Sh080205/AirGuard/firmware/README.md

# firmware — คน B

ESP-IDF **v5.5.x** · target `esp32s3` · ESP32-S3-DevKitC-1 (N16R8)

> 📖 GPIO ทุกตัวอยู่ใน [`../CLAUDE.md`](../CLAUDE.md) §4 — **ห้ามเดา ห้ามลอกจากตัวอย่างในเน็ต**

---

## ลำดับงาน — ทำตามลำดับ อย่าข้าม

| # | งาน | ต้องมีบอร์ดไหม |
|---|---|---|
| 1 | โครง ESP-IDF project + CI ที่ build ผ่าน | ❌ |
| 2 | `components/pms7003/` — parser frame 32 ไบต์ | ❌ |
| 3 | `test_host/` — unit test ของ parser ด้วย frame ปลอม | ❌ |
| 4 | `main/` — FSM + FreeRTOS tasks | ❌ |
| 5 | ไดรเวอร์ I²C + SPI + เขียน CSV | ❌ *(mock ได้)* |
| 6 | ลงบอร์ดจริง ไล่บั๊กร่วมกับคน A | ✅ |

> 🔑 **ข้อ 1–5 ทำได้หมดโดยไม่ต้องมีบอร์ด** — อย่ารอของ

---

## 🔑 กฎออกแบบข้อ 2 ที่สำคัญที่สุด

**แยกส่วน parse ออกจากส่วน UART**

```c
// ✅ ทดสอบได้โดยไม่ต้องมีบอร์ด
esp_err_t pms7003_parse(const uint8_t *buf, size_t len,
                        pms7003_data_t *out, size_t *consumed);

// ส่วนที่คุยกับฮาร์ดแวร์ แยกไฟล์ต่างหาก
esp_err_t pms7003_init(void);
esp_err_t pms7003_read(pms7003_data_t *out, TickType_t timeout);
```

`consumed` บอกจำนวนไบต์ที่ทิ้งได้ โดยเก็บเฟรมที่ยังไม่ครบไว้เรียกครั้งถัดไป
ดูสัญญา API ใน `components/pms7003/include/pms7003.h` และคำสั่ง gcc
สำหรับทดสอบบน PC ใน [`test_host/README.md`](test_host/README.md)

ถ้าเขียนรวมกัน จะทดสอบไม่ได้จนกว่าบอร์ดจะมา — **เสียเวลาไป 3 สัปดาห์ฟรีๆ**

### เคสที่ unit test ต้องครอบคลุม

- frame ถูกต้อง → ค่าออกมาตรง
- checksum ผิด → ต้องคืน error **ไม่ใช่คืนค่าขยะ**
- frame ขาดกลางคัน
- มีขยะนำหน้าก่อน header `0x42 0x4D`
- frame ติดกันสองอันในบัฟเฟอร์เดียว

---

## โครงสร้าง

> 📖 **คำอธิบายเต็ม** (task · ลำดับบูต · queue/mailbox · หนึ่งรอบของ sampler · เส้นทาง CO · ML บนบอร์ด) อยู่ใน [`../docs/11-CODE-MAP.md`](../docs/11-CODE-MAP.md)
> ตรงกับ `main` @ `7e926b4` · ไฟล์ที่ติด **[fw67]** มีเฉพาะใน branch `fw/fw67-integrate` (ยังไม่ merge)

```
firmware/
├── CMakeLists.txt
├── sdkconfig.defaults          ← Flash 16MB · PSRAM Octal
├── partitions.csv              ← factory 4 MB (FW-5a)
├── main/                       task ของโปรเจกต์ + การเดินสาย
│   ├── main.c                  ลำดับบูต: CO ก่อน → NVS → Wi-Fi/SNTP → console → storage → sampler
│   ├── board_pins.h            เลข GPIO ทุกขา (ตรงกับ CLAUDE.md §4)
│   ├── task_config.h           priority / core / stack พร้อมเหตุผล
│   ├── tasks_sampler.c/.h      prio 10 core 1 · รอบ 1 Hz อ่าน PMS7003/AHT21/ENS160 + ค่า CO → แถว CSV · สถานะ MARK
│   ├── tasks_storage.c/.h      prio 3 · เขียน SD + พิมพ์ AGCSV/AGEV ออก serial (งานช้า แยกจาก sampler ด้วย queue)
│   ├── tasks_io.c/.h           prio 5 · ปุ่ม (ISR → queue → debounce) · LED/buzzer (เจ้าของ GPIO ขาออกแต่ผู้เดียว)
│   ├── tasks_co.c/.h           prio 11 core 1 · ZE07-CO UART2 · เส้นทาง CO แยกจาก ML
│   ├── time_sync.c/.h          Wi-Fi STA + SNTP · TZ +07:00
│   ├── console.c/.h            คำสั่ง settime
│   ├── secrets.h.example       ชื่อ/รหัส Wi-Fi → ก๊อปเป็น secrets.h (ไม่ขึ้น git)
│   ├── ml_mailbox.c/.h         [fw67] ผล Mahalanobis: sampler → io
│   └── io_compose.h            [fw67] รวม output ของ CO + FSM (CO ชนะเสมอ)
├── components/                 ส่วน *_parse.c เป็น pure C → host test ได้
│   ├── pms7003/                parse เฟรม 32 ไบต์ + UART1
│   ├── aht21/                  parse + CRC8 + I²C 0x38
│   ├── ens160/                 parse status/validity + I²C 0x53 + MISR
│   ├── ze07/                   ze07_parse · co_safety (เกณฑ์ ppm) · co_alert (ไฟ/เสียง CO)
│   ├── storage/                csv_row.c — รูปแบบแถวตามสัญญา CLAUDE.md §7
│   ├── logutil/                settime parser · ปัดวินาที · ความสดของเฟรม · สถิติ jitter
│   ├── mahal/                  [fw67] Mahalanobis D² + model/ag_mahal_pm_th.h (สร้างจาก ml.baseline ห้ามแก้มือ)
│   └── fsm/                    [fw67] NORMAL / WATCH / ALARM / SYS FAULT
├── test_host/                  unit test ด้วย gcc บน PC — run_tests.ps1
└── tools/                      serial_logger.py · heater_compare.py · ze07_sim.py (+ test_*.py)
```

> แผนเดิมตอนเริ่มโปรเจกต์ (`fsm.c` · `tasks_sensor.c` · `tasks_logic.c` · `model/*.tflite` · `ze07co/` · `test/` Unity) **ไม่ได้ใช้** — โมเดลบนบอร์ดเป็น header ของ Mahalanobis ไม่ใช่ `.tflite`

---

## 🔴 กฎเขียนโค้ด

**เช็ค `esp_err_t` ทุกจุด** — โค้ดที่ไม่เช็ค return คือโค้ดผิด

**ใน ISR** ห้าม `printf`/`ESP_LOG` · ห้าม delay · ห้าม malloc · ห้าม float
ISR ต้องสั้น ส่งงานต่อให้ task ผ่าน queue · พิจารณา `IRAM_ATTR`

**ตัวแปรที่ ISR กับ task ใช้ร่วมกัน** `volatile` อย่างเดียวไม่พอ
ต้องใช้ critical section / atomic / queue **และคอมเมนต์ว่าทำไมเลือกอันนั้น**

**ปุ่มต้องเปิด internal pull-up** ไม่มี pull-up ภายนอกบนบอร์ด — ดู CLAUDE.md §4

**stack size ห้ามตั้งมั่ว** คำนวณคร่าวๆ แล้ววัดด้วย `uxTaskGetStackHighWaterMark()`

---

## 🔴 เส้นทาง CO ต้องแยกจาก ML (FW-5b)

> **อุปกรณ์นี้เป็นเครื่องเฝ้าระวังสภาพแวดล้อมเพื่อการวิจัย ไม่ใช่เครื่องมือแพทย์
> และไม่ใช่เครื่องเตือนภัยคาร์บอนมอนอกไซด์
> ห้ามใช้แทน CO alarm ที่ได้มาตรฐาน UL 2034 หรือ EN 50291**
> (CLAUDE.md §8 · Winsen ZE07-CO manual V1.7 p.6 Caution 6: ห้ามใช้ในระบบที่เกี่ยวกับความปลอดภัยของมนุษย์)

เส้นทาง CO **บันทึกและติดตามระดับ CO เพื่อการวิจัย** ด้วยเกณฑ์ ppm ตายตัว ไม่ผ่านโมเดล
ไม่รอ persistence และไม่ใช้เวลาจริง/SD/Wi-Fi/โมเดล — ทำงานได้แม้ส่วนเหล่านั้นพัง (CLAUDE.md §2)

- **ZE07-CO:** UART2 **RX อย่างเดียว** (GPIO5 · 9600 8N1 · โหมด initiative upload ที่เป็นค่าเริ่มต้น ·
  manual V1.7 p.4) · ไม่ตั้ง TX และไม่แตะ GPIO6 เพราะขา RXD ของโมดูลรับ 0–3.0 V →
  **ไม่ต่อสาย J2.4** (เจ้าของตัดสิน 18 ต.ค.) · GPIO5 เปิด **internal pull-down** ให้ขานิ่งที่ LOW
  ตอนถอดโมดูล (เจ้าของตัดสิน 21 ต.ค. · pull-up 3.3 V จะดันขา TXD 3.0 V ของโมดูล) · parser `components/ze07/ze07_parse.c`
- **task `co`** (`main/tasks_co.c` · prio 11 สูงสุดในของเรา · core 1) อ่าน UART → parse →
  ตัดสินด้วย `components/ze07/co_safety.c` → ส่ง snapshot `co_status_t` ผ่าน mailbox
  (queue ยาว 1 · `xQueueOverwrite`/`xQueuePeek`)
- **ผู้อ่าน:** io task แสดงผลด้วย `co_alert.c` (ทับ MODE/ACK/สถานะ logger) · sampler ใส่ `co_ppm`
  (ค่าที่อายุ ≤ 2.5 s · ว่างช่วงอุ่นเครื่องและ FAULT) · FW-6 อ่านกล่องเดียวกันได้ภายหลัง
- **เกณฑ์ (เจ้าของอนุมัติ 18 ต.ค. · WHO จาก `docs/03` §2):** ค่าทันที ≥ 90 ppm หรือค่าเฉลี่ย 1 ชม. ≥ 30 ppm
  → ALARM ทันที · ค่าเฉลี่ย 8 ชม. ≥ 9 ppm → ธงใน log เท่านั้น · ออกจาก ALARM เมื่อทุกเงื่อนไขต่ำกว่าเกณฑ์ −10 %
  ต่อเนื่อง 60 s (นโยบายเฟิร์มแวร์) · ค่าเทียบกับ "ค่าที่เซนเซอร์รายงาน" ซึ่งไม่ได้สอบเทียบ
- **แสดงผล:** ALARM = LED_R 5 Hz + buzzer · FAULT (ไม่มีเฟรมดี > 6 s · UART2 พัง · snapshot ค้าง > 6 s)
  = LED_R กะพริบคู่ทุก 2 s + เสียงสั้นทุก 60 s · **ALARM ทับ FAULT** · ACK = ปิดเสียง ALARM 5 นาที
  (ไม่ล้าง ALARM) / ปิดเสียง FAULT จนกว่าจะหาย · อุ่นเครื่อง 5 นาทีหลังบูต (manual p.6 Caution 5)
- **log:** `co: frame: FF 04 03 ...` 5 เฟรมแรก (ยืนยันรูปแบบกับโมดูลจริง) · `CO ALARM` / `CO FAULT`
  ทุกครั้งที่เปลี่ยน · `io: CO ALARM shown N us after its frame` (latency) · สรุปทุก 60 s +
  stack HWM · GPIO7 = ขาดีบัก latency
- **ไม่มี ZE07 ต่ออยู่:** เครื่องจะ FAULT (ตั้งใจ) · ถ้าต้องการปิดเส้นทาง CO ทั้งหมด ใช้โฟลเดอร์ build แยก
  `idf.py -B build/co_off -DZE07_ENABLE=0 build` (สั่งใน `build/` ปกติ CMake จะหยุดให้ แบบเดียวกับ `ENS160_ENABLE`)
- **ห้ามทดสอบด้วยการสร้าง CO จริง** (`docs/03` §4) · ตรรกะทดสอบด้วยลำดับค่าจำลองใน
  `test_host/test_co_safety.c` · บนบอร์ดใช้ `tools/ze07_sim.py` ส่งเฟรมจำลองจาก USB-UART **3.3 V**
  เข้า TP8 (ถอด J2 ออกก่อน · ปิดไฟก่อนต่อสาย) เช่น
  `python tools\ze07_sim.py --port COM9 --script "0:20,95:20,80:70,off:10"` ·
  ทดสอบ: `python -m unittest discover -s tools -p "test_*.py"`

---

## LED แยกสถานะด้วยจังหวะ ไม่ใช่สี

LED1 ที่ประกอบมาเป็นเขียวอมเหลือง สีใกล้ LED2 เกินไป

```
NORMAL  →  ติดค้าง
WATCH   →  กะพริบ 1 ครั้ง/วินาที
ALARM   →  กะพริบ 5 ครั้ง/วินาที + buzzer
```

---

## FW-4 logger — ก่อน build ครั้งแรก

1. **Wi-Fi (hotspot มือถือ)**: `copy main\secrets.h.example main\secrets.h` แล้วแก้ SSID/รหัส
   — `secrets.h` ถูก ignore (`secrets.*`) **ห้าม commit** · ไม่มีไฟล์นี้ก็ build ได้
   แต่ไม่มี Wi-Fi/SNTP ต้องตั้งเวลาเอง (log ตอน build: `main/secrets.h not found`)
2. **ลบ `firmware/sdkconfig` เดิม** (ถ้ามี) เพื่อให้ `CONFIG_FATFS_LFN_HEAP` และ partition
   table จาก `sdkconfig.defaults` มีผล — ไม่ลบ build จะหยุดที่ CMake (partition) หรือ
   `#error` ใน `tasks_storage.c` (LFN) · ดูหัวข้อ "partition table" ด้านล่าง
3. ไม่มีเวลาจริง = ไม่เขียน CSV · ตั้งเวลาเองผ่านพอร์ต `UART` ของ DevKit:
   `settime 2026-10-06T09:00:00+07:00` (Enter)

LED เขียวระหว่าง NORMAL: ติดค้าง = กำลังบันทึก · กะพริบสั้น 1 ครั้ง/2 วิ = รอเวลา ·
ดับสั้น 1 ครั้ง/2 วิ = กำลังบันทึกเหตุการณ์ (`marked`) — เหตุผลใน `main/tasks_io.h`
ลำดับ priority / stack / ขนาด queue / N ของ fsync อยู่ที่ `main/task_config.h`,
`main/tasks_storage.h`, `main/tasks_storage.c`

## บันทึก CSV ผ่านสาย USB ลงคอม (serial CSV mirror · เพิ่ม 14 ต.ค.)

เพิ่มเพราะช่องการ์ด microSD ใช้ไม่ได้ (`docs/bringup/2026-10-14.md` P5) — ใช้แทนหรือใช้คู่กับ SD ก็ได้

- storage task พิมพ์**ทุกแถวที่ออกจากคิว**เป็น `AGCSV,<แถว CSV>` และทุกเหตุการณ์ MARK เป็น `AGEV,<แถว EV>`
  รูปแบบแถวมาจาก `csv_format_row` ตัวเดียวกับที่เขียนลง SD ⇒ ตรงสัญญา CLAUDE.md §7 ทุกตัวอักษร
- **ไม่เคย mount SD ตั้งแต่บูต** → ดึงแถวออกจากคิวไปพิมพ์ทันที (คอมได้ข้อมูลช้ากว่าเวลาจริงไม่เกิน ~0.5 s)
- **เคย mount แล้วการ์ดหลุด** → คิวยังเป็นบัฟเฟอร์ให้ SD ตาม FW-4 §7 · ดึงไปพิมพ์เฉพาะตอนคิวเกือบเต็ม (≥ 60/64)
  ⇒ sampler ไม่ต้องทิ้งแถว · แถวที่ไปทาง serial อย่างเดียวนับใน `serial only`
- พิมพ์ใน storage task (งานช้า) ไม่ใช่ใน sampler — ถ้า console ค้าง คิวรับไว้ ไม่กระทบคาบ 1 Hz
- log ทุก 60 s: `60s: serial mirror rows=… (serial only …) AGML=… errors=… | print avg/max us`
- ปิดได้ด้วย `-DSTORAGE_SERIAL_MIRROR=0` (หรือแก้ define ใน `main/tasks_storage.c`)
- **FW-7:** ถัดจาก `AGCSV,` ทุกบรรทัดมี `AGML,<timestamp_iso>,<d2>,<status>,<streak>` (คะแนน Mahalanobis
  ของแถวเดียวกัน · `d2` ทศนิยม 4 ตำแหน่ง ว่างเมื่อ missing/model_fault · status = `missing` `below`
  `above` `persistent` `model_fault`) — **ไม่ใช่ส่วนของสัญญา CSV §7** · `serial_logger.py` ไม่เขียนลง CSV
  เก็บไว้ใน `serial_*.log` เท่านั้น (และพิมพ์ขึ้นจอถ้าไม่ใส่ `--quiet`) · ปิดเฉพาะบรรทัดนี้ด้วย `#define STORAGE_SERIAL_ML 0` ใน `main/tasks_storage.c`
  · sampler log สรุปทุก 60 s เป็นบรรทัด `ml on model=… | since boot cycles … | last 60s D2 max … compute avg/max us`
  · ตอนบูตมีบรรทัด `mahal self-test PASS/FAIL` (golden vectors ของ header บน ESP32-S3)

**ฝั่งคอม** — ปิด `idf.py monitor` ก่อน (COM ใช้ได้ทีละโปรแกรม) แล้วรันจากหน้าต่าง ESP-IDF CMD:

```bat
cd /d <repo>\firmware
python tools\serial_logger.py --port COM7
```

- เขียน `data/raw/usb/AG_YYYYMMDD_HHMMSS_usb.csv` (header ตาม §7 · ไฟล์ใหม่ทุกวัน) ·
  `EV_…_usb.csv` · `serial_….log` (ทุกบรรทัดดิบ ไว้ไล่ปัญหา)
- ตรวจทุกแถว (10 คอลัมน์ · `+07:00` · label · ชนิดตัวเลข) แถวเสียไม่เขียน · นับ duplicate/gap แจ้งทุก 60 s
- เปิดพอร์ตโดยไม่แตะ DTR/RTS (ไม่ทำให้บอร์ดรีเซ็ต) · บอร์ดรีเซ็ต/สายหลุด → ต่อใหม่เอง
- 🔴 **อย่าใช้ไฟล์ `_usb` คู่กับ AG_*.csv จาก SD ช่วงเวลาเดียวกัน** — `ml.load.load_raw` จะ error เพราะ timestamp ซ้ำ
- ทดสอบ: `python -m unittest discover -s tools -p "test_*.py"`

## ENS160 → `tvoc_ppb` / `eco2_ppm` (FW-5a)

แหล่งตัวเลขทุกตัว: ScioSense ENS160 Datasheet **Version 1.3** (SC-001224-DS-9, 2023-03-29) ·
อ้างหัวข้อไว้ในคอมเมนต์ `components/ens160/include/ens160_parse.h`

- `components/ens160/ens160_parse.c` pure C (host test `test_ens160_parse.c`) ·
  `ens160.c` คุย I²C · อ่านใน **sampler** เอง (burst 6 ไบต์ + MISR ทุกรอบ, เขียน T/RH ชดเชยทุก 2 s
  ไม่มีการรอ) — เวลาจริงต่อรอบอยู่ใน log `ens160 i2c per cycle`
- เปิดใช้: อ่าน PART_ID (0x0160) → OPMODE IDLE → STANDARD (อ่านกลับยืนยัน) · ล้มเหลว → ลองใหม่ทุก 10 s
- STATAS = 0 แต่ OPMODE ยังเป็น 0x02 (P7: เพิ่งเข้าโหมด) → รอ · ติดกันครบ 60 รอบ (≈ 60 s ·
  นโยบายเฟิร์มแวร์ ไม่ใช่ค่าจาก datasheet · บนบอร์ด STATAS ขึ้นใน 1–2 s) → restart · log `wait_cap=`
- คอลัมน์ว่างเมื่อ: warm-up (≤ 3 นาทีหลังจ่ายไฟหรือหลัง restart — DS §10.2 "after idle periods or
  power-off") · **initial start-up (ชั่วโมงแรกของอายุเซนเซอร์;
  ถ้าดับไฟก่อนครบ 24 ชม. ต่อเนื่องจะกลับมาเป็นชั่วโมงแรกใหม่ — DS §10.1, เชิงอรรถ 24)** · invalid ·
  STATER · ค่านอกช่วง (TVOC 0–65000 ppb, eCO2 400–65000 ppm) · ค่าที่เห็น NEWDAT ล่าสุดเก่ากว่า 2.5 s ·
  ENS160 ไม่ตอบ (แถวยังเขียนต่อ PM/T/RH ไม่หาย)
- log ทุก 60 s: `rows VOC new/reused/empty` · จำนวนครั้งแต่ละสถานะ · `newdat gap` (คาบข้อมูลจริง —
  datasheet ไม่ระบุ) · `comp writes` · `sensor uses T=… RH=…` (ค่าที่ ENS160 ใช้ชดเชยจริง) ·
  `sampler work per cycle` · และบรรทัด `ENS160 status warm-up -> normal at uptime … s` ทุกครั้งที่สถานะเปลี่ยน
- **ปิด ENS160 (ทดสอบผลฮีตเตอร์):** ใช้โฟลเดอร์ build แยกเท่านั้น →
  `idf.py -B build/heater_off -DENS160_ENABLE=0 build` แล้ว `idf.py -B build/heater_off -p COM7 flash`
  → เซนเซอร์อยู่ DEEP SLEEP คอลัมน์ว่าง · ถ้าสั่ง `-DENS160_ENABLE=0` ใน `build/` ปกติ CMake จะหยุดให้
  ⇒ `idf.py build` / `flash` ธรรมดาได้ build แบบเปิด ENS160 เสมอ (กันเก็บข้อมูลเทรนด้วย build ปิดโดยไม่รู้ตัว)
  · กลับมาใช้ build ปกติ: `idf.py -p COM7 flash` (ไม่ต้องใส่ `-D`)
- เทียบ `temp_c/humidity_pct` ช่วงปิด/เปิด ENS160: `python tools\heater_compare.py --help`
  (OFF/ON/OFF + เทอร์โมมิเตอร์อ้างอิงถ้ามี · ทดสอบ: `python -m unittest discover -s tools -p "test_*.py"`)
- `-DENS160_MISR_CHECK=0` ใช้เฉพาะถ้าบอร์ดแสดง `misr=` เท่ากับจำนวนครั้งที่อ่านทุกครั้ง
  (แปลว่าอัลกอริทึม MISR ที่ตีความจาก datasheet ผิด ไม่ใช่บัสเสีย) — ต้องใส่ผ่าน
  `target_compile_definitions` ของ component ens160 (ยังไม่ได้ต่อสายผ่าน CMake)

## partition table (FW-5a · `partitions.csv`)

ค่าเริ่มต้นของ ESP-IDF (`partitions_singleapp.csv`) ให้ factory app แค่ **1 MB** ·
build 14 ต.ค. ใช้ไป 0xe3990 B เหลือ ~11% → ใส่ FW-5/FW-6/FW-7 + โมเดลไม่พอ จึงทำตารางเอง

| Name | Type | SubType | Offset | Size | หมายเหตุ |
|---|---|---|---|---|---|
| `nvs` | data | nvs | 0x9000 | 24 KB | offset/ขนาดเท่าเดิม ⇒ ข้อมูล NVS (Wi-Fi) บนบอร์ดอยู่ที่เดิม |
| `phy_init` | data | phy | 0xf000 | 4 KB | เท่าเดิม (`CONFIG_ESP_PHY_INIT_DATA_IN_PARTITION` ปิดอยู่ จึงยังไม่ถูกใช้) |
| `factory` | app | factory | 0x10000 | **4 MB** | offset ของ app ต้องลงตัว 64 KB (0x10000) · เท่าเดิม |
| *(ว่าง)* | | | 0x410000 | ~11.9 MB | ยังไม่จอง |

**ทำไม 4 MB**
- ตอนนี้ (มี Wi-Fi) 0xe39b0 B = 932,272 B ≈ 0.89 MiB → 4 MB คือ ~4.5 เท่า เหลือ ~3.1 MB
- ส่วนที่จะเพิ่ม: ไดรเวอร์ ENS160/ZE07-CO + เส้นทาง CO (FW-5) · FSM (FW-6) · Mahalanobis
  (FW-7 — เมทริกซ์เล็ก) · esp-tflite-micro + โมเดล int8 ที่ฝังเป็น `const` ใน flash
  ขนาดของ tflite-micro ขึ้นกับจำนวน op ที่ลงทะเบียนใน resolver — **ทั้งหมดเป็นค่าคาดหมาย
  ต้องยืนยันด้วยการวัด** (ดูบรรทัด `binary size … free` ทุกครั้งที่ build)
- ถ้าส่วนที่เพิ่มรวมกันใช้ถึง 1–2 MB ก็ยังเหลือที่ · ถ้าเกินจริง ESP-IDF หยุด build เอง
  (`check_sizes.py`) ไม่มีทางได้ image ที่ใหญ่เกิน partition
- ไม่ขยายเต็ม 16 MB เพราะไม่มีประโยชน์ (`idf.py flash` เขียนเท่าขนาด binary ไม่ใช่ขนาด
  partition) และเว้นที่ว่างไว้เผื่อ data partition ภายหลัง โดยไม่ต้องย้าย nvs/factory
- ไม่มี OTA — อัปเดตผ่านสาย USB เท่านั้น

**🔴 sdkconfig เดิมไม่รับค่าใหม่** — `sdkconfig.defaults` ใช้ตอนสร้าง `sdkconfig` ใหม่เท่านั้น
ถ้ามี `firmware/sdkconfig` จากก่อน FW-5a ค่า `CONFIG_PARTITION_TABLE_SINGLE_APP=y` จะยังอยู่
และ `main/CMakeLists.txt` จะหยุดตอน configure ด้วยข้อความ
`sdkconfig does not use firmware/partitions.csv` — แก้โดย:

```bat
cd /d <repo>\firmware
del sdkconfig
idf.py build
```

(ไม่ต้อง `idf.py set-target` ซ้ำ ถ้า `sdkconfig.defaults` มี `CONFIG_IDF_TARGET="esp32s3"` อยู่แล้ว)

**🔴 เปลี่ยน partition แล้วต้อง flash เต็มหนึ่งครั้ง** — `idf.py -p <PORT> flash`
(เขียน bootloader + partition table + app) **ห้ามใช้ `app-flash`** เพราะจะเขียนแค่ app
แล้วบอร์ดยังใช้ตารางเดิมที่ factory 1 MB → พอ app เกิน 1 MB จะบูตไม่ขึ้น ·
ไม่ต้อง `erase-flash` เพราะ nvs อยู่ที่เดิม

## บิลด์

```bash
idf.py set-target esp32s3
idf.py menuconfig      # ครั้งแรก: Flash 16MB · PSRAM Octal 8MB
idf.py build
idf.py -p <PORT> flash monitor
```

> ⚠️ ตั้ง flash/PSRAM ผิด = บูตไม่ขึ้น หรือใช้ PSRAM ไม่ได้ แล้วโมเดลจะโหลดไม่ลง
