Sh080205/AirGuard/hardware/enclosure_v2/README.md

# กล่อง AirGuard-S3 รุ่น 2 (`hardware/enclosure_v2/`)

> ออกแบบใหม่ 17 ต.ค. 2569 · OpenSCAD 2021.01 · แทน `hardware/frame/airguard_enclosure.scad` (รุ่นเดิมยังอยู่ ไม่ได้ลบ)
> มิติอุปกรณ์ทั้งหมดมาจาก `docs/bringup/2026-10-11.md` (วัดเวอร์เนียร์ 11 ต.ค.) และ DXF ของ carrier
> ค่าที่ติดป้าย `[ออกแบบ]` ในไฟล์ SCAD เป็นค่าที่เลือกเอง ไม่ใช่ค่าวัด

## ทำไมต้องออกแบบใหม่

แบบเดิมพึ่งของที่ยังไม่มีหรือยังไม่ได้ทดสอบหลายอย่าง: เคเบิลไทร์ (I1/I2 ยังไม่ได้วัด และกว้างกว่าช่องข้างกระบอก ZE07), คานกดปุ่มบนฝา (ต้องจูนความแข็ง), ท่อแสง LED (ยังไม่ได้ทดสอบ), ฟองน้ำกั้นช่อง PMS และช่องลมแนวนอนยาวที่ต้องพิมพ์ข้ามช่องว่างยาว รุ่นนี้ตัดทั้งหมดออก

## ยืมรูปแบบมาจาก

| แบบอ้างอิง | สิ่งที่ยืมมา |
|---|---|
| [Printables 52282 — Indoor air quality monitor (snap-fit)](https://www.printables.com/model/52282-indoor-air-quality-monitor-snap-fit) | ห้องเซนเซอร์ T/RH แยกที่มุม มีช่องลมออกนอกกล่อง · ไม่ใช้ support |
| [Printables 1079858 — Sensorbox v2](https://www.printables.com/model/1079858-3d-printer-emission-sensor-array-sensorbox-v2) | กั้นความร้อนรอบเซนเซอร์อุณหภูมิ · ไม่ใช้ support |
| [Adafruit — Air Quality Sensor Silo House](https://learn.adafruit.com/air-quality-sensor-silo-house) | PMS5003 กดลงหลุมพอดีตัว · ชิ้นย่อยเปลี่ยนตามโมดูล → แนวคิดถาด SD |
| [AirGradient ONE (รีวิว CNX)](https://www.cnx-software.com/2023/11/29/airgradient-one-kit-review-an-open-source-indoor-air-quality-monitor/) | ฝาบน-ล่างยึดสกรู 4 ตัว |
| [Hubs — CAD modeling for enclosures](https://www.hubs.com/blog/cad-modeling-1-enclosures) | ผนัง 2.4 = 6 เท่าของหัว 0.4 · ขอบฝาเว้นช่อง · ปุ่มเป็นชิ้นแยกเล็กกว่ารู |

## สิ่งที่เปลี่ยน

| เรื่อง | แบบเดิม | รุ่น 2 |
|---|---|---|
| ยึดโมดูล | เคเบิลไทร์ | หลุม/เสามุม + ซี่กดห้อยจากฝา · ZE07 มีปากล็อก 0.4 · ENS ใช้ร่องนำ |
| ENS160+AHT21 | เสาตั้ง ช่องให้แถวพินลอด | **ห้องแยกที่มุมซ้ายหลัง** หน้าชิปหันผนังที่มีช่องลม ขาพินลอดใต้แผ่นที่ห้อยจากฝา · กั้นจาก PMS ด้วยผนังสองชั้น |
| ช่องลม PMS | ช่องบนผนัง + ฟองน้ำ | หน้าช่องลมแนบผนัง 0.3 mm ตาม manual ผนังระหว่างสองช่อง = แผ่นกั้น (ฟองน้ำเป็นตัวเลือก) |
| ปุ่ม | คานรูปตัว U บนฝา | แท่งกดแยกชิ้น 3 ชิ้นในปลอก |
| LED | รู Ø3 + ท่อแสง (ยังไม่ทดสอบ) | บล็อกบังแสง แต่ละดวงมีรูนำแสงของตัวเอง · หน้าฝาเป็นรูผาย (`led_window="hole"`) หรือผิวบาง 0.6 (`"skin"`) |
| ผนังกั้น | ช่องร้อยสายต้องร้อย | ช่องเปิดจากด้านบน วางสายลงได้ ฝามีแผ่นห้อยปิดครึ่งบน |
| เสาสกรูฝา | มุมกล่อง (มุมขวาทับบอร์ด) | มุมขวาอยู่นอกขอบบอร์ด → ไขควงเข้าถึงสกรูบอร์ด · หน้าซ้ายอยู่ระหว่าง PMS กับคอลัมน์ SD (ไม่ค้ำเหนือ PMS) |
| ช่องลมผนัง | แนวนอน (bridge ยาว) | แนวตั้ง กว้าง 2 mm (bridge 2 mm) |
| microSD | หลุมในกล่อง | เลือกได้: `sd_mode="sled"` ถาดแยก หรือ `"integrated"` หลุมในกล่อง |
| PMS ↔ ห้อง T/RH | ไม่มีการกั้นความร้อน | **ผนังสองชั้น + ช่องอากาศ 3 mm** (PMS7003 manual V2.5: Active Current ≤ 100 mA ที่ 5 V → สูงสุด 0.5 W) |
| ช่องเสียบสาย | รอวัดหัวปลั๊ก (A8 · A10b) | **เจาะเผื่อกว้าง** (18 ต.ค.): USB 32 × 13 ช่องเดียว · J8 Ø10 · ช่องการ์ด SD ยังแคบในแนวตั้งแต่มีปากกรวยช่วยเล็ง |
| ขนาดนอก | 174.2 × 107.1 × 43.4 | **169.4 × 84.9 × 36.8 mm** |

## ไฟล์

| ไฟล์ | คืออะไร |
|---|---|
| `airguard_box.scad` | แบบ parametric ทั้งหมด |
| `fit_coupon.stl` | รูสกรู M3 7 ขนาด · รูทะลุ 5 ขนาด · ปลอกแท่งกด 3 ขนาด (+0.15/+0.25/+0.35) + แท่ง Ø6 ทดลอง |
| `fit_lid.stl` | มุมกล่อง + มุมฝาจริง → ทดสอบ `lid_clear` และสกรูฝา |
| `fit_pms.stl` | ผนังซ้ายช่วงช่องลม + เสามุม → วาง PMS จริงแล้วส่องว่าปากช่อง IN/OUT ตรงรู |
| `enclosure_v2_viewer.html` | ดูแบบ 3 มิติ (หมุน/ยกฝา/สลับแบบ SD) + ตารางสั่งพิมพ์ + ฟอร์มค่าที่ยังขาด |
| `preview_open.png` · `preview_exploded.png` | ภาพจาก OpenSCAD |

ชิ้นจริง (`body` `lid` `pegs` `sled`) ยังไม่ export เพราะ assert ล็อกจนกว่าธงครบ — ถูกต้องตามเจตนา

## สั่ง export

```bash
openscad -D 'part="fit_coupon"' -o fit_coupon.stl airguard_box.scad   # พิมพ์ได้เลย
openscad -D 'part="fit_lid"'    -o fit_lid.stl    airguard_box.scad   # พิมพ์ได้เลย
openscad -D 'part="fit_pms"'    -o fit_pms.stl    airguard_box.scad   # พิมพ์ได้เลย
openscad -D 'part="body"' -o body.stl airguard_box.scad               # หลังธงครบ
openscad -D 'part="lid"'  -o lid.stl  airguard_box.scad               # (คว่ำไว้แล้ว)
openscad -D 'part="pegs"' -o pegs.stl airguard_box.scad
openscad -D 'part="sled"' -o sled.stl airguard_box.scad               # sd_mode="sled" เท่านั้น
# แบบหลุม SD ในกล่อง: เติม -D 'sd_mode="integrated"'
```

## ธงที่ยังเป็น false และสิ่งที่ปลดล็อก

| ธง | ต้องมีอะไร |
|---|---|
| `ok_print_fit` | พิมพ์ `fit_coupon` + `fit_lid` → เลือก `m3_tap_d` `peg_clear` `lid_clear` |
| `ok_printer` | H1 รุ่นเครื่อง · H5 พื้นที่พิมพ์ ≥ 170 × 85 × 35 |
| `ok_service` | H2 หัว/ชั้น · H3 วัสดุ (ห้ามเส้นผสมโลหะ/คาร์บอน) · H4 ค่าเผื่อ |
| `ok_pms_ports` | ผู้ใช้แจ้ง 17 ต.ค. inlet = ช่องกว้าง → ยืนยันกับรูปใน PMS7003 manual V2.5 |
| `ok_pms_conn` | หัวสาย PMS อยู่หน้าไหน (แบบสมมติว่าอยู่หน้าตรงข้ามช่องลมหรือด้านบน) |
| `ok_sd_dims` | โมดูล microSD ตัวใหม่ (มา ~20 ต.ค.) E1a–E2c + ทิศขา header |
| `ok_ze07_mount` | ความสูงตอขา/รอยบัดกรีใต้ PCB ZE07 (แท่นรองตอนนี้ 3.0) |
| `ok_bme_pins` | ความสูงแถวพินเหนือขอบล่าง PCB (สมมติ 1.5) · ตำแหน่งชิป |
| `ok_cable_h` | A12 วัดซ้ำเมื่อเสียบสายครบ (ต้องต่ำกว่าผิวบน carrier +24.2) |
| `ok_ant_keepout` | K6 จาก ESP32-S3-WROOM-1 datasheet (สกรูฝาใกล้สุด 40.5 mm) |
| `ok_bme_sep` | K7 ยังไม่มีแหล่งอ้างอิง |

## ตรวจแล้ว (17 ต.ค. ในคอนเทนเนอร์ OpenSCAD 2021.01)

- ทุกชิ้น render ได้และเป็นเมช**ปิดสนิท** (watertight) — body/lid/sled เป็นชิ้นเดียว · pegs 3 ชิ้น · fit_lid 2 ชิ้น (มุมกล่อง + มุมฝา)
- **ไม่ชนกัน** ทดสอบด้วย `intersection()` 3 มิติ: กล่อง↔ฝา · กล่อง↔โมดูลทุกตัว · ฝา↔โมดูล · ถาด↔กล่อง/ฝา · แท่งกด↔กล่อง/ฝา ทั้งสองแบบ SD — เหลือแค่ผิวสัมผัส (ปริมาตร 0)
- **ไม่ต้องใช้ support**: ผิวที่หันลงเหนือฐานพิมพ์มีแค่สะพานข้ามช่อง (ช่อง USB ~29 mm · ช่องถาด SD 19 mm · ช่องลม PMS ~12 mm · ช่องลม 2 mm) และเพดานตัวอักษรแกะ
- ใต้ฝาเหลือที่: เหนือ DevKit 8.7 · เหนือ JST (ยังไม่เสียบสาย) 14.6 · เหนือ ENS 9.6 · เหนือ ZE07 10.6 mm
- บล็อกบังแสง LED และปลอกแท่งกด: เช็คกับ DXF แล้วไม่มีชิ้นสูงในกรอบ

## ยังไม่ได้ทดสอบ (ต้องพิมพ์จริง)

- ความแน่นของปากล็อก ZE07 และร่องนำ ENS · การไหลของลมจริงในห้อง T/RH
- ผลของห้อง T/RH ต่อ `temp_c`/`humidity_pct` — `[ต้องวัดจริง]` เทียบกับเทอร์โมมิเตอร์อ้างอิง ก่อนเริ่มเก็บข้อมูลเทรน
- ปริมาณเส้น/เวลาพิมพ์: ปริมาตรเนื้อ body ~79 cm³ + lid ~40 cm³ (ถ้าพิมพ์ทึบ 100%) — **ค่าคาดหมาย** เวลาจริงขึ้นกับ slicer ของคนพิมพ์
