Sh080205/AirGuard/docs/02-HARDWARE_REFERENCE.md

# AirGuard-S3 — ตารางอ้างอิง

> **ไฟล์นี้ไม่ต้องอ่านจากต้นจนจบ** เปิดหาเฉพาะตอนต้องใช้
> ยืนยันกับ netlist 1 ก.ย. 2569 · 37 เน็ต · 55 ชิ้นส่วน
> **✅ ตรวจกับ datasheet ทางการแล้ว 1 ก.ย. 2569** — ดูหัวข้อ 8

### ✅ สิ่งที่ยืนยันแล้วว่าถูก

| | |
|---|---|
| **ตารางขา 1–44** | ตรงกับ Header Block ของ Espressif **ทุกบรรทัด** |
| **GPIO35/36/37 ห้ามใช้** | ✅ N16R8 มี Octal PSRAM — Espressif ระบุเองว่า "not available for external use" |
| **หลบ GPIO38 และ GPIO48 ทั้งคู่** | ✅ **ตัดสินใจถูกมาก** — RGB LED อยู่ GPIO48 ในบอร์ด v1.0 แต่ย้ายไป GPIO38 ใน v1.1<br>เราหลบทั้งสอง → **ใช้ได้กับบอร์ดทั้งสองรุ่นโดยไม่ต้องรู้ว่าได้รุ่นไหนมา** |
| **pull-up ภายใน 45 kΩ** | ✅ ตรงกับ ESP32-S3 datasheet |
| **ZE07-CO ใช้ 5 V** | ✅ Winsen ระบุ Vin = 5–12 V |

### 🔴 3 จุดที่ตรวจแล้วพบว่าผิด

**1. C13 470 µF เกินพิกัดของ LDO บน DevKit → ห้ามใส่**

LDO บน DevKitC-1 คือ **SGM2212-3.3XKC3G** (SOT-223)
datasheet หัวข้อ Recommended Operating Conditions ระบุ:

```
Output Effective Capacitance, COUT ......... 1 µF to 10 µF
```

**470 µF = 47 เท่าของค่าสูงสุดที่ผู้ผลิตรับรอง**
และ datasheet เขียนกำกับไว้ว่า *"Functional operation of the device at any conditions
beyond those indicated in the Recommended Operating Conditions section is not implied."*

➡️ **C13 เป็น THT บัดกรีเอง → แค่ไม่ใส่ ก็จบ** ดูเหตุผลใน `CLAUDE.md` §5

**2. กระแสสูงสุดต่อขา GPIO คือ ~20 mA ไม่ใช่ 40 mA**

ESP32-S3 ตั้ง drive strength ได้ · **ค่าเริ่มต้นคือ `2'd2` ≈ 20 mA** · 40 mA ได้เฉพาะตอนตั้ง `2'd3`
✅ LED เราใช้ 5.9 mA และปุ่มกรณีแย่สุด 15 mA — **ยังผ่านทั้งคู่** แต่ตัวเลขอ้างอิงเดิมผิด

**3. ZE07-CO ไม่ใช่คอนเนคเตอร์ 5 ขาเรียงกัน**

ขาบนตัวโมดูลนับตามคู่มือ Winsen เป็น pin 1–15 → **ต้องแมปเองตอนทำสาย** ดูหัวข้อ 3

| หา | ไปที่ |
|---|---|
| GPIO ไหนทำอะไร *(เขียนเฟิร์มแวร์)* | [1](#1-ตารางขา-u1) |
| ขาไหนห้ามใช้ | [2](#2--ขาที่ห้ามใช้) |
| คอนเนคเตอร์ตัวไหนเรียงขายังไง | [3](#3-pinout-คอนเนคเตอร์) |
| อุปกรณ์ตัวไหนค่าเท่าไร ทำอะไร | [4](#4-อุปกรณ์) |
| ตัวเลขที่คำนวณไว้ *(ใส่ lab report)* | [5](#5-ตัวเลขสำหรับ-lab-report) |
| ชื่อเน็ตทั้งหมด | [6](#6-รายชื่อเน็ต-37-เน็ต) |

---

## 1. ตารางขา U1

**ESP32-S3-DevKitC-1 · ซ็อกเก็ต 2×22 · ต่อจริง 28 จุด**

| ขา | GPIO | เน็ต | ใช้ทำอะไร |
|---|---|---|---|
| 1, 2 | 3V3 | `+3V3` | ไฟเลี้ยงออก |
| 5 | **GPIO5** | `CO_TX` | UART2 RX ← ZE07 ส่งมา |
| 6 | **GPIO6** | `CO_RX` | UART2 TX → ZE07 *(ผ่าน R4)* |
| 9 | **GPIO16** | `PMS_RST` | รีเซ็ต PMS7003 |
| 10 | **GPIO17** | `PMS_RX` | UART1 TX → PMS *(ผ่าน R3)* |
| 11 | **GPIO18** | `PMS_TX` | UART1 RX ← PMS ส่งมา |
| 12 | **GPIO8** | `SDA` | I²C data |
| 15 | **GPIO9** | `SCL` | I²C clock |
| 16 | **GPIO10** | `SD_CS` | SPI chip select |
| 17 | **GPIO11** | `SD_MOSI` | SPI |
| 18 | **GPIO12** | `SD_CLK` | SPI |
| 19 | **GPIO13** | `SD_MISO` | SPI |
| 21 | 5V | `+5V` | ไฟเข้า |
| 22, 23, 24, 44 | GND | `GND` | |
| 27 | **GPIO21** | `PMS_SET` | สั่ง PMS หลับ/ตื่น |
| 28 | **GPIO47** | `BTN_MODE` | 🔴 ต้องเปิด pull-up ภายใน |
| 36 | **GPIO39** | `LED_Y` | ไฟเหลือง WATCH |
| 37 | **GPIO40** | `LED_R` | ไฟแดง ALARM |
| 38 | **GPIO41** | `BUZZ` | ขับ buzzer ผ่าน Q1 |
| 39 | **GPIO42** | `BTN_MARK` | 🔴 ต้องเปิด pull-up ภายใน |
| 40 | **GPIO2** | `LED_G` | ไฟเขียว NORMAL |
| 41 | **GPIO1** | `BTN_ACK` | 🔴 ต้องเปิด pull-up ภายใน |
| 42 | **GPIO44** | `U0RXD` | console *(ผ่าน R15)* |
| 43 | **GPIO43** | `U0TXD` | console *(ผ่าน R14)* |

**ขาว่าง ใช้ต่อยอดได้:** ขา 4 (GPIO4) · 7 (GPIO7) · 8 (GPIO15) · 20 (GPIO14)

### 🔴 ปุ่มไม่มี pull-up ภายนอกบนบอร์ด

```c
gpio_config_t btn = {
    .pin_bit_mask = (1ULL<<42) | (1ULL<<47) | (1ULL<<1),
    .mode         = GPIO_MODE_INPUT,
    .pull_up_en   = GPIO_PULLUP_ENABLE,     // 🔴 ขาดไม่ได้
    .pull_down_en = GPIO_PULLDOWN_DISABLE,
    .intr_type    = GPIO_INTR_NEGEDGE,
};
ESP_ERROR_CHECK(gpio_config(&btn));
```

**ถ้าลืม:** ปุ่มอ่านได้บ้างไม่ได้บ้าง เปลี่ยนตามการเอามือเข้าใกล้บอร์ด — ขาลอยรับสัญญาณรบกวนจากอากาศ

---

## 2. 🔴 ขาที่ห้ามใช้

| ขา U1 | GPIO | เหตุผล | อาการถ้าเผลอใช้ |
|---|---|---|---|
| **32, 33, 34** | 35, 36, 37 | **Octal PSRAM** *(N16R8 มี PSRAM)* | บอร์ดค้าง / PSRAM พัง |
| **13, 14, 30, 31** | 3, 46, 45, 0 | **Strapping pin** | บูตไม่ขึ้น หรือเข้าโหมดแฟลชเอง |
| **29, 35** | 48, 38 | **RGB LED บน DevKit** | ชนกัน ไฟกะพริบเอง |
| 25, 26 | 19, 20 | USB D− / D+ | USB ใช้ไม่ได้ |
| 3 | RST | DevKit มีปุ่มแล้ว | รีเซ็ตเอง |

---

## 3. Pinout คอนเนคเตอร์

| | ขา 1 | 2 | 3 | 4 | 5 | 6 | 7 | 8 |
|---|---|---|---|---|---|---|---|---|
| **J1** PMS7003 *(XH-8P)* | +5V | +5V | GND | GND | RST | RXD | TXD | SET |
| **J2** ZE07-CO *(XH-5P)* | 🔴 **+5V** | GND | TXD | RXD | DAC *(ไม่ต่อ)* | | | |
| **J3 J4 J5** I²C *(XH-4P)* | +3V3 | GND | SDA | SCL | | | | |
| **J6** microSD *(header 6P)* | +3V3 | GND | CS | MOSI | CLK | MISO | | |
| **J7** console *(header 3P)* | TXD | RXD | GND | | | | | |
| **J8** ไฟเข้า *(KF128 2P)* | +5V | GND | | | | | | |

> 🔴 **J2 ใช้ 5 V ไม่ใช่ 3.3 V** — ZE07-CO ไม่มีวงจรกันต่อขั้วกลับ ต่อผิดพังทันที
> ✅ ตอนนี้เป็น JST-XH แล้ว **เสียบกลับด้านไม่ได้เชิงกายภาพ**

### 🔴 การทำสาย ZE07-CO — ขาบนโมดูลไม่ได้เรียง 1-2-3-4-5

คู่มือ Winsen นับขาโมดูลเป็น **pin 1–15** ไม่ใช่แถว 5 ขาติดกัน → **ต้องแมปเอง**

| ขาบน ZE07-CO *(ตามคู่มือ)* | สัญญาณ | ต่อเข้าขา J2 ของเรา |
|---|---|---|
| **pin 15** | Vin 5–12 V | **J2.1** |
| **pin 5** *(หรือ 14)* | GND | **J2.2** |
| **pin 8** | TXD *(0–3.0 V ออก)* | **J2.3** |
| **pin 7** | RXD *(0–3.0 V เข้า)* | **J2.4** |
| pin 10 | DAC 0.4–2 V | J2.5 *(ไม่ต่อก็ได้)* |

> 🔴 **แมปผิด = ต่อ 5 V เข้าขา TXD = โมดูลพังทันที และไม่มีวงจรกันไว้**
> `[ต้องไปเช็คเอง]` เปิด **ZE07-CO User's Manual** หน้า Pin Description
> **ดูรูปประกอบว่าขาที่ 1 อยู่ด้านไหนของโมดูลจริง** ก่อนบัดกรีสาย
>
> ✅ TXD ออกมา 3.0 V → ESP32-S3 อ่านเป็นลอจิกสูงได้สบาย *(เกณฑ์ ≈ 0.75 × 3.3 = 2.48 V)*
> ⚠️ RXD รับ 0–3.0 V แต่ ESP32 ขับออก 3.3 V → เกินอยู่ 0.3 V
> **R4 (100 Ω) จำกัดกระแสผ่านไดโอดป้องกันในตัวโมดูลเหลือ ~3 mA** ✅ ปลอดภัย
> 📌 ชื่อขา J7 มองจากฝั่ง ESP32 → ต่อ USB-serial ต้องไขว้สาย
> 📌 J3 J4 J5 เรียงขาเหมือนกันเป๊ะ **เสียบสลับกันได้โดยไม่พัง**

**Test point**

| TP | เน็ต | | TP | เน็ต |
|---|---|---|---|---|
| TP1, TP4 | `GND` | | TP5 | `+3V3` |
| TP2 | `SDA` | | TP6 | `+5V` |
| TP3 | `SCL` | | TP7 | `PMS_TX` |
| | | | TP8 | `CO_TX` |

---

## 4. อุปกรณ์

### ✅ SMD — โรงงานประกอบมาแล้ว

| Des | ค่า | หน้าที่ | ถ้าไม่มี |
|---|---|---|---|
| R1, R2 | 4.7 kΩ | pull-up I²C | บัส I²C ไม่ทำงานเลย |
| R3 | 470 Ω | อนุกรม ESP TX → PMS | — |
| R4 | 100 Ω | อนุกรม ESP TX → ZE07 | จำกัดกระแสไดโอดป้องกันใน ZE07 |
| R5, R6, R7 | 220 Ω | จำกัดกระแส LED1–3 | LED ไหม้ |
| R8 | 470 Ω | จำกัดกระแส LED4 *(ราง **5 V**)* | LED ไหม้ |
| R9 | 1 kΩ | อนุกรม gate Q1 | — |
| R10 | 100 kΩ | **pull-down gate Q1** | 🔴 **buzzer ดังเองตอนบูต** |
| R11–R13 | 220 Ω | ป้องกัน GPIO ปุ่ม | GPIO พังถ้า fw ตั้งเป็น output |
| R14, R15 | 1 kΩ | ป้องกัน console UART | ขาพังถ้าเสียบ adapter 5 V |
| C2, C4 | 10 µF | decoupling ราง 5V / 3.3V | แรงดันตกตอนโหลดกระชาก |
| C3, C5 | 100 nF | decoupling ความถี่สูง | สัญญาณรบกวน |
| C6–C9 | 100 nF | decoupling J3 J4 J5 J6 | เซนเซอร์อ่านเพี้ยน |
| C10–C12 | 100 nF | debounce ปุ่ม | ปุ่มเด้ง กดครั้งเดียวนับหลายครั้ง |
| Q1 | 2N7002 | ขับ buzzer | GPIO ขับ buzzer ตรงๆ ไม่ไหว |
| D1 | 1N4148W | 🔴 **flyback** | **Q1 พังในไม่กี่รอบ** |
| LED1 | 🟠 KT-0805**YG** | NORMAL *(สีใกล้ LED2 เกินไป)* | → แก้ด้วยจังหวะกะพริบ |
| LED2 | KT-0805Y | WATCH | |
| LED3 | KT-0805R | ALARM | |
| LED4 | KT-0805B | ไฟเข้า | |
| SW1–SW3 | TS-1187A | MARK / MODE / ACK | |

### ⬜ THT — บัดกรีเอง

| Des | ของ | ⚠️ |
|---|---|---|
| U1 | female header 1×22 × 2 | ระยะสองแถว 22.86 mm ✅ ดู `CLAUDE.md` §6 |
| C1 | BOM 470 µF/16 V · **ใส่จริง 220 µF/16 V** — ปัญหาค้าง P1 | 🔴 **มีขั้ว** ขา + ไป `+5V` |
| C13 | 470 µF/16 V | 🔴 มีขั้ว · **ยังไม่ต้องใส่** |
| BZ1 | buzzer active 3.3 V | 🔴 **มีขั้ว** ขา 2 = บวก |
| J1–J8 | คอนเนคเตอร์ | |

### 🔴 ทิศทาง D1 — ผิดไม่ได้

```
        +3V3
         │
    ┌────┴────┐
  BZ1.2    D1.1 = แคโทด (ด้านมีแถบคาด)   ← แถบต้องอยู่ด้านนี้
    │         │
  BZ1.1 ─────┴──── D1.2 = แอโนด          ← BUZZ_DRV
    │
  Q1.3 drain
    │
  Q1.2 source ── GND
```

**ถ้ากลับด้าน:** ตอนสั่ง buzzer ดัง → 3.3 V ลัดผ่าน D1 ลง drain → **Q1 กับ D1 ไหม้**

---

## 5. ตัวเลขสำหรับ lab report

**กระแส LED** — `I = (V − V_f) / R`

| LED | V | V_f | R | I |
|---|---|---|---|---|
| LED1–3 | 3.3 V | ≈ 2.0 V | 220 Ω | **5.9 mA** |
| LED4 | 5.0 V | ≈ 3.0 V | 470 Ω | **4.3 mA** |

✅ ต่ำกว่าพิกัดขา ESP32-S3 มาก — **ค่าเริ่มต้น ≈ 20 mA** *(drive strength `2'd2`)* · สูงสุด ≈ 40 mA *(`2'd3`)*
📌 LED4 ไม่กิน GPIO เลย ต่อจากราง 5 V ตรงๆ

**ดีบาวซ์ปุ่ม** — pull-up ภายใน ~45 kΩ + R11 220 Ω ชาร์จ C10 100 nF

```
τ = (45 000 + 220) × 100 nF = 4.52 ms      เวลาถึงลอจิกสูง ≈ 2τ ≈ 9 ms
การเด้งของปุ่ม tact ทั่วไป = 1–5 ms         ✅ กรองได้ ไม่ช้าจนคนรู้สึก
```

**Vgs ของ Q1** — ตัวแบ่งแรงดัน R9/R10

```
Vgs(on) = 3.3 × 100k / (100k + 1k) = 3.27 V
gate ลอย: 100 nA × 100 kΩ = 10 mV  →  ต่ำกว่า Vgs(th) มาก ปิดสนิท ✅
```

**LDO บน DevKit** — SGM2212-3.3XKC3G (SOT-223)

| | ค่า |
|---|---|
| กระแสจ่ายได้ | 800 mA |
| จำกัดกระแสตอนโอเวอร์โหลด | 810–1100 mA |
| แรงดันตกคร่อมที่ 500 mA | 240 mV *(typ)* |
| **COUT ที่รับรอง** | 🔴 **1–10 µF เท่านั้น** |
| วงจรกันกระแสย้อน | ❌ **ไม่มีระบุใน datasheet** |

✅ ESP32-S3 พีคตอน WiFi TX ~350 mA — **LDO 800 mA เหลือเฟือ**
✅ DevKit มี C 10 µF อยู่บนราง 3.3 V แล้ว = **อยู่ที่ขอบบนของช่วงที่รับรองพอดี**

> ⚠️ ทุกตัวเลขข้างบนเป็น **ค่าคาดหมาย ต้องยืนยันด้วยการวัด**
> V_f จริงอยู่ใน datasheet KENTO KT-0805 · pull-up ภายใน ESP32-S3 ผันตามอุณหภูมิ

---

## 8. บันทึกการตรวจกับ datasheet

**ตรวจเมื่อ 1 ก.ย. 2569 · เอกสารที่ใช้อ้างอิง**

| เอกสาร | ยืนยันอะไร |
|---|---|
| ESP32-S3-DevKitC-1 v1.1 User Guide *(Espressif)* | Header Block J1/J3 · GPIO38 vs GPIO48 · PSRAM · "three mutually exclusive ways to provide power" |
| SCH_ESP32-S3-DevKitC-1_V1.1 *(PDF)* | **LDO = SGM2212-3.3XKC3G** · D1/D7 = 1N5819HW บน USB VBUS |
| SGM2212 datasheet Rev A.2 *(SG Micro)* | 🔴 **COUT 1–10 µF** · 800 mA · ไม่มีวงจรกันย้อน |
| ESP32-S3 Series Datasheet | pull-up 45 kΩ · drive strength 20/40 mA |
| ZE07-CO User's Manual *(Winsen)* | Vin 5–12 V · RXD/TXD 0–3.0 V · **pin 1–15 ไม่ใช่แถว 5 ขา** |

### ✅ ระยะสองแถวขาของ DevKitC-1 — ดู `CLAUDE.md` §6

ระยะสองแถวขาทางการ = **22.86 mm** *(บอร์ดกว้าง 25.40 · ขอบถึงกึ่งกลางรู 1.27 ทั้งสองข้าง · ยาว 62.74)*
footprint บน PCB ของเรา = **22.860 mm** ✅

> ⚠️ มีบอร์ดที่ขายชื่อเดียวกันแต่ระยะ 25.40 mm *(กว้าง 28.05)* — ก่อนสั่งถามคนขายว่า "ความกว้างบอร์ดกี่ mm" → **25.4 = ใช่ · 28 = ไม่ใช่**

## 6. รายชื่อเน็ต (37 เน็ต)

| กลุ่ม | เน็ต |
|---|---|
| ไฟเลี้ยง | `+5V` `+3V3` `GND` |
| I²C | `SDA` `SCL` |
| UART1 | `PMS_TX` `PMS_RX` `PMS_RX_S` `PMS_RST` `PMS_SET` |
| UART2 | `CO_TX` `CO_RX` `CO_RX_S` |
| SPI | `SD_CS` `SD_MOSI` `SD_CLK` `SD_MISO` |
| LED | `LED_G` `LED_G_A` `LED_Y` `LED_Y_A` `LED_R` `LED_R_A` `PWR_LED_A` |
| เสียง | `BUZZ` `BUZZ_DRV` `BUZZ_G` |
| ปุ่ม | `BTN_MARK` `BTN_MARK_S` `BTN_MODE` `BTN_MODE_S` `BTN_ACK` `BTN_ACK_S` |
| console | `U0TXD` `U0TXD_S` `U0RXD` `U0RXD_S` |

**กฎการตั้งชื่อ**

```
U1.39 ── R11 ── SW1
  └BTN_MARK┘ └BTN_MARK_S┘

ไม่ต่อท้าย = ด้านที่ต่อขา ESP32       _S = ด้านนอกตัวต้านทาน (Sensor/Switch)
_A = แอโนดของ LED
```

📌 **ประโยชน์ตอนไล่บั๊ก:** วัด `BTN_MARK` ได้ 3.3 V แต่ `BTN_MARK_S` ได้ 0 V → R11 ขาด

---

## 7. เอกสารอ้างอิง

| เอกสาร | เปิดดูอะไร |
|---|---|
| ESP32-S3-DevKitC-1 User Guide | pinout · **ขนาดบอร์ด** · RGB LED อยู่ขาไหน · เบอร์ LDO |
| ESP32-S3 Series Datasheet | strapping pin · boot configuration |
| PMS7003 Data Manual | pinout · ระดับลอจิก · เวลา warm-up |
| ZE07-CO User's Manual | pinout · **RXD รับ 3.3 V ได้ไหม** · cross-sensitivity |
| ENS160 / AHT21 / SCD40 / SSD1306 | ที่อยู่ I²C · AHT21: รอบวัด > 1 s (§4.4) · ลำดับคำสั่ง (§7.4) |

**ที่อยู่ I²C ไม่ชนกัน:** ENS160 `0x52/0x53` · AHT21 `0x38` *(datasheet V1.0 §7.3)* · SCD40 `0x62` · SSD1306 `0x3C`
