Sh080205/AirGuard/docs/01-HARDWARE_ACTION.md

# AirGuard-S3 — ทำอะไรต่อ

**อัปเดต:** 1 ก.ย. 2569 · **สถานะ:** schematic เสร็จ · สั่ง PCBA แล้ว (SMD ประกอบมา, THT บัดกรีเอง)

> ### 🎯 ทำไปทำไม — อ่านซ้ำเวลาหลงทาง
>
> **เครื่องเฝ้าระวังอากาศในห้องสำหรับผู้ป่วยภูมิแพ้และโรคทางเดินหายใจ
> ที่จับ "รูปแบบผิดปกติ" ไม่ใช่แค่ "ค่าเกินเกณฑ์"**
>
> เครื่องวัดที่มีขายเตือนเมื่อ PM2.5 เกินตัวเลข แต่สิ่งที่กระตุ้นอาการหลายครั้ง
> ไม่ได้ทำให้ค่าไหนเกินเกณฑ์เลย — **สิ่งที่เปลี่ยนคือความสัมพันธ์ระหว่างตัวแปร**
>
> ```
> ทำอาหาร   PM2.5↑ + อุณหภูมิ↑ + ความชื้น↑   → ขึ้นด้วยกัน = ปกติ
> ปัดฝุ่น/รา  PM2.5↑ แต่อุณหภูมิกับความชื้นนิ่ง → ความสัมพันธ์ขาด = ผิดปกติ
> ```
>
> ทั้งสองกรณี PM2.5 อาจเท่ากันเป๊ะ — **เกณฑ์ตัวเลขแยกไม่ออก แต่ multivariate แยกออก**
> นี่คือเหตุผลทั้งหมดที่ต้องมี autoencoder ไม่ใช่แค่ `if (pm25 > 50)`
>
> ดูเป้าหมายฉบับเต็มใน [`00-start-here/AirGuard-S3_TEAM_PLAN.md`](00-TEAM_PLAN.md)

> 📄 หาตารางขา / ค่าอุปกรณ์ / pinout → เปิด `02-HARDWARE_REFERENCE.md`
> 📄 หาที่มาของสูตรและการคำนวณ *(สำหรับ lab report)* → `archive/BUILD_SPEC.md`

---

## 🔴 ทำวันนี้ — 5 นาที

**วัดว่า footprint ของ U1 ตรงกับ DevKit จริงไหม**

นี่คือสิ่งเดียวที่ผิดแล้วบอร์ดใช้ไม่ได้ทั้งแผ่น และเราไม่เคยยืนยันเลย

```
1. เปิดไฟล์ PCB ใน EasyEDA → เครื่องมือ Measure
   วัดกึ่งกลางแพดแถวซ้าย → กึ่งกลางแพดแถวขวาที่อยู่ตรงข้าม     = _____ mm

2. หาค่าทางการมาเทียบ — เลือกทางใดทางหนึ่ง
   ก. เอาเวอร์เนียวัด DevKit ตัวจริง                            = _____ mm
   ข. เปิด DXF ทางการใน Autodesk Viewer แล้ววัดในนั้น           = _____ mm

3. ต่างกัน < 0.3 mm  →  ✅ ผ่าน
   ต่างกัน ≥ 0.5 mm  →  🔴 แก้ footprint แล้วสั่งใหม่
```

> 🔑 **ยังไม่มีบอร์ดในมือก็ทำข้อ 2ข ได้เลยวันนี้**
> เอกสารทางการของ Espressif **ไม่ได้เขียนระยะนี้เป็นตัวเลขในหน้าเว็บ** มีแต่ในไฟล์ DXF
> ไฟล์ชื่อ `DXF_ESP32-S3-DevKitC-1_V1.1_20220429.dxf` ลิงก์อยู่ท้ายหน้า User Guide
> เปิดใน [Autodesk Viewer](https://viewer.autodesk.com/) ออนไลน์ ใช้เครื่องมือวัดในนั้นได้เลย
>
> ⚠️ **แต่ยังต้องวัดของจริงอยู่ดี** บอร์ดที่ขายในไทยบางล็อตเป็นของก๊อปที่ไม่ตรงแบบทางการ

> 🔑 **ทำก่อนของมาถึง** ถ้าผิดจะได้สั่งรอบสองทัน — รอจนของมาถึงแล้วค่อยรู้จะไม่เหลือเวลา

---

## 🛒 สั่งของ

**บนบอร์ด**

| ของ | จำนวน | หมายเหตุ |
|---|---|---|
| Female header 1×40 2.54 mm | **4–5 เส้น** | 🔑 ตัดเป็น 1×22 เสียช่องที่ตัด → 1 เส้นได้ 1 อัน |
| Buzzer active 3.3 V ⌀12 mm **ระยะขา 6.0 mm** | 1 | ⚠️ ระยะขาต้องตรงเป๊ะ |
| Electrolytic 470 µF/16 V ⌀5.5 **ระยะขา 2.5 mm** | **1** | C1 เท่านั้น — 🔴 **C13 ไม่ต้องซื้อ** ดูเหตุผลด้านล่าง |
| JST **B8B-XH-A** 8P | 1 | J1 |
| JST **B5B-XH-A** 5P | 1 | J2 |
| JST **B4B-XH-A** 4P | 3 | J3 J4 J5 |
| Pin header ตัวผู้ 1×40 2.54 mm | 1 | ตัดใช้กับ J6 (6P) + J7 (3P) |
| Terminal block KF128 5.08 mm 2P | 1 | J8 |

**สาย + โมดูล**

| ของ | จำนวน | ⚠️ |
|---|---|---|
| สาย JST-XH 8P / 5P / 4P | 1 / 1 / 3 | 🔑 **ซื้อแบบสำเร็จพร้อมหัว** อย่าคริมป์เอง |
| ESP32-S3-DevKitC-1 | 1 | เช็คว่ามีขาตัวผู้บัดกรีมาไหม |
| PMS7003 + adapter | 1 | |
| ZE07-CO | 1 | 🔴 ขาโมดูลนับเป็น pin 1–15 **ไม่ใช่แถว 5 ขา** → ดูตารางแมปใน REFERENCE §3 |
| ENS160+AHT21 (คอมโบ) · SSD1306 · SCD40 | อย่างละ 1 | ⚠️ เช็คลำดับขา ↓ |
| microSD module 3.3 V | 1 | |

> ⚠️ **เช็คลำดับขาเซนเซอร์ I²C ก่อนเสียบ**
> บอร์ดเราเรียง `VCC-GND-SDA-SCL` · โมดูลในตลาดหลายรุ่นเรียง `VCC-GND-SCL-SDA`
> ไม่ตรง → ต้องทำสายไขว้ **สลับไม่พังแต่จะไม่เจออุปกรณ์**

---

## 📦 พอบอร์ดมาถึง

### ขั้น 0 — ตรวจก่อนแตะหัวแร้ง (มัลติมิเตอร์อย่างเดียว)

| วัดระหว่าง | ควรได้ | ถ้าไม่ตรง |
|---|---|---|
| TP6 (+5V) ↔ TP1 (GND) | ≫ 1 kΩ | 🔴 ช็อต — เคลมโรงงาน |
| TP5 (+3V3) ↔ TP1 (GND) | ≫ 1 kΩ | 🔴 ช็อต — เคลมโรงงาน |
| TP2 (SDA) ↔ TP5 | ≈ 4.7 kΩ | R1 ไม่ติด |
| TP3 (SCL) ↔ TP5 | ≈ 4.7 kΩ | R2 ไม่ติด |
| gate ของ Q1 ↔ TP1 | ≈ 100 kΩ | R10 ไม่ติด → **buzzer ดังเองตอนบูต** |

**ส่องแว่นขยาย:** แถบคาดของ D1 ต้องอยู่ด้าน `+3V3` *(ถ้ากลับด้าน Q1 จะไหม้ตอนสั่ง buzzer)*

### ขั้น 1–6 — บัดกรี

```
1. U1 socket    🔑 เสียบ DevKit ทับก่อน ค่อยบัดกรีจากด้านล่าง — กันเอียง
2. J1–J8        ใช้เทปกาวยึดก่อนลงขาแรก
3. C1           ⚠️ ตรวจขั้ว +      · ยังไม่ต้องใส่ C13
4. BZ1          ⚠️ ตรวจขั้วก่อน ↓
5. จ่ายไฟโดยยังไม่เสียบ DevKit → จับดูว่ามีอะไรร้อนไหม
6. เสียบ DevKit → เสียบเซนเซอร์ทีละตัว ไม่ใช่ทีเดียวหมด
```

> 🔴 **หาขั้ว buzzer ก่อนบัดกรี** — ต่อกับถ่าน 3 V ลองทั้งสองทาง จำว่าทางไหนดัง
> บอร์ดเราต่อ **ขา 2 ไปไฟบวก** ถ้าของจริงขา 1 เป็นบวกต้องสลับ
> อาการถ้าผิด = ไม่ดังหรือดังเบามาก ไม่พังแต่หาสาเหตุนาน

---

## 🤔 2 เรื่องที่รอผลวัด ไม่ต้องตัดสินตอนนี้

### 🔴 C13 — **อย่าใส่** *(ตรวจ datasheet แล้ว 1 ก.ย. — กลับคำแนะนำเดิม)*

**ผมเคยแนะนำให้ใส่ C13 แล้วเพิ่มไดโอด Schottky — คำแนะนำนั้นผิด**
พอเปิด schematic ของ DevKit หาเบอร์ LDO จริงแล้ว ตัวเลขไม่ผ่าน

```
LDO บน DevKitC-1 = SGM2212-3.3XKC3G

datasheet · Recommended Operating Conditions:
    Output Effective Capacitance, COUT ......... 1 µF ถึง 10 µF

C13 ของเรา = 470 µF  →  เกินเพดาน 47 เท่า
```

และ datasheet เขียนกำกับไว้ตรงๆ ว่า
*"Functional operation of the device at any conditions beyond those indicated in the
Recommended Operating Conditions section is not implied."*
= ผู้ผลิต**ไม่รับรองว่าจะทำงานได้** ไม่ใช่แค่ "ไม่แนะนำ"

**ซ้ำร้าย DevKit มี C 10 µF บนราง 3.3 V อยู่แล้ว** → ตอนนี้อยู่ที่ขอบบนของช่วงพอดี ไม่มีที่ว่างให้เติม

#### แล้วปัญหาแรงดันตกตอน SD card เขียนล่ะ

ไม่มีจริงตั้งแต่แรก — **LDO ตัวนี้จ่ายได้ 800 mA** ส่วน ESP32-S3 พีคตอน WiFi TX ~350 mA
และ microSD ~100 mA · datasheet โฆษณาว่า *"fast transient response"* โดยเฉพาะ

| ทำ | ผล |
|---|---|
| **ไม่ใส่ C13** ⭐ | ✅ อยู่ในสเปกผู้ผลิต · ประหยัด 1 ชิ้น · ไม่ต้องทำอะไรเลย |
| ใส่ 470 µF | 🔴 นอกสเปก 47 เท่า · เสี่ยงแกว่ง + กระแสย้อนตอนปิดเครื่อง |
| ใส่ 4.7–10 µF แทน | 🟡 อยู่ในสเปก แต่ **ได้ประโยชน์น้อยมาก** เพราะ DevKit มีให้แล้ว |

> 🔑 **ยังวัดเก็บเป็น lab report ได้** — เอาสโคปจับ TP5 ตอนสั่งเขียน microSD ต่อเนื่อง
> วัด ΔV ที่เกิดจริง แล้วเทียบกับ 800 mA ที่ LDO จ่ายได้
> **"เราคิดว่าต้องใส่ bulk cap แต่พอเปิด datasheet แล้วพบว่าไม่ต้อง และวัดยืนยันแล้ว"**
> เป็นเนื้อหารายงานที่ดีกว่าการใส่ตัวเก็บประจุไปเฉยๆ มาก

### LED1 เขียวอมเหลือง — แก้ด้วยเฟิร์มแวร์ ฟรี

LED1 ถูกประกอบเป็น `KT-0805YG` แล้ว สีใกล้ LED2 (เหลือง) เกินไป
ถอดเปลี่ยนเสี่ยงทำแพดหลุด → **แยกด้วยจังหวะกะพริบแทนสี**

```
NORMAL  →  ติดค้าง
WATCH   →  กะพริบ 1 ครั้ง/วินาที
ALARM   →  กะพริบ 5 ครั้ง/วินาที + buzzer
```

> 🔑 จังหวะแยกออกจากกันชัดกว่าสีเสมอ โดยเฉพาะกับ**คนตาบอดสี** ซึ่งควรคิดอยู่แล้ว
> ในอุปกรณ์ที่ทำเพื่อผู้ป่วย → **เขียนในรายงานว่าเป็นการออกแบบเพื่อการเข้าถึง**

---

## ⬜ งานที่เริ่มได้เลย ไม่ต้องรอฮาร์ดแวร์

| งาน | ใคร |
|---|---|
| repo skeleton + README + CI | คน B |
| `ml/metrics.py` — PR-AUC, MTTD, false alarm/day *(ห้ามใช้ accuracy)* | คน C |
| `ml/train_ae.py` — autoencoder + threshold | คน C |
| firmware skeleton — FSM + FreeRTOS tasks + driver PMS7003 | คน B |
| ลงทะเบียน DustBoy API *(รออนุมัติ ควรทำวันนี้)* | คน C |

---

## ⚠️ ข้อความบังคับในรายงานและบนตัวเครื่อง

> **อุปกรณ์นี้เป็นเครื่องเฝ้าระวังสภาพแวดล้อมเพื่อการวิจัย ไม่ใช่เครื่องมือแพทย์
> และไม่ใช่เครื่องเตือนภัยคาร์บอนมอนอกไซด์
> ห้ามใช้แทน CO alarm ที่ได้มาตรฐาน UL 2034 หรือ EN 50291**

ผู้ผลิต ZE07-CO ระบุใน datasheet เองว่า
*"Please do not use the modules in systems which related to human being's safety."*
