Sh080205/AirGuard/docs/slides/AirGuard-S3-script.md

# AirGuard-S3 · บทพูดนำเสนอ 5 พ.ย. 2569

พูด 10:10 นาที + demo สด 10:00 นาที รวม 20:10 นาที · สามคน: A = ฮาร์ดแวร์ · B = เฟิร์มแวร์ · C = ข้อมูลและโมเดล · ข้อความใน [ ] คือคำแนะนำ ไม่ต้องอ่านออกเสียง · หน้ารายละเอียดอยู่ในภาคผนวกท้ายสไลด์ ใช้ตอบคำถาม

สร้างจาก `docs/slides/src/script.py` ด้วย `python docs/slides/build.py` (บทเดียวกับโน้ตในสไลด์ กด N) — แก้ที่ script.py แล้ว build ใหม่

## ตารางเวลา

| หน้า | หัวข้อ | เริ่ม | ยาว | ผู้พูด |
| --- | --- | --- | --- | --- |
| 1 | AirGuard-S3 | 0:00 | 0:20 | A · ฮาร์ดแวร์ |
| 2 | ปัญหา: เกณฑ์ตัวเลขแยกเหตุการณ์ไม่ออก | 0:20 | 0:35 | A · ฮาร์ดแวร์ |
| 3 | เป้าหมาย ขอบเขต และสิ่งที่ไม่ใช่ | 0:55 | 0:25 | A · ฮาร์ดแวร์ |
| 4 | ภาพรวมระบบ | 1:20 | 0:30 | A · ฮาร์ดแวร์ |
| 5 | Schematic: ไฟเลี้ยงและการตัดสินใจ | 1:50 | 0:35 | A · ฮาร์ดแวร์ |
| 6 | Pull-up · pull-down · การปรับสัญญาณ | 2:25 | 0:35 | A · ฮาร์ดแวร์ |
| 7 | PCBA ประกอบ ขึ้นบอร์ด และปัญหาที่เจอ | 3:00 | 0:40 | A · ฮาร์ดแวร์ |
| 8 | สถาปัตยกรรม task (ESP-IDF + FreeRTOS) | 3:40 | 0:35 | B · เฟิร์มแวร์ |
| 9 | Interrupt และการส่งข้อมูลระหว่าง task | 4:15 | 0:35 | B · เฟิร์มแวร์ |
| 10 | 1 วินาทีของ sampler และผลวัดเวลา | 4:50 | 0:30 | B · เฟิร์มแวร์ |
| 11 | เซนเซอร์และ actuator ตาม datasheet | 5:20 | 0:40 | B · เฟิร์มแวร์ |
| 12 | SPI microSD และหน่วยความจำ | 6:00 | 0:25 | B · เฟิร์มแวร์ |
| 13 | เส้นทางความปลอดภัย CO | 6:25 | 0:30 | B · เฟิร์มแวร์ |
| 14 | เว็บบนชิป จอ และสายข้อมูลไป PC | 6:55 | 0:40 | C · ข้อมูลและโมเดล |
| 15 | Integration: ทุกส่วนในกล่องเดียว | 7:35 | 0:25 | C · ข้อมูลและโมเดล |
| 16 | Creative 1: ตรวจรูปแบบผิดปกติด้วย Mahalanobis บนชิป | 8:00 | 0:40 | C · ข้อมูลและโมเดล |
| 17 | ผลของโมเดล | 8:40 | 0:40 | C · ข้อมูลและโมเดล |
| 18 | ข้อจำกัด | 9:20 | 0:35 | C · ข้อมูลและโมเดล |
| 19 | Demo สด · 10 นาที | 9:55 | 10:00 | B · เฟิร์มแวร์ |
| 20 | งานต่อและสรุป | 19:55 | 0:15 | C · ข้อมูลและโมเดล |

## ต้องพูดอะไรในแต่ละหน้า

### 1 · AirGuard-S3 · 0:20 · A · ฮาร์ดแวร์

**ต้องพูดถึง:** ชื่อโครงงาน · กลุ่มผู้ใช้ · ทีม 3 คนและบทบาท · พูด 10 นาที + demo 10 นาที

**บทพูด:** สวัสดีครับ/ค่ะ เราคือทีม [ชื่อทีม] ขอนำเสนอ AirGuard-S3 เครื่องเฝ้าระวังคุณภาพอากาศในห้อง ที่ตรวจรูปแบบผิดปกติบนชิปเอง สำหรับผู้ป่วยภูมิแพ้ ทีมมีสามคน [แนะนำชื่อและบทบาท] เราจะพูดสิบนาที แล้วสาธิตเครื่องจริงอีกสิบนาที

### 2 · ปัญหา: เกณฑ์ตัวเลขแยกเหตุการณ์ไม่ออก · 0:35 · A · ฮาร์ดแวร์

**ต้องพูดถึง:** เกณฑ์ตัวเดียวแยกไม่ออก · ทำอาหาร vs ปัดฝุ่น · บอกว่าเป็นสมมติฐานที่ทดสอบ

**บทพูด:** เครื่องวัดฝุ่นทั่วไปเตือนเมื่อค่าเกินเกณฑ์ แต่สิ่งที่กระตุ้นอาการหลายครั้งไม่ได้ทำให้ค่าไหนเกินเกณฑ์ ตอนทำอาหาร ฝุ่น อุณหภูมิ และความชื้นขึ้นพร้อมกัน ส่วนตอนปัดฝุ่น ฝุ่นขึ้นอย่างเดียว ค่า PM2.5 อาจเท่ากัน เกณฑ์ตัวเดียวจึงแยกไม่ออก ถ้าดูหลายค่าพร้อมกันจะเห็นว่าความสัมพันธ์ขาดไป นี่คือสมมติฐานที่งานนี้ทดสอบ

### 3 · เป้าหมาย ขอบเขต และสิ่งที่ไม่ใช่ · 0:25 · A · ฮาร์ดแวร์

**ต้องพูดถึง:** เป้าหมาย 4 ข้อ · อ่านกรอบแดง §8 ให้ครบตามตัวอักษร

**บทพูด:** เป้าหมายมีสี่ข้อ วัดได้ทุกวินาทีอย่างเชื่อถือได้ คิดความผิดปกติบนชิปเอง แยกเส้นทาง CO ออกจาก ML และดูค่าได้ทันที และขอย้ำข้อความในกรอบแดง [อ่านกรอบแดงให้ครบ]

### 4 · ภาพรวมระบบ · 0:30 · A · ฮาร์ดแวร์

**ต้องพูดถึง:** เซนเซอร์ → sampler → บันทึก/เว็บ/จอ/ไฟ · CO แยกจาก ML · เทรนบน PC แล้วกลับเข้าชิป

**บทพูด:** ภาพรวม เซนเซอร์สี่ตัวส่งค่าเข้า task sampler ทุกวินาที sampler ประกอบแถวข้อมูล คิดคะแนนความผิดปกติ แล้วส่งต่อไปบันทึก หน้าเว็บ จอ และไฟ กล่องแดงคือเส้นทาง CO ที่ไม่ผ่าน ML ส่วนกรอบม่วงคือฝั่ง PC ที่เอาข้อมูลไปเทรน แล้วส่งโมเดลกลับเข้าเฟิร์มแวร์

### 5 · Schematic: ไฟเลี้ยงและการตัดสินใจ · 0:35 · A · ฮาร์ดแวร์

**ต้องพูดถึง:** carrier + netlist 37 เน็ต · ราง 5 V / 3.3 V พอกับพีค Wi-Fi · ไม่ใส่ C13 (เกิน 47 เท่า)

**บทพูด:** บอร์ดของเราเป็น carrier ให้ DevKit เสียบ ผังนี้วาดจาก netlist ที่ตรวจครบ 37 เน็ต ราง 5 โวลต์เลี้ยง PMS กับ ZE07 ราง 3.3 โวลต์มาจาก LDO 800 mA บน DevKit ซึ่งพอกับพีคตอนส่ง Wi-Fi ราว 350 mA และเราไม่ใส่ C13 470 ไมโครฟารัด เพราะ LDO รับรองตัวเก็บประจุขาออกแค่ 1 ถึง 10 ไมโครฟารัด

### 6 · Pull-up · pull-down · การปรับสัญญาณ · 0:35 · A · ฮาร์ดแวร์

**ต้องพูดถึง:** ปุ่ม pull-up ภายใน + RC 4.52 ms + debounce 50 ms · I²C 4.7 kΩ · pull-down 100 kΩ ที่ gate · R4 100 Ω

**บทพูด:** บนบอร์ดไม่มี pull-up ของปุ่ม จึงเปิด pull-up ภายใน พร้อม RC กรองเด้ง 4.52 มิลลิวินาที และ debounce ในซอฟต์แวร์ 50 มิลลิวินาที I²C ใช้ pull-up ภายนอก 4.7 กิโลโอห์มไป 3.3 โวลต์ gate ของ MOSFET ที่ขับ buzzer มี pull-down 100 กิโลโอห์ม กันเสียงดังเองตอนบูต และขา TX ไป ZE07 มีตัวต้านทาน 100 โอห์ม เพราะ ZE07 รับลอจิกได้แค่ 3.0 โวลต์

### 7 · PCBA ประกอบ ขึ้นบอร์ด และปัญหาที่เจอ · 0:40 · A · ฮาร์ดแวร์

**ต้องพูดถึง:** PCB 2 ชั้น · ซ็อกเก็ต 22.86 mm · test point 8 จุด · ยก PCB จริง · 5 V = 4.59 V · ปัญหาและวิธีแก้

**บทพูด:** PCB สองชั้น ซ็อกเก็ตระยะ 22.86 มิลลิเมตรตรงกับ DevKit จริง มี test point แปดจุด [ยก PCB จริงให้ดู] เราขึ้นบอร์ดเป็นขั้น วัดราง 5 โวลต์ได้ 4.59 ตอน PMS ทำงาน ปัญหาที่เจอ เช่น LED ดวงแรกสีเพี้ยน เราแยกสถานะด้วยจังหวะกะพริบแทน จอเรียงขาต่างจึงทำสายไขว้ และช่อง SD ใช้ไม่ได้จึงบันทึกผ่าน USB [ส่งต่อ] ต่อไป [ชื่อ B] จะเล่าว่าเฟิร์มแวร์ใช้บอร์ดนี้อย่างไร

### 8 · สถาปัตยกรรม task (ESP-IDF + FreeRTOS) · 0:35 · B · เฟิร์มแวร์

**ต้องพูดถึง:** priority และเหตุผล · co/sampler อยู่คอร์ 1 แยกจาก Wi-Fi · CO เริ่มก่อนตอนบูต · ไม่ abort · stack วัด HWM

**บทพูด:** เฟิร์มแวร์ใช้ ESP-IDF กับ FreeRTOS แบ่งงานเป็น task ตามความเร่งด่วน task co สำคัญสุด priority 11 sampler รองลงมา ทั้งคู่อยู่คอร์ 1 แยกจาก Wi-Fi ส่วนงานช้าอย่างบันทึก เว็บ และจอ อยู่ priority ต่ำ ตอนบูต CO เริ่มก่อนทุกอย่าง ส่วนไหน init ไม่ผ่านแค่บันทึก log ไม่ reboot และ stack ทุก task วัด high-water mark จริงบนบอร์ด

### 9 · Interrupt และการส่งข้อมูลระหว่าง task · 0:35 · B · เฟิร์มแวร์

**ต้องพูดถึง:** ISR ส่งเข้า queue อย่างเดียว · debounce 50 ms · queue vs mailbox · volatile ไม่พอ

**บทพูด:** ปุ่มใช้ interrupt ขอบลง ใน ISR เราส่งหมายเลขขาเข้า queue อย่างเดียว ไม่ print ไม่ delay task io รอ 50 มิลลิวินาทีเพื่อยืนยัน แล้วส่ง MARK ให้ sampler ใช้ในรอบถัดไป ข้อมูลที่ห้ามหายใช้ queue ส่วนสถานะอย่าง CO และ ML ใช้ mailbox ที่อ่านได้ทั้งก้อน เพราะ volatile อย่างเดียวกันการอ่านครึ่งเก่าครึ่งใหม่ข้ามสองคอร์ไม่ได้

### 10 · 1 วินาทีของ sampler และผลวัดเวลา · 0:30 · B · เฟิร์มแวร์

**ต้องพูดถึง:** timer: xTaskDelayUntil ไม่สะสม drift · 608 แถว/610 s · overrun 0 · jitter ≤ 107 µs · งานต่อรอบ < 150 ms

**บทพูด:** คาบหนึ่งวินาทีใช้ timer ของ FreeRTOS ผ่าน xTaskDelayUntil ซึ่งอ้างเวลาตื่นครั้งก่อน จึงไม่สะสมความคลาดเคลื่อน วัดบนบอร์ดสิบนาที ได้ 608 แถวใน 610 วินาที ไม่มีรอบที่ช้า jitter ไม่เกิน 107 ไมโครวินาที และงานต่อรอบไม่ถึง 150 มิลลิวินาที

### 11 · เซนเซอร์และ actuator ตาม datasheet · 0:40 · B · เฟิร์มแวร์

**ต้องพูดถึง:** เฟรม UART + checksum · I²C CRC/MISR · อ่านตาม datasheet · ค่าไม่พร้อมเว้นว่าง · ไฟแยกด้วยจังหวะ

**บทพูด:** เซนเซอร์ UART สองตัวตรวจ checksum ทุกเฟรม เฟรมเสียศูนย์จากราว 650 เฟรม บน I²C สามอุปกรณ์ตรวจ CRC และ checksum error เป็นศูนย์ เราอ่านตาม datasheet เช่น AHT21 วัดทุกสองวินาที และค่าที่ไม่พร้อมจะเว้นว่าง ไฟสามดวงขับด้วยเครื่องจักรสถานะ เขียวปกติ เหลืองเมื่อ D² เกินเกณฑ์ แดงพร้อมเสียงเมื่อเกินติดกัน 30 แถว แยกกันด้วยจังหวะ

### 12 · SPI microSD และหน่วยความจำ · 0:25 · B · เฟิร์มแวร์

**ต้องพูดถึง:** SPI microSD (ช่องการ์ดเสีย → USB) · flash/partition/PSRAM · สรุปหัวข้อวิชาที่ใช้ครบ · ไม่ใช้ ADC/DAC/PWM

**บทพูด:** microSD ต่อผ่าน SPI เขียนโค้ดแล้ว แต่ช่องการ์ดเสียทางกลไก จึงบันทึกผ่าน USB แทน เฟิร์มแวร์ใช้ราว 23 เปอร์เซ็นต์ของ partition 4 MB สรุปฝั่งเฟิร์มแวร์ใช้ครบ I/O, interrupt, timer, UART, SPI, I²C, memory, Wi-Fi, watchdog และ FSM

### 13 · เส้นทางความปลอดภัย CO · 0:30 · B · เฟิร์มแวร์

**ต้องพูดถึง:** เกณฑ์ 90 / 30 ppm (WHO) · FAULT เมื่อเงียบ 6 s · watchdog · ไม่พึ่ง ML/SD/Wi-Fi · ทดสอบด้วย host test เท่านั้น

**บทพูด:** เส้นทาง CO แยกจากทุกอย่าง เกณฑ์ WHO ค่าทันที 90 ppm หรือเฉลี่ยชั่วโมง 30 ppm เงียบเกินหกวินาทีขึ้น FAULT task นี้ลงทะเบียน watchdog และไม่พึ่ง ML, SD หรือ Wi-Fi ข้อจำกัดคือ ALARM ทดสอบด้วย host test เท่านั้น [ส่งต่อ] ต่อไป [ชื่อ C] จะเล่าว่าข้อมูลออกไปถึงผู้ใช้และโมเดลอย่างไร

### 14 · เว็บบนชิป จอ และสายข้อมูลไป PC · 0:40 · C · ข้อมูลและโมเดล

**ต้องพูดถึง:** SNTP · WebSocket + ประวัติ 10 นาที · อ่านอย่างเดียว · ไม่ต้องใช้เน็ต · บอกว่าภาพเป็นภาพจำลอง · สายข้อมูลฝั่ง PC

**บทพูด:** เครื่องเอาเวลาจริงจาก SNTP ส่งค่าให้เบราว์เซอร์ทุกวินาทีผ่าน WebSocket พร้อมประวัติสิบนาที ทุก endpoint อ่านอย่างเดียว และเว็บช้าก็ไม่ลากการวัด dashboard ฝังในเฟิร์มแวร์ ใช้ได้โดยไม่มีอินเทอร์เน็ต ภาพนี้เป็นภาพจำลอง ฝั่ง PC ข้อมูลออก USB เป็น CSV ผ่านสคริปต์ตรวจคุณภาพ ตรวจเหตุการณ์ และเทรน แล้ว export โมเดลกลับเข้าเฟิร์มแวร์

### 15 · Integration: ทุกส่วนในกล่องเดียว · 0:25 · C · ข้อมูลและโมเดล

**ต้องพูดถึง:** กล่องจากค่าวัด 50 ค่า · ห้อง T/RH แยกเพราะฮีตเตอร์ (+3.2 °C) · ผลในกล่อง แถวครบ error 0 ไม่มี CO FAULT

**บทพูด:** ทั้งหมดรวมอยู่ในกล่องที่ออกแบบจากการวัดชิ้นงานจริง 50 ค่า ห้องอุณหภูมิและความชื้นแยกด้วยผนังสองชั้น เพราะฮีตเตอร์ของ ENS160 ทำให้อุณหภูมิสูงขึ้น 3.2 องศา ทดสอบในกล่องจริงสองรอบ รอบละสิบนาที แถวครบ error เป็นศูนย์ และไม่มี CO FAULT

### 16 · Creative 1: ตรวจรูปแบบผิดปกติด้วย Mahalanobis บนชิป · 0:40 · C · ข้อมูลและโมเดล

**ต้องพูดถึง:** อธิบาย D² ด้วยภาพวงรี · normalize ด้วยค่าจาก train · เกณฑ์ 17.92 · แบ่งตามเวลา · 18 พารามิเตอร์

**บทพูด:** หัวใจคือคะแนน Mahalanobis D² ที่คำนวณบนชิป จาก PM2.5 อุณหภูมิ และความชื้น ปรับสเกลด้วยค่าจากช่วงเทรนเท่านั้น ดูภาพนี้ จุดแดงอยู่ในช่วงปกติของทุกแกน ถ้าดูทีละค่าจะบอกว่าปกติ แต่มันหลุดจากวงรีของข้อมูลปกติ D² จึงสูง เกณฑ์ 17.92 เลือกบนช่วง validation แบ่งข้อมูลตามเวลา ไม่สุ่ม และโมเดลมีพารามิเตอร์แค่ 18 ตัว รันบน MCU ได้สบาย

### 17 · ผลของโมเดล · 0:40 · C · ข้อมูลและโมเดล

**ต้องพูดถึง:** แยกข้อมูลสังเคราะห์กับจริง · ธูปจับได้ ปัดฝุ่นไม่ได้ · เตือนผิด 0 / 2 / 12 ใน 6.7 ชม. · ไม่แปลงเป็นต่อวัน

**บทพูด:** บนข้อมูลสังเคราะห์ เหตุการณ์แบบความสัมพันธ์ขาด Mahalanobis จับได้ 15 จาก 15 ส่วน 3σ จับไม่ได้เลย บนข้อมูลจริง ธูปจับได้ แต่ปัดฝุ่นจับไม่ได้ ช่วง test ไม่มีเหตุการณ์ จึงวัดได้แค่การเตือนผิด Mahalanobis เตือนผิดศูนย์ครั้งใน 6.7 ชั่วโมง ขณะที่ 3σ สองครั้ง และเกณฑ์ตายตัวสิบสองครั้ง ข้อดีที่เห็นคือเตือนผิดน้อยกว่า ส่วนการจับเหตุการณ์ยังต้องเก็บข้อมูลเพิ่ม

### 18 · ข้อจำกัด · 0:35 · C · ข้อมูลและโมเดล

**ต้องพูดถึง:** ข้อจำกัดหลักครบ · ไม่ใช่เครื่องเตือน CO · ส่งต่อให้คนทำ demo

**บทพูด:** ข้อจำกัดที่ต้องบอก ช่วง test สั้นและไม่มีเหตุการณ์จริง ปัดฝุ่นจับไม่ได้ เรื่องทำอาหารยังไม่ได้ทดสอบ โมเดลเทรนนอกกล่องที่ความชื้นราว 57 เปอร์เซ็นต์ ในห้องแห้ง ML ALARM จึงค้าง ข้อมูลมีแค่ห้าวัน CO ALARM ทดสอบด้วย host test และเครื่องนี้ไม่ใช่เครื่องเตือน CO [ส่งต่อ] ต่อไปขอให้ [ชื่อ B] สาธิตเครื่องจริง

### 19 · Demo สด · 10 นาที · 10:00 · B · เฟิร์มแวร์

**ต้องพูดถึง:** ทำตาม run sheet · ห้ามแก้หรือ flash หน้างาน

**บทพูด:** ต่อไปเป็นการสาธิตเครื่องจริงในกล่อง สิบนาที [ทำตาม run sheet ด้านล่าง · แต่ละช่วงมีชื่อคนพูดกำกับ]

**ก่อนเริ่ม:**

- [ ] เครื่องในกล่องเปิดมาแล้วเกิน 5 นาที (ZE07 ผ่านช่วงอุ่นเครื่อง)
- [ ] มือถือเปิด hotspot ตัวที่ฝังใน secrets.h · เช็ค IP ของ dashboard (บันทึก 3 พ.ย. คือ 172.20.10.3)
- [ ] เปิด dashboard ค้างไว้ 1 เครื่อง
- [ ] โน้ตบุ๊กรัน serial_logger.py ให้เห็นบรรทัด AGCSV
- [ ] ห้ามแก้หรือ flash หน้างาน

| เวลา | ใคร | ทำอะไร · พูดอะไร |
| --- | --- | --- |
| 0:00 | A | ตัวเครื่อง: ชี้ PMS7003, ZE07-CO และห้อง T/RH ที่แยกด้วยผนังสองชั้น · ยก PCB ที่ออกแบบให้ดู · ชี้ LED 3 ดวง ปุ่ม MARK/MODE/ACK และจอ OLED |
| 1:30 | B | ข้อมูลสด: ชี้บรรทัด AGCSV บนโน้ตบุ๊กที่ขึ้นทุกวินาที อ่านคอลัมน์ทีละตัว (เวลา +07:00 · PM · T · RH · TVOC · eCO2 · CO · label) · ชี้ว่าจอ OLED แสดงค่าเดียวกัน |
| 3:00 | C | dashboard: ค่าบนมือถือเปลี่ยนทุกวินาที ตรงกับบรรทัดบนโน้ตบุ๊ก · ชี้กราฟ 10 นาที · ชี้ D² เทียบเกณฑ์ 17.92 · ชี้ข้อความ §8 ท้ายหน้า |
| 4:30 | B | เซนเซอร์ตอบสนอง: หายใจใกล้ช่องลมของ ENS160 ให้ TVOC/eCO2 ขึ้น · เอามือใกล้ช่องห้อง T/RH ให้ T/RH เปลี่ยน · ให้ดูกราฟและ D² ขยับ [ซ้อมก่อนว่าเห็นผลจริง ถ้าไม่เห็นให้ข้ามและเล่าแทน] |
| 6:00 | C | ปุ่ม MARK: กดเริ่ม → label เป็น marked และไฟเขียวเปลี่ยนจังหวะ · กดจบ → บรรทัด AGEV ขึ้นบนโน้ตบุ๊ก · อธิบายว่านี่คือวิธีสร้าง ground truth ตอนเก็บข้อมูล |
| 7:00 | B | ไฟและปุ่ม: กด MODE ค้าง 3 s → เครื่องสาธิตรูปแบบไฟ 60 s (ปกติ · WATCH · ALARM · FAULT) · ชี้ว่าแยกด้วยจังหวะไม่ใช่สี · ถ้ามีเสียง ALARM กด ACK ปิดเสียง |
| 8:00 | B | ความทนทาน: ปิด hotspot → dashboard ขึ้น "ขาดการเชื่อมต่อ" ภายใน 3 s แต่จอ OLED และบรรทัด AGCSV ยังเดินต่อ เส้นทาง CO ไม่สะดุด → เปิด hotspot คืน เครื่องต่อใหม่เอง (ลองทุก 10 s) [ซ้อมก่อน] |
| 9:15 | C | ML และ CO: ถ้าไฟ ML ขึ้น WATCH/ALARM ค้าง อธิบายว่าโมเดลเทรนที่ RH ราว 57 % ห้องนี้แห้งกว่า D² จึงสูง เป็นข้อจำกัดที่บอกไว้แล้ว · ชี้ค่า CO ที่ทำงานแยกจาก ML · ส่งต่อถาม-ตอบ |

**แผนสำรอง:** Wi-Fi ไม่ขึ้น → เปิดวิดีโอซ้อม แล้วโชว์ OLED กับ serial แทน · ขึ้น CO FAULT → บอกตรงๆ ว่า ZE07 เงียบเกิน 6 s เครื่องแสดง FAULT ตามที่ออกแบบ · เวลาเหลือน้อย → ตัดช่วง 4:30 ก่อน แล้วช่วง 8:00

### 20 · งานต่อและสรุป · 0:15 · C · ข้อมูลและโมเดล

**ต้องพูดถึง:** สรุป 4 ประโยค · เปิดถาม-ตอบ

**บทพูด:** สรุป บอร์ดที่ออกแบบเองทำงานได้ เฟิร์มแวร์วัดได้จริงทุกวินาที dashboard ใช้งานได้ และเรารู้ชัดว่าต้องเพิ่มข้อมูลตรงไหน ขอบคุณครับ/ค่ะ ยินดีตอบคำถาม

## คำถามที่น่าจะโดน

| คำถาม | ตอบสั้นๆ | หน้า |
| --- | --- | --- |
| ทำไมไม่ใส่ C13 | COUT ของ LDO รับรอง 1–10 µF · 470 µF เกิน 47 เท่า · DevKit มี 10 µF แล้ว | 5 |
| ทำไมปุ่มต้องเปิด pull-up ภายใน | บอร์ดไม่มี pull-up ภายนอก ขาจะลอย · ปุ่มต่อลงกราวด์ กดแล้วเป็น 0 | 6 |
| R10 100 kΩ มีไว้ทำอะไร | pull-down ที่ gate ของ Q1 กัน buzzer ดังเองตอนบูต | 6 |
| ทำไม I²C ไม่ใช้ pull-up ภายใน | 45 kΩ อ่อนเกินสำหรับ rise time · มี 4.7 kΩ ภายนอกแล้ว | 6 |
| D1 มีไว้ทำอะไร กลับด้านได้ไหม | flyback ของ buzzer · กลับด้านแล้ว 3.3 V ลัดลง drain Q1 ไดโอดไหม้ | 7 |
| ทำไม BOM เขียน N8R8 และ C1 470 µF | footprint ซ็อกเก็ตเดียวกัน ใช้ N16R8 จริง · C1 ใส่จริง 220 µF | 7 |
| 4.59 V พอสำหรับ PMS7003 ไหม | ใกล้ค่าต่ำสุด ต้องเปิด manual หัวข้อ Technical Index ยืนยัน | 7 |
| ทำไมต้องมี test point | วัดรางไฟและสายสัญญาณตอนขึ้นบอร์ดโดยไม่ต้องจิ้มขาชิป | 7 |
| volatile พอไหม | ไม่พอ ใช้ queue ซึ่งคัดลอกทั้งก้อนใน critical section | 9 |
| หน้าเว็บช้าจะลากการอ่านเซนเซอร์ไหม | ไม่ web task prio 2 รับค่าจาก mailbox ที่ไม่บล็อก | 8 · 14 |
| ถ้า Wi-Fi พัง CO ยังเตือนไหม | ยังเตือน เส้นทาง CO ไม่พึ่ง Wi-Fi/SD/ML และเริ่มก่อนทุกอย่าง (โชว์ได้ใน demo ช่วง 8:00) | 13 |
| ทำไมในห้องนี้ไฟแดงค้าง | RH ห้องต่ำกว่าตอนเทรน ~6–7 SD · ห้าม normalize ใหม่บนบอร์ด เพราะจะกลบความผิดปกติที่ค่อยๆ ไต่ | 18 · demo |
| บนบอร์ดได้ผลเหมือนตอนเทรนไหม | test 42,103 แถว ตัดสินต่างกัน 0 แถว (ยืนยันกับรายงาน P3 ก่อนตอบ) | ภาคผนวก Creative 2 |
| ใช้ ADC / PWM ไหม | ไม่ได้ใช้ เซนเซอร์ส่งค่าดิจิทัล · LED/buzzer แค่เปิดปิด | 12 |
| ทำไม SD ใช้ไม่ได้ | ปัญหากลไก การ์ดเสียบได้ครึ่งใบในทุกโมดูล → บันทึกผ่าน USB | 7 · 12 |
