Sh080205/AirGuard/hardware/frame/enclosure_viewer.html

# AirGuard-S3 Enclosure

แบบอ้างอิงก่อนวัดจริง · จาก airguard_enclosure.scad กล่องนอก 174 × 107 × 43 mm (ค่าร่าง)

มุมเฉียง หน้า ซ้าย หลัง บน

ปิดฝา ยกฝา ซ่อนฝา

มองทะลุ ชิ้นภายใน ชื่อ

สี งาช้าง เทาอุ่น เสจ งาช้าง + ฝาไม้

แบบอ้างอิง ค่าที่ต้องวัด
