Sh080205/AirGuard/hardware/frame/frame_viewer.html

# AirGuard-S3 · Open frame

ร่างจาก airguard_frame.scad · บอร์ดจาก DXF 3 ต.ค. 2569

ชิ้นพิมพ์ (พิมพ์รวมเป็นชิ้นเดียว) ชิ้นจริงที่นำมาวาง เขตห้ามโลหะรอบเสาอากาศ ลมเข้า ลมออก

มุมเฉียง บน หน้า ซ้าย (ช่องลม)

ชิ้นจริง ชื่อ ทางลม เสาอากาศ

ยกชิ้นจริงขึ้น

ลาก = หมุน · ขวา/สองนิ้ว = เลื่อน · ล้อ = ซูม · คลิกป้าย = ดูรายละเอียด

อะไรอยู่ตรงไหน ประกอบทีละขั้น
