Sh080205/AirGuard/data/README.md

# data

> 🔴 รูปแบบไฟล์เป็น **สัญญาระหว่างคน B กับคน C** — นิยามเต็มอยู่ใน [`../CLAUDE.md`](../CLAUDE.md) §7
> เปลี่ยนโดยไม่ตกลงกันทั้งสองฝั่ง = ข้อมูลเก่าใช้ไม่ได้ ต้องเก็บใหม่หมด

## 🔴 อ่านก่อนใช้ชุดข้อมูล `raw/usb_train/` (ต.ค. 2569)

ชุดนี้ขึ้น git เมื่อ 1 พ.ย. 2569 เพื่อให้คน C เทรนโมเดล
🔴 **คอลัมน์ `label` ใน CSV ใช้ตัดสินเหตุการณ์ไม่ได้** — มีแค่ `normal` / `marked` ตามสัญญา §7
ground truth จริงอยู่ใน [`PROTOCOL-TRAIN-2026-10.md`](PROTOCOL-TRAIN-2026-10.md) §6 **ต้องอ่านก่อน fit**

ขอบเขตตาม §4: t1 = `2026-10-29T12:00:00+07:00` · t2 = `2026-10-30T06:00:00+07:00`

| ช่วง | แถว | ชั่วโมง | แถว `marked` |
|---|---|---|---|
| train | 315,313 | 87.60 | 3,073 (P1 นำร่อง) |
| val | 64,793 | 18.00 | 5,965 (val #1 + val #2) |
| test | 42,163 | **11.71** | **0** |

*นับจากไฟล์จริง 1 พ.ย. 2569 ไม่ใช่ค่าคาดหมาย · แถวแรก `2026-10-25T20:24:17+07:00` แถวสุดท้าย `2026-10-30T17:42:48+07:00`*

### ⚠️ 1 — กด MARK แค่ 3 เหตุการณ์ · ช่วง test ไม่มีเลย

| # | ชุด | ชนิด | เริ่ม (เวลาบอร์ด) | pm2_5 ฐาน → สูงสุด |
|---|---|---|---|---|
| P1 | train | incense | 2026-10-28 12:25:28 | 24 → 354 µg/m³ |
| 2 | val | dusting | 2026-10-29 12:27:48 | 9 → 23 µg/m³ |
| 1 | val | incense | 2026-10-29 15:07:28 | 16 → **569** µg/m³ |

🔴 **ช่วง test ไม่มีแถว `marked` แม้แถวเดียว** ⇒ วัด detection rate บน test **ไม่ได้**
วัดได้แค่ false alarm — ต้องเขียนเป็นข้อจำกัดในรายงาน

### ⚠️ 2 — U1–U5 ไม่ได้กด MARK แต่ยังเป็น `label = normal`

`ml/split.py::normal_only()` ดูแค่ label ใน CSV ⇒ แถวพวกนี้**เข้า fit** แม้ใส่ใน `events/` เป็น `other` แล้ว

| | ชุด | ช่วง | น่าจะเป็น | แถว |
|---|---|---|---|---|
| U1 | train | 26 ต.ค. ≈ 07:00–08:38 | ดูดฝุ่นทำความสะอาดบ้าน | 5,881 |
| U2 | train | 26 ต.ค. ≈ 11:07–14:10 | กวาดบ้าน | 10,980 |
| U3 | train | 26 ต.ค. ≈ 13:08–15:00 | ถูพื้น (ซ้อน U2 ถึง 14:10) | 6,721 |
| U4 | train | 27 ต.ค. ≈ 16:00–18:20 | ไม่ทราบ · คล้ายควัน pm2_5 → 206 | 8,399 |
| **U5** | **test** | **30 ต.ค. ≈ 08:38–13:38** | **น่าจะจุดธูป · pm2_5 → 456** | **17,998** |

- train: U1–U4 รวมแบบไม่นับซ้ำ = **28,260 แถว = 9.0 %** ของ train
- test: U5 = **17,998 แถว = 42.7 % ของ test** 🔴 เกือบครึ่งของช่วงวัดผล
  ⇒ ถ้าไม่จัดการ โมเดลเตือนตรงนี้จะถูกนับเป็น false alarm ทั้งที่น่าจะเป็นธูปจริง

**ต้องตัดสินใน R3** ว่าจะยอมรับเป็นข้อจำกัด หรือตัดช่วงเหล่านี้ออกจาก fit/การประเมิน (ต้องแก้โค้ด ML)
🔴 **ห้ามแก้ไฟล์ raw**

### ⚠️ 3 — val #1 ทำผิดวิธี §5

ธูปอยู่ในถ้วย วาง**ต่ำกว่าเครื่องเกือบติดบอร์ด** ไม่ใช่ห่าง 1 m ระดับเดียวกันตาม §5
→ pm2_5 พุ่งถึง 569 µg/m³ สูงสุดในสามรอบ ทั้งที่เป็นธูป 1 ดอกเหมือน P1 (354 µg/m³)
ลำดับยังสลับกับตาราง (ทำหลัง val #2) — **ตัดสินใน R3 ว่าจะใช้วัดผลหรือไม่**

### ⚠️ 4 — ช่วง test สั้นกว่าแผน 4 ชม. 17 นาที

§4 กำหนดจบ `2026-10-30T22:00:00+07:00` แต่แถวสุดท้ายคือ `2026-10-30T17:42:48+07:00`
⇒ test ได้ **11.71 ชม. ไม่ใช่ 16 ชม.** *(สาเหตุที่ logger หยุดก่อนเวลา `[ต้องถามคนเก็บข้อมูล]`)*
หัก U5 ออกแล้วเหลือช่วงที่ใช้วัดได้จริง **≈ 6.7 ชม.** — รวมกับ ⚠️ 1 แปลว่า
**ช่วง test ประเมินได้แค่ false alarm บน 6.7 ชม. ที่ไม่มีเหตุการณ์ยืนยัน**

---

## โฟลเดอร์

| | เนื้อหา | ขึ้น git ไหม |
|---|---|---|
| `raw/` | CSV ดิบจาก microSD 1 แถว/วินาที | ⚠️ เฉพาะ `raw/usb_train/` (ชุดเทรน ต.ค. 2026 · รวม serial log) · ชุดอื่น ❌ ใหญ่เกิน |
| `processed/` | ข้อมูลที่ทำความสะอาด + ทำ feature แล้ว | ⚠️ เฉพาะ `processed/qa/` (รายงาน QA ชุดเทรน ต.ค. 2026) · ที่เหลือ ❌ สร้างใหม่ได้ |
| `events/` | บันทึกเหตุการณ์ที่กดปุ่ม MARK | ✅ **เล็กและสำคัญที่สุด** |

## ทำไม `events/` ต้องขึ้น git

มันคือ **ground truth** — ไฟล์เดียวที่สร้างใหม่ไม่ได้ถ้าหาย
ข้อมูลดิบเก็บใหม่ได้ แต่ "ตอน 14:32 มีคนจุดธูป" ย้อนกลับไปบันทึกไม่ได้

## รูปแบบไฟล์ raw

ชื่อไฟล์ `AG_YYYYMMDD_HHMMSS.csv` — ขึ้นไฟล์ใหม่ทุกวันหรือทุกครั้งที่บูต

```csv
timestamp_iso,pm1_0,pm2_5,pm10,temp_c,humidity_pct,tvoc_ppb,eco2_ppm,co_ppm,label
2026-09-23T14:30:00+07:00,8,12,15,28.4,62.1,145,520,0.4,normal
2026-09-23T14:30:01+07:00,9,13,16,28.4,62.0,148,524,0.4,normal
2026-09-23T14:32:10+07:00,45,118,142,28.9,61.2,890,1240,0.6,marked
```

**ค่าที่หายไป → เว้นว่าง** ไม่ใช่ `0` หรือ `-1`
เพราะ `0` เป็นค่าที่เป็นไปได้จริง แยกไม่ออกจาก "อ่านไม่ได้"

## รูปแบบไฟล์ events

```csv
start_iso,end_iso,label,note
2026-09-23T14:32:05+07:00,2026-09-23T14:41:00+07:00,incense,จุดธูป 1 ดอก ห่าง 2 m ปิดหน้าต่าง
```

🔑 **จดบริบทใน `note` ให้ละเอียด** — ระยะห่าง หน้าต่างเปิด/ปิด พัดลมทำงานไหม
ตอนวิเคราะห์ว่าทำไมบาง event จับไม่ได้ ข้อมูลตรงนี้คือคำตอบ

## โปรโตคอลเก็บข้อมูล

1. วางเครื่อง**ที่เดิมทุกครั้ง** สูงจากพื้น 1.0–1.5 m ห่างหน้าต่าง/ประตู/แอร์
2. เก็บช่วงปกติให้ได้**อย่างน้อย 3 วันต่อเนื่อง**ก่อนเริ่มสร้าง anomaly
   *(ต้องมีข้อมูลปกติเยอะพอให้โมเดลเรียนก่อน)*
3. สร้าง anomaly → **กดปุ่ม MARK ตอนเริ่ม** → ทำ → **กด MARK อีกครั้งตอนจบ**
   คอลัมน์ `label` ใน raw = `marked` ระหว่างสองครั้งนั้น · เฟิร์มแวร์เขียนเวลาเริ่ม/จบลง `EV_*.csv` บน SD ให้ (label = `marked`, note ว่าง)
4. จดลง `events/` ทันที อย่ารอ
