Sh080205/AirGuard/data/raw/usb_train/README.md

# ชุดข้อมูลเทรน ต.ค. 2569

เก็บ 2026-10-25 20:24:17 → 2026-10-30 17:42:48 (+07:00) · 1 แถว/วินาที · 422,269 แถว
เก็บ**นอกกล่อง** ENS160 เปิด · เฟิร์มแวร์ `cea807f` · ผ่าน serial mirror ไม่ใช่ SD

| ไฟล์ | คืออะไร |
|---|---|
| `AG_*.csv` | ข้อมูลเซนเซอร์ ตามสัญญา §7 ของ `CLAUDE.md` |
| `EV_*.csv` | เวลาเริ่ม/จบที่เฟิร์มแวร์เขียนตอนกด MARK |
| `serial_*.log` | USB capture ดิบที่ตัด `AG_*.csv` ออกมา · 422,269 บรรทัด `AGCSV,` ซ้ำกับ CSV ทั้งหมด + log ของ ESP-IDF อีก 287,404 บรรทัด (ส่วนใหญ่คือ SD mount ไม่ขึ้น) · **ไม่ต้องใช้ตอนเทรน** |

## 🔴 ก่อนเทรน อ่าน 4 ข้อนี้ก่อน

คำเตือนเต็มพร้อมตัวเลขอยู่ที่ [`../../README.md`](../../README.md) — สรุปสั้น:

1. **`label` ใช้ตัดสินเหตุการณ์ไม่ได้** มีแค่ `normal` / `marked` · ground truth อยู่ใน [`../../PROTOCOL-TRAIN-2026-10.md`](../../PROTOCOL-TRAIN-2026-10.md) §6
2. **U1–U5 ไม่ได้กด MARK แต่ยังเป็น `normal`** → กินอยู่ 9.0 % ของ train และ **42.7 % ของ test**
3. **val #1 ทำผิดวิธี §5** (วางธูปต่ำกว่าเครื่องเกือบติดบอร์ด)
4. **test สั้นกว่าแผน 4 ชม. 17 นาที และไม่มีแถว `marked` เลย**

🔴 **ห้ามแก้ไฟล์ในโฟลเดอร์นี้** — ถ้าต้องตัดช่วงไหนออก ให้ทำในโค้ด ML
🔴 **ห้ามใช้คู่กับ `AG_*.csv` จาก SD ของช่วงเวลาเดียวกัน** (`ml.load` error เพราะ timestamp ซ้ำ)
🔴 **โมเดลจากชุดนี้ห้ามใช้กับเครื่องตอนอยู่ในกล่องโดยไม่เทรนใหม่** (ข้อตัดสิน 23 ต.ค. · `CLAUDE.md` §10)
