Sh080205/AirGuard/data/PROTOCOL-TRAIN-2026-10.md

# โปรโตคอลเก็บข้อมูลเทรนและทำเหตุการณ์ — ต.ค. 2569

> **24 ต.ค. 2569 · เจ้าของโปรเจกต์อนุมัติ §2 §3 §4 §5 แล้ว · เหลือกรอกค่าสุดท้ายหลังรอบนำร่อง (§8 แถวสุดท้าย) ก่อนเหตุการณ์ val ครั้งแรก** (R1 ใน `docs/10-ML-REAL-DATA-PROMPTS.md`)
> **แก้ 25 ต.ค. 2569:** การเก็บที่เครื่องเจ้าของ (24 ต.ค.) ได้แค่ 42 นาทีและคนละสถานที่ → **เริ่มเก็บใหม่ที่เครื่องคนเก็บข้อมูล 25 ต.ค. 20:24:17** · ปฏิทิน §4/§5 เดิมคิดจาก "เริ่ม 24 ต.ค. 12:00" จึง**ยกเลิก** · **ล็อกปฏิทินใหม่ 25 ต.ค. (แบบ ข):** ช่วงปกติถึง **t1 = 29 ต.ค. 12:00** · val ถึง **t2 = 30 ต.ค. 06:00** · test **จบ 30 ต.ค. 22:00** — ความยาว val 18 / test 16 ชม. เท่าฉบับ 24 ต.ค. เลื่อนไป 2 วัน · §2 §3 และวิธีทำเหตุการณ์ใน §5 **ไม่เปลี่ยน**
> ตัวเลขทุกตัวในไฟล์นี้เป็น**ข้อเสนอ / ค่าคาดหมาย ต้องยืนยันด้วยการวัด** ไม่ใช่ค่าที่วัดแล้ว
> หลังอนุมัติแล้ว**ห้ามเปลี่ยนคำศัพท์และ mapping** จนจบ R4

---

## 1. สภาพที่ต้องคงไว้ตลอด (จาก CLAUDE.md §10 · 23 ต.ค.)

- เครื่อง**นอกกล่อง** · ENS160 เปิด · เฟิร์มแวร์ `cea807f` · **ห้าม flash จนจบการเก็บ**
- วางที่เดิม ทิศเดิม ตลอด train/val/test — ถ่ายรูปตำแหน่งไว้ และจดลงตารางข้างล่าง
- logger: `python tools\serial_logger.py --port <COM> --out ..\data\raw\usb_train` (ค่าเริ่มต้นของ logger คือ `data/raw/usb/` — **ต้องใส่ `--out`**)
- โน้ตบุ๊กห้ามพัก/รีสตาร์ท · ห้ามรัน `idf.py monitor` (logger ถือพอร์ตอยู่)
- ตรวจคุณภาพทุกเช้า: `python -m ml.qa --raw "data/raw/usb_train/AG_*_usb.csv" --out data/processed/qa/<วันที่>`

| รายการ | ค่าจริง (กรอก) |
|---|---|
| เวลาเริ่มเก็บ (แถวแรกใน `AG_*_usb.csv`) | **`2026-10-25T20:24:17+07:00`** · ไฟล์แรก `AG_20261025_202417_usb.csv` · logger เริ่ม 20:24:16 |
| เฟิร์มแวร์ที่ใช้เก็บ | build จาก `main` @ `01dbcd2` ซึ่ง `firmware/` **ตรงกับ `cea807f` ทุกไบต์** (`git diff cea807f 01dbcd2 -- firmware` ว่าง · ตรวจ 25 ต.ค.) · ESP-IDF v5.5.5 · มี `secrets.h` (Wi-Fi บ้านคนเก็บ · `AIRGUARD_HAVE_SECRETS=1`) · build 0 warning · `0xe6cd0` B · flash 25 ต.ค. ~19:52 |
| เครื่องที่รัน logger | โน้ตบุ๊กคนเก็บข้อมูล · เสียบปลั๊กตลอด · ไม่ขยับ · พอร์ต `COM4` (USB-Serial/JTAG `303A:1001`) · หน้าต่าง cmd "AirGuard logger - DO NOT CLOSE" · sleep ตอนเสียบปลั๊ก = Never · Windows Update หยุดถึง 31 ต.ค. |
| ตรวจนาทีแรก (25 ต.ค. 20:24–20:25) | 83 แถว ขาด 0 วินาที · ทุกคอลัมน์มีค่า · `pms frames=346 err=0` · `aht trig_err=0 read_err=0 crc_err=0` · `rows w/o T/RH=0` · ENS160 normal `i2c=0 misr=0` · ZE07 อุ่นเครื่องเสร็จ |
| เหตุก่อนเริ่ม (ไม่อยู่ในข้อมูลเทรน) | 25 ต.ค. ~20:00 สายข้อมูล PMS7003 หลุด (`pms frames=0 err=0` พัดลมยังหมุน) → **บัดกรีใหม่** แล้วได้ 57 เฟรม/นาที · ระหว่างหาสาเหตุมี I²C error 76 ครั้ง (ขยับสาย J3) และ CO FAULT 1 ครั้ง · ทั้งหมดเกิด**ก่อน**แถวแรกของชุดนี้ |
| ตำแหน่ง · ความสูงจากพื้น · ห่างหน้าต่าง/ประตู/แอร์ | |
| ห่างจากครัว (สำหรับเหตุการณ์ทำอาหาร) | |
| รูปตำแหน่ง (ชื่อไฟล์) | |

---

## 2. คำศัพท์เหตุการณ์และ mapping

| label | ความหมาย | ใช้วัดผลเป็น | แบบใน `ml/README.md` |
|---|---|---|---|
| `incense` | จุดธูป | **anomaly** | ก. พุ่งทีเดียว (PM↑ แต่ T/RH ไม่ขึ้นตาม) |
| `dusting` | ปัดฝุ่น / สะบัดผ้า | **anomaly** | ค. ความสัมพันธ์ขาด — **เหตุผลหลักของโปรเจกต์** |
| `cooking` | ทำอาหาร | **normal** | PM + T + RH ขึ้นด้วยกัน (§1 CLAUDE.md) |
| `other` | อะไรก็ได้ที่ไม่ได้วางแผน แต่อาจกระทบอากาศ (เปิดหน้าต่าง · พัดลม · สเปรย์ · คนกวาดบ้าน) | **unknown** (ไม่นับทั้งถูกและผิด) | — |

```
--mapping "incense=anomaly,dusting=anomaly,cooking=normal,other=unknown"
```

- **คำศัพท์ปิด 4 คำนี้เท่านั้น** (ตรงกับ `DEFAULT_ALLOWED` ใน `ml/events.py` → `ml.events check` ไม่ต้องใส่ `--allowed`) · เหตุการณ์นอกแผนทุกชนิดใช้ `other` แล้วเขียนรายละเอียดใน note · ห้ามเพิ่มชื่อใหม่หลังอนุมัติ
- ทำไม `other` = unknown ไม่ใช่ normal: ยังไม่รู้ว่าอากาศช่วงนั้นผิดปกติจริงหรือไม่ · unknown ถูกตัดออกจากตัวหารทุกตัว และ alarm ที่เริ่มในช่วงนี้ถูกเก็บแยกเป็น `unscored_alarm_episodes` (`ml/METRICS.md`) จึงไม่ทำให้ผลดีหรือแย่เกินจริง
- ทำไม `cooking` = normal: นี่คือข้ออ้างหลักของโปรเจกต์ (CLAUDE.md §1) · alarm ที่เริ่มระหว่างทำอาหารนับเป็น**เตือนผิด** — ถ้าโมเดลเตือนตอนทำอาหาร ผลต้องแย่ลง ไม่ใช่ถูกซ่อน

แบบ ข. (ค่อยๆ ไต่ เช่น CO₂ สะสมในห้องปิด) **ไม่ทดสอบบนข้อมูลจริงรอบนี้** — ชุด `pm_th` ไม่มีคอลัมน์ที่ตอบสนองต่อ CO₂ · หลักฐานแบบ ข. มีเฉพาะข้อมูลสังเคราะห์ใน ML-3 → เขียนเป็นข้อจำกัด

---

## 3. 🔴 ต้องตัดสินก่อนเริ่มเก็บ: กด MARK ตอนทำอาหารช่วง train ไหม

ข้อเท็จจริงในโค้ด: `ml/split.py::normal_only()` ใช้เฉพาะแถว `label == normal` ตอน fit → **แถว marked ไม่ถูกใช้ fit**

| ทาง | ทำอะไร | ข้อดี | ข้อเสีย |
|---|---|---|---|
| **ก. (เสนอ)** | ช่วง train **ไม่กด** MARK ตอนทำอาหาร · จดเวลาโดยประมาณลงใบจด แล้วใส่ใน events เป็น `cooking` (ไม่มี MARK คู่) · ช่วง val/test **กด** ตามปกติ | ไม่ต้องแก้โค้ด · โมเดลได้เห็นการทำอาหารตอน fit (ตรงกับข้ออ้างว่า "ทำอาหาร = ปกติ") | เวลาในช่วง train ไม่แม่น (ไม่กระทบผลเพราะ train ไม่ถูกวัดผล) |
| ข. | กด MARK ทุกครั้ง | ground truth แม่นทุกช่วง | การทำอาหารไม่อยู่ใน fit → อาจเตือนผิดตอนทำอาหารใน val/test มากขึ้น |
| ค. | กด MARK ทุกครั้ง + แก้ `normal_only()` ให้รวมช่วงที่ events map เป็น normal | แม่นและอยู่ใน fit | **เปลี่ยนพฤติกรรม ML-1** ที่มี test บังคับอยู่ · ต้องเขียน/รีวิวโค้ดเพิ่มในช่วงเวลาที่เหลือน้อย |

**ข้อตัดสิน:** ✅ **ก** — เจ้าของโปรเจกต์ 24 ต.ค. 2569 (ช่วง train ไม่กด MARK ตอนทำอาหาร · ช่วง val/test กด)

ไม่ว่าเลือกทางไหน: ช่วง train ถ้ามีเหตุการณ์อื่น (`other` / ใครจุดธูป / กวาดบ้าน) **ให้กด MARK** เพื่อไม่ให้แถวนั้นเข้า fit

---

## 4. ช่วง train / val / test

| | ช่วง | ค่า (ใส่ใน `--t1` / `--t2` รูปแบบ `2026-10-DDTHH:MM:SS+07:00`) |
|---|---|---|
| train | เริ่มเก็บ `2026-10-25T20:24:17+07:00` → t1 | **t1 = `2026-10-29T12:00:00+07:00`** · **87.6 ชม.** (3 วัน 15 ชม. 36 นาที · ก่อนตัดแถว marked ของรอบนำร่อง) · ช่วงปกติยาวต่อเนื่อง |
| val | t1 + gap → t2 | **t2 = `2026-10-30T06:00:00+07:00`** · **18 ชม.** มีกลางคืน 1 คืน |
| test | t2 + gap → จบการเก็บ | **จบ `2026-10-30T22:00:00+07:00`** · **16 ชม.** · หยุด logger (Ctrl+C) หลังเวลานี้ |
| gap | | **`--gap-s 60`** (ค่าเริ่มต้นของ `ml.baseline` และ `ml.events check`) |

> ~~ค่าเดิม 24 ต.ค.: t1 `2026-10-27T12:00:00+07:00` · t2 `2026-10-28T06:00:00+07:00` · จบ `2026-10-28T22:00:00+07:00`~~ — คิดจากเริ่มเก็บ 24 ต.ค. 12:00 ซึ่งไม่ได้เกิดขึ้น · ยกเลิก 25 ต.ค.

**กติกา**
- **ทำไมปฏิทินนี้ (แบบ ข · เลือก 25 ต.ค.):** ได้ช่วงปกติยาวที่สุด (≈ 3.6 วัน) และยังจบการเก็บ **30 ต.ค. 22:00** ซึ่งเหลือ 31 ต.ค.–1 พ.ย. สำหรับ R3–R5 · flash FW-6 + FW-7 + ทดสอบบนบอร์ด (B1–B10 ใน `FW-6.md` §12.8) · ประกอบกล่อง · สไลด์ ก่อนส่งงานประมาณ **2 พ.ย.** (`docs/tasks/HANDOFF.md`) · ความยาว val 18 / test 16 ชม. เท่าฉบับที่เจ้าของอนุมัติ 24 ต.ค. จึงรับข้อจำกัดเรื่อง FA/วัน (ข้างล่าง) แบบเดียวกัน
- ทางที่ไม่เลือก: **แบบ ก** (t1 28 ต.ค. 12:00 · val 30 ชม. · test 26 ชม. · จบ 30 ต.ค. 20:00) ประเมินละเอียดกว่าแต่ช่วงปกติสั้นกว่า 1 วัน · **ปกติ 5 วันแล้วค่อยทำเหตุการณ์** จบราว 1 พ.ย. ค่ำ ไม่เหลือเวลาก่อนส่ง
- **ห้ามเลื่อน t1/t2 หลังเหตุการณ์ val ครั้งแรก** · ถ้า train ที่ใช้ได้จริง (หลังตัดแถว marked และช่องว่าง ดูจาก `ml.qa`) **< 48 ชม.** ให้หยุดตัดสินใหม่ใน R3 (48 ชม. เป็นข้อเสนอ ไม่ใช่ค่าจากเอกสาร · ค่าคาดหมายตอนนี้ ≈ 84 ชม. หลังตัดรอบนำร่อง ต้องยืนยันด้วย `ml.qa`)
- **freeze t1 ใน R3 ก่อนเริ่มเหตุการณ์ val** (เลื่อนได้เฉพาะก่อนเหตุการณ์ val ครั้งแรก)
- **ทำไม gap 60 s พอ:** ฟีเจอร์ `pm_th` เป็นค่ารายแถว ไม่มีหน้าต่างเวลา · สิ่งเดียวที่ข้ามแถวคือ persistence (`rolling(k).min()` ใน `ml/baseline.py` · k สูงสุด 10 แถว ≈ 10 s) → 60 s ยาวกว่า 6 เท่า สถานะ alarm จากชุดหนึ่งจึงไหลข้ามขอบไปอีกชุดไม่ได้ · ยาวกว่านี้ก็แค่เสียแถวเปล่าๆ
- ทุกเหตุการณ์ต้อง**อยู่ห่างจาก t1/t2 อย่างน้อย 30 นาที** (กติกาของทีม ไม่ใช่ข้อจำกัดของโค้ด — เผื่อกรณี MARK ครั้งที่สองช้ากว่าแผน) · `baseline` error ถ้าเหตุการณ์คร่อมขอบหรือแตะ gap · ตรวจล่วงหน้าด้วย `ml.events check --t1 ... --t2 ...`
  - เหตุการณ์ val ต้องเริ่มหลัง **29 ต.ค. 12:30** และกดจบก่อน **30 ต.ค. 05:30**
  - เหตุการณ์ test ต้องเริ่มหลัง **30 ต.ค. 06:30** และกดจบก่อน **30 ต.ค. 21:30**

**งบเตือนผิดบน val/test — ผลของ val 18 ชม. (ข้อจำกัดที่รับไว้)**
ML-3 ไล่ threshold ลงจนกว่า false alarm episodes/วันบน val จะ **> 1** แล้วเก็บ threshold ต่ำสุดก่อนเกินงบ (`ml/BASELINE.md` §4) โดยใช้สูตร
`FA/วัน = จำนวน episode × 86400 / normal_observed_s` (`ml/METRICS.md`)
- เตือนผิด 1 episode บน val = `86400 / normal_val_s` ครั้ง/วัน → **≤ 1 ก็ต่อเมื่อ normal บน val ≥ 24 ชม.**
- normal บน val ≈ ความยาว val − เวลาเหตุการณ์ anomaly (4 ครั้ง × ≈ 1 ชม. · cooking นับเป็น normal · ค่าคาดหมาย ต้องยืนยันด้วยการวัด)
  - **ปฏิทินที่ล็อก: val 18 ชม.** → normal ≈ 14 ชม. → 1 episode ≈ 1.7/วัน **> 1** ⇒ threshold ที่ได้คือ threshold ต่ำสุดที่ **ไม่มีเตือนผิดเลยบน val** → สูงกว่ากรณี val ยาว · detection rate อาจต่ำลง → **เขียนเป็นข้อจำกัดในรายงาน**
  - (เทียบ: val 30 ชม. → normal ≈ 26 ชม. → 1 episode ≈ 0.92/วัน ≤ 1 ⇒ ยอมเตือนผิดได้ 1 episode — คือแบบ ก ที่ไม่ได้เลือก)
- test 16 ชม. → normal ≈ 12 ชม. → ความละเอียด FA/วัน ≈ 2 ครั้ง/วันต่อ 1 episode → ตัวเลข FA/วันหยาบมาก → **รายงานจำนวน episode ดิบคู่กับ FA/วันเสมอ**
- detection rate: anomaly 4 ครั้งต่อชุด → ค่าที่เป็นไปได้มีแค่ 0/25/50/75/100 % → ต้องรายงาน `detected/event_count` คู่กันเสมอ

---

## 5. เหตุการณ์ต่อชุด

| ชนิด | val | test | วิธีทำ (ให้ทำซ้ำได้) |
|---|---|---|---|
| `incense` | **2** | **2** | ธูป **1 ดอก จากห่อเดียวกันทุกครั้ง** · วางห่างเครื่อง **1.0 m** ระดับความสูงเดียวกับเครื่อง ไม่อยู่ในทางลมแอร์/พัดลม · จุดไว้ **5 นาที** แล้วดับ (จุ่มน้ำ) และนำออกนอกห้อง · จดเวลาดับใน note |
| `dusting` | **2** | **2** | **แหล่งฝุ่นเดิมทุกครั้ง** (เช่น ผ้าเช็ดเท้าผืนเดียวกัน ไม่ซักระหว่างทดลอง) · สะบัดห่างเครื่อง **50 cm** นาน **2 นาที** · ยืนหันข้าง ไม่หายใจใส่เครื่อง · **ห้ามมีแหล่งความร้อน/ไอน้ำ · ห้ามเปิดพัดลม** |
| `cooking` | **≥ 1 · กด MARK** | **≥ 1 · กด MARK** | มื้อจริงที่มีควัน/ไอน้ำ (ผัด · ทอด · ต้ม) · ครัวที่เดิม ประตูครัวเปิดเหมือนกันทุกครั้ง · จดเมนูและระยะครัว–เครื่องใน note |

**ทำไมตัวเลขนี้**
- **2 + 2 ต่อชุด:** เวลาที่มีในหนึ่งวัน (§4) ใส่ได้ประมาณ 5 ช่อง ช่องละ ≈ 2 ชม. (ข้างล่าง) · จำนวนต่อชุด**ตายตัว** ไม่เพิ่ม/ไม่ทำซ้ำใน test เพราะผลออกมาไม่สวย — เหตุการณ์ที่ PM2.5 ไม่ขึ้นชัดให้จด note แล้วเก็บไว้ตามเดิม (ไม่อย่างนั้นคือการเลือกข้อมูล test)
- **ธูป 1 m · 5 นาที / ฝุ่น 50 cm · 2 นาที:** ตั้งให้ PM2.5 ขึ้นชัดแต่ไม่ชนเพดานช่วงวัดของ PMS7003 `[ต้องเปิด PMS7003 manual หัวข้อ Technical Index]` · ฝุ่นต้องใกล้กว่าเพราะอนุภาคใหญ่ตกเร็ว · ทั้งหมดเป็น**ค่าคาดหมาย ต้องยืนยันด้วยรอบนำร่องข้างล่าง**
- **ห้ามคนอยู่ใกล้/หายใจใส่เครื่องตอนปัดฝุ่น:** ไอร้อนและความชื้นจากตัวคนทำให้ T/RH ขยับตาม PM → เหตุการณ์ "ความสัมพันธ์ขาด" จะดูเหมือนทำอาหาร และวัดสิ่งที่โปรเจกต์อ้างไม่ได้
- **cooking ต้องมีใน val/test และกด MARK:** ถ้าไม่มี จะวัดไม่ได้ว่าโมเดลเตือนผิดตอนทำอาหารหรือไม่ ซึ่งเป็นข้ออ้างหลัก · ถ้าดูจากรูป `ml.qa` แล้ว PM2.5 ไม่ขึ้นเลย ผล "ไม่เตือนตอนทำอาหาร" ของครั้งนั้นไม่มีความหมาย — ต้องเขียนไว้
- **ช่วง train (ทาง ก §3):** ทำอาหารตามปกติ**อย่างน้อยวันละ 1 มื้อที่ครัวเดิม** ไม่กด MARK · จดเวลาโดยประมาณ → โมเดลได้เห็นการทำอาหารตอน fit

**รอบนำร่องในช่วง train (วันไหนก็ได้ 26–28 ต.ค. · ต้องเสร็จก่อนเหตุการณ์ val ครั้งแรก 29 ต.ค. 13:00 · เดิม 25 ต.ค.)** — `incense` 1 ครั้ง + `dusting` 1 ครั้ง ด้วยวิธีในตาราง · **กด MARK** และใส่ชื่อใน events ตามปกติ (แถว marked ไม่ถูกใช้ fit · train ไม่ถูกวัดผล จึงไม่กระทบตัวเลข) ใช้ตอบ 3 ข้อ:
1. PM2.5 สูงสุดเท่าไร — ถ้าชนเพดานช่วงวัด ให้เพิ่มระยะ · ถ้าขึ้นน้อยกว่า ≈ 2 เท่าของค่าฐาน ให้ลดระยะ (เกณฑ์ 2 เท่าเป็นข้อเสนอ)
2. ใช้เวลากี่นาทีกว่าจะกลับฐาน → ตั้งเพดานความยาวเหตุการณ์และช่องเวลาจริง
3. ตอนปัดฝุ่น `temp_c`/`humidity_pct` นิ่งจริงไหม — ถ้าขยับ ต้องแก้วิธีทำก่อนเริ่ม val

ปรับระยะ/เวลาได้**เฉพาะก่อนเหตุการณ์ val ครั้งแรก** แล้วจดค่าสุดท้ายลง §8 · หลังจากนั้นห้ามเปลี่ยน

**จังหวะ (ค่าคาดหมาย ปรับได้หลังรอบนำร่อง):**
- ก่อนเริ่มแต่ละครั้ง จด **pm2_5 ฐาน** (ค่าจาก 3 แถวล่าสุด) ลงใบจด
- กด MARK ครั้งที่สองเมื่อ **pm2_5 ≤ ฐาน + 5 µg/m³ ติดกันราว 1 นาที** หรือครบ **90 นาทีหลังเริ่ม** (อันไหนถึงก่อน · ถ้าครบ 90 นาทีให้จดใน note)
- เริ่มเหตุการณ์ถัดไปได้เมื่อ **MARK ครั้งที่สองผ่านไปแล้ว ≥ 30 นาที** — ให้มีช่วงปกติคั่น alarm จะได้จบ episode ก่อนเหตุการณ์ใหม่
- สลับชนิด อย่าทำชนิดเดียวกันติดกัน · ลำดับใน val และ test เหมือนกัน

**ตารางเวลาที่เสนอ** (เลื่อนได้ตามตารางสอบ ตราบที่ยังอยู่ในกรอบ §4 และเว้นระยะตามข้างบน · ลำดับห้ามเปลี่ยน)

**ล็อก 25 ต.ค.** (เลื่อนเวลาในวันได้ตามสะดวก ตราบที่ยังอยู่ในกรอบ §4 และเว้นระยะตามข้างบน · **ลำดับห้ามเปลี่ยน** · ตารางรูปเดียวกับฉบับ 24 ต.ค. เลื่อนไป 2 วัน)

| ชุด | ~เวลาเริ่ม | ชนิด |
|---|---|---|
| train | **26–28 ต.ค.** ช่วงกลางวัน (วันใดวันหนึ่ง) | `incense` นำร่อง → ≥ 2 ชม. → `dusting` นำร่อง |
| val | **29 ต.ค. (พฤ.) 13:00 · 15:00** | `incense` · `dusting` |
| val | **29 ต.ค. ~18:00** (มื้อเย็น) | `cooking` |
| val | **29 ต.ค. 20:00 · 22:00** | `incense` · `dusting` (กดจบก่อน **30 ต.ค. 05:30**) |
| test | **30 ต.ค. (ศ.) 08:00 · 10:00** | `incense` · `dusting` |
| test | **30 ต.ค. ~12:00** (มื้อกลางวัน) | `cooking` |
| test | **30 ต.ค. 14:00 · 16:00** | `incense` · `dusting` (กดจบก่อน **30 ต.ค. 21:30**) |

> ~~ตารางเดิม 24 ต.ค.: นำร่อง 25 ต.ค. · val 27 ต.ค. 13:00–22:00 · test 28 ต.ค. 08:00–16:00~~

ต้องมีคนอยู่กดปุ่มทุกครั้ง · ไม่ทำเหตุการณ์ตอนนอน
- **ตอนนี้ถึง 29 ต.ค. 12:00 = ช่วง train** (ทาง ก §3): ทำอาหาร**ไม่กด** MARK แต่จดเวลาคร่าว ๆ · เหตุการณ์อื่นที่ไม่ได้วางแผน (คนกวาดบ้าน · เปิดหน้าต่าง · สเปรย์) **กด MARK**
- **มื้ออื่นที่ทำอาหารในช่วง val/test (นอกตาราง) ให้กด MARK ด้วย** แล้วใส่ใน events เป็น `cooking` · ต้องห่างเหตุการณ์อื่น ≥ 30 นาที — ไม่อย่างนั้นแถวทำอาหารจะเป็น `normal` ที่ไม่มีใครรู้ว่าทำอาหาร และวัดข้ออ้างหลักไม่ได้
- ดูค่าล่าสุดได้จาก PowerShell:
  ```powershell
  Get-ChildItem data\raw\usb_train\AG_*_usb.csv | Sort-Object LastWriteTime | Select-Object -Last 1 | Get-Content -Tail 3
  ```

**กด MARK เมื่อไร:**
- **ครั้งแรก:** ตอนเริ่มทำ (จุดธูป · เริ่มสะบัด · เริ่มผัด)
- **ครั้งที่สอง:** ตอน **PM2.5 กลับมาใกล้ค่าก่อนเหตุการณ์** — *ไม่ใช่*ตอนดับธูป · เหตุผล: อากาศยังผิดปกติจนฝุ่นหาย ถ้าปิดช่วงตอนดับธูป สัญญาณเตือนช่วงที่ฝุ่นยังค้างจะถูกนับเป็นเตือนผิด · จดเวลาดับธูป/หยุดสะบัดไว้ใน note
- เฟิร์มแวร์ไม่รับ MARK ถ้ายังไม่มีเวลาจริง · ตรวจว่ารับแล้วจากบรรทัด `MARK: event started` ใน `serial_*.log`
- ลืมกดครั้งที่สอง → จดเวลาจริงลงใบจดทันที แล้วกดเมื่อนึกได้ (แก้ end ใน events ภายหลังพร้อมเขียนเหตุผลใน note)

---

## 6. ใบจดเหตุการณ์ (กรอกระหว่างทำ)

| # | ชุด | ชนิด | เวลาเริ่ม (นาฬิกาโทรศัพท์) | เวลาดับ/หยุด | เวลากดจบ | กด MARK? | pm2_5 ฐาน → สูงสุด | บริบท: ระยะห่าง · ปริมาณ · หน้าต่าง/ประตู · พัดลม/แอร์ · คนในห้อง |
|---|---|---|---|---|---|---|---|---|
| P1 | train | incense (นำร่อง) | 2026-10-28 12:25:28 (เวลาบอร์ดจาก MARK #1 · ไม่ได้จดนาฬิกาโทรศัพท์) | ≈ 12:28 (ประมาณจาก pm2_5 ที่ลดฮวบ · คนเก็บข้อมูลจำเวลาไม่ได้ · จุดราว 3 นาที ไม่ถึง 5 นาทีตาม §5) | 13:16:42 (MARK #2 · 3,073 แถว marked) | ✅ ทั้งสองครั้ง | ≈ 24 → **354** µg/m³ (12:26:15) · ไม่ชนเพดานช่วงวัด | ธูป 1 ดอก ห่าง ≈ 1 m (ตามที่สั่ง · ยังไม่ได้ยืนยันกับคนเก็บข้อมูล) · pm2_5 ≤ 30 ครบ 1 นาทีตั้งแต่ 12:52 แต่กดจบ 13:16 · หน้าต่าง/พัดลม/แอร์ ยังไม่ได้จด |
| P2 | train | dusting (นำร่อง) | | | | | | |
| 1 | val | incense | 2026-10-29 15:07:28 (เวลาบอร์ด MARK #5) | ≈ 15:09:50 (คนเก็บข้อมูลดับเร็วเพราะธูปใกล้เครื่อง · ไหม้ ≈ 2.5 นาที ไม่ถึง 5 นาที) | 16:42:00 (MARK #6 · pm2_5 ≤ 21 ครบ 1 นาทีตั้งแต่ 15:49:04 แต่กดหลังครบ 90 นาที ≈ 4.5 นาที) | ✅ ทั้งสองครั้ง | ≈ 16 → **569** µg/m³ (15:08:02) · ค่าฐานก่อนคนเริ่มเตรียม (14:00–14:50) ≈ 8–9 | 🔴 **ผิดวิธี §5:** ธูปในถ้วย วาง**ต่ำกว่าเครื่อง เกือบติดบอร์ด** (ไม่ใช่ 1 m ระดับเดียวกัน) · temp_c 37.0–37.2 °C humidity_pct 51.7–52.5 % ไม่เปลี่ยน · PMS err=0 · ลำดับสลับกับตาราง (ทำหลัง #2) · ตัดสินใน R3 ว่าจะใช้วัดผลหรือไม่ |
| 2 | val | dusting | 2026-10-29 12:27:48 (เวลาบอร์ด MARK #3) | ≈ 12:30 (สะบัด 2 นาที · ประมาณจากเวลาที่สั่ง) | 12:32:39 (MARK #4 · pm2_5 ≤ 14 ครบ 1 นาที 12:32:20) | ✅ ทั้งสองครั้ง | ≈ 9 → ≈ 23 µg/m³ (pm10 ≈ 27) | สะบัดผ้าที่มีฝุ่น (ผืนนี้ต้องใช้ทุกรอบ ห้ามซัก) · ระยะยังไม่ได้ยืนยัน · humidity_pct 56.2 → 57.5 % temp_c 36.9 → 36.4 °C (คนยืนใกล้เครื่อง?) · ⚠️ ไม่ได้ทำ P2 นำร่อง — รอบนี้เริ่มหลัง t1 จึงอยู่ใน val · เริ่มก่อนกรอบ "หลัง 12:30" ของ §4 ≈ 2 นาที · ตัดสินใน R3 ว่านับเป็น val หรือนำร่อง |
| 3 | val | cooking | | | | | | |
| 4 | val | incense | | | | | | |
| 5 | val | dusting | | | | | | |
| 6 | test | incense | | | | | | |
| 7 | test | dusting | | | | | | |
| 8 | test | cooking | | | | | | |
| 9 | test | incense | | | | | | |
| 10 | test | dusting | | | | | | |

จดเหตุการณ์ที่ไม่ได้วางแผนด้วย (ทำอาหาร · เปิดหน้าต่าง · มีคนกวาดบ้าน)

**เหตุการณ์ที่ไม่ได้วางแผน (จดย้อนหลัง)**

| # | ชุด | เวลา (จากข้อมูล) | กด MARK? | ใส่ใน events เป็น | ที่มา / หลักฐาน |
|---|---|---|---|---|---|
| U1 | train | 2026-10-26 ≈ 07:00 → ≈ 08:38 (≈ 98 นาที) | ❌ ไม่ได้กด | `other` · note "ทำความสะอาดบ้าน · ดูดฝุ่น · ไม่ได้กด MARK" | คนเก็บข้อมูลแจ้ง 26 ต.ค. ว่าที่บ้านทำความสะอาด **ดูดฝุ่น** · ไม่ใช่ `dusting` เพราะไม่ได้ทำตามวิธีใน §5 (ระยะ · เวลา · คนอยู่ใกล้เครื่อง · เครื่องดูดฝุ่นมีลมร้อนจากมอเตอร์) · ข้อมูล: 07:00 TVOC 1,570 → 1,715 ppb และ RH เริ่มขึ้น · pm2_5 จาก ≈ 11 ขึ้นค้าง ≈ 17–18 µg/m³ · 08:35–08:38 pm2_5 กลับ ≈ 12 · temp_c ไต่ตามปกติของช่วงเช้า · เวลาเริ่ม/จบเป็นค่าประมาณจากข้อมูลรายนาที |
| U2 | train | 2026-10-26 ≈ 11:07 → ≈ 14:10 (≈ 183 นาที) | ❌ ไม่ได้กด | `other` · note "น่าจะกวาดบ้าน · ไม่ได้กด MARK" | คนเก็บข้อมูลแจ้ง 27 ต.ค. ว่า**น่าจะกวาดบ้าน** (จำไม่แน่) · ไม่ใช่ `dusting` ด้วยเหตุผลเดียวกับ U1 (ไม่ได้ทำตามวิธีใน §5) · ข้อมูล: 11:07–11:16 pm2_5 ≈ 23 → 44 · pm10 ≈ 24 → 53 µg/m³ ภายใน ≈ 10 นาที · temp_c คงที่ ≈ 34.8–34.9 °C · humidity_pct อยู่ในช่วง ≈ 57–60 % ตามปกติ · pm2_5 ค่อยๆ ลดลง กลับมา ≈ 23 ราว 14:10 · ช่วงนี้มี TVOC พุ่งราว 13:08 (≈ 1,100 → 2,300 ppb · pm2_5 ไม่เปลี่ยน) ซ้อนอยู่ด้วย · ดู U3 · เวลาเริ่ม/จบเป็นค่าประมาณจากข้อมูลรายนาที |
| U3 | train | 2026-10-26 ≈ 13:08 → ≈ 15:00 (≈ 112 นาที · ซ้อนกับ U2 ถึง ≈ 14:10) | ❌ ไม่ได้กด | `other` · note "น่าจะถูพื้น · ไม่ได้กด MARK" | คนเก็บข้อมูลแจ้ง 27 ต.ค. ว่า**น่าจะถูพื้น** (จำไม่แน่) · ข้อมูล: 13:08 tvoc_ppb ≈ 1,100 → สูงสุด ≈ 2,300 ราว 13:25 แล้วลดกลับ ≈ 1,090 ราว 15:00 · humidity_pct ≈ 60.2 → 61.4 % (13:08–13:20) · pm2_5 ไม่ขึ้น (ลดต่อตามหาง U2) · temp_c คงที่ ≈ 35.9 °C · tvoc_ppb ไม่อยู่ในชุดฟีเจอร์ pm_th ⇒ กระทบ fit น้อยกว่า U1–U2 · เวลาเริ่ม/จบเป็นค่าประมาณจากข้อมูลรายนาที |
| U4 | train | 2026-10-27 ≈ 16:00 → ≈ 18:20 (≈ 140 นาที) | ❌ ไม่ได้กด | `other` · note "ไม่ทราบสาเหตุ · ไม่ได้กด MARK" | คนเก็บข้อมูลแจ้ง 28 ต.ค. ว่า**จำไม่ได้** · ข้อมูล: 16:00–16:26 pm2_5 ≈ 29 → 206 µg/m³ (pm1_0 ≈ 21 → 124 · pm10 ≈ 30 → 224 ⇒ เป็นอนุภาคละเอียดเกือบทั้งหมด คล้ายควัน ไม่ใช่ฝุ่นหยาบ — เป็นข้อสังเกตจากข้อมูล ไม่ใช่ข้อยืนยัน) · temp_c คงที่ ≈ 37.3–37.4 °C · humidity_pct ≈ 54 % · tvoc_ppb ≈ 83 → 180 ppb · pm2_5 ลดเหลือ ≈ 50 ราว 18:20 · ⚠️ หลังจากนั้น pm2_5 ค้าง ≈ 41–45 ทั้งคืน แล้วค่อยๆ ลดจนกลับ ≈ 25 ราว 2026-10-28 10:40 — ไม่รวมใน U4 เพราะไม่รู้ว่าเป็นหางของเหตุการณ์หรืออากาศภายนอก · ตัดสินใน R3 · เวลาเริ่ม/จบเป็นค่าประมาณจากข้อมูลรายนาที |
| U5 | **test** | 2026-10-30 ≈ 08:38 → ≈ 13:38 (≈ 300 นาที) | ❌ ไม่ได้กด | `other` · note "น่าจะจุดธูป · ไม่ได้กด MARK" | คนเก็บข้อมูลแจ้ง 30 ต.ค. ว่า**น่าจะจุดธูป** (ไม่ได้ระบุจำนวนดอก ระยะ หรือตำแหน่ง) · ข้อมูล: pm2_5 ≈ 30 → 456 µg/m³ (สูงสุด 09:26:08) · pm1_0 สูงสุด 295 · pm10 สูงสุด 463 ⇒ อนุภาคละเอียดเกือบทั้งหมด คล้ายควัน · co_ppm ≈ 0.5 → 5.6 ppm · tvoc_ppb สูงสุด ≈ 1,260 ppb · humidity_pct ≈ 59.7 → 64.2 % · temp_c ≈ 32.1 → 33.5 °C (ขึ้นช้า ๆ ตามช่วงเวลาของวัน) · ⚠️ pm2_5 ไต่ขึ้นนาน ≈ 50 นาที (08:38 → 09:26) ต่างจาก P1 ที่ขึ้นถึงยอดภายใน ≈ 1 นาที ⇒ น่าจะมากกว่า 1 ดอก หรือจุดต่อเนื่อง (ข้อสังเกตจากข้อมูล ไม่ใช่ข้อยืนยัน) · จบ = เวลาที่ pm2_5 ≤ 33 ต่อเนื่อง ≥ 10 นาที · เวลาเริ่ม/จบเป็นค่าประมาณจากข้อมูล |

> ⚠️ **แถว U1–U4 ยังมี `label = normal` ใน CSV** เพราะไม่ได้กด MARK → `ml/split.py::normal_only()` ใช้แค่ label ใน CSV ⇒ **แถวช่วงนี้จะเข้า fit** แม้ใส่ใน events เป็น `other` แล้ว (U1 ≈ 5,900 + U2 ≈ 11,000 + U3 ส่วนที่ไม่ซ้อน U2 ≈ 3,000 + U4 ≈ 8,400 ≈ 28,300 แถว จาก train ≈ 315,000 แถว ≈ 9.0 % · ค่าคาดหมาย) · ต้องตัดสินใน R3 ว่าจะยอมรับ (เขียนเป็นข้อจำกัด) หรือตัดออกจาก fit (ต้องแก้โค้ด ML) — ห้ามแก้ไฟล์ raw

> ⚠️ **U5 อยู่ในช่วง test และมี `label = normal` ใน CSV** (≈ 18,000 แถว) ⇒ ถ้าไม่จัดการ ตอนประเมินผล การเตือนในช่วงนี้จะถูกนับเป็น "เตือนผิด" ทั้งที่น่าจะเป็นธูป · ต้องตัดสินใน R3 ว่าจะตัดช่วงนี้ออกจากการประเมิน หรือนับเป็น `incense` (วิธีไม่ตรง §5 · ไม่ได้กด MARK) — ห้ามแก้ไฟล์ raw

---

## 7. จากใบจดเป็นไฟล์ events

```powershell
# 1. ร่างจาก MARK (end + 1 s ให้อัตโนมัติ · label = TODO)
python -m ml.events draft --ev "data/raw/usb_train/EV_*_usb.csv" --out data/events/2026-10_train.csv
# 2. แก้ด้วยมือ: TODO → ชื่อจากตาราง §2 · เติม note จากใบจด · เพิ่มแถว cooking ที่จดด้วยมือ (ถ้าเลือกทาง ก)
# 3. ตรวจ
python -m ml.events check --events data/events/2026-10_train.csv `
  --raw "data/raw/usb_train/AG_*_usb.csv" --ev "data/raw/usb_train/EV_*_usb.csv" `
  --t1 2026-10-29T12:00:00+07:00 --t2 2026-10-30T06:00:00+07:00
```

`check` ต้องจบด้วย `OK` ก่อนเข้า R4 · ไฟล์ใน `data/events/` ขึ้น git ได้ (ground truth — commit ทันทีที่ตรวจผ่าน)

---

## 8. อนุมัติ

ค่าใน §2 §4 §5 ร่างโดย Claude Code 24 ต.ค. · เจ้าของโปรเจกต์อนุมัติตามที่เสนอ 24 ต.ค. · **หลังจากนี้ห้ามเปลี่ยนคำศัพท์และ mapping จนจบ R4**

| เรื่อง | ค่าที่อนุมัติ | ผู้อนุมัติ · วันที่ |
|---|---|---|
| คำศัพท์ + mapping (§2) | `incense=anomaly,dusting=anomaly,cooking=normal,other=unknown` · คำศัพท์ปิด 4 คำ | เจ้าของโปรเจกต์ · 24 ต.ค. 2569 |
| ทำอาหารช่วง train (§3) | ทาง ก | เจ้าของโปรเจกต์ · 24 ต.ค. 2569 |
| ~~t1 · t2 · gap (§4) — ฉบับ 24 ต.ค.~~ | ~~t1 `2026-10-27T12:00:00+07:00` · t2 `2026-10-28T06:00:00+07:00` · จบ `2026-10-28T22:00:00+07:00`~~ · ยกเลิก 25 ต.ค. เพราะการเก็บเริ่มใหม่ | เจ้าของโปรเจกต์ · 24 ต.ค. 2569 |
| **เริ่มเก็บใหม่ (§1)** | `2026-10-25T20:24:17+07:00` · เก็บช่วงปกติยาวต่อเนื่องก่อน แล้วค่อยเลือกวันทำเหตุการณ์ | คนเก็บข้อมูล (รับงานต่อ) · 25 ต.ค. 2569 |
| **t1 · t2 · วันจบ (§4) — ฉบับ 25 ต.ค. (แบบ ข)** · t1 freeze อีกครั้งใน R3 | **t1 `2026-10-29T12:00:00+07:00` · t2 `2026-10-30T06:00:00+07:00` · จบ `2026-10-30T22:00:00+07:00`** (train 87.6 · val 18 · test 16 ชม.) · gap 60 s · ห่างขอบ ≥ 30 นาที · ห้ามเลื่อนหลังเหตุการณ์ val ครั้งแรก · train < 48 ชม. → ตัดสินใหม่ · รับข้อจำกัด val 18 ชม. (เตือนผิดบน val ได้ 0 episode) แบบเดียวกับฉบับ 24 ต.ค. | คนเก็บข้อมูล (รับงานต่อ) · 25 ต.ค. 2569 · ⬜ **เจ้าของโปรเจกต์รับทราบ** (HANDOFF §0: วันทำเหตุการณ์เป็นของเจ้าของตัดสิน) |
| จำนวน/วิธี/จังหวะเหตุการณ์ (§5) | ต่อชุด: incense 2 · dusting 2 · cooking ≥ 1 (กด MARK) · ธูป 1 ดอก 1.0 m 5 นาที · ฝุ่น 50 cm 2 นาที · กดจบเมื่อ ≤ ฐาน + 5 µg/m³ หรือ 90 นาที · เว้น ≥ 30 นาทีหลังกดจบ · ~~นำร่อง 25 ต.ค.~~ → นำร่อง 26–28 ต.ค. | เจ้าของโปรเจกต์ · 24 ต.ค. 2569 |
| **ตารางเวลา §5 — ฉบับ 25 ต.ค.** | นำร่อง 26–28 ต.ค. · val 29 ต.ค. 13:00 / 15:00 / ~18:00 / 20:00 / 22:00 · test 30 ต.ค. 08:00 / 10:00 / ~12:00 / 14:00 / 16:00 · ลำดับเดิม (incense · dusting · cooking · incense · dusting) · วิธีทำไม่เปลี่ยน | คนเก็บข้อมูล (รับงานต่อ) · 25 ต.ค. 2569 · ⬜ เจ้าของโปรเจกต์รับทราบ |
| ค่าสุดท้ายหลังรอบนำร่อง (กรอกก่อนเหตุการณ์ val ครั้งแรก) | ระยะธูป ___ m · เวลาธูป ___ นาที · ระยะฝุ่น ___ cm · เวลาฝุ่น ___ นาที · เพดาน ___ นาที | |

อุปกรณ์นี้เป็นเครื่องเฝ้าระวังสภาพแวดล้อมเพื่อการวิจัย ไม่ใช่เครื่องมือแพทย์
และไม่ใช่เครื่องเตือนภัยคาร์บอนมอนอกไซด์ ห้ามใช้แทน CO alarm ที่ได้มาตรฐาน UL 2034 หรือ EN 50291
