Sh080205/AirGuard/docs/00-TEAM_PLAN.md

# AirGuard-S3 — แบ่งงาน 3 คน + prompt สำเร็จรูป

**อัปเดต:** 1 ก.ย. 2569 · เหลือ ~13 สัปดาห์ถึงส่งงาน

---

## 🎯 โปรเจกต์นี้ทำไปทำไม

> **เครื่องเฝ้าระวังคุณภาพอากาศในห้องสำหรับผู้ป่วยภูมิแพ้และโรคทางเดินหายใจ
> ที่ตรวจจับ "รูปแบบผิดปกติ" ไม่ใช่แค่ "ค่าเกินเกณฑ์"**

### ปัญหาที่แก้

เครื่องวัดอากาศที่มีขายทั่วไปทำงานแบบ `ถ้า PM2.5 > 50 ให้เตือน`
แต่สำหรับคนเป็นภูมิแพ้ **สิ่งที่กระตุ้นอาการหลายครั้งไม่ได้ทำให้ค่าไหนเกินเกณฑ์เลย**

```
┌──────────────────────────────────────────────────────────┐
│  ทำอาหาร                                                  │
│    PM2.5 ↑↑   อุณหภูมิ ↑   ความชื้น ↑                      │
│    → ขึ้นพร้อมกัน มีเหตุผล = สภาพปกติของห้องครัว            │
├──────────────────────────────────────────────────────────┤
│  ปัดฝุ่น / เชื้อราฟุ้ง / เปิดตู้ที่ไม่ได้เปิดนาน                  │
│    PM2.5 ↑↑   อุณหภูมิ →   ความชื้น →                      │
│    → ฝุ่นขึ้นลอยๆ ไม่มีอะไรมาด้วย = ผิดปกติ 🔴              │
└──────────────────────────────────────────────────────────┘
```

**ทั้งสองกรณี PM2.5 อาจอ่านได้เท่ากันเป๊ะ** — เกณฑ์ตัวเลขแยกไม่ออก
แต่ถ้าดู**ความสัมพันธ์ระหว่างตัวแปร** จะเห็นว่าอันหนึ่งปกติ อีกอันไม่ปกติ

> 🔑 **นี่คือเหตุผลทั้งหมดของโปรเจกต์** — เราเคยจำลองแล้วพบว่า
> **3σ แบบดูทีละตัวจับ anomaly ประเภทนี้ได้ 0% · Mahalanobis จับได้ 100%**
> ถ้าโปรเจกต์จบลงที่ `if (pm25 > 50)` แปลว่าทำผิดทาง

### เป้าหมาย 3 ชั้น

| ชั้น | เป้าหมาย | วัดผลยังไงว่าสำเร็จ |
|---|---|---|
| 🏥 **เพื่อผู้ใช้** | เตือนก่อนอาการกำเริบ ไม่ใช่หลังจากนั้น | MTTD ต่ำ · false alarm/วัน ต่ำพอที่คนจะไม่ปิดเครื่องทิ้ง |
| 🎓 **เพื่อเกรด** | บรรยาย: คำนวณ timing/ADC/baud ได้<br>แล็บ: **วัดได้จริงและอธิบายความคลาดเคลื่อนเป็น** | สองวิชาแยกเกรดกัน · ตัวเลขที่วัดเองคือส่วนที่ทำคะแนน |
| 💼 **เพื่อ portfolio** | ESP32-S3 + TinyML บนบอร์ดที่ออกแบบเอง | มีของโชว์ได้ · ต่อยอดกับงาน TCN/PM2.5 บน FPGA ได้ |

### เส้นที่ขีดไว้ชัด — ไม่ใช่อะไร

🔴 **ไม่ใช่เครื่องเตือนภัย CO** — CO ใส่มาเพื่อจับมลพิษที่อันตรายถึงชีวิต
แต่**ต้องแยก safety path ออกจาก ML path** และห้ามอ้างว่าใช้แทน
CO alarm มาตรฐาน UL 2034 / EN 50291 *(Winsen เองก็ห้ามในคู่มือ)*

🔴 **ไม่ใช่เครื่องมือแพทย์** — เป็นเครื่องเฝ้าระวังสภาพแวดล้อมเพื่อการวิจัย

### ทำไมต้อง "ในห้อง" ไม่ใช่ "นอกอาคาร"

เคยคิดจะวัดนอกอาคาร แต่**ทำแล้วพังทั้งวิธีการ** — เพราะจะเทรนและวัดผลได้
ต้องรู้ว่าช่วงไหนคือ anomaly จริง **ในห้องเราสร้าง anomaly ได้เอง**
(จุดธูป ทอดของ ปัดฝุ่น ปิดห้อง) แล้วกดปุ่ม MARK บันทึกเวลาไว้
→ ได้ ground truth · นอกอาคารทำแบบนี้ไม่ได้ ได้แต่เดา

> 📌 นี่คือเหตุผลที่บอร์ดมี **ปุ่ม MARK** — มันคือเครื่องมือสร้าง label ไม่ใช่ปุ่มประดับ

---

## 🎯 หลักการแบ่งงาน

> **แบ่งตาม "ใครถูกบล็อกด้วยอะไร" ไม่ใช่ตามความถนัด**

บอร์ดยังไม่มา = ใครก็ตามที่งานต้องรอบอร์ด จะว่างไป 2–3 สัปดาห์
เพราะงั้นต้องจัดให้ **ทั้งสามคนมีงานที่เริ่มได้วันนี้**

```
                    ┌─────────────────────────────────────┐
สัปดาห์ 1–3         │  ทั้ง 3 คนทำขนานกัน ไม่มีใครรอใคร     │
(บอร์ดยังไม่มา)      │  A: ฮาร์ดแวร์+จัดซื้อ                 │
                    │  B: firmware ที่ยังไม่ต้องมีบอร์ด      │
                    │  C: ข้อมูล+โมเดล (ไม่ต้องมีบอร์ดเลย)   │
                    └─────────────────────────────────────┘
                                    ↓
สัปดาห์ 4           🔗 จุดบรรจบที่ 1 — บอร์ดมา A บัดกรี B เอาโค้ดลง
                                    ↓
สัปดาห์ 5–9         A+B เก็บข้อมูลจริง  →  ส่งให้ C เทรน
                                    ↓
สัปดาห์ 10          🔗 จุดบรรจบที่ 2 — C ส่งโมเดลให้ B ยัดลงบอร์ด
                                    ↓
สัปดาห์ 11–13       ทั้ง 3 คน: ทดสอบ · วัดผล · เขียนรายงาน
```

---

## 👤 คน A — ฮาร์ดแวร์

**เป็นเจ้าของ:** บอร์ด · การบัดกรี · การวัดทางไฟฟ้า · lab report ของวิชา 03603324

| สัปดาห์ | ทำอะไร | บล็อกโดย |
|---|---|---|
| 1 | 🔴 **วัด footprint U1** · แก้ BOM (J2) · วาง No Connect Flag | — เริ่มได้เลย |
| 1 | สั่งของ THT + โมดูล + สาย JST | — |
| 2 | ทำสาย ZE07-CO *(แมป pin 15/5/8/7)* · ทดสอบขั้ว buzzer · เช็ค pinout เซนเซอร์ทุกตัว | รอของ |
| 3–4 | บัดกรี → วัดก่อนจ่ายไฟ → จ่ายไฟทีละขั้น | รอบอร์ด |
| 4 | 📋 **วัดค่าลง lab report:** ripple ราง 3.3 V · ΔV ตอน SD เขียน · τ ดีบาวซ์จริง · กระแสรวม | — |
| 5+ | ประกอบกล่อง · ติดตั้งจุดวัด · ซัพพอร์ต B ตอนเจอบั๊กฮาร์ดแวร์ | — |

> 🔑 **A คือคนเดียวที่จับ "ของจริง"** → ทุกตัวเลขที่วัดได้ต้องส่งเข้ากลุ่มทันที
> เพราะ B ต้องใช้ตั้ง timeout และ C ต้องใช้รู้ว่าเซนเซอร์ noise เท่าไร

---

## 👤 คน B — เฟิร์มแวร์

**เป็นเจ้าของ:** โค้ดบน ESP32 · การเก็บข้อมูล · การรันโมเดลบนบอร์ด

| สัปดาห์ | ทำอะไร | บล็อกโดย |
|---|---|---|
| 1 | สร้าง repo · ESP-IDF project · CI ที่ build ได้ | — เริ่มได้เลย |
| 1–2 | เขียน **driver PMS7003** + parser frame 32 ไบต์ + ตรวจ checksum | — เขียนได้โดยไม่มีบอร์ด |
| 2 | เขียน **FSM** (BOOT→WARMUP→NORMAL→WATCH→ALARM) + FreeRTOS tasks | — |
| 2 | เขียน **unit test ของ parser** ด้วยข้อมูลปลอม | — 🔑 พิสูจน์โค้ดถูกก่อนมีบอร์ด |
| 3 | ไดรเวอร์ I²C + SPI (microSD) + รูปแบบไฟล์ CSV ที่จะบันทึก | — |
| 4 | 🔗 เอาโค้ดลงบอร์ดจริง ไล่บั๊กร่วมกับ A | รอบอร์ด |
| 5–9 | เก็บข้อมูลต่อเนื่อง ส่งให้ C ทุกสัปดาห์ | — |
| 10–11 | 🔗 ยัดโมเดล int8 จาก C ลงบอร์ด วัด latency + RAM | รอ C |

> 🔑 **B ต้องตกลง "รูปแบบไฟล์ CSV" กับ C ตั้งแต่สัปดาห์ที่ 1**
> ถ้าปล่อยไว้ถึงสัปดาห์ 5 จะได้ข้อมูลที่ C เอาไปเทรนไม่ได้ **แล้วต้องเก็บใหม่หมด**

---

## 👤 คน C — ข้อมูลและโมเดล

**เป็นเจ้าของ:** dataset · โมเดล · เมตริก · การพิสูจน์ว่าโมเดลใช้ได้จริง

| สัปดาห์ | ทำอะไร | บล็อกโดย |
|---|---|---|
| 1 | 🔴 **ลงทะเบียน DustBoy API วันนี้** *(รออนุมัติหลายวัน)* | — |
| 1 | ตกลงรูปแบบ CSV กับ B | — |
| 1–2 | เขียน **`ml/metrics.py`** — PR-AUC · event-level detection · MTTD · false alarm/day | — ไม่ต้องมีข้อมูลจริง |
| 2 | เขียน **generator ข้อมูลปลอม** ที่มี anomaly ฝังไว้ → ใช้ทดสอบ metrics | — 🔑 พิสูจน์เมตริกก่อนมีข้อมูลจริง |
| 2–3 | เขียน **`ml/train_ae.py`** — autoencoder + เกณฑ์ threshold + persistence rule | — |
| 3 | baseline เทียบ: Mahalanobis · 3σ ตัวเดียว → เอาไว้พิสูจน์ว่า AE ดีกว่าจริง | — |
| 5–9 | เทรนด้วยข้อมูลจริงจาก B · ปรับ feature | รอข้อมูล |
| 10 | 🔗 quantize เป็น int8 · ส่งให้ B | — |
| 11–13 | เขียนผลการทดลอง + กราฟ | — |

> 🔴 **ห้ามใช้ accuracy เป็นเมตริก** — ข้อมูล anomaly ไม่สมดุลอย่างรุนแรง
> ทายว่า "ปกติ" ตลอดก็ได้ accuracy 99% แต่จับอะไรไม่ได้เลย
> 🔴 **ห้ามใช้ Point Adjustment** — งาน Kim et al. (AAAI 2022) แสดงว่ามันทำให้
> โมเดลสุ่มดูเหมือนชนะ state-of-the-art **ถ้าใช้ กรรมการจะจับได้**

---

## 🔗 2 จุดที่ทีมต้องคุยกัน ห้ามข้าม

### จุดที่ 1 — สัปดาห์ที่ 1: ตกลงรูปแบบ CSV *(B ↔ C)*

```csv
timestamp_iso,pm1_0,pm2_5,pm10,temp_c,humidity_pct,tvoc_ppb,eco2_ppm,co_ppm,label
2026-09-01T14:30:00+07:00,8,12,15,28.4,62.1,145,520,0.4,normal
```

**ต้องตกลงให้ครบ:** ชื่อคอลัมน์ · หน่วย · timezone · ความถี่ · ค่าที่หายไปเขียนยังไง · คอลัมน์ `label` ใส่ตอนไหน

### จุดที่ 2 — สัปดาห์ที่ 10: ส่งมอบโมเดล *(C → B)*

C ต้องส่ง: ไฟล์ `.tflite` int8 · ค่า scale/zero-point · ค่า threshold · **สคริปต์ที่พิสูจน์ว่าผลบน PC กับบนบอร์ดตรงกัน**

> ⚠️ ถ้าไม่มีสคริปต์ข้อสุดท้าย เวลาผลบนบอร์ดเพี้ยน **จะไม่รู้ว่าเป็นที่โมเดลหรือที่โค้ด**

---

# 📋 Prompt สำเร็จรูป

> วางในแชตใหม่ได้เลย · แต่ละคนใช้ของตัวเอง
> 🔑 **แนบไฟล์ `02-HARDWARE_REFERENCE.md` ไปด้วยทุกครั้ง** ไม่งั้น AI จะเดา GPIO

---

## 🅰️ คน A — ใช้ Cowork *(ไม่ต้องเขียนโค้ด)*

```
ผมดูแลฮาร์ดแวร์ของโปรเจกต์ AirGuard-S3
เครื่องวัดคุณภาพอากาศในห้อง + ตรวจจับความผิดปกติ บน ESP32-S3
วิชา 03603323/03603324 วิศวกรรมคอมพิวเตอร์ ม.เกษตร ศรีราชา

【 สถานะ 】
- schematic เสร็จ · สั่ง PCBA แล้ว (SMD โรงงานประกอบ / THT ผมบัดกรีเอง)
- บอร์ดยังไม่มาถึง
- ไฟล์ที่แนบมาคือสเปกของบอร์ด ใช้เป็นความจริงอ้างอิง

【 สิ่งที่อยากให้ช่วย 】
1. เตือนผมว่าอะไรต้องทำก่อนหลัง โดยเฉพาะอันที่ทำช้าแล้วเสียหาย
2. ตอนผมวัดค่าอะไรได้ ช่วยบอกว่าค่านั้นปกติไหม และควรบันทึกอะไรลง lab report
3. ตอนบอร์ดไม่ทำงาน ช่วยไล่หาสาเหตุแบบเป็นขั้นตอน

【 กฎที่ขอให้ทำตาม 】
- ตอบเป็นภาษาไทย ศัพท์เทคนิคทับศัพท์ได้
- 🔴 ห้ามเดาสเปกฮาร์ดแวร์ ถ้าไม่มีในไฟล์ที่แนบ ให้บอกว่า
  "ต้องเปิด datasheet ตัวไหน หัวข้ออะไร" แล้วให้ผมไปเอาเลขมา
- 🔴 ตอนไล่บั๊ก ให้ไล่จากชั้นล่างขึ้นบนเสมอ:
  ไฟเลี้ยง/กราวด์ → การต่อสาย → การตั้งค่า → โค้ด
  ห้ามเดาว่าเป็นบั๊กในโค้ดเป็นคำตอบแรก ให้สั่งผมวัดก่อน
- ทุกครั้งที่แนะนำให้วัดอะไร บอกด้วยว่า
  "ใช้เครื่องมืออะไร วัดตรงไหน ค่าที่ควรได้เท่าไร ถ้าไม่ตรงแปลว่าอะไร"
- เวลาอธิบาย ให้บอกที่มาของสูตรด้วย ไม่ใช่โยนสูตรมาเฉยๆ

【 งานแรก 】
ทำเช็คลิสต์งานสัปดาห์นี้ให้ผม เรียงตามลำดับที่ควรทำ
พร้อมบอกว่าแต่ละข้อใช้เวลาเท่าไร และข้อไหนที่ถ้าทำช้าแล้วจะเสียหาย
```

---

## 🅱️ คน B — ใช้ Claude Code *(เขียนเฟิร์มแวร์)*

```
เราจะเขียนเฟิร์มแวร์ ESP-IDF สำหรับบอร์ด AirGuard-S3
เครื่องวัดคุณภาพอากาศในห้อง + anomaly detection บน ESP32-S3-DevKitC-1 (N16R8)

【 ข้อมูลฮาร์ดแวร์ 】
อ่านจากไฟล์ 02-HARDWARE_REFERENCE.md ที่อยู่ใน repo
🔴 GPIO ทุกตัวต้องเอาจากไฟล์นั้น ห้ามเดา ห้ามใช้ค่า default ของตัวอย่างใน internet

【 สภาพแวดล้อม 】
- ESP-IDF v5.5.x (ไม่ใช่ v6)
- ยังไม่มีบอร์ดจริง → โค้ดต้อง build ผ่านและ test ผ่านโดยไม่ต้องมีฮาร์ดแวร์

【 สิ่งที่ต้องสร้าง เรียงตามลำดับ 】
1. โครง ESP-IDF project + CI (GitHub Actions) ที่ build ผ่าน
2. components/pms7003/ — driver PMS7003
   - parse frame 32 ไบต์ ตรวจ checksum
   - 🔑 แยกส่วน parse ออกจากส่วน UART ให้ unit test ได้โดยไม่ต้องมีบอร์ด
3. test/ — unit test ของ parser ด้วย frame ปลอม
   ต้องมีเคส: frame ถูกต้อง / checksum ผิด / frame ขาด / มีขยะนำหน้า
4. main/ — FSM: BOOT → WARMUP → NORMAL → WATCH → ALARM
   + FreeRTOS task แยก: sensor / logic / io
5. components/storage/ — เขียน CSV ลง microSD

【 กฎการเขียนโค้ด 】
- 🔴 เช็ค esp_err_t ทุกจุด ใช้ ESP_ERROR_CHECK() หรือจัดการ error เอง
  โค้ดที่ไม่เช็ค return คือโค้ดผิด
- 🔴 ใน ISR: ห้าม printf/ESP_LOG · ห้าม delay · ห้าม malloc · ห้าม float
  ISR ต้องสั้น ส่งงานต่อให้ task ผ่าน queue · พิจารณา IRAM_ATTR
- 🔴 ตัวแปรที่ ISR กับ task ใช้ร่วมกัน: volatile อย่างเดียวไม่พอ
  ต้องใช้ critical section / atomic / queue และอธิบายว่าทำไมเลือกอันนั้น
- 🔴 ปุ่มไม่มี pull-up ภายนอกบนบอร์ด ต้องตั้ง GPIO_PULLUP_ENABLE
- stack size ของ task ห้ามตั้งมั่ว ให้คำนวณคร่าวๆ + ใส่ high-water mark ไว้วัด
- คอมเมนต์ภาษาไทยได้ อธิบายส่วนที่ไม่ชัดเจน

【 กฎการทำงาน 】
- ทำทีละขั้น เสร็จขั้นหนึ่งให้หยุดรอผมรีวิวก่อนไปขั้นต่อไป
- ทุกขั้นต้อง build ผ่านก่อนบอกว่าเสร็จ
- ถ้า API ของ ESP-IDF เปลี่ยนตามเวอร์ชัน ให้บอกว่าโค้ดนี้ใช้กับเวอร์ชันไหน

เริ่มจากขั้นที่ 1
```

---

## 🅲 คน C — ใช้ Claude Code *(ML)*

```
เราจะทำ pipeline anomaly detection สำหรับข้อมูลคุณภาพอากาศในห้อง
รันบน ESP32-S3 ตอนสุดท้าย (TinyML, int8) แต่ตอนนี้ทำบน PC ก่อน

【 ข้อมูล 】
- ยังไม่มีข้อมูลจริง บอร์ดยังไม่เสร็จ
- feature: pm1_0, pm2_5, pm10, temp_c, humidity_pct,
           tvoc_ppb, eco2_ppm, co_ppm
- unsupervised — เทรนด้วยข้อมูลปกติอย่างเดียว

【 สิ่งที่ต้องสร้าง เรียงตามลำดับ 】
1. ml/synth.py — สร้างข้อมูลปลอมที่สมจริง พร้อมฝัง anomaly 3 แบบ:
   ก. ค่าพุ่งทีเดียว (จุดธูป/ทำอาหาร)
   ข. ค่าค่อยๆ ไต่ขึ้น (ห้องปิด CO2 สะสม)
   ค. ความสัมพันธ์ระหว่างตัวแปรเพี้ยน แต่แต่ละตัวยังอยู่ในช่วงปกติ
   🔑 แบบ ค. คือเหตุผลทั้งหมดที่ต้องใช้ multivariate — 3σ ตัวเดียวจับไม่ได้

2. ml/metrics.py
   🔴 ห้ามใช้ accuracy — ข้อมูลไม่สมดุลรุนแรง ทายว่าปกติตลอดก็ได้ 99%
   🔴 ห้ามใช้ Point Adjustment — Kim et al. AAAI 2022 แสดงว่ามันทำให้
      โมเดลสุ่มดูเหมือนชนะ SOTA ถ้าใช้จะโดนจับได้
   ต้องมี: PR-AUC · event-level detection rate · MTTD (เวลาเฉลี่ยกว่าจะจับได้)
           · false alarm ต่อวัน · precision/recall ที่ threshold ที่เลือก

3. ml/baseline.py — 3σ ตัวเดียว และ Mahalanobis distance
   🔑 ต้องมี เพื่อพิสูจน์ว่า autoencoder ดีกว่าจริง ไม่ใช่แค่ซับซ้อนกว่า

4. ml/train_ae.py — autoencoder + threshold จาก reconstruction error
   + persistence rule (ต้องผิดปกติติดกันกี่ครั้งถึงจะเตือน)

5. เทียบผลทั้ง 3 วิธีบนข้อมูลปลอมชุดเดียวกัน ออกเป็นตาราง + กราฟ

【 กฎ 】
- Python + NumPy/pandas/scikit-learn/PyTorch + matplotlib
- ทุกไฟล์ต้องรันได้จริง ไม่ใช่โค้ดที่ดูดีแต่รันไม่ผ่าน — รันให้ดูด้วย
- 🔴 ตั้ง random seed ทุกที่ ผลต้องทำซ้ำได้
- 🔴 แยก train/validation/test ตามเวลา ห้ามสุ่มแบ่ง
  ข้อมูล time-series ถ้าสุ่มแบ่งจะเกิด data leakage ผลจะดูดีเกินจริง
- อธิบาย intuition ของทุกสูตรที่ใช้ ไม่ใช่แค่เขียนโค้ด
  เพราะต้องเอาไปเขียนรายงาน
- ทำทีละขั้น เสร็จแล้วหยุดรอผมรีวิว

เริ่มจากขั้นที่ 1 และ 2 พร้อมกัน เพราะต้องใช้ข้อมูลปลอมมาทดสอบ metrics
```

---

## ⚠️ 3 กับดักที่ทีม 3 คนมักเจอ

**1. รอกันโดยไม่จำเป็น** — B กับ C ไม่ต้องรอบอร์ดเลยใน 3 สัปดาห์แรก
ใครบอกว่า "รอบอร์ดก่อน" แปลว่ายังไม่ได้อ่านแผนนี้

**2. ตกลงรูปแบบข้อมูลช้าเกินไป** — ถ้าไม่ตกลง CSV ตั้งแต่สัปดาห์ 1
พอถึงสัปดาห์ 5 จะพบว่าข้อมูลที่เก็บมาใช้ไม่ได้ **ต้องเก็บใหม่หมด เสีย 4 สัปดาห์**

**3. คนเดียวรู้เรื่องเดียว** — พอถึงตอนนำเสนอ อาจารย์ถามข้ามส่วน
🔑 **ทุกสัปดาห์ให้แต่ละคนเล่าให้อีกสองคนฟัง 10 นาที** ว่าทำอะไรไปและติดอะไร
