Sh080205/AirGuard/docs/03-CO_SAFETY.md

# AirGuard-S3 — การเพิ่ม CO และแก๊สอันตรายถึงชีวิต

**ปรับปรุง:** 27 ก.ค. 2569
**อ่านหัวข้อ 0 ให้จบก่อนทำอย่างอื่น**

---

## 0. 🔴 เส้นแบ่งที่ห้ามข้าม — อ่านก่อน

### สิ่งที่โปรเจกต์นี้เป็น และไม่เป็น

| ✅ เป็น | ❌ ไม่เป็น |
|---|---|
| เครื่องมือ**วิจัย**สำหรับเก็บข้อมูลและศึกษา anomaly detection | **เครื่องเตือนภัย CO ที่ใช้รักษาชีวิตได้** |
| เซนเซอร์ที่ให้ค่า**เชิงสัมพัทธ์**เพื่อดูแนวโน้ม | เครื่องมือวัดที่ผ่านการสอบเทียบและรับรอง |
| ของที่ใช้ประกอบการเรียนและทำ portfolio | อุปกรณ์ที่พึ่งพาได้เมื่อชีวิตแขวนอยู่กับมัน |

### ทำไมเครื่องที่เราสร้างเองถึงใช้แทน CO alarm ไม่ได้

เครื่องเตือน CO ที่ขายตามท้องตลาดต้องผ่านมาตรฐาน **UL 2034** (อเมริกา) หรือ **EN 50291** (ยุโรป)
ซึ่ง**ไม่ได้ทดสอบแค่ว่าเซนเซอร์อ่านค่าได้** แต่ทดสอบว่า:

- **เตือนใน "เวลาที่ถูกต้อง"** ตามเส้นโค้งความเข้มข้น–เวลาที่กำหนด (ไม่ใช่แค่เตือนเมื่อเจอ CO)
- **ไม่เตือนผิดพลาด** จากไอระเหยอื่นที่มีในบ้านปกติ
- ทำงานได้ใน**อุณหภูมิต่ำและความชื้นสูง** โดยเวลาตอบสนองไม่ช้าลง
- มี**แบตเตอรี่สำรอง** เมื่อไฟดับ
- มี**สัญญาณเตือนเมื่อเซนเซอร์หมดอายุ** (end-of-life)
- ผ่านการทดสอบความเสถียรในระดับการผลิตจริง ไม่ใช่แค่ต้นแบบ

> 🔑 **ประเด็นสำคัญ:** มาตรฐานเหล่านี้ตัดสินที่ **อัลกอริทึม** ไม่ใช่แค่ประสิทธิภาพของเซนเซอร์ที่จุดเดียว
> ต้นแบบจำนวนมากผ่านการทดสอบได้ แต่ล้มเหลวเมื่อผลิตจริงหรือเมื่อสภาพแวดล้อมเปลี่ยน

**เซนเซอร์เปล่าคือ "ชิ้นส่วน" ไม่ใช่ "อุปกรณ์นิรภัย"**

### 🔴 กฎ 4 ข้อของทีม

1. **ถ้าจะทำการทดลองที่มีการเผาไหม้ (E1 จุดธูป, E2 ทำอาหาร) ต้องมี CO alarm ที่ได้มาตรฐานอยู่ในห้องด้วย**
   — ข้อนี้ควรทำอยู่แล้วแม้ไม่ได้ติด CO sensor
2. **ห้ามเขียนหรือพูดว่าเครื่องนี้ "เตือนภัย CO ได้"** ทั้งในรายงาน สไลด์ โปสเตอร์ และ README
   ให้ใช้คำว่า "บันทึกและติดตามระดับ CO เพื่อการวิจัย"
3. **ติดป้ายบนตัวเครื่อง**: *"อุปกรณ์วิจัย — ไม่ใช่เครื่องเตือนภัย ห้ามใช้แทน CO alarm ที่ได้มาตรฐาน"*
4. **ห้ามสร้าง CO ขึ้นมาเพื่อทดสอบเซนเซอร์** — ดู §4 นี่คือข้อที่อันตรายที่สุด

---

## 1. ทำไม CO ถึงคุ้มค่าที่จะเพิ่ม (เชิงวิทยาศาสตร์)

### 1.1 เป็นมิติที่เป็นอิสระจริง
จากที่คุยเรื่อง multivariate ไว้ — ปัญหาของชุดเซนเซอร์เดิมคือ **collinearity**
(PM1/2.5/10 มาจากเซนเซอร์ตัวเดียว · eCO2 อนุมานจาก TVOC)

**CO วัดด้วยหลักการ electrochemical ซึ่งเป็นคนละหลักการกับทุกช่องที่มีอยู่**
→ ให้มิติใหม่ที่เป็นอิสระจริง ไม่เพิ่มปัญหา collinearity

### 1.2 🔑 CO คือตัวชี้ "การเผาไหม้ไม่สมบูรณ์" โดยตรง
นี่คือสิ่งที่ทำให้ signature ของ anomaly คมขึ้นมาก:

| เหตุการณ์ | PM2.5 | PM2.5/PM10 | TVOC | **CO** | แยกได้ไหม |
|---|---|---|---|---|---|
| จุดธูป / เผาไหม้ | ↑↑ | ↑ | ↑ | **↑↑** | ✅ |
| ทำอาหาร (ทอด) | ↑↑ | ↑ | ↑↑ | **↑** | ✅ |
| ฉีดสเปรย์ | — | — | ↑↑↑ | **—** | ✅ แยกชัดจาก 2 แถวบน |
| กวาดบ้าน / ไรฝุ่นฟุ้ง | ↑ | ↓↓ | — | **—** | ✅ |
| 🔴 **เครื่องทำน้ำอุ่นแก๊สเผาไหม้ไม่สมบูรณ์** | — | — | — | **↑↑↑** | ✅ **มีแต่ CO ที่จับได้** |

⭐ **แถวสุดท้ายคือเหตุผลที่แท้จริง** — เหตุการณ์อันตรายที่สุดในบ้านไทยเป็นเหตุการณ์ที่
**เซนเซอร์เดิมทั้ง 7 ช่องมองไม่เห็นเลย** เพราะ CO ไม่มีสี ไม่มีกลิ่น และไม่ได้สร้างฝุ่น

### 1.3 บริบทไทยที่ทำให้โปรเจกต์มีความหมาย
🇹🇭 **เครื่องทำน้ำอุ่นระบบแก๊สในห้องน้ำ** เป็นสาเหตุการเสียชีวิตจาก CO ที่มีรายงานในไทย
— ระหว่างปี 2551 ถึง ก.ย. 2568 มีรายงาน **34 เหตุการณ์ ผู้ได้รับผลกระทบ 51 ราย เสียชีวิต 10 ราย**
โดยสาเหตุหลักคือ **ห้องน้ำแคบและไม่มีช่องระบายอากาศ**

→ นี่ทำให้ motivation ของโปรเจกต์หนักแน่นขึ้นมาก และเป็นเรื่องที่กรรมการเข้าใจได้ทันที
→ ⚠️ แต่ย้ำอีกครั้ง: **การอ้างบริบทนี้ไม่ได้แปลว่าเครื่องเราใช้ป้องกันได้** ให้เขียนว่า
*"เพื่อศึกษาว่าเซนเซอร์ราคาประหยัดสามารถตรวจจับรูปแบบดังกล่าวได้หรือไม่"*

---

## 2. 📐 เกณฑ์ระดับ CO ที่ต้องรู้

| ระดับ (ppm) | ผลต่อร่างกาย | ที่มา |
|---|---|---|
| **9 ppm** | เพดานแนะนำสำหรับอากาศในอาคาร เฉลี่ย 8 ชม. | WHO |
| **30 ppm** | เพดานแนะนำ เฉลี่ย 1 ชม. | WHO |
| **35 ppm** | ปวดศีรษะและวิงเวียนเมื่อสัมผัส 8 ชม. · ค่าแนะนำ TWA | NIOSH |
| **50 ppm** | ขีดจำกัดที่ยอมให้สัมผัสได้ เฉลี่ย 8 ชม. ในที่ทำงาน (PEL) | OSHA |
| **90 ppm** | เพดานแนะนำ เฉลี่ย 15 นาที | WHO |
| **200 ppm** | 🟠 ปวดศีรษะ วิงเวียน คลื่นไส้ **ภายในเวลาไม่นาน** | — |
| **400 ppm** | 🔴 **อันตรายถึงชีวิตทันที** — สับสนภายในไม่กี่นาที หมดสติได้ภายใน 2 ชม. | — |
| **800 ppm+** | 🔴🔴 **เสียชีวิตได้ภายในไม่กี่นาที** | — |

🔑 **สิ่งที่ต้องเข้าใจ: พิษของ CO เป็นแบบสะสม ขึ้นกับทั้งความเข้มข้นและเวลา**
ความเข้มข้นที่รู้สึกว่าไม่เป็นไรใน 10 นาที อาจทำให้สมองเสียหายได้ใน 2 ชั่วโมง

→ ⚠️ **นี่หมายความว่า logic การเตือนต้องคิดเป็น "dose" ไม่ใช่แค่ threshold ทันที**
(เช่น สะสม ppm×นาที) ซึ่งเป็นเหตุผลหนึ่งที่มาตรฐาน UL/EN กำหนดเป็นเส้นโค้งความเข้มข้น–เวลา

---

## 3. เลือกเซนเซอร์ CO

| | **MQ-7** | **ZE07-CO** ✅ แนะนำ |
|---|---|---|
| หลักการ | MOX (semiconductor) | **Electrochemical** |
| ช่วงวัด | คร่าวๆ ต้อง calibrate เอง | **0.5 – 500 ppm** |
| ความละเอียด | ต่ำ | **0.1 ppm** |
| เอาต์พุต | analog อย่างเดียว | **UART + analog DAC 0.4–2.0 V** |
| ชดเชยอุณหภูมิ | ไม่มี | **มีเซนเซอร์อุณหภูมิในตัว** |
| การใช้งาน | ⚠️ ต้อง**สลับแรงดันฮีตเตอร์เป็นรอบ** (1.4V/5V) โค้ดยุ่ง กินไฟมาก | ต่อ UART อ่านค่าได้เลย |
| ความจำเพาะต่อ CO | ต่ำ — ไวต่อแก๊สอื่นเยอะมาก | **สูงกว่ามาก** |
| drift | หนัก | น้อยกว่า แต่ยังมี |
| ราคา | ถูก (~100–200฿) | สูงกว่า (⚠️ ต้องเช็คราคาจริง) |

### ✅ เลือก ZE07-CO ด้วยเหตุผล 3 ข้อ
1. **ให้ค่าเป็น ppm จริง** ผ่าน UART → เอาไปเทียบกับตาราง §2 ได้ตรงๆ
   ส่วน MQ-7 ให้แค่ค่าความต้านทานเปลี่ยน ต้องแปลงเองด้วยเส้นโค้งที่ไม่แม่น
2. **ต่อ UART ตัวที่สอง** ได้เลย (ตัวแรกใช้กับ PMS7003) — ไม่ต้องเปลืองขา ADC
3. **MQ-7 ต้องสลับแรงดันฮีตเตอร์เป็นรอบ** ซึ่งทำให้ระบบซับซ้อนขึ้นมาก
   และค่าที่ได้ยังไม่น่าเชื่อถือพอจะเอามาพูดถึงเรื่องความปลอดภัย

### ⚠️ ข้อจำกัดของเซนเซอร์ electrochemical ที่ต้องเขียนในรายงาน
- **มีอายุการใช้งานจำกัด** (โดยทั่วไปไม่กี่ปี) — เป็นเซลล์เคมีที่เสื่อมตามเวลา แม้ไม่ได้ใช้
- **ต้องการเวลาอุ่นตัว** ก่อนอ่านค่าได้แม่น → เพิ่มเข้าไปใน state `WARMUP` ของ FSM
- **มี cross-sensitivity** กับแก๊สอื่น (เช่น ไฮโดรเจน แอลกอฮอล์) → ⚠️ ถ้าทำการทดลอง E3 (ฉีดแอลกอฮอล์)
  อาจเห็น CO ขึ้นทั้งที่ไม่มี CO จริง **ข้อนี้น่าสนใจมากและควรทดลองแล้วรายงาน**
- **ค่าที่อ่านได้ไม่ได้ผ่านการสอบเทียบ** เว้นแต่จะสอบเทียบกับแก๊สมาตรฐาน
  → รายงานเป็น "ค่าที่เซนเซอร์รายงาน" ไม่ใช่ "ความเข้มข้น CO จริง"
- เปิดดู **datasheet ของ ZE07-CO** เพื่อยืนยันอายุใช้งาน เวลาอุ่นตัว และตาราง cross-sensitivity
  **ห้ามเดาตัวเลขเหล่านี้**

---

## 4. 🔴 ห้ามทดสอบด้วยการสร้าง CO เอง

### สิ่งที่ห้ามทำเด็ดขาด
- ❌ **ห้ามเผาอะไรในห้องปิดเพื่อดูว่าเซนเซอร์ขึ้นไหม**
- ❌ **ห้ามใช้ไอเสียรถยนต์ เตาถ่าน หรือเครื่องทำน้ำอุ่นแก๊สเป็นแหล่งทดสอบ**
- ❌ **ห้ามทดสอบในห้องน้ำหรือพื้นที่อับอากาศ**

**เหตุผล:** CO ไม่มีสี ไม่มีกลิ่น ไม่มีรส — **คุณจะไม่รู้ตัวว่าได้รับมากเกินไปจนกระทั่งสายเกินไป**
และอาการเริ่มต้น (ปวดหัว มึน) ทำให้ความสามารถในการตัดสินใจแย่ลง
ผู้ที่ได้รับ CO จึงมักไม่สามารถช่วยตัวเองได้

### ✅ วิธีทดสอบที่ปลอดภัย

| วิธี | ทำอย่างไร | ได้อะไร |
|---|---|---|
| **1. ทดสอบทางไฟฟ้า** | ป้อนแรงดันจำลองเข้าขา analog หรือส่งเฟรม UART จำลอง | ✅ ทดสอบ **โค้ดและ logic การเตือน** ได้ครบโดยไม่ต้องมี CO จริงเลย |
| **2. Co-location กับ CO alarm ที่ได้มาตรฐาน** | วางเครื่องเราข้างเครื่องที่ได้รับรอง แล้วบันทึกทั้งคู่ | ✅ เทียบเคียงในสภาพจริงอย่างปลอดภัย |
| **3. บันทึกระยะยาวเฉยๆ** | ปล่อยให้เก็บข้อมูลไป 14 วัน | ✅ ได้ baseline และเห็น drift · ถ้าบังเอิญมีเหตุการณ์จริงก็ได้ข้อมูลนั้น |
| **4. แก๊สสอบเทียบ** | ใช้ถังแก๊สมาตรฐานความเข้มข้นที่ทราบค่า | ✅ วิธีที่ถูกต้องที่สุด — ⚠️ **ต้องทำภายใต้การดูแลของอาจารย์และในห้องแล็บที่มีตู้ดูดควันเท่านั้น** |

🔑 **วิธีที่ 1 คือคำตอบสำหรับโปรเจกต์นักศึกษา** — คุณสามารถทดสอบ **logic การเตือนทั้งหมด**
(threshold, dose accumulation, persistence, state machine, การแจ้งเตือน) ได้ครบถ้วน
โดยการ**ป้อนข้อมูลจำลอง** ไม่ต้องมี CO จริงแม้แต่โมเลกุลเดียว

→ และในรายงานให้เขียนว่า *"ทดสอบ logic ด้วยข้อมูลจำลอง ส่วนการตอบสนองต่อ CO จริง
ไม่ได้ทำการทดสอบด้วยเหตุผลด้านความปลอดภัย"* — **นี่คือคำตอบที่ถูกต้องทางวิศวกรรม
ไม่ใช่จุดอ่อนของโปรเจกต์**

---

## 5. 🏗️ สถาปัตยกรรม — แยกเส้นทางความปลอดภัยออกจาก ML

นี่คือส่วนที่สำคัญที่สุดในเชิงการออกแบบระบบฝังตัว

```
                      ┌─────────────────────────────────────┐
   CO sensor ─UART──▶ │  SAFETY PATH (เรียบง่าย ตรวจสอบได้)  │──▶ 🔴 LED + บี๊บดัง
                      │  if (co_ppm > TH) → เตือนทันที       │    ไม่ผ่านเงื่อนไขใดๆ
                      │  + สะสม dose (ppm×นาที)             │
                      │  ไม่มี ML · ไม่มี network · ไม่มี delay │
                      └─────────────────────────────────────┘
                                    │
   เซนเซอร์อื่น ───────┐            │ (ค่า CO ถูกส่งต่อไปด้วย)
                       ▼            ▼
                      ┌─────────────────────────────────────┐
                      │  ML PATH (ซับซ้อน)                   │──▶ 🟡 anomaly ทั่วไป
                      │  autoencoder + reconstruction error  │    dashboard, log
                      └─────────────────────────────────────┘
```

### 🔑 ทำไมต้องแยก
| เหตุผล | อธิบาย |
|---|---|
| **ML ผิดพลาดในแบบที่คาดเดาไม่ได้** | autoencoder อาจ "ไม่แปลกใจ" กับ CO สูง ถ้าเคยเห็นรูปแบบคล้ายๆ ตอน train |
| **ฟังก์ชันความปลอดภัยต้องตรวจสอบได้** | `if (x > threshold)` พิสูจน์ความถูกต้องได้ · โครงข่ายประสาทเทียมพิสูจน์ไม่ได้ |
| **ต้องทำงานได้แม้ส่วนอื่นพัง** | ถ้า inference ค้าง หรือ Wi-Fi ล่ม หรือ SD เต็ม → เส้นทางความปลอดภัยต้องยังทำงาน |
| **latency ต้องต่ำและแน่นอน** | ML path มี persistence rule หน่วง 20 วินาที · safety path ต้องเตือนทันที |

⭐ **นี่คือหลักการมาตรฐานของงาน safety-critical จริง** (แยก safety function ออกจาก
non-safety function) และเป็นย่อหน้าที่ทำให้รายงานดูโตขึ้นมาก
🔗 โยงกับวิชาระบบฝังตัวโดยตรง: priority ของ task, watchdog, fail-safe state

### ผลต่อ FreeRTOS
| Task | Priority | เปลี่ยนอะไร |
|---|---|---|
| **`safety_task`** | **6 (สูงสุด)** | 🆕 อ่าน CO + ตรวจ threshold + สั่งเตือน · ห้ามบล็อกกับอะไรทั้งสิ้น |
| `sensor_task` | 5 | เดิม |
| `infer_task` | 4 | เดิม |
| `net_task` | 3 | เดิม |
| `log_task` | 2 | เดิม |

⚠️ **สถานะ FAULT ต้องครอบคลุมเซนเซอร์ CO ด้วย** — ถ้า CO sensor ไม่ตอบหรือค่าออกนอกช่วง
ต้องเข้า FAULT และ**แสดงให้ผู้ใช้เห็นชัด** ไม่ใช่เงียบๆ แล้วทำงานต่อ
(เซนเซอร์ความปลอดภัยที่พังเงียบๆ อันตรายกว่าไม่มีเซนเซอร์เลย เพราะสร้างความมั่นใจผิดๆ)

---

## 6. แก๊สอันตรายอื่นที่พิจารณาได้

| แก๊ส | อันตรายแบบไหน | คุ้มที่จะเพิ่มไหม |
|---|---|---|
| **CO** | 🔴 เฉียบพลัน ถึงตาย · ไม่มีสีไม่มีกลิ่น | ✅ **คุ้มที่สุด** — ดู §1 |
| **LPG / มีเทน (แก๊สหุงต้ม)** | 🔴 ระเบิด + ขาดออกซิเจน | 🟢 **คุ้ม** — MQ-5/MQ-6 ถูกและใช้ง่าย · ⚠️ แต่แก๊สหุงต้มมีสารแต่งกลิ่นอยู่แล้ว คนได้กลิ่นก่อน |
| **NO₂** | 🟠 ทำลายทางเดินหายใจ · จากเตาแก๊ส | 🟠 เกี่ยวกับภูมิแพ้โดยตรง แต่เซนเซอร์ที่แม่นราคาสูง |
| **CO₂ ระดับสูงมาก** | 🟠 ขาดออกซิเจน (ต้องสูงมากผิดปกติ) | ✅ SCD40 มีอยู่ในแผนอยู่แล้ว |
| **ฟอร์มาลดีไฮด์** | 🟠 สารก่อมะเร็ง (เรื้อรัง ไม่เฉียบพลัน) | 🟠 ซ้อนทับกับ TVOC บางส่วน |
| **เรดอน** | 🟠 มะเร็งปอด (เรื้อรังมาก) | ❌ ต้องใช้เครื่องเฉพาะทาง ไม่เหมาะกับโปรเจกต์นี้ |
| **H₂S** | 🔴 เฉียบพลัน | ❌ พบน้อยในบ้านพักอาศัย |

### 💡 ข้อเสนอ: เพิ่ม **CO อย่างเดียว** ก่อน
เหตุผล:
1. ให้คุณค่าสูงสุดต่อทั้ง ML และ motivation ของโปรเจกต์
2. เพิ่มทีละอย่างทำให้วิเคราะห์ได้ว่าอะไรมีผลจริง (ถ้าเพิ่มทีเดียว 3 ตัวจะแยกไม่ออก)
3. งบและเวลาของทีม 3 คนมีจำกัด

**ถ้าเหลือเวลาและงบค่อยเพิ่ม LPG (MQ-5/MQ-6)** เป็นลำดับถัดไป — ถูก ต่อ ADC1 ได้
และในบริบทไทยแก๊สหุงต้มรั่วเป็นเหตุการณ์ที่เกิดจริง

---

## 7. ผลต่อการวิเคราะห์ multivariate

### 7.1 เวกเตอร์ตัวแปรใหม่ที่แนะนำ
```
เดิม (มีปัญหา collinearity):
  PM1.0, PM2.5, PM10, TVOC, eCO2, T, RH             → 7 ช่อง แต่มิติจริงน้อยกว่า

ใหม่ (สะอาดกว่าและมีมิติจริงมากกว่า):
  log(PM2.5)          ← ตัวแทนของกลุ่ม PM
  PM2.5/PM10 ratio    ← ข้อมูลเรื่องขนาดอนุภาค
  log(TVOC)           ← ตัด eCO2 ออก (มันอนุมานจาก TVOC)
  log(1 + CO_ppm)     ← 🆕 มิติใหม่ที่เป็นอิสระจริง
  T, RH
  hour_sin, hour_cos
                                                     → 8 ช่อง แต่ independent มากกว่าเดิม
```
🔑 **ได้ตัวแปรเพิ่มขึ้น 1 ตัว แต่ได้มิติที่แท้จริงเพิ่มขึ้นมากกว่านั้น** เพราะตัดตัวที่ซ้ำซ้อนออกไปด้วย

### 7.2 Threshold ของ Mahalanobis เปลี่ยน
เมื่อ p เปลี่ยนจาก 8 → 9 ค่าวิกฤต χ² ที่ α = 0.001 เปลี่ยนจาก **26.12 → 27.88**
(เปิดตาราง χ² ยืนยันเอง — อย่าจำตัวเลข)

### 7.3 🧪 การทดลองที่น่าสนใจขึ้นมาใหม่
| การทดลอง | คำถามวิจัย |
|---|---|
| E1 จุดธูป + วัด CO | CO ขึ้นตามสัดส่วนกับ PM ไหม? อัตราส่วน CO/PM2.5 บอกชนิดของการเผาไหม้ได้ไหม |
| E3 ฉีดแอลกอฮอล์ + วัด CO | ⚠️ **cross-sensitivity** — เซนเซอร์รายงาน CO ขึ้นทั้งที่ไม่มี CO จริงหรือไม่ |
| Ablation: มี/ไม่มีช่อง CO | PR-AUC ของ E1/E2 ดีขึ้นเท่าไรเมื่อเพิ่ม CO |

⭐ **การทดลองข้อ 2 มีค่ามาก** — ถ้าพบว่าแอลกอฮอล์ทำให้เซนเซอร์รายงาน CO เท็จ
นั่นคือ**หลักฐานเชิงประจักษ์ว่าทำไมเซนเซอร์ราคาประหยัดจึงใช้เป็นอุปกรณ์นิรภัยไม่ได้**
ซึ่งเป็นข้อสรุปที่มีน้ำหนักและซื่อสัตย์ เหมาะกับการเขียนในบทสรุป

---

## สิ่งที่ต้องจำ

- 🔴 **เครื่องที่เราสร้างไม่ใช่ CO alarm** — มาตรฐาน UL 2034 / EN 50291 ตัดสินที่**อัลกอริทึมและเวลาตอบสนอง**
  ไม่ใช่แค่ว่าเซนเซอร์อ่านค่าได้ · เซนเซอร์เปล่าคือ "ชิ้นส่วน" ไม่ใช่ "อุปกรณ์นิรภัย"
- 🔴 **ถ้าทำการทดลองที่มีการเผาไหม้ ต้องมี CO alarm ที่ได้มาตรฐานอยู่ในห้อง** — ควรทำอยู่แล้ว
- 🔴 **ห้ามสร้าง CO เพื่อทดสอบ** — CO ไม่มีสีไม่มีกลิ่น และอาการเริ่มต้นทำให้ตัดสินใจแย่ลง
  → **ทดสอบ logic ด้วยข้อมูลจำลองทางไฟฟ้าแทน ได้ผลครบถ้วนและปลอดภัย 100%**
- ✅ **เลือก ZE07-CO (electrochemical) ไม่ใช่ MQ-7** — ให้ ppm จริงผ่าน UART, มีชดเชยอุณหภูมิ,
  ไม่ต้องสลับแรงดันฮีตเตอร์เป็นรอบ
- 🏗️ **แยก safety path ออกจาก ML path** — `if (co > TH)` ที่ priority สูงสุด ไม่ผ่าน autoencoder
  เพราะฟังก์ชันความปลอดภัยต้องเรียบง่ายและตรวจสอบได้
- ⚠️ **เซนเซอร์ CO ที่พังเงียบๆ อันตรายกว่าไม่มีเลย** — ต้องเข้า FAULT และแสดงให้เห็นชัด
- 📐 **พิษ CO เป็นแบบสะสม (ppm × เวลา)** ไม่ใช่แค่ threshold ทันที · 400 ppm อันตรายถึงชีวิต ·
  800 ppm+ เสียชีวิตได้ในไม่กี่นาที
- 🔑 **CO เป็นมิติที่เป็นอิสระจริง** (electrochemical คนละหลักการกับทุกช่องเดิม) →
  แก้ปัญหา collinearity แทนที่จะเพิ่มปัญหา
- 🇹🇭 **บริบทไทย: เครื่องทำน้ำอุ่นแก๊สในห้องน้ำที่ไม่มีช่องระบายอากาศ** —
  34 เหตุการณ์ เสียชีวิต 10 ราย (2551–2568) → motivation ที่หนักแน่น
  แต่**ห้ามอ้างว่าเครื่องเราป้องกันได้**
- 🧪 **ทดลอง cross-sensitivity กับแอลกอฮอล์** — ถ้าเจอค่า CO เท็จ นั่นคือหลักฐานที่ดีที่สุด
  ว่าทำไมเซนเซอร์ราคาประหยัดใช้เป็นอุปกรณ์นิรภัยไม่ได้

---

### คำถามทวนความเข้าใจ (ยังไม่เฉลย)

1. 📐 ออกแบบ logic การเตือนแบบ **dose** แทน threshold ทันที — ให้สะสม `ppm × นาที`
   แล้วเตือนเมื่อเกินค่าที่กำหนด ลองคิดว่า: ที่ 50 ppm ต่อเนื่อง 8 ชั่วโมง กับที่ 400 ppm ต่อเนื่อง 30 นาที
   dose ต่างกันเท่าไร? แล้วทำไมมาตรฐานจริงถึงไม่ใช้ dose อย่างเดียวแต่ใช้**เส้นโค้งความเข้มข้น–เวลา**?
   (ใบ้: คิดถึงว่าร่างกายขับ CO ออกได้ด้วย)

2. 🏗️ ถ้า `safety_task` มี priority สูงสุดและอ่าน CO ทุกวินาที — จะเกิดอะไรขึ้นถ้าเซนเซอร์ CO
   ตอบช้าหรือค้างกลางคัน? ออกแบบให้ `safety_task` ไม่ถูกบล็อกโดยเซนเซอร์ที่ค้าง
   แล้วยังตรวจจับได้ว่าเซนเซอร์ค้าง — ต้องใช้กลไกอะไรบ้าง (ใบ้: timeout, watchdog, heartbeat)

3. ⚠️ สมมติทดลอง E3 (ฉีดแอลกอฮอล์) แล้วเซนเซอร์รายงาน CO = 80 ppm ทั้งที่ไม่มีการเผาไหม้เลย
   ถ้าคุณต้องออกแบบให้ระบบ**แยกแยะ CO จริงออกจากค่าเท็จ** โดยใช้ช่องสัญญาณอื่นที่มีอยู่
   คุณจะใช้เงื่อนไขอะไร? และวิธีนี้มีข้อจำกัดอะไรที่ทำให้ยังใช้เป็นอุปกรณ์นิรภัยไม่ได้อยู่ดี?
