Sh080205/AirGuard/docs/05-MULTIVARIATE.md

# AirGuard-S3 — การวิเคราะห์แบบ Multivariate

**สำหรับ:** คน C (ML & Data) · เชื่อมกับวิชา 03603312 ความน่าจะเป็นและสถิติ
**ปรับปรุง:** 27 ก.ค. 2569

---

## 0. ⚠️ ชี้ก่อนตอบ — โปรเจกต์เป็น multivariate อยู่แล้ว

โปรเจกต์นี้วัด **7 ช่องสัญญาณพร้อมกัน** (`PM1.0, PM2.5, PM10, TVOC, eCO2, T, RH`)
→ **ข้อมูลเป็น multivariate ตั้งแต่แรกแล้ว**

> 📌 หมายเหตุเรื่องคำศัพท์: คำที่ใช้ในวิชาสถิติคือ **multivariate** (หลายตัวแปร)
> ส่วน **variance / covariance** คือค่าความแปรปรวน — คำว่า "multivariance" ไม่ใช่ศัพท์มาตรฐาน

### คำถามที่แท้จริงคือ

**"เรากำลังใช้ประโยชน์จากความสัมพันธ์ระหว่างช่องสัญญาณอยู่หรือเปล่า"**

เพราะ 🔑 **ข้อมูล multivariate ≠ วิธีวิเคราะห์ multivariate**

| แนวทาง | ทำอะไร | เป็น multivariate จริงไหม |
|---|---|---|
| ตั้ง threshold แยกทีละช่อง 8 อัน แล้ว OR กัน | ดูทีละตัวแปร | ❌ **ไม่ใช่** — เป็น univariate 8 ตัวมาต่อกัน |
| Mahalanobis / Hotelling T² | ใช้ **เมทริกซ์ความแปรปรวนร่วม (Σ)** | ✅ ใช่ |
| PCA + SPE | หาทิศทางที่ข้อมูลแปรปรวนร่วมกัน | ✅ ใช่ |
| Autoencoder | เรียนความสัมพันธ์แบบไม่เชิงเส้น | ✅ ใช่ |

---

## 1. 🧪 ทำไมมันสำคัญ — ตัวอย่างที่รันจริงแล้ว

### สถานการณ์: ห้องปิดที่เปิดแอร์
ในห้องปิด **อุณหภูมิขึ้น → ความชื้นสัมพัทธ์ลง** (สหสัมพันธ์ผกผัน ≈ −0.8)
เพราะอากาศร้อนอุ้มไอน้ำได้มากขึ้น RH จึงลดลงเมื่อปริมาณไอน้ำเท่าเดิม

### เหตุการณ์ผิดปกติ: **T ขึ้น และ RH ขึ้น พร้อมกัน**
(เช่น มีคนเข้ามาหลายคน หรือต้มน้ำ หรือแอร์เสีย)

| | ค่า | ห่างจากค่าเฉลี่ย |
|---|---|---|
| อุณหภูมิ | 28 °C | **1.32 σ** |
| ความชื้น | 68 % | **1.61 σ** |

**ผลการตรวจจับ (จำลอง 20,000 จุด):**

| วิธี | จับ anomaly นี้ได้ | false positive บนข้อมูลปกติ |
|---|---|---|
| **Univariate 3σ ทีละช่อง** | ❌ **0.0%** — มองไม่เห็นเลย | 0.38% |
| **Mahalanobis (α = 0.001)** | ✅ **100%** (d² = 20.9 > เกณฑ์ 13.8) | 0.07% |

🔑 **ทั้งสองช่องอยู่ในช่วงปกติเมื่อดูทีละตัว แต่ "การรวมกัน" ของมันเป็นไปไม่ได้ทางฟิสิกส์**
univariate มองไม่เห็นเพราะมันไม่รู้ว่าสองตัวนี้ควรสัมพันธ์กันอย่างไร

⭐ **นี่คือย่อหน้าที่ควรอยู่ในบทนำของรายงาน** — ตอบคำถาม "ทำไมไม่ใช้ threshold" ได้แรงกว่าคำอธิบายลอยๆ
และเป็นการทดลองที่ทำซ้ำได้ในไม่กี่บรรทัด

---

## 2. 📐 Mahalanobis Distance — คณิตศาสตร์และที่มา

### สูตร
```
d²(x) = (x − μ)ᵀ Σ⁻¹ (x − μ)
```
| สัญลักษณ์ | ความหมาย | หน่วย |
|---|---|---|
| `x` | เวกเตอร์การวัด ณ เวลาหนึ่ง | p มิติ |
| `μ` | เวกเตอร์ค่าเฉลี่ยของข้อมูลปกติ | p มิติ |
| `Σ` | เมทริกซ์ความแปรปรวนร่วม (p×p) | — |
| `d²` | ระยะทางกำลังสอง | **ไม่มีหน่วย** |

### เทียบกับระยะทางแบบยุคลิด
```
Euclidean : d² = (x−μ)ᵀ (x−μ)        ← ถือว่าทุกแกนเท่ากันและไม่สัมพันธ์กัน
Mahalanobis: d² = (x−μ)ᵀ Σ⁻¹ (x−μ)   ← Σ⁻¹ ทำหน้าที่ "ปรับสเกล + คลายสหสัมพันธ์"
```
🔑 **`Σ⁻¹` คือหัวใจ** — มันทำสองอย่างพร้อมกัน:
1. **ปรับสเกล** — PM2.5 (0–500 µg/m³) กับ RH (0–100 %) มีสเกลต่างกันมาก ถ้าใช้ระยะยุคลิด PM จะครอบงำทุกอย่าง
2. **คลายสหสัมพันธ์** — ทำให้ทิศทางที่ข้อมูลปกติ "แปรปรวนร่วมกันได้" ถูกลงโทษน้อย
   ส่วนทิศทางที่ไม่ควรเกิด ถูกลงโทษหนัก

### 🔗 ที่มาของ threshold (จุดที่เชื่อมกับวิชา 03603312 โดยตรง)
ถ้าข้อมูลปกติแจกแจงแบบ **multivariate normal** แล้ว
```
d² ~ χ²(p)      เมื่อ p = จำนวนตัวแปร
```
→ **ตั้ง threshold จากค่าวิกฤต χ² ได้เลย ไม่ต้องเดา percentile**

| p (ตัวแปร) | α=0.05 | α=0.01 | **α=0.001** | α=0.0001 |
|---|---|---|---|---|
| 3 | 7.81 | 11.34 | 16.27 | 21.11 |
| 5 | 11.07 | 15.09 | 20.52 | 25.74 |
| 6 | 12.59 | 16.81 | 22.46 | 27.86 |
| **8** | 15.51 | 20.09 | **26.12** | 31.83 |
| 10 | 18.31 | 23.21 | 29.59 | 35.56 |
| 15 | 25.00 | 30.58 | 37.70 | 44.26 |
| 20 | 31.41 | 37.57 | 45.31 | 52.39 |
| 30 | 43.77 | 50.89 | 59.70 | 67.63 |

### 📐 แปลง α เป็น false alarm ต่อวัน (1 หน้าต่าง / 10 วิ = 8,640 หน้าต่าง/วัน)

| α | alert/วัน (ดิบ) | + persistence k=3 |
|---|---|---|
| 0.05 | 432 ❌ | ~1.1 |
| 0.01 | 86 ❌ | ~0.009 |
| **0.001** | **8.6** 🟠 | **~0.00001** ✅ |
| 0.0001 | 0.9 ✅ | ~0 |

⭐ **นี่คือข้อได้เปรียบใหญ่ของวิธี multivariate เชิงสถิติ:**
**threshold มีที่มาทางทฤษฎี** — เลือก α ที่ยอมรับได้ แล้วเปิดตาราง χ² ไม่ต้องไล่ปรับ percentile แบบมั่วๆ
ส่วน autoencoder ไม่มีคุณสมบัตินี้ ต้องหา threshold จาก validation set เอาเอง

---

## 3. ⚠️ 4 ปัญหาที่ต้องแก้ก่อนใช้จริง

### 3.1 🔴 Collinearity — ปัญหาที่ชุดเซนเซอร์ของเรามีแน่นอน

`Σ⁻¹` จะระเบิดถ้า `Σ` ใกล้ singular ซึ่งเกิดเมื่อมีช่องสัญญาณที่สัมพันธ์กันเกือบสมบูรณ์

**ผลการทดสอบ condition number:**

| สหสัมพันธ์ | condition number | สถานะ |
|---|---|---|
| 0.90 | 15.4 | ✅ ปลอดภัย |
| 0.98 | 93.6 | 🟠 เริ่มเสี่ยง |
| **0.999** | **1,979.6** | ❌ **Σ ใกล้ singular — ผลลัพธ์เชื่อไม่ได้** |

**ชุดเซนเซอร์ของเรามีปัญหานี้ 2 จุด:**

| คู่ที่มีปัญหา | ทำไม |
|---|---|
| **PM1.0 / PM2.5 / PM10** | มาจาก**เซนเซอร์ตัวเดียวกัน** วัดการกระเจิงแสงครั้งเดียวแล้วแยกเป็น 3 ช่วงขนาด → สหสัมพันธ์สูงมากโดยธรรมชาติ |
| 🔴 **TVOC / eCO2 ของ ENS160** | **eCO2 ถูกอนุมานมาจาก VOC โดยตรง** ไม่ใช่การวัดอิสระ → เกือบเป็นฟังก์ชันกันแบบ deterministic |

**วิธีแก้ (เลือกทำ):**
1. ✅ **ตัด eCO2 ออกจากเวกเตอร์** — ใช้ TVOC อย่างเดียว (ถ้าอยาก CO₂ จริงต้องซื้อ SCD40)
2. ✅ **ใช้ PM2.5 + PM2.5/PM10 ratio แทน PM1.0/2.5/10 ทั้งสามตัว** — ได้ข้อมูลเท่าเดิมแต่ตัวแปรน้อยลงและสัมพันธ์กันน้อยลง
3. ✅ **Shrinkage estimator (Ledoit–Wolf)** — <code>sklearn.covariance.LedoitWolf</code> ทำ regularization ให้อัตโนมัติ
4. ตรวจ `np.linalg.cond(Sigma)` ทุกครั้ง ถ้าเกิน ~100 ให้กลับไปดูตัวแปร

### 3.2 Non-normality — ข้อมูล PM เบ้ขวาหนัก
χ² threshold ตั้งอยู่บนสมมติฐาน multivariate normal แต่ PM2.5 มีการแจกแจงแบบ log-normal (หางยาวด้านขวา)
→ ✅ **ใช้ `log(1+x)` กับช่อง PM และ TVOC ก่อน** แล้วค่อยคำนวณ Σ
→ ตรวจด้วย Q-Q plot ของ d² เทียบกับ χ² ว่าตรงเส้นไหม — **ใส่รูปนี้ในรายงานได้เลย เป็นการตรวจสมมติฐานที่ถูกต้อง**

### 3.3 Non-stationarity — μ และ Σ เปลี่ยนตามเวลา
อากาศตอนตี 3 กับตอน 6 โมงเย็นมีสถิติคนละชุด
→ ✅ ทางเลือก: (ก) ใส่ `hour_sin/cos` เป็นตัวแปรเพิ่ม (ข) fit แยกตามช่วงเวลา (ค) rolling estimate

### 3.4 ขนาดตัวอย่างที่ต้องมี
Σ มีพารามิเตอร์ **p(p+1)/2** ตัว ยิ่ง p มากยิ่งต้องการข้อมูลมาก

| p | พารามิเตอร์ใน Σ | n ขั้นต่ำ (≥10p) |
|---|---|---|
| 6 | 21 | 60 |
| **8** | **36** | **80** |
| 15 | 120 | 150 |
| 30 | 465 | 300 |

✅ **ข้อนี้เราไม่มีปัญหา** — baseline 14 วันที่ 1 Hz = ~1.2 ล้านตัวอย่าง เหลือเฟือแม้ p = 30

---

## 4. วิธี multivariate 4 แบบที่ควรทำเทียบกัน

| # | วิธี | จับความสัมพันธ์แบบ | threshold มาจาก | จุดแข็ง / จุดอ่อน |
|---|---|---|---|---|
| 1 | **Mahalanobis / Hotelling T²** | เชิงเส้น | ✅ **χ² — มีทฤษฎีรองรับ** | เบามาก ตีความได้ · แต่จับความสัมพันธ์ไม่เชิงเส้นไม่ได้ |
| 2 | **PCA + SPE (Q-statistic)** | เชิงเส้น + แยก subspace | มีสูตรประมาณ | บอกได้ว่าผิดปกติ "ในโมเดล" หรือ "นอกโมเดล" |
| 3 | **Isolation Forest** | ไม่เชิงเส้น | percentile | ไม่ต้องสมมติการแจกแจง · แต่ไม่ใช้เวลา |
| 4 | **Autoencoder** | ไม่เชิงเส้น + เวลา | percentile จาก validation | ยืดหยุ่นสุด · แต่ไม่มีทฤษฎีรองรับ threshold |

### 🔑 PCA + SPE — คู่สถิติคลาสสิกของงาน process monitoring
แยกความผิดปกติออกเป็น **2 ชนิด** ซึ่งมีความหมายทางกายภาพต่างกัน:

| สถิติ | จับอะไร | ตัวอย่างในโปรเจกต์เรา |
|---|---|---|
| **Hotelling T²** (ในซับสเปซหลัก) | ค่าผิดปกติ**ตามทิศทางที่ปกติแปรปรวน** | ฝุ่นเยอะผิดปกติ แต่ยังเป็นรูปแบบเดิม |
| **SPE / Q-statistic** (ในซับสเปซเหลือ) | ข้อมูล**หลุดออกนอกโครงสร้างที่เคยเรียน** | 🔑 T↑RH↑ พร้อมกัน · เซนเซอร์เริ่มพัง |

→ **SPE คือตัวที่จับ "ความสัมพันธ์ที่พังไป" ได้ดีที่สุด** และเป็นตัวที่มักเจอ sensor fault ก่อนใคร

### ⭐ Ablation ที่ทรงพลังที่สุดของโปรเจกต์นี้
> **Autoencoder เชิงเส้นที่มี bottleneck k มิติ ให้ซับสเปซเดียวกับ PCA ที่ k องค์ประกอบ**

→ **เทียบ PCA(k=16) กับ AE(bottleneck=16)** = การทดสอบโดยตรงว่า
**"ความไม่เชิงเส้นของ autoencoder คุ้มค่าหรือไม่"**

ถ้า AE ชนะไม่มาก แปลว่าโครงสร้างของข้อมูลเป็นเชิงเส้นเป็นหลัก → **ควรใช้ PCA เพราะเบากว่า อธิบายได้ และมี threshold เชิงทฤษฎี**
🏆 นี่คือ ablation ที่ทำให้รายงานดูเป็นงานวิจัยจริง และตอบคำถาม "ทำไมต้องใช้ deep learning" ได้อย่างมีหลักฐาน

---

## 5. 🔑 ถ้าจะเพิ่มตัวแปร — เพิ่มอย่างไรให้คุ้ม

### หลักการ: เพิ่ม**มิติใหม่** ไม่ใช่เพิ่ม**มุมมองซ้ำ**

| เพิ่มอะไร | ราคา | ให้มิติใหม่ไหม | คุ้มไหม |
|---|---|---|---|
| PM sensor ตัวที่ 2 | ~700฿ | ❌ ซ้ำกับตัวเดิมเกือบหมด | ❌ ไม่คุ้ม (ยกเว้นทำ redundancy เพื่อจับ fault) |
| **SCD40 (CO₂ จริง)** | ~900฿ | ✅ **เป็นอิสระจริง** วัดคนละหลักการ (NDIR) | 🟢 **คุ้มที่สุดในกลุ่มเซนเซอร์อากาศ** |
| **BH1750 (แสง)** | ~60฿ | ✅ บอกกลางวัน/กลางคืน ไฟเปิด/ปิด | 🟢🟢 **คุ้มมาก ถูกมาก** |
| **PIR (ตรวจการเคลื่อนไหว)** | ~50฿ | ✅ บอกว่ามีคนอยู่ในห้องไหม | 🟢🟢 **คุ้มมาก** |
| ไมค์ MEMS (ระดับเสียง) | ~100฿ | ✅ บอกระดับกิจกรรมในห้อง | 🟢 คุ้ม |
| MQ-135 | ~120฿ | 🟠 ซ้อนทับกับ TVOC และ drift หนัก | 🟠 ใช้เป็นตัวอย่างสอน ADC เท่านั้น |

### 💡 ข้อเสนอที่คุ้มที่สุด: เพิ่มบริบท "กิจกรรมของมนุษย์"
🔑 **ตัวขับเคลื่อนคุณภาพอากาศในห้องอันดับหนึ่งคือคน** — คนเข้าห้อง ทำอาหาร จุดธูป เปิดหน้าต่าง กวาดบ้าน

**BH1750 + PIR รวมกันไม่ถึง 120 บาท** แต่ให้ 2 มิติที่เกือบเป็นอิสระจากทุกช่องเดิม และอธิบายความแปรปรวนได้มาก:

| เหตุการณ์ | PM | TVOC | แสง | PIR | แยกออกจากกันได้ไหม |
|---|---|---|---|---|---|
| จุดธูปตอนกลางคืน | ↑↑ | ↑ | ต่ำ | มี | ✅ |
| แดดส่อง ฝุ่นลอย ไม่มีคน | ↑ | — | **สูง** | **ไม่มี** | ✅ แยกจากข้างบนได้ชัด |
| คนนอนหลับ 8 ชม. | — | — | ต่ำ | ไม่มี | ✅ |
| ทำอาหาร | ↑↑ | ↑↑ | สูง | มี | ✅ |

→ ถ้าไม่มี PIR/แสง สองแถวแรกจะดูคล้ายกันมากในสายตาโมเดล

### ⚠️ แต่เพิ่มตัวแปรไม่ฟรี
- Σ โตแบบ **p²** → ต้องการข้อมูลมากขึ้น (แต่เรามีเหลือเฟือ)
- **Curse of dimensionality** — ในมิติสูง ทุกจุดดูห่างกันเท่าๆ กัน วิธีที่อาศัยระยะทางจะเสื่อมประสิทธิภาพ
- ตัวแปรที่ซ้ำซ้อนเพิ่ม noise โดยไม่เพิ่มข้อมูล และทำให้ Σ ใกล้ singular

### 📊 ตรวจ "มิติที่แท้จริง" ของข้อมูล
คำนวณ eigenvalue ของเมทริกซ์สหสัมพันธ์ แล้วดูว่ากี่ PC อธิบายความแปรปรวนได้ 95%

```python
import numpy as np
R = np.corrcoef(X_scaled.T)
ev = np.sort(np.linalg.eigvalsh(R))[::-1]
cum = np.cumsum(ev) / ev.sum()
k95 = np.searchsorted(cum, 0.95) + 1
print(f"มี {X.shape[1]} ช่อง แต่มิติที่แท้จริง ≈ {k95}")
```
⭐ ถ้าผลออกมาว่า "7 ช่อง แต่ 3 PC อธิบายได้ 95%" → **นั่นคือผลลัพธ์ที่ควรรายงาน**
เพราะมันบอกว่าเซนเซอร์ที่ซื้อมาซ้ำซ้อนกันแค่ไหน และเป็นข้อมูลที่มีประโยชน์กับคนที่จะทำต่อ

---

## 6. แผนการทดลองที่แนะนำ

| ขั้น | ทำอะไร | สัปดาห์ |
|---|---|---|
| 1 | คำนวณ **correlation matrix + heatmap** ของ 7 ช่อง → หาคู่ที่ collinear | W05 |
| 2 | **log-transform** ช่อง PM/TVOC → ตรวจ Q-Q plot ของ d² เทียบ χ² | W05 |
| 3 | ตรวจ `cond(Σ)` → ตัด/รวมตัวแปรจนได้ชุดที่เสถียร | W05 |
| 4 | คำนวณ **effective dimensionality** (eigenvalue spectrum) | W06 |
| 5 | Mahalanobis + χ² threshold → วัด false alarm/วัน จริง | W06 |
| 6 | PCA + T² + SPE แยกสองสถิติ | W08 |
| 7 | Isolation Forest | W08 |
| 8 | Autoencoder | W08 |
| 9 | ⭐ **Ablation: PCA(k) vs linear-AE(k) vs nonlinear-AE(k)** | W12 |
| 10 | ⭐ **Ablation: ตัดทีละช่องแล้วดู PR-AUC ตก** → ช่องไหนสำคัญจริง | W12 |

### ตารางผลที่ต้องกรอก
| วิธี | PR-AUC | Event detect | FA/วัน | threshold มาจาก | ขนาดโมเดล |
|---|---|---|---|---|---|
| Univariate 3σ (baseline) | ? | ? | ? | เดา | ~0 |
| **Mahalanobis** | ? | ? | ? | ✅ **χ²(p)** | p²/2 ตัวเลข |
| PCA + SPE | ? | ? | ? | สูตรประมาณ | p·k |
| Isolation Forest | ? | ? | ? | percentile | ต้นไม้ |
| **Autoencoder int8** | ? | ? | ? | percentile | **32.4 KB** |

---

## สิ่งที่ต้องจำ

- ⚠️ **โปรเจกต์เป็น multivariate อยู่แล้ว** (7 ช่อง) — ประเด็นคือ**วิธีวิเคราะห์** ไม่ใช่จำนวนตัวแปร
- 🔑 **ข้อมูล multivariate ≠ วิธี multivariate** — threshold แยกทีละช่องแล้ว OR กัน ยังเป็น univariate
- 🧪 **ตัวอย่างที่พิสูจน์แล้ว:** T=28°C + RH=68% พร้อมกัน — univariate 3σ จับได้ **0%**, Mahalanobis จับได้ **100%**
  (แต่ละช่องห่างแค่ 1.3 และ 1.6 σ — ไม่ผิดปกติเลยเมื่อดูทีละตัว)
- 📐 **`Σ⁻¹` คือหัวใจ** — ปรับสเกลและคลายสหสัมพันธ์พร้อมกัน
- ⭐ **d² ~ χ²(p) → threshold มีที่มาทางทฤษฎี** ไม่ต้องเดา percentile · p=8, α=0.001 → **26.12**
- 🔴 **eCO2 ของ ENS160 อนุมานมาจาก TVOC** — ใส่ทั้งคู่ใน Σ ทำให้ singular **ให้ตัด eCO2 ออก**
- 🔴 **PM1.0/2.5/10 มาจากเซนเซอร์ตัวเดียว** สหสัมพันธ์สูงมาก → ใช้ **PM2.5 + ratio** แทนทั้งสามตัว
- ⚠️ ตรวจ `cond(Σ)` เสมอ — เกิน ~100 คือสัญญาณอันตราย · ใช้ **Ledoit–Wolf shrinkage** ช่วยได้
- ⚠️ **log-transform ช่อง PM ก่อน** ไม่งั้นสมมติฐาน normal พังและ χ² threshold ใช้ไม่ได้
- ⭐ **PCA(k) ≈ linear autoencoder(k)** → เทียบกันคือการทดสอบว่า "ความไม่เชิงเส้นคุ้มไหม" ← ablation ที่ดีที่สุด
- 💡 **อยากเพิ่มตัวแปร ให้เพิ่ม BH1750 + PIR (รวมไม่ถึง 120฿)** ได้มิติใหม่ที่เป็นอิสระจริง
  คุ้มกว่าซื้อ PM sensor ตัวที่สอง เพราะ**คนคือตัวขับเคลื่อนคุณภาพอากาศในห้องอันดับหนึ่ง**
- 📊 **คำนวณ effective dimensionality** — "7 ช่อง แต่ 3 PC อธิบายได้ 95%" คือผลลัพธ์ที่ควรรายงาน

---

### คำถามทวนความเข้าใจ (ยังไม่เฉลย)

1. 📐 ถ้าเพิ่มตัวแปรจาก 8 เป็น 12 โดยยังใช้ α = 0.001 เท่าเดิม —
   เปิดตาราง χ² ดูว่า threshold เปลี่ยนจาก 26.12 เป็นเท่าไร
   แล้วอธิบายว่า**ทำไม threshold ต้องสูงขึ้นเมื่อมีตัวแปรมากขึ้น**
   (ใบ้: คิดถึงว่า d² คือผลรวมของอะไรบ้าง) และถ้าตัวแปรที่เพิ่มมาเป็นสัญญาณรบกวนล้วนๆ
   ความสามารถในการตรวจจับจะดีขึ้นหรือแย่ลง?

2. 🧪 สมมติคุณคำนวณ Mahalanobis แล้วพบว่า d² ของ**ทุกจุด**รวมทั้งข้อมูลปกติ สูงผิดปกติหมด (เช่น เกิน 1000)
   ให้ไล่หาสาเหตุ 3 ข้อที่เป็นไปได้มากที่สุด และแต่ละข้อจะตรวจสอบด้วยคำสั่งอะไร
   (ใบ้: §3.1 และ §3.2)

3. ⭐ Mahalanobis ใช้ **Σ ชุดเดียวสำหรับข้อมูลทั้งหมด** แต่เรารู้ว่าสถิติของอากาศตอนตี 3
   กับตอน 6 โมงเย็นต่างกัน — ออกแบบวิธีจัดการ 3 แบบ (ใส่ hour เป็นตัวแปร / fit แยกตามช่วงเวลา /
   rolling estimate) แล้วเปรียบเทียบว่าแต่ละแบบแลกอะไรกับอะไร
   โดยเฉพาะ**ผลต่อความสามารถในการจับ anomaly ที่กินเวลานานหลายชั่วโมง**
