Sh080205/AirGuard/docs/slides/img/PCB_PCB3_2026-11-04.png

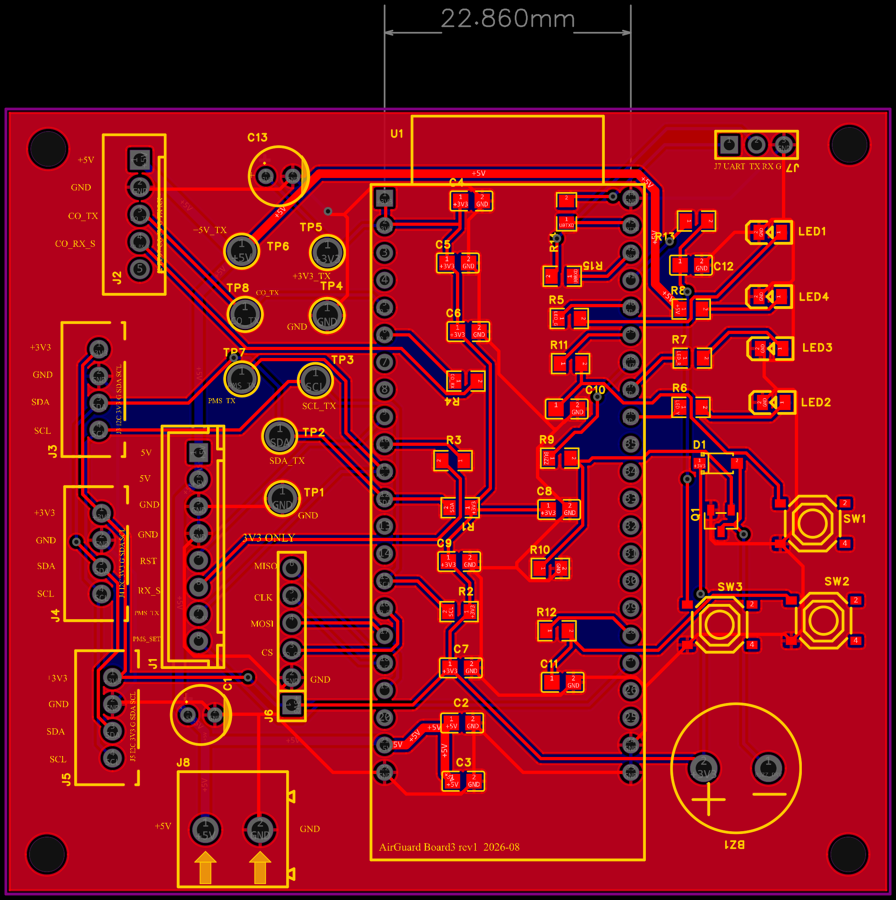
docs/slides/img/PCB_PCB3_2026-11-04.png
