Sh080205/AirGuard/docs/slides/img/render-box-closed.png

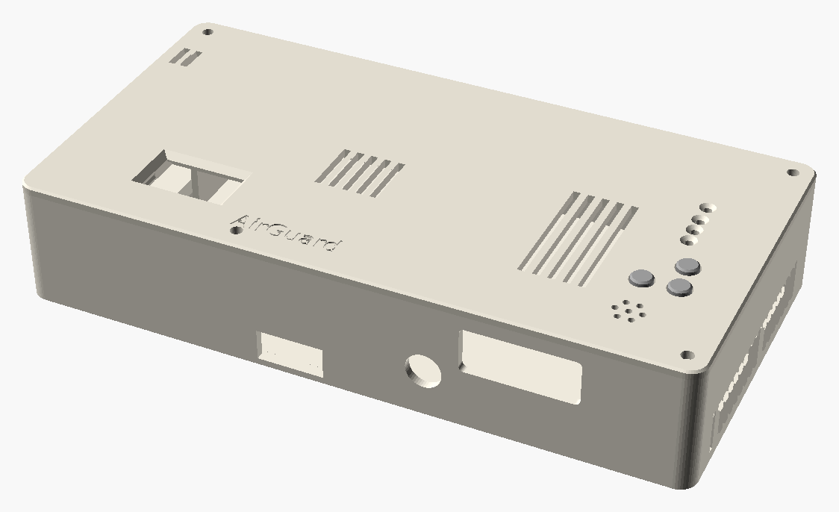
docs/slides/img/render-box-closed.png
