Sh080205/AirGuard/docs/slides/img/sim-dash-alarm.png

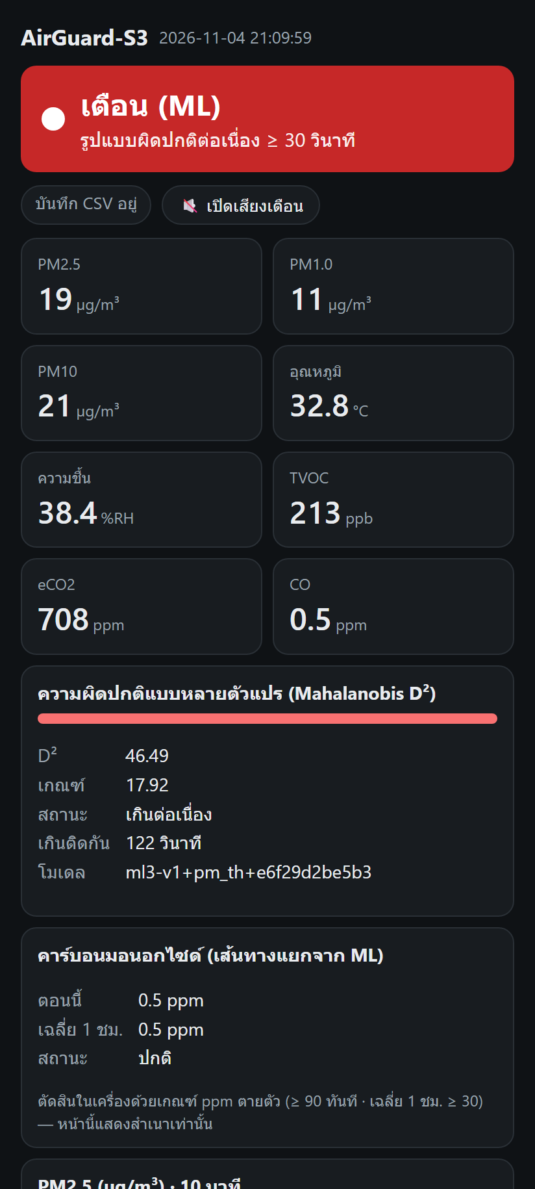
docs/slides/img/sim-dash-alarm.png
