Sh080205/AirGuard/hardware/frame/preview_iso.png

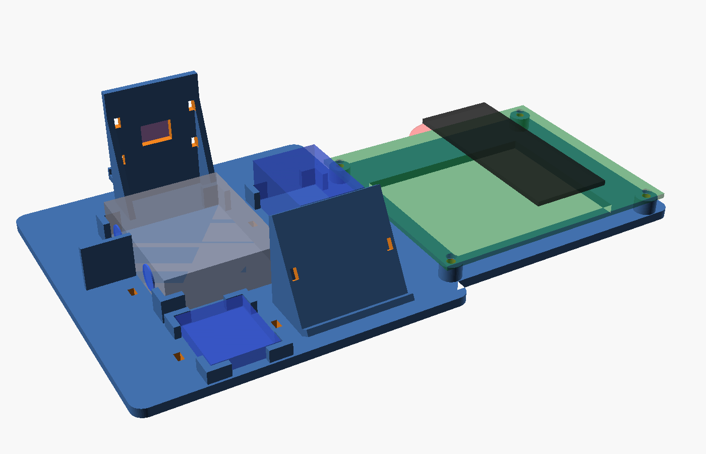
hardware/frame/preview_iso.png
