Sh080205/AirGuard/docs/slides/img/BOM_Board3_PCB3_2026-11-04.csv

No. | Quantity | Comment | Designator | Footprint | Value | Manufacturer Part | Manufacturer | Supplier Part | Supplier | Pin Count | Device
1 | 1 | buzzer | BZ1 | BUZ-TH_BD12.0-P6.00-D0.9-RD | 3V3 ACTIVE | buzzer |  | BUZZER.1 | LCSC | 2 | buzzer
2 | 2 | 470uF/16V | C1,C13 | CAP-TH_BD5.5-P2.50-D0.5-FD_RYHT16V470UF5.5X11 | 470uF/16V | RYHT16V470UF5.5*11 | HONOR(荣誉) | RYHT16V470UF5.5*11.1 | LCSC | 2 | RYHT16V470UF5.5*11
3 | 2 | 10uF | C2,C4 | C0805 | 10uF | CL21A106KAYNNNE | SAMSUNG(三星) | CL21A106KAYNNNE.1 | LCSC | 2 | CL21A106KAYNNNE_C15850
4 | 9 | 100nF | C3,C5,C6,C7,C8,C9,C10,C11,C12 | C0805 | 100nF | CC0805KRX7R9BB104 | YAGEO(国巨) | CC0805KRX7R9BB104.1 | LCSC | 2 | CC0805KRX7R9BB104
5 | 1 | 1N4148W | D1 | SOD-123F_L2.7-W1.6-LS3.8-RD | 1N4148W | 1N4148W | ST(先科) | 1N4148W_C81598.1 | LCSC | 2 | 1N4148W_C81598
6 | 1 | B8B-XH-A | J1 | CONN-TH_B8B-XH-A-LF-SN | PMS7003 XH-8P | B8B-XH-A | JST | B8B-XH-A.1 | LCSC | 8 | B8B-XH-A
7 | 1 | SIP5-2.54mm单排针 | J2 | CONN-TH_B5B-XH-A-LF-SN | ZE07-CO XH-5P | SIP5-2.54mm单排针 |  |  | LCSC | 5 | SIP5-2.54mm单排针
8 | 3 | B4B-XH-A(LF)(SN) | J3,J4,J5 | CONN-TH_B4B-XH-A-LF-SN | I2C XH-4P | B4B-XH-A(LF)(SN) | JST | B4B-XH-A(LF)(SN).1 | LCSC | 4 | B4B-XH-A(LF)(SN)
9 | 1 | 长排针,2.54mm,6p | J6 | HDR-TH_6P-P2.54-V-M-A | microSD HDR-6P | 长排针,2.54mm,6p |  | 长排针,2.54MM,6P.1 | LCSC | 6 | 长排针,2.54mm,6p
10 | 1 | HEAD3 | J7 | HDR-TH_3P-P2.54-V-M-2 | UART HDR-3P | HEAD3 |  | HEAD3.1 | LCSC | 3 | HEAD3
11 | 1 | KF128-5.08-2P-AA | J8 | CONN-TH_P5.08_KF128-5.08-2P | 5V IN KF128-2P | KF128-5.08-2P-AA | KEFA(科发) | KF128-5.08-2P.1 | LCSC | 2 | KF128-5.08-2P-AA
12 | 1 | KT-0805YG | LED1 | LED0805-R-RD | KT-0805YG | KT-0805YG | KENTO | Yellow green 0805.1 | LCSC | 2 | KT-0805YG
13 | 1 | KT-0805Y | LED2 | LED0805-R-RD | KT-0805Y | KT-0805Y | KENTO | 17-21SUYC/TR8.1 | LCSC | 2 | KT-0805Y
14 | 1 | KT-0805R | LED3 | LED0805-R-RD | KT-0805R | KT-0805R | KENTO | E6C0805UR.1 | LCSC | 2 | KT-0805R
15 | 1 | KT-0805B | LED4 | LED0805-R-RD | KT-0805B | KT-0805B | KENTO | XL-0805QBC.1 | LCSC | 2 | KT-0805B
16 | 1 | 2N7002 | Q1 | SOT-23-3_L2.9-W1.3-P1.90-LS2.4-BR | 2N7002 | 2N7002 | CJ(江苏长电/长晶) | 2N7002.1 | LCSC | 3 | 2N7002_C8545
17 | 2 | 4.7kΩ | R1,R2 | R0805 | 4.7kΩ | 0805W8F4701T5E | UNI-ROYAL(厚声) | 0805W8F4701T5E.1 | LCSC | 2 | 0805W8F4701T5E
18 | 2 | 470Ω | R3,R8 | R0805 | 470Ω | 0805W8F4700T5E | UNI-ROYAL(厚声) | 0805W8F4700T5E.1 | LCSC | 2 | 0805W8F4700T5E
19 | 1 | 100Ω | R4 | R0805 | 100Ω | 0805W8F1000T5E | UNI-ROYAL(厚声) | 0805W8F1000T5E.1 | LCSC | 2 | 0805W8F1000T5E_C17408
20 | 6 | 220Ω | R5,R6,R7,R11,R12,R13 | R0805 | 220Ω | 0805W8F2200T5E | UNI-ROYAL(厚声) | 0805W8F2200T5E.1 | LCSC | 2 | 0805W8F2200T5E
21 | 3 | 1kΩ | R9,R14,R15 | R0805 | 1kΩ | 0805W8F1001T5E | UNI-ROYAL(厚声) | 0805W8F1001T5E.1 | LCSC | 2 | 0805W8F1001T5E
22 | 1 | 100kΩ | R10 | R0805 | 100kΩ | 0805W8F1003T5E | UNI-ROYAL(厚声) | C149504 | LCSC | 2 | 0805W8F1003T5E
23 | 1 | TS-1187A-B-A-B | SW1 | SW-SMD_4P-L5.1-W5.1-P3.70-LS6.5-TL_H1.5 | MARK | TS-1187A-B-A-B | XKB Connection(中国星坤) | TS-1187A-B-A-B.1 | LCSC | 4 | TS-1187A-B-A-B
24 | 1 | TS-1187A-B-A-B | SW2 | SW-SMD_4P-L5.1-W5.1-P3.70-LS6.5-TL_H1.5 | MODE | TS-1187A-B-A-B | XKB Connection(中国星坤) | TS-1187A-B-A-B.1 | LCSC | 4 | TS-1187A-B-A-B
25 | 1 | TS-1187A-B-A-B | SW3 | SW-SMD_4P-L5.1-W5.1-P3.70-LS6.5-TL_H1.5 | ACK | TS-1187A-B-A-B | XKB Connection(中国星坤) | TS-1187A-B-A-B.1 | LCSC | 4 | TS-1187A-B-A-B
26 | 1 | ESP32-S3-DEVKITC-1-N8R8 | U1 | CONN-TH_ESP32-S3-DEVKITC-1U-N8 | ESP32-S3-DevKitC-1 socket 2x22 | ESP32-S3-DEVKITC-1-N8R8 | ESPRESSIF(乐鑫) | ESP32-S3-DEVKITC-1-N8R8.1 | LCSC | 44 | ESP32-S3-DEVKITC-1-N8R8
