Sh080205/AirGuard/hardware/frame/fit_coupon.stl

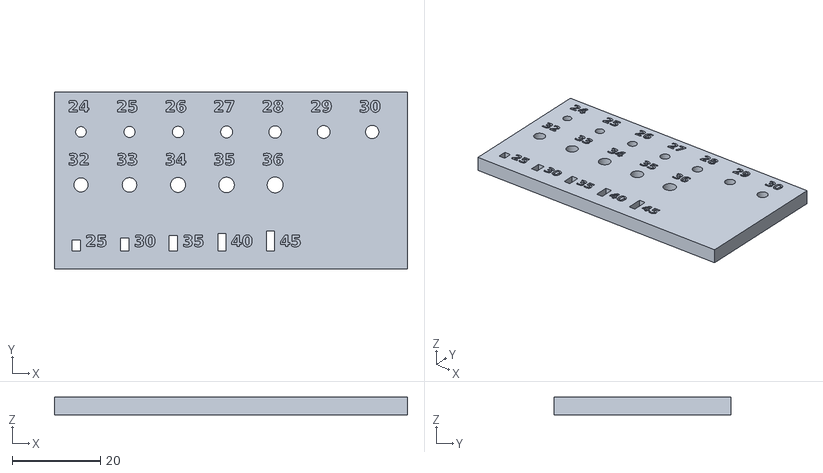
[picture p5: CAD file, 2026-10-03]
hardware/frame/fit_coupon.stl
80.0 x 40.0 x 4.00
