Sh080205/AirGuard/hardware/frame/fit_pms.stl

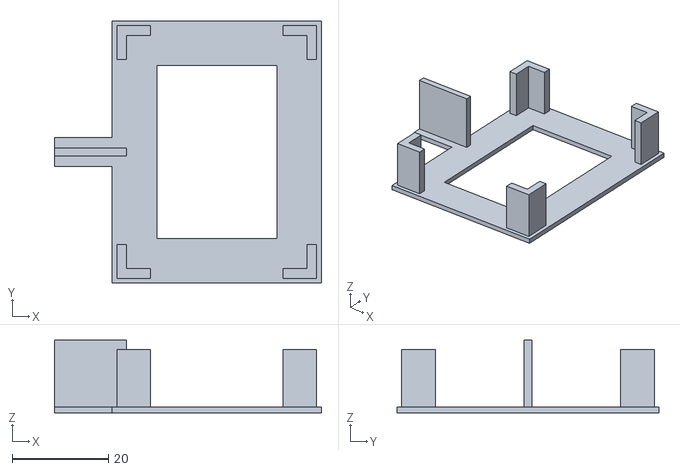
[picture p6: CAD file, 2026-10-03]
hardware/frame/fit_pms.stl
55.6 x 54.6 x 15.2
