Sh080205/AirGuard/hardware/frame/fit_board.stl

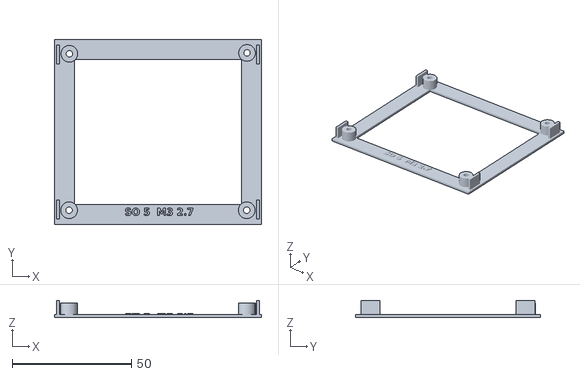
[picture p7: CAD file, 2026-10-03]
hardware/frame/fit_board.stl
86.7 x 77.5 x 7.20
