Sh080205/AirGuard/(list of files, cad)

Other CAD files:
hardware/frame/airguard_frame.scad
