Sh080205/AirGuard/docs/team-guide.html

## 00อะไรเปลี่ยนไปบ้าง

ประเด็น | v2 | v3 (ฉบับนี้) | ผล
สถานที่วัด | นอกอาคาร | ในห้อง (กลับเป็นแบบ v1) | ✅ สร้าง anomaly เองได้อีกครั้ง → labeling กลับมาง่ายและควบคุมได้
ทีม | 3 คน | 3 คน (เหมือนเดิม) | —
PCB | KiCad → โรงงานทั่วไป | EasyEDA → JLCPCB PCBA | ✅ ง่ายขึ้นมาก — ชิ้นส่วนมีเลข LCSC ติดมา BOM/CPL ถูกอัตโนมัติ
วิธีผลิต PCB | สั่ง JLCPCB ประกอบให้ (PCBA) | สั่ง PCB เปล่า บัดกรีเอง + ใช้ carrier board เสียบ DevKitC | 🟢 ถูกลงมาก · ไม่เสียค่า Extended part · ไม่ต้องบัดกรีขาถี่เลย
เซนเซอร์ CO | ไม่มี | เพิ่ม ZE07-CO (v4) | 🔴 ได้มิติที่เป็นอิสระจริง + จับการเผาไหม้ไม่สมบูรณ์ แต่มาพร้อมข้อจำกัดด้านความปลอดภัยที่ห้ามข้าม → §09

✅ กลับมาในห้องแล้วได้อะไรคืน

1. โปรโตคอลทดลอง 9 ข้อกลับมาใช้ได้ (จุดธูป · สเปรย์ · ทำอาหาร · กวาดบ้าน) → ได้ labeled anomaly ที่ควบคุมได้และทำซ้ำได้ ซึ่งเป็นสิ่งที่ v2 ทำไม่ได้
2. ปัญหาความชื้นเบาลงมาก — ในห้อง RH ราว 60–70% ไม่ใช่ 90%+ ตอนเช้ามืดแบบนอกอาคาร
3. ไม่ต้องกันน้ำ ไม่ต้องแก้ปัญหาไฟ ไม่ต้องกันแมลง → ประหยัดงบและเวลาไปมาก
4. อุปกรณ์อยู่ใกล้ตัว → เข้าถึงง่าย ซ่อมเร็ว เหมาะกับทีม 3 คนที่เวลาจำกัด

⚠️ สิ่งที่ต้องยอมรับ เสียแนวคิด "local excess เทียบสถานีอ้างอิง" ไป เพราะข้อมูลนอกอาคารเทียบกับในห้องตรงๆ ไม่ได้
→ แต่ได้ I/O ratio (ในห้อง ÷ นอกอาคาร) มาแทน ซึ่งมีประโยชน์กว่าในเชิงสุขภาพ (ดู §11)
→ และ dataset สาธารณะกลับไปเป็น "ข้อมูลไว้ซ้อม pipeline" ไม่ใช่ training set จริง (ดู §04)

## 01ทำไมต้องทำโปรเจกต์นี้

คนเป็นภูมิแพ้และหอบหืดใช้เวลาส่วนใหญ่ในห้อง และต้องการรู้ว่า "ตอนนี้อากาศในห้องกำลังจะทำให้ฉันมีอาการหรือเปล่า" ซึ่งเครื่องวัดฝุ่นทั่วไปตอบไม่ได้ เพราะมันบอกแค่ตัวเลข ไม่ได้บอกว่าตัวเลขนั้นผิดปกติสำหรับห้องนี้หรือไม่

### ปัญหาที่ผู้ป่วยเจอจริง

- อาการมาก่อนที่ตัวเลขจะเกินเกณฑ์ — มาตรฐานตั้งไว้สำหรับประชากรทั่วไป คนแพ้ไวมีอาการที่ค่าต่ำกว่านั้น
- ไม่รู้ว่าอะไรเป็นตัวกระตุ้น — ฝุ่น? ควันธูป? น้ำยาถูพื้น? ความชื้นที่ทำให้ไรฝุ่นเยอะ?
- ไม่มีหลักฐานไปคุยกับหมอ — บอกได้แค่ "รู้สึกแย่ตอนกลางคืน"

### เกณฑ์อ้างอิง (map เป็นสี LED ได้ทันที)

AQI ไทย | PM2.5 24ชม. | PM10 24ชม. | ความหมาย | LED
0–25 | 0–15.0 | 0–50 | ดีมาก | 🟢
26–50 | 15.1–25.0 | 51–80 | ดี | 🟢
51–100 | 25.1–37.5 | 81–120 | ปานกลาง — คนทั่วไปปกติ แต่กลุ่มเสี่ยงเริ่มมีอาการ | 🟡
101–200 | 37.6–75.0 | 121–180 | มีผลกระทบต่อสุขภาพ | 🔴
>200 | >75.1 | >180 | มีผลกระทบมาก | 🔴+บี๊บ

มาตรฐานไทย PM2.5 24 ชม. = 37.5 µg/m³ (มีผล 1 มิ.ย. 2566) · WHO = 15 µg/m³ · RH ควรคุม 40–60% เพื่อจำกัดไรฝุ่นและเชื้อรา · 🔑 แถวสีเหลืองคือแถวของคนภูมิแพ้

🔑 สิ่งที่ทำให้ต่างจากเครื่องวัดฝุ่นทั่วไป ปุ่ม MARK ให้ผู้ใช้กดตอนมีอาการ → ได้ label ที่ผูก "อาการของคน" เข้ากับ "ข้อมูลเซนเซอร์" ตอบได้ว่าอาการของผู้ใช้คนนี้สัมพันธ์กับตัวแปรไหนมากที่สุด — เครื่องเชิงพาณิชย์ไม่มี

⚠️ ต้องเขียนในรายงานและติดบนตัวเครื่อง เครื่องเฝ้าระวังสภาพแวดล้อม ไม่ใช่เครื่องมือแพทย์ ห้ามใช้วินิจฉัยโรคหรือแทนคำแนะนำแพทย์

## 02ทำไม if-else ไม่พอ

คำถามแรกที่กรรมการจะถามคือ "ทำไมไม่เขียน if (pm25 > 37.5) alert();"

สถานการณ์ | threshold บอกว่า | ความจริง | ประเภท
PM2.5 = 60 ตอนเที่ยง ฤดูเผา | ผิดปกติ! | ปกติของฤดูกาลนั้น เตือนไปก็ไม่มีประโยชน์ | contextual
PM2.5 = 25 ตอนตี 3 ในห้องแอร์ปิดสนิท | ปกติ | ผิดปกติมาก — มีอะไรเผาไหม้ หรือมีคนเข้าห้อง | contextual
TVOC พุ่ง 3 เท่าใน 20 วิ แล้วลงช้าๆ 10 นาที | ปกติถ้าไม่เกินเพดาน | สเปรย์/แอลกอฮอล์/น้ำยาทำความสะอาด — ตัวกระตุ้นภูมิแพ้ชัดเจน | collective
PM2.5 ค้างที่ 8.0 นิ่งสนิท 6 ชั่วโมง | ปกติมาก | เซนเซอร์พัง — พัดลมตันหรือสาย UART หลุด | sensor fault
RH 85% ต่อเนื่อง 3 วัน PM ปกติ | ปกติ | สภาวะที่ไรฝุ่นและเชื้อราขยายพันธุ์ — ความเสี่ยงระยะยาวของคนภูมิแพ้ | contextual

🔑 แนวคิดหลัก เราไม่ได้ถามว่า "ค่านี้สูงไปไหม" แต่ถามว่า "รูปแบบอากาศช่วง 5 นาทีที่ผ่านมา เหมือน 'อากาศปกติของห้องนี้' ที่เราเห็นมา 2 สัปดาห์ไหม"

ให้ autoencoder เรียนบีบอัดข้อมูลปกติแล้วสร้างกลับ — ปกติจะสร้างกลับได้แม่น ผิดปกติจะสร้างกลับไม่ได้ → reconstruction error สูง = ผิดปกติ
ข้อดี: ไม่ต้องรู้ล่วงหน้าว่า anomaly หน้าตายังไง จึงจับสิ่งที่ไม่เคยเห็นได้

## 03นิยาม "ผิดปกติ" 3 แบบ

#### A. Environmental Event

จุดธูป/ยากันยุง · ทำอาหาร · สูบบุหรี่ · สเปรย์ · กวาดบ้าน · เปิดหน้าต่างช่วงรถติด

จับด้วย: AE reconstruction error + ความสัมพันธ์ข้ามช่องสัญญาณ
✅ สร้างเองได้ → เป็นแหล่ง label หลัก

#### B. Sensor / System Fault

พัดลม PMS ตัน · สาย UART หลุด · checksum error · ค่าค้าง · ไฟตก

จับด้วย: rule-based (std=0, frame หาย, ค่านอกช่วง) — ไม่ใช้ AE

#### C. Slow Drift

MOX sensor เสื่อม · ฝุ่นเกาะเลนส์เลเซอร์

จับด้วย: เทียบสถิติรายวันกับ baseline + rolling normalization
⚠️ ห้ามให้ AE จับข้อนี้

⚠️ กับดักที่ทำให้โปรเจกต์พังสัปดาห์ที่ 10 ถ้าเอา drift (C) ไปให้ autoencoder จับ → ผ่านไป 3 สัปดาห์โมเดลจะเตือนตลอดเวลา เพราะการกระจายของ input เลื่อนไปจาก training set แล้ว (concept drift)
คนจะคิดว่า "โมเดลห่วย" แล้วไปแก้โมเดล ทั้งที่ปัญหาคือเอากลไกผิดประเภทมาใช้
→ ต้องแยกกลไก และ normalize ด้วย rolling statistics ไม่ใช่ค่าคงที่จากวันแรก

## 04Dataset ที่ต้องใช้

🔑 หลักการที่ต้องเข้าใจก่อน Autoencoder เป็น unsupervised → train ด้วยข้อมูลปกติล้วนๆ ไม่ต้องมี label
แต่ การประเมินผลต้องมี labeled anomaly ไม่งั้นวัดไม่ได้ว่าโมเดลดีแค่ไหน
และ เราต้องสร้างมันเองด้วยมือ เพราะรอให้เกิดเองไม่ทันเทอม

### 4.1 Dataset สาธารณะ — ใช้ 20 วันแรกที่ยังไม่มีฮาร์ดแวร์

Dataset | เนื้อหา | ใช้ทำอะไร
⭐ UCI Air Quality De Vito et al. | multivariate gas sensor + ค่าอ้างอิง · มี sensor drift ให้เห็นชัด | 🏆 ดีที่สุดสำหรับซ้อม pipeline — หลายช่องสัญญาณเหมือนเรา และมี drift ให้ทดลองแก้
DustBoy / CMU CCDC open-api.cmuccdc.org | PM2.5, PM10, T, RH · 400+ จุดทั่วไทย · ย้อนหลัง 5 ปี | เซนเซอร์ราคาถูกคลาสเดียวกับเรา · ใช้เป็นค่านอกอาคารสำหรับ I/O ratio (§11)
Air4Thai / OpenAQ | PM2.5, PM10, O₃, CO, NO₂, SO₂ · สถานีมาตรฐาน | บริบทฤดูกาลไทย · ค่านอกอาคารอ้างอิง
Sensor.Community Archive | ข้อมูลดิบไม่กรอง · CSV วันละไฟล์ต่อเซนเซอร์ | 🔑 มี sensor fault จริงปนอยู่ → ฝึกตัวตรวจ fault คลาส B โดยไม่ต้องรอเซนเซอร์เราพัง

⚠️ ข้อจำกัดที่ต้องเขียนในรายงาน ข้อมูลสาธารณะทั้งหมดเป็น นอกอาคาร รายชั่วโมง ส่วนเราวัด ในห้อง 1 Hz หลายช่อง
→ ✅ ใช้ซ้อม pipeline · ใช้เป็นค่าอ้างอิงนอกอาคาร · ใช้ศึกษา drift และ fault
→ ❌ ห้ามใช้เป็น training set ของโมเดลที่ deploy จริง — distribution คนละเรื่อง ผิดวิธีวิทยา
⏰ ลงทะเบียน DustBoy API วันนี้ (เลือกสังกัด "นักศึกษา นักวิจัย") เพราะต้องรอแอดมินอนุมัติ

### 4.2 Dataset ที่ต้องเก็บเอง — สินทรัพย์ที่มีค่าที่สุด

#### Phase A — Baseline "ปกติ"

- เก็บ ต่อเนื่อง ≥ 14 วัน ที่ 1 Hz
- ห้ามขยับตำแหน่งเซนเซอร์
- ⚠️ ทิ้งข้อมูล 24–48 ชม.แรก (burn-in ของ ENS160)
- เป้า uptime > 95%
- ใช้เป็น training set

#### Phase B — Induced Anomaly

- 9 การทดลอง × 3 รอบ = 27 events
- จดเวลาเริ่ม–จบตรง NTP
- เก็บใน events.csv แยกจากข้อมูลดิบ
- ใช้เป็น evaluation set เท่านั้น
- 🏆 ปล่อยเป็น open dataset ได้

🏆 ทำไม dataset นี้มีค่ามาก ยังไม่มี labeled indoor air-quality anomaly dataset สาธารณะที่มี ground truth จากเหตุการณ์ที่จงใจสร้าง งานที่มีอยู่ใช้ label แบบคาดเดาหรือใช้เกณฑ์สถิติ → ถ้าปล่อยบน GitHub/Zenodo จะเป็นสิ่งที่คนอื่นเอาไปอ้างอิงได้จริง และทำให้ใบสมัคร ป.โท / สหกิจ ของทั้ง 3 คนโดดเด่นกว่าโปรเจกต์นักศึกษาทั่วไป

## 05โปรโตคอลเก็บข้อมูล Phase B

ID | เหตุการณ์ | คาดว่าจะเห็น | เกี่ยวกับภูมิแพ้ยังไง
E1 | จุดธูป/ยากันยุง ห่าง 2 ม. | PM2.5↑↑ · PM2.5/PM10 ratio↑ | ตัวกระตุ้นหอบหืดคลาสสิกในบ้านไทย
E2 | ทำอาหาร / ทอด | PM↑ + TVOC↑ + T↑ + RH↑ พร้อมกัน | ควันน้ำมันระคายหลอดลม
E3 | ฉีดสเปรย์ / แอลกอฮอล์ | TVOC↑↑ เร็วมาก · PM แทบไม่ขึ้น (signature ชัด) | สารระเหยกระตุ้นภูมิแพ้โดยตรง
E4 | คน 3–4 คนในห้องปิด 30 นาที | CO₂↑ (ถ้ามี SCD40) · RH↑ · PM นิ่ง | อากาศไม่ถ่ายเท สารก่อภูมิแพ้สะสม
E5 | เปิดหน้าต่างช่วงรถติดตอนเย็น | PM10↑ มากกว่า PM2.5 · ratio↓ | มลพิษจราจรเข้าห้อง
E6 | กวาดพื้น / สะบัดผ้าปูที่นอน | PM10↑↑ · ratio↓ ชัดเจน | 🔑 ไรฝุ่นฟุ้ง — ตัวกระตุ้นภูมิแพ้อันดับ 1 ในบ้าน
F1 | ถอดสาย UART ของ PMS | frame หาย / checksum fail | ตรวจว่าเครื่องรู้ตัวว่าพังไหม
F2 | ปิดช่องลมเข้าด้วยเทป | ค่านิ่งผิดธรรมชาติ · rolling std → 0 | จำลองพัดลมตัน/ฝุ่นอุดตัน
F3 | จ่ายไฟไม่พอ (USB อ่อน) | brownout · reset · ค่ากระโดด | เคสที่เกิดจริงบ่อย

#### ทุกรอบต้องบันทึก

events.csv
event_id,run,start_ts,end_ts,operator,distance_m,aircon,fan,window,note
E1,1,2026-09-14T19:32:05+07:00,2026-09-14T19:47:30+07:00,ชิน,2.0,on,off,closed,ธูป 1 ดอก
E6,2,2026-09-15T08:10:00+07:00,2026-09-15T08:18:00+07:00,เพื่อน A,1.5,off,on,open,กวาดพื้น 8 นาที

🔌 ความปลอดภัย ห้ามจุดไฟใกล้บอร์ดหรือแบตเตอรี่ · ทำในที่ระบายอากาศได้ · ไม่ทำ E1/E2 ในหอพักที่ห้ามจุดไฟ — ใช้ E3 และ E6 แทนได้ ปลอดภัยกว่าและ signature ชัดพอ · สมาชิกทีมที่เป็นภูมิแพ้ต้องไม่เป็นคนทำการทดลอง E1/E2/E6

## 06Block Diagram

⚠️ แบ่ง 4 กลุ่มเสมอ ESP32 ไม่ใช่ input · แหล่งจ่ายไฟ ไม่ใช่ output — ถ้าผิดหน้าแรก กรรมการทักทันที

        INPUT                    PROCESSING                 OUTPUT
   ┌──────────────┐        ┌────────────────────┐     ┌────────────────┐
   │ PMS7003      │─UART──▶│                    │─I²C▶│ OLED SSD1306   │
   │  PM1/2.5/10  │        │  ESP32-S3-WROOM-1  │─GPIO│ LED เขียว/เหลือง/แดง│
   ├──────────────┤        │  -N16R8            │─PWM▶│ Buzzer         │
   │ ENS160+BME280│─I²C───▶│  (บน PCB ของเรา)    │─SPI▶│ microSD        │
   │ TVOC,T,RH,P  │        │ ┌────────────────┐ │─WiFi│ MQTT→Dashboard │
   ├──────────────┤        │ │ safety_task 🔴 │ │     └────────────────┘
   │ ZE07-CO   🔴 │─UART2─▶│ │ sensor_task    │ │
   │  CO ppm      │        │ │ infer_task  ★  │ │     ┌────────────────┐
   ├──────────────┤        │ │ net_task       │ │◀────│ ค่านอกอาคาร     │
   │ SCD40 (opt)  │─I²C───▶│ │ log_task       │ │HTTP │ DustBoy nearme │
   ├──────────────┤        │ └────────────────┘ │     └────────────────┘
   │ ปุ่ม MARK/    │─IRQ───▶│                    │     ┌────────────────┐
   │ MODE/ACK     │        │ int8 AE 32.4 KB    │     │ 🔴 CO ALARM    │
   ├──────────────┤        │                    │────▶│ LED+บี๊บ (ตรง)  │
   │              │        │                    │     └────────────────┘
   │ MQ-135 (opt) │─ADC1──▶│                    │
   └──────────────┘        └─────────┬──────────┘
                                     │
                        ┌────────────┴───────────┐
                        │  POWER (ไม่ใช่ I/O)      │
                        │  USB-C 5V → AMS1117 3V3 │
                        │  PMS7003 ใช้ 5V ตรง      │
                        └────────────────────────┘

🔑 ทำไมต้องเป็น ESP32-S3 S3 มี vector instruction สำหรับ int8 ที่ esp-tflite-micro ใช้เร่ง inference ได้จริง ส่วน ESP32 classic ไม่มี → รันได้แต่ช้ากว่าหลายเท่า และ S3 มี USB ในตัว → ตอนออกแบบ PCB ไม่ต้องใส่ชิป UART bridge

## 07อุปกรณ์ที่ต้องซื้อ

🔴 สั่งของภายใน 1–2 วัน critical path เดียวที่เงินแก้ไม่ได้คือเวลาขนส่ง · สั่งแยก 2 ร้าน (ร้านหนึ่งเอา MCU+SD อีกร้านเอาเซนเซอร์) กันร้านเดียวช้าแล้วค้างทั้งโปรเจกต์

### ชุด A — DevKit prototype (สั่งทันที · ใช้เก็บข้อมูลจริง)

รายการ | ทำไม | ราคา (฿)
ESP32-S3-DevKitC-1-N16R8 × 2 | ตัวหนึ่งใช้งาน ตัวหนึ่งสำรอง | 700–1,100
PMS7003 + adapter | PM1.0/2.5/10 ด้วยเลเซอร์ — ช่องสำคัญที่สุดสำหรับภูมิแพ้ | 706 ยืนยันแล้ว
ENS160 + BME280 combo | TVOC, eCO2(อนุมาน), T, RH, ความดัน | 250–450
microSD module + card 32GB | ⭐ สร้าง dataset + กัน Wi-Fi ล่ม | 150–250
OLED SSD1306 + LED 3 สี + buzzer + ปุ่ม 3 | ผู้ป่วยอ่านตัวเลขไม่ทัน ต้องเห็นสีแล้วรู้ทันที | 180–330
สายจัมพ์ · breadboard · 5V 2A adapter | PMS7003 ใช้ 5V กินใกล้ 100mA | 300–450
รวมชุด A | | ~2,290–3,290

### ชุด B — เสริม (แนะนำถ้างบถึง)

รายการ | ทำไมคุ้ม | ราคา (฿)
SCD40 / SCD41 (CO₂ จริง) | 🔑 CO₂ จริงบอก "มีคนอยู่ในห้อง" และ "อากาศไม่ถ่ายเท" ซึ่ง eCO2 จาก MOX ทำไม่ได้ → แยก "คนเข้าห้อง" ออกจาก "ของไหม้" ได้ | 700–1,200
ZE07-CO (electrochemical) 🔴 | 🔑 มิติที่เป็นอิสระจริง + จับการเผาไหม้ไม่สมบูรณ์ที่อีก 8 ช่องมองไม่เห็น · 0.5–500 ppm ผ่าน UART ⚠️ ไม่ใช่ CO alarm — อ่าน §09 ก่อนซื้อ | ⚠️ เช็คราคา
INA219 (current sensor) | ⚡ วัดพลังงานต่อ inference — 1 ใน 6 แกนของการเทียบ edge vs cloud | 100–200
MQ-135 | 🔌 ได้ใช้ ADC ครบตามสไลด์ (คุณภาพข้อมูลต่ำ อย่าใช้เป็น feature หลัก) | 80–150

### ชุด C — Carrier Board (สั่งเมื่อ prototype เดินได้ ~W06)

รายการ | หมายเหตุ | ราคา (฿)
PCB เปล่า 5 แผ่น (ไม่เลือก assembly) | 🟢 ถูกกว่า PCBA หลายเท่า · ⚠️ ต้องขอใบเสนอราคาจริง | 300–800
header ตัวเมีย 1×22 × 2 + header ตัวผู้ 1×4/5/6 | ซ็อกเก็ต DevKitC + คอนเนคเตอร์เซนเซอร์ — THT ทั้งหมด | 80–150
SMD 0805 ~16 ตัว + 2N7002 + ปุ่ม/LED/buzzer THT | 🔑 0805 ไม่ใช่ 0603 — จับด้วยคีมปากคีบได้สบาย | 150–300
C1 bulk 470–1000 µF | 🔴 ขาดแล้ว ESP32 brownout ตอนพัดลม PMS สตาร์ท | 20–50
รวมชุด C | | ~550–1,300

~2.8K

ชุด A — ต้องมี

~1.0K

ชุด B — เสริม

~0.9K

ชุด C — Carrier Board

⚠️ ก่อนสั่ง PMS7003 706฿ ยืนยันจาก ArtronShop แต่ตอนตรวจสอบเหลือ 1 ชิ้น → เช็คสต็อกก่อน · ราคาอื่นเป็นช่วงประมาณ ต้องเปิดหน้าร้านยืนยันเอง · ESP32-S3-DevKitC เลือก N16R8 และเช็คว่า บัดกรีขามาแล้ว
ร้าน: ArtronShop · Arduitronics · MCUcity · ModuleMore · Gravitech Thai · ThaiEasyElec

## 08Carrier Board — สั่ง PCB เปล่า บัดกรีเอง

🔴 กฎข้อเดียวที่สำคัญที่สุด PCB ห้ามอยู่บน critical path ของการเก็บข้อมูล
บอร์ดรอบแรกมีปัญหาเสมอ — ถ้าแผนคือ "รอ PCB เสร็จแล้วค่อยเก็บข้อมูล" แล้ว rev1 พัง ทีมจะเหลือ 3 สัปดาห์สำหรับงานที่ต้องใช้ 8 สัปดาห์

✅ DevKit + breadboard เก็บข้อมูลตั้งแต่ W04 · PCB เดินขนานเป็น track ที่สอง

📄 รายละเอียดเต็มอยู่ในเอกสารแยก 01-hardware/AirGuard-S3_carrier_board.md — BOM, net list, เทคนิคออกแบบ, ลำดับบัดกรี 9 ขั้น, checklist ก่อนสั่ง · คน A เปิดคู่กับ EasyEDA ขณะวาด

### 8.1 🎯 แนวทางที่เลือก: Carrier Board + DevKitC

ออกแบบลายทองแดงและรูเจาะเอง → สั่ง PCB เปล่า → ซื้ออุปกรณ์แยก → บัดกรีเอง โดยเจาะรู 2 แถวใส่ header ตัวเมีย แล้วเอา ESP32-S3-DevKitC-1 เสียบลงไป

ได้อะไร | เสียอะไร
✅ ไม่ต้องบัดกรี castellation ของโมดูล | บอร์ดหนาขึ้นราว 15–18 mm
✅ ไม่ต้องบัดกรี USB-C ขาถี่ 0.5 mm | ดู "custom" น้อยกว่านิดหน่อย
✅ ไม่ต้องทำวงจร EN RC · GPIO0 pull-up · LDO · ปุ่ม BOOT/RESET — DevKit มีให้หมด | DevKit แพงกว่าโมดูลเปล่าเล็กน้อย
✅ เกือบทั้งบอร์ดเป็น THT บัดกรีชั่วโมงเดียวเสร็จ
✅ ไม่เสียค่า Extended part $3/ตัว เพราะไม่ได้ให้โรงงานประกอบ
✅ DevKit ถอดไปใช้งานอื่นได้ · บอร์ดพังก็ไม่เสีย DevKit

### 8.2 ลบ 13 ชิ้นออกจาก schematic เดิม

ทั้งหมดนี้ DevKitC มีอยู่บนบอร์ดแล้ว — ใส่ซ้ำคือเสียเงินและเพิ่มจุดพัง

USBC1  ·  D2 (USB TVS)  ·  R5, R6 (22Ω)  ·  R3, R4 (5.1k CC)
U2 (AMS1117)  ·  R1, R2 (pull-up EN/IO0)  ·  C5 (1µF)
SW1, SW2 (RESET/BOOT)  ·  F1 (ฟิวส์)  ·  D1 (TVS)

#### เปลี่ยน U1

ESP32-S3-WROOM-1 → header ตัวเมีย 1×22 สองแถว (JH1, JH2)

⚠️ เลขขาเปลี่ยนทั้งหมด แต่ GPIO ไม่เปลี่ยน เดิมใช้เลขขาโมดูล 41 ขา ของใหม่ใช้ตำแหน่งบน header ของ DevKit ซึ่งพิมพ์เลข GPIO ไว้บนบอร์ดแล้ว → อ่านง่ายขึ้นมาก ไม่ต้องแปลงเลขอีก

#### เพิ่ม 3 ชิ้น

ชิ้นส่วน | ทำไม
C1 bulk 470–1000 µF บนราง 5 V | 🔴 ขาดแล้ว ESP32 brownout reset ทุกครั้งที่พัดลม PMS สตาร์ท — วางใกล้คอนเนคเตอร์ PMS ที่สุด
header ตัวเมีย 1×22 × 2 | ซ็อกเก็ตเสียบ DevKitC
terminal block 5 V (แนะนำ) | จ่ายไฟจาก adapter แยก · ⚠️ ห้ามเสียบ USB พร้อมกันถ้าไม่มีไดโอดกันย้อน

✅ ผลลัพธ์ ชิ้นส่วนลดจาก ~35 เหลือ ~22 ตัว และ ไม่เหลืออะไรที่ขาถี่กว่า SOT-23 เลย

### 8.3 🔴 3 อย่างที่ต้องวัดเองก่อนวาด (ห้ามเดา)

ต้องวัด | ทำไม
🔴 ระยะห่างสองแถวขาของ DevKitC-1 | ผิด 2.54 mm เดียว บอร์ดใช้ไม่ได้เลย → ซื้อ DevKit มาก่อน วัดด้วยเวอร์เนีย อย่าวาดจากตัวเลขในอินเทอร์เน็ต
ขนาด footprint ของ header/ปุ่ม/buzzer ที่ซื้อจริง | ⚠️ สั่ง PCB เปล่า = โรงงานไม่ตรวจ BOM ให้ footprint ผิดจะไม่มีใครเตือน
pinout ของ adapter PMS7003 ที่ซื้อจริง | adapter แต่ละยี่ห้อเรียงขาไม่เหมือนกัน — เรียงผิดคือ 5 V เข้าขา TX

🔑 วิธีจับ footprint ผิดที่ดีที่สุด ใช้เวลา 10 นาที พิมพ์ layout ขนาด 1:1 ลงกระดาษ แล้ววางชิ้นส่วนจริงทาบดู

### 8.4 เทคนิคออกแบบสำหรับบัดกรีเอง

เทคนิค | ทำไม
ใช้ 0805 ไม่ใช่ 0603 | ใหญ่พอให้จับด้วยคีมปากคีบ ราคาต่างกันไม่ถึงบาท
ของอื่นใช้ THT ให้หมด · microSD ใช้โมดูล breakout | เหลือ SMD แค่ ~16 ตัว
เว้นระยะระหว่างชิ้นส่วนกว้างกว่าปกติ | ปลายหัวแร้งต้องเข้าถึงได้
🔑 เขียนชื่อ ค่า และเครื่องหมายขั้วลง silkscreen ทุกตัว | บัดกรีตอนตี 2 แล้วจำไม่ได้ว่า R7 คือค่าอะไร
⚠️ ใส่ thermal relief ที่แพด GND | ถ้าแพดต่อ ground plane เต็มๆ ความร้อนถูกดูดหมด บัดกรีไม่ติด — อาการที่ทำให้คนนึกว่าหัวแร้งเสีย
สั่ง 5 แผ่น | พัง 1–2 แผ่นตอนฝึกบัดกรีเป็นเรื่องปกติ

### 8.5 ลำดับบัดกรี — เตี้ยไปสูง

1. SMD 0805 ทั้งหมด + Q1        ← ทำตอนบอร์ดยังเรียบที่สุด ใช้ฟลักซ์เยอะ
2. 🔴 วัด +5V↔GND และ +3V3↔GND  ← ใกล้ 0 Ω = ช็อต หยุดหาก่อน
3. header ตัวผู้ J1–J6           ← ใช้เทปกาวยึดก่อนบัดกรีขาแรก
4. ปุ่ม SW3–SW5
5. LED D3–D5                     ← ⚠️ ขายาว = บวก
6. 🔑 header ตัวเมีย JH1, JH2     ← เสียบ DevKit เข้าไปก่อนบัดกรี ให้ระยะตรงเป๊ะ
7. C1 bulk + buzzer              ← ⚠️ ตรวจขั้ว C1
8. ล้างฟลักซ์ + ส่องแว่นขยายหาสะพานตะกั่ว
9. วัดความต่อเนื่องทุกเส้น ก่อนเสียบไฟครั้งแรก

🔴 ก่อนเสียบไฟครั้งแรก วัด VCC↔GND ว่าไม่ช็อต → จ่ายไฟเปล่าๆ โดยยังไม่เสียบ DevKit และเซนเซอร์ → จับดูว่ามีอะไรร้อนผิดปกติ → เสียบ DevKit → เสียบเซนเซอร์ทีละตัว ไม่ใช่ทีเดียวหมด

### 8.6 ผลตรวจ netlist rev0 (12 ส.ค.)

✅ การต่อสายถูกเกือบทั้งหมด — ไม่พบจุดต่อผิดทางไฟฟ้าเลย ขา PSRAM (28/29/30) ไม่ได้ต่อ ✅ · strapping (15/16/26) ปล่อยลอยถูก ✅ · CC1/CC2 → 5.1 kΩ ✅ · USB D+/D− ไม่สลับ ✅ · PMS7003 และ ZE07-CO TX/RX ไม่สลับ ✅ · microSD ครบและ shield ลง GND ✅ · I²C connector 3 ตัวเรียงขาเหมือนกัน ✅

🟠 ที่ต้องแก้ (ทำพร้อมตอนแปลงเป็น carrier board)

- LED1 เป็นสีแดง ควรเป็นเขียว — ตอนนี้มีแดง 2 ตัว ไม่มีเขียวสำหรับสถานะ NORMAL
- LED ใช้ 4 แพ็กเกจต่างกัน (0805/0603/0402/L1.6) → รวมเป็น 0805 หรือ 3 mm THT ทั้งชุด (0402 เล็กเกินไปสำหรับบัดกรีมือ)
- 🔴 buzzer ไม่มีไดโอด flyback — เป็น magnetic buzzer = โหลดเหนี่ยวนำ ต้องใส่ 1N4148 คร่อม ขั้วแคโทดไป 3V3
- buzzer ที่เลือกเป็น active ไม่ใช่ passive → สร้างเสียงเองได้ แต่ทำ PWM หลายโทนไม่ได้ ต้องแก้แผนเฟิร์มแวร์
- ขั้ว LED ไม่สม่ำเสมอ (บางตัว pin1 = บวก บางตัว pin2) → เปิดดูทีละตัว
- ไม่มี header console UART (GPIO43/44 ว่างอยู่) → ใส่ 3 ขา ราคา 3 บาท กันตอน USB CDC มีปัญหา
- decoupling บางไป → เพิ่ม 100 nF ใกล้ microSD และแต่ละ connector I²C

## 09CO และแก๊สอันตรายถึงชีวิต

🔴 เส้นแบ่งที่ห้ามข้าม — อ่านก่อนทำอย่างอื่น เครื่องที่เราสร้างไม่ใช่ CO alarm และห้ามเรียกแบบนั้น

CO alarm ที่ขายจริงต้องผ่าน UL 2034 หรือ EN 50291 ซึ่ง ตัดสินที่อัลกอริทึม ไม่ใช่ว่าเซนเซอร์อ่านค่าได้: เตือนตามเส้นโค้งความเข้มข้น–เวลาที่กำหนด · ไม่เตือนผิดจากไอระเหยอื่นในบ้าน · ทำงานได้ในความชื้นสูงโดยเวลาตอบสนองไม่ช้าลง · มีแบตสำรอง · มีสัญญาณเตือนตอนเซนเซอร์หมดอายุ

🔑 เซนเซอร์เปล่าคือ "ชิ้นส่วน" ไม่ใช่ "อุปกรณ์นิรภัย"

### กฎ 4 ข้อของทีม

1. ถ้าทำการทดลองที่มีการเผาไหม้ (E1 จุดธูป · E2 ทำอาหาร) ต้องมี CO alarm ที่ได้มาตรฐานอยู่ในห้องด้วย — ข้อนี้ควรทำอยู่แล้วแม้ไม่ได้ติดเซนเซอร์
2. ห้ามเขียนหรือพูดว่าเครื่องนี้ "เตือนภัย CO ได้" ทั้งในรายงาน สไลด์ โปสเตอร์ และ README → ใช้คำว่า "บันทึกและติดตามระดับ CO เพื่อการวิจัย"
3. ติดป้ายบนตัวเครื่อง: "อุปกรณ์วิจัย — ไม่ใช่เครื่องเตือนภัย ห้ามใช้แทน CO alarm ที่ได้มาตรฐาน"
4. 🔴 ห้ามสร้าง CO ขึ้นมาเพื่อทดสอบเซนเซอร์ — ดูหัวข้อ 9.3

### 9.1 ทำไม CO ถึงคุ้มค่าที่จะเพิ่ม

เป็นมิติที่เป็นอิสระจริง — วัดด้วยหลักการ electrochemical ซึ่งคนละหลักการกับทุกช่องที่มีอยู่ → แก้ปัญหา collinearity แทนที่จะเพิ่มปัญหา (ต่างจาก eCO2 ที่อนุมานมาจาก TVOC)

เหตุการณ์ | PM2.5 | PM2.5/PM10 | TVOC | CO
จุดธูป / เผาไหม้ | ↑↑ | ↑ | ↑ | ↑↑
ทำอาหาร (ทอด) | ↑↑ | ↑ | ↑↑ | ↑
ฉีดสเปรย์ | — | — | ↑↑↑ | —
กวาดบ้าน / ไรฝุ่นฟุ้ง | ↑ | ↓↓ | — | —
🔴 เครื่องทำน้ำอุ่นแก๊สเผาไหม้ไม่สมบูรณ์ | — | — | — | ↑↑↑

⭐ แถวสุดท้ายคือเหตุผลที่แท้จริง เหตุการณ์อันตรายที่สุดในบ้านไทยเป็นเหตุการณ์ที่ เซนเซอร์เดิมทั้ง 8 ช่องมองไม่เห็นเลย เพราะ CO ไม่มีสี ไม่มีกลิ่น และไม่สร้างฝุ่น

🇹🇭 บริบทไทย: เครื่องทำน้ำอุ่นระบบแก๊สในห้องน้ำ — ระหว่างปี 2551 ถึง ก.ย. 2568 มีรายงาน 34 เหตุการณ์ ผู้ได้รับผลกระทบ 51 ราย เสียชีวิต 10 ราย สาเหตุหลักคือห้องน้ำแคบและไม่มีช่องระบายอากาศ
→ motivation ที่กรรมการเข้าใจทันที ⚠️ แต่ห้ามอ้างว่าเครื่องเราป้องกันได้ ให้เขียนว่า "เพื่อศึกษาว่าเซนเซอร์ราคาประหยัดตรวจจับรูปแบบดังกล่าวได้หรือไม่"

### 9.2 📐 เกณฑ์ระดับ CO

ppm | ผลต่อร่างกาย | ที่มา
9 | เพดานแนะนำในอาคาร เฉลี่ย 8 ชม. | WHO
30 | เพดานแนะนำ เฉลี่ย 1 ชม. | WHO
35 | ปวดศีรษะ วิงเวียน เมื่อสัมผัส 8 ชม. · ค่าแนะนำ TWA | NIOSH
50 | ขีดจำกัดที่ทำงาน เฉลี่ย 8 ชม. (PEL) | OSHA
90 | เพดานแนะนำ เฉลี่ย 15 นาที | WHO
200 | 🟠 ปวดศีรษะ วิงเวียน คลื่นไส้ ภายในเวลาไม่นาน | —
400 | 🔴 อันตรายถึงชีวิตทันที — สับสนในไม่กี่นาที หมดสติได้ใน 2 ชม. | —
800+ | 🔴🔴 เสียชีวิตได้ภายในไม่กี่นาที | —

🔑 พิษ CO เป็นแบบสะสม (ppm × เวลา) ไม่ใช่แค่ threshold ทันที ความเข้มข้นที่รู้สึกว่าไม่เป็นไรใน 10 นาที อาจทำให้สมองเสียหายได้ใน 2 ชั่วโมง → logic การเตือนต้องคิดเป็น dose ซึ่งเป็นเหตุผลที่มาตรฐาน UL/EN กำหนดเป็นเส้นโค้งความเข้มข้น–เวลา ไม่ใช่ตัวเลขเดียว

### 9.3 🔴 ห้ามทดสอบด้วยการสร้าง CO เอง

ห้ามเด็ดขาด ❌ ห้ามเผาอะไรในห้องปิดเพื่อดูว่าเซนเซอร์ขึ้นไหม · ❌ ห้ามใช้ไอเสียรถ เตาถ่าน หรือเครื่องทำน้ำอุ่นแก๊สเป็นแหล่งทดสอบ · ❌ ห้ามทดสอบในห้องน้ำหรือพื้นที่อับอากาศ

เหตุผล: CO ไม่มีสี ไม่มีกลิ่น ไม่มีรส — คุณจะไม่รู้ตัวจนกระทั่งสายเกินไป และอาการเริ่มต้น (ปวดหัว มึน) ทำให้ความสามารถตัดสินใจแย่ลง ผู้ที่ได้รับ CO จึงมักช่วยตัวเองไม่ได้

วิธีทดสอบที่ปลอดภัย | ทำอย่างไร | ได้อะไร
🔑 1. ทดสอบทางไฟฟ้า | ป้อนแรงดันจำลองเข้าขา analog หรือส่งเฟรม UART จำลอง | ✅ ทดสอบ logic การเตือนได้ครบ 100% โดยไม่ต้องมี CO จริงแม้แต่โมเลกุลเดียว
2. Co-location | วางข้าง CO alarm ที่ได้รับรอง แล้วบันทึกทั้งคู่ | เทียบเคียงในสภาพจริงอย่างปลอดภัย
3. บันทึกระยะยาว | ปล่อยเก็บข้อมูล 14 วัน | ได้ baseline และเห็น drift
4. แก๊สสอบเทียบ | ถังแก๊สมาตรฐานความเข้มข้นที่ทราบค่า | ⚠️ ต้องอยู่ภายใต้การดูแลของอาจารย์ ในห้องแล็บที่มีตู้ดูดควันเท่านั้น

✅ เขียนในรายงานแบบนี้ "ทดสอบ logic ด้วยข้อมูลจำลอง ส่วนการตอบสนองต่อ CO จริงไม่ได้ทำการทดสอบด้วยเหตุผลด้านความปลอดภัย"
→ นี่คือคำตอบที่ถูกต้องทางวิศวกรรม ไม่ใช่จุดอ่อนของโปรเจกต์

### 9.4 🏗️ แยก safety path ออกจาก ML path

                  ┌──────────────────────────────────────┐
 CO sensor ─UART─▶│ SAFETY PATH (เรียบง่าย ตรวจสอบได้)      │─▶ 🔴 LED + บี๊บดัง
                  │ if (co_ppm > TH) → เตือนทันที          │   ไม่ผ่านเงื่อนไขใดๆ
                  │ + สะสม dose (ppm×นาที)                │
                  │ ไม่มี ML · ไม่มี network · ไม่มี delay    │
                  └──────────────────────────────────────┘
                              │ (ค่า CO ส่งต่อไปด้วย)
 เซนเซอร์อื่น ──────┐          ▼
                    ▼  ┌──────────────────────────────────┐
                       │ ML PATH (ซับซ้อน)                 │─▶ 🟡 anomaly ทั่วไป
                       │ autoencoder + reconstruction error│   dashboard, log
                       └──────────────────────────────────┘

เหตุผลที่ต้องแยก | อธิบาย
ML ผิดพลาดแบบคาดเดาไม่ได้ | autoencoder อาจ "ไม่แปลกใจ" กับ CO สูง ถ้าเคยเห็นรูปแบบคล้ายกันตอน train
ฟังก์ชันความปลอดภัยต้องตรวจสอบได้ | if (x > threshold) พิสูจน์ความถูกต้องได้ · โครงข่ายประสาทเทียมพิสูจน์ไม่ได้
ต้องทำงานแม้ส่วนอื่นพัง | ถ้า inference ค้าง · Wi-Fi ล่ม · SD เต็ม → safety path ต้องยังทำงาน
latency ต้องต่ำและแน่นอน | ML path มี persistence rule หน่วง 20 วิ · safety path ต้องเตือนทันที

⭐ นี่คือหลักการมาตรฐานของงาน safety-critical จริง (แยก safety function ออกจาก non-safety function) 🔗 โยงกับวิชาระบบฝังตัวโดยตรง: priority ของ task, watchdog, fail-safe state

⚠️ เซนเซอร์ CO ที่พังเงียบๆ อันตรายกว่าไม่มีเลย เพราะสร้างความมั่นใจผิดๆ → ถ้า CO sensor ไม่ตอบหรือค่าออกนอกช่วง ต้องเข้า FAULT และแสดงให้ผู้ใช้เห็นชัด ห้ามเงียบแล้วทำงานต่อ

### 9.5 เลือกเซนเซอร์: ZE07-CO ไม่ใช่ MQ-7

| MQ-7 | ZE07-CO แนะนำ
หลักการ | MOX (semiconductor) | Electrochemical
ช่วงวัด / ความละเอียด | คร่าวๆ ต้อง calibrate เอง | 0.5–500 ppm · 0.1 ppm
เอาต์พุต | analog อย่างเดียว | UART + analog DAC 0.4–2.0 V
ชดเชยอุณหภูมิ | ไม่มี | มีเซนเซอร์อุณหภูมิในตัว
การใช้งาน | ⚠️ ต้องสลับแรงดันฮีตเตอร์เป็นรอบ (1.4V/5V) โค้ดยุ่ง กินไฟมาก | ต่อ UART อ่านค่าได้เลย
ความจำเพาะต่อ CO | ต่ำ — ไวต่อแก๊สอื่นเยอะ | สูงกว่ามาก

⚠️ ข้อจำกัดที่ต้องเขียนในรายงาน

- อายุใช้งานจำกัด — เป็นเซลล์เคมีที่เสื่อมตามเวลาแม้ไม่ได้ใช้
- ต้องอุ่นตัวก่อนอ่านค่าแม่น → เพิ่มเข้าไปใน state WARMUP
- มี cross-sensitivity กับไฮโดรเจนและแอลกอฮอล์
- ค่าที่อ่านได้ไม่ผ่านการสอบเทียบ → รายงานเป็น "ค่าที่เซนเซอร์รายงาน" ไม่ใช่ "ความเข้มข้น CO จริง"
- 📌 เปิด datasheet ของ ZE07-CO ยืนยันอายุใช้งาน เวลาอุ่นตัว และตาราง cross-sensitivity — ห้ามเดา

🧪 การทดลองที่มีค่าที่สุดของหัวข้อนี้ ทำ E3 (ฉีดแอลกอฮอล์) แล้วดูว่าเซนเซอร์รายงาน CO ขึ้นหรือไม่ ทั้งที่ไม่มีการเผาไหม้เลย
ถ้าพบค่า CO เท็จ → นั่นคือหลักฐานเชิงประจักษ์ว่าทำไมเซนเซอร์ราคาประหยัด จึงใช้เป็นอุปกรณ์นิรภัยไม่ได้ ซึ่งเป็นข้อสรุปที่ซื่อสัตย์และมีน้ำหนักมากในบทสรุป

### 9.6 แก๊สอันตรายอื่น

แก๊ส | อันตรายแบบไหน | คุ้มที่จะเพิ่มไหม
CO | 🔴 เฉียบพลัน ถึงตาย · ไม่มีสีไม่มีกลิ่น | ✅ คุ้มที่สุด — เพิ่มตัวนี้อย่างเดียวก่อน
LPG / มีเทน | 🔴 ระเบิด + ขาดออกซิเจน | 🟢 คุ้ม (MQ-5/MQ-6 ถูก) · ⚠️ แต่แก๊สหุงต้มมีสารแต่งกลิ่น คนได้กลิ่นก่อน
NO₂ | 🟠 ทำลายทางเดินหายใจ · จากเตาแก๊ส | 🟠 เกี่ยวกับภูมิแพ้โดยตรง แต่เซนเซอร์ที่แม่นราคาสูง
ฟอร์มาลดีไฮด์ | 🟠 สารก่อมะเร็ง (เรื้อรัง) | 🟠 ซ้อนทับกับ TVOC บางส่วน
เรดอน | 🟠 มะเร็งปอด (เรื้อรังมาก) | ❌ ต้องใช้เครื่องเฉพาะทาง

💡 เพิ่ม CO อย่างเดียวก่อน — เพิ่มทีละอย่างทำให้วิเคราะห์ได้ว่าอะไรมีผลจริง ถ้าเพิ่มทีเดียว 3 ตัวจะแยกไม่ออก · เหลือเวลาและงบค่อยเพิ่ม LPG

📄 รายละเอียดเต็มอยู่ในเอกสารแยก 01-hardware/AirGuard-S3_CO_safety.md — มีการออกแบบ logic แบบ dose, รายละเอียดมาตรฐาน UL 2034 / EN 50291 และคำถามทวนความเข้าใจ

## 10สถาปัตยกรรม + FreeRTOS + FSM

⚠️ ESP-IDF v5.5.x ห้ามใช้ v6.0 stable ล่าสุดคือสาย v6.0.x (มี.ค. 2569) และ v5.5.5 (ก.ค. 2569) แต่ esp-tflite-micro v1.3.5 ระบุรองรับตั้งแต่ v4.4 ขึ้นไป ส่วน v6.0 มี breaking change — ไม่คุ้มเสี่ยง
ทั้ง 3 คนต้องใช้เวอร์ชันเดียวกัน → pin ใน idf_component.yml + เขียนใน README

Task | Prio | Core | คาบ | หน้าที่
safety_task 🔴 | 6 | 0 | 1 วิ | อ่าน CO + เทียบ threshold + สะสม dose + สั่งเตือนตรง · ห้ามบล็อกกับอะไรทั้งสิ้น · ไม่ผ่าน ML
sensor_task | 5 | 1 | 1 วิ | อ่าน UART ของ PMS + I²C ของ ENS160/BME280 → queue
infer_task | 4 | 0 | 10 วิ | normalize → TFLite invoke → MSE → เทียบ threshold
net_task | 3 | 0 | event | MQTT · NTP · ดึงค่านอกอาคารจาก DustBoy ทุก 1 ชม.
log_task | 2 | 1 | 5 วิ | เขียน SD แบบ batch (latency ไม่แน่นอน จึงต้องแยก task)

  ┌────────┐  boot     ┌──────────┐ ครบ 24-48 ชม. ┌─────────┐
  │  INIT  │──────────▶│  WARMUP  │─────────────▶│   RUN   │
  └────────┘ ตรวจเซนเซอร์└──────────┘  (ทิ้งข้อมูล)  └────┬────┘
      │                 ENS160 ต้องอุ่นตัว              │
      │                                        ┌────────┴────────┐
      │                                  ปกติ  │                 │ AE error สูง
      │                                        ▼                 ▼
      │                                  ┌──────────┐     ┌────────────┐
      │                                  │  NORMAL  │     │  ANOMALY   │
      │                                  │  🟢 LED  │     │ 🔴LED+บี๊บ  │
      │                                  └──────────┘     └────────────┘
      │
      │  🔴 CO เกินเกณฑ์ (เส้นทางแยก ไม่ผ่าน AE — ดู §09)
      │      ┌──────────────┐
      ├─────▶│  CO ALARM    │ 🔴 LED + บี๊บดัง ทันที ทุกสถานะ
      │      └──────────────┘
      ▼ เซนเซอร์ไม่ตอบ · checksum พังต่อเนื่อง · ค่านอกช่วงกายภาพ · CO sensor ไม่ตอบ
  ┌────────┐
  │ FAULT  │  🟡กระพริบ + log + แจ้ง MQTT + พยายาม recover
  └────────┘

⚠️ WARMUP ไม่ใช่ของประดับ ENS160 เป็น MOX sensor ที่ ต้อง burn-in 24–48 ชั่วโมงแรก ค่าช่วงนั้นเชื่อไม่ได้ ถ้าเอาไป train โมเดลจะเรียนรู้พฤติกรรมที่ไม่มีอีกแล้วตลอดไป → ต้องมี state นี้ และทิ้งข้อมูลช่วงนี้ออกจาก training set

🔗 โยงกับวิชาที่เรียนอยู่ OS (03603332) — multi-rate periodic task set · คำนวณ RMS bound: U = Σ Cᵢ/Tᵢ ≤ n(2^(1/n) − 1) · Data Structures — ring buffer + queue · Digital Systems Design — FSM · Data Comm — UART framing, I²C, MQTT QoS · 03603342 — Git, CI, Docker

## 11กับดักฝังตัว

กับดัก | อาการ | วิธีป้องกัน
printf/malloc ใน ISR | crash หรือ watchdog reset แบบสุ่ม | ใช้ xQueueSendFromISR เท่านั้น · ISR สั้นที่สุด
ลืม volatile | compiler optimize ทิ้ง อ่านค่าค้าง | volatile + critical section
SD write บล็อกยาว | ข้อมูลขาดเป็นช่วงตอนตี 3 โดยไม่มีใครเห็น | แยก task + batch + เช็ค uxTaskGetStackHighWaterMark
tensor arena ตกไปอยู่ PSRAM | inference ช้าลงหลายเท่าโดยไม่มีสาเหตุชัด | heap_caps_malloc(..., MALLOC_CAP_INTERNAL)
ใช้ GPIO33–37 บน N16R8 | บอร์ดค้างหรือ PSRAM พัง | 🔴 ขาเหล่านี้ถูก Octal PSRAM ใช้หมดแล้ว — ห้ามแตะ
Strapping pin | บอร์ด boot ไม่ขึ้นหลังต่อสาย | 🔌 เปิด datasheet เช็ค GPIO0/3/45/46 — ห้ามเดา
ADC2 ชนกับ Wi-Fi | อ่าน MQ-135 ไม่ได้เมื่อ Wi-Fi ทำงาน | ใช้ ADC1 (GPIO1–10) เท่านั้น + เรียก ADC calibration API

📌 กฎเหล็กของทีม: ห้ามเดาสเปก ห้ามเดา pin · register · ชื่อ API · ค่ากระแส · timing → เปิด ESP32-S3 Datasheet, ESP32-S3 TRM, ESP32-S3-WROOM-1 Datasheet, ESP Hardware Design Guidelines ยืนยันทุกครั้ง

## 12Feature Engineering

ช่องดิบ: PM1.0, PM2.5, PM10, TVOC_index, CO_ppm, T, RH, P

⚠️ ตัด eCO2 ออก เพิ่ม CO เข้ามาแทน eCO2 ของ ENS160 อนุมานมาจาก TVOC โดยตรง ไม่ใช่การวัดอิสระ → ใส่ทั้งคู่ทำให้ Σ ใกล้ singular
ส่วน CO วัดด้วย electrochemical ซึ่งเป็นคนละหลักการกับทุกช่อง → เป็นมิติที่เป็นอิสระจริง
📐 p เปลี่ยนจาก 8 → ตามจำนวนจริง ทำให้ค่าวิกฤต χ² เปลี่ยนด้วย (p=8, α=0.001 → 26.12 · p=9 → 27.88) เปิดตารางยืนยันเอง

Feature | สูตร | ทำไมสำคัญ
🔑 PM2.5 / PM10 ratio | pm25 / max(pm10, ε) | ทรงพลังที่สุด — แยก ควันเผาไหม้ (ratio สูง) จาก ฝุ่นกวาดบ้าน/ไรฝุ่น (ratio ต่ำ) ซึ่งเป็นตัวกระตุ้นภูมิแพ้คนละแบบ
🔑 I/O ratio | pm25_ในห้อง / pm25_นอกอาคาร | ดูตารางข้างล่าง — เป็นสิ่งที่เครื่องเชิงพาณิชย์ไม่ทำ
d(PM2.5)/dt · d(TVOC)/dt | ผลต่างระหว่าง sample | จับ transient เร็ว (สเปรย์ จุดไฟ)
rolling std 5 นาที | ส่วนเบี่ยงเบนเลื่อน | จับ stuck-at fault (std=0)
hour_sin, hour_cos | sin/cos(2πh/24) | บริบทเวลาแบบวนรอบ → contextual anomaly
absolute humidity | คำนวณจาก T, RH | ชดเชย hygroscopic growth

#### 🔑 I/O ratio — การใช้ข้อมูลนอกอาคารที่คุ้มที่สุด

I/O ratio | แปลว่า | คำแนะนำต่อผู้ป่วย
≈ 1 | อากาศในห้องตามข้างนอก | หน้าต่างรั่วหรือเปิดอยู่ → ปิดหน้าต่าง
< 0.5 | ห้องกรองได้ดี | ✅ ปลอดภัย อยู่ในห้องต่อได้
> 1.5 | 🔴 แหล่งกำเนิดอยู่ในห้อง | หาต้นตอในห้อง — ปิดหน้าต่างไม่ช่วย กลับทำให้แย่ลง

แก้ปัญหา contextual anomaly ตรงจุด: PM2.5 = 60 ตอนฤดูเผาไม่ผิดปกติ แต่ถ้าข้างนอก 20 ในห้อง 60 → ผิดปกติแน่นอน
⚠️ limitation: สถานีนอกอาคารที่ใกล้ที่สุดอาจห่างหลายกิโลเมตร และเป็นข้อมูลรายชั่วโมง → ต้อง interpolate และระบุว่าเป็น proxy

⚠️ ความชื้นยังต้องระวัง (แม้เบากว่า outdoor) งานวิจัยใน Atmospheric Measurement Techniques (2024) พบว่า ที่ RH เกิน ~75% เซนเซอร์ Plantower อ่าน PM สูงเกินจริง (hygroscopic growth)
ในห้องที่ไม่เปิดแอร์ ช่วงหน้าฝนไทย RH แตะ 75%+ ได้
✅ ใส่ RH + absolute humidity เป็น feature → ทำ ablation เทียบ false-alarm rate มี/ไม่มี feature นี้ → เปลี่ยนจากบั๊กเป็นคำถามวิจัย
⚠️ paper ใช้ PMS5003 เราใช้ PMS7003 — พารามิเตอร์ใช้แทนกันตรงๆ ไม่ได้

⚠️ บั๊กที่หายากที่สุดของ TinyML pipeline Normalization ต้องใช้ mean/scale จาก training set และ hard-code ค่าเดียวกันเป๊ะๆ ใน firmware
ถ้าไม่ตรง reconstruction error เพี้ยนทั้งหมดโดยโค้ดไม่ error
✅ ให้สคริปต์ Python generate ไฟล์ .h อัตโนมัติ ห้ามพิมพ์มือ

## 13โมเดล + Memory Budget

Window = 30 ตัวอย่าง × 8 ช่อง (1 ตัวอย่าง/10 วิ → หน้าต่าง 5 นาที) = 240 inputs

240 → 64 → 16 (bottleneck) → 64 → 240      ReLU, output linear

รายการ | วิธีคำนวณ | ผล
จำนวนพารามิเตอร์ | 240·64+64 + 64·16+16 + 16·64+64 + 64·240+240 | 33,152
weights (float32) | 33,152 × 4 B | 129.5 KB
weights (int8) | 33,152 × 1 B | 32.4 KB ✅
Tensor arena | เผื่อ overhead ของ interpreter | 48–64 KB

512 KB

SRAM ภายในของ ESP32-S3

~96 KB

weights + arena

19%

ใช้ไป — เหลือเยอะ ✅

📐 ตัวเลขที่ต้องเขียนในรายงาน int8 quantization ลดขนาด 4 เท่า (129.5 → 32.4 KB) เหลือที่ให้ FreeRTOS stacks และ Wi-Fi stack (~50–60 KB) สบาย
🏆 MLPerf Tiny ใช้ FC autoencoder ขนาด 270 KB สำหรับงาน anomaly detection → โมเดลเราเล็กกว่า 8 เท่า

📐 กับดักคณิตศาสตร์ตอนตั้ง threshold P99.5 ฟังดูเข้มงวด แต่ 1 หน้าต่าง/10 วิ = 8,640 หน้าต่าง/วัน × 0.5% = 43 false alert/วัน ❌ ผู้ป่วยจะถอดปลั๊กภายในวันเดียว
✅ แก้ด้วย persistence rule: ต้องเกิน threshold ติดกัน k=3 หน้าต่างถึงเตือน → ลด FP แบบทวีคูณ แลกกับ latency +20 วินาที
⭐ threshold percentile ต้องคิดคู่กับจำนวนหน้าต่างต่อวันเสมอ

### โมเดลฝั่ง server (ต้องมี baseline ที่ไม่ใช่ deep learning)

โมเดล | ทำไมต้องมี
EWMA + 3σ | baseline ที่ง่ายที่สุด — ถ้า deep model ชนะไม่ได้ ก็ไม่ต้องใช้ deep model
Mahalanobis / Hotelling T² | 🔗 ตรงกับวิชา 03603312 · multivariate · ตีความได้ · มักชนะ deep model บนข้อมูลมิติต่ำ
Isolation Forest | baseline unsupervised มาตรฐาน
LSTM / GRU autoencoder | ใช้ context ยาว (1 ชม.) จับ pattern ที่ device เห็นไม่ได้

⭐ ถ้า Mahalanobis ชนะ LSTM ให้รายงานตามนั้น พร้อมอธิบายว่าทำไม (มิติต่ำ · ข้อมูลน้อย · anomaly เป็นการเลื่อนของ mean/covariance) — กรรมการและ recruiter ให้ค่าความซื่อสัตย์มากกว่าการโชว์ว่าใช้ deep model ได้

## 14วัดผลให้ถูก

❌ ห้ามใช้ Accuracy anomaly < 1% ของข้อมูล → โมเดลที่ตอบ "ปกติ" ตลอดได้ 99%+
⚠️ งานวิจัยหลักที่เราอ้าง (Wei et al. 2022) รายงาน accuracy 99.50% บนงาน anomaly detection — นี่คือช่องว่างที่ทีมเราเติมได้

🧪 Kim et al., AAAI 2022 — ทั้ง 3 คนต้องอ่านก่อน W04 "Towards a Rigorous Evaluation of Time-Series Anomaly Detection" (arXiv:2109.05257)
พบว่าโปรโตคอล Point Adjustment (PA) ที่วงการใช้กันทำให้ประเมินสูงเกินจริงอย่างรุนแรง — anomaly score ที่สุ่มขึ้นมาก็กลายเป็น SOTA ได้ และโมเดลที่ไม่ได้ train ก็ได้ผลเทียบเท่าเมื่อห้ามใช้ PA
📅 ถ้ารู้ทีหลังว่าเมตริกผิด อาจต้องเก็บข้อมูลใหม่ทั้งหมด

เมตริก | ทำไมใช้
PR-AUC | เหมาะกับข้อมูลไม่สมดุล ไม่ถูกหลอกเหมือน ROC-AUC
Event-level detection rate | "ตรวจเจอเหตุการณ์นั้นไหม" ไม่ใช่นับทีละหน้าต่าง
Mean Time To Detect | ผู้ป่วยหอบหืดต้องรู้เร็ว — เจอหลัง 10 นาทีก็สายแล้ว
False alarms/วัน | ตัวเลขที่ตัดสินว่าเครื่องจะถูกใช้ต่อหรือถูกถอดปลั๊ก

### ตารางผลลัพธ์หลัก (Edge vs Cloud)

มิติ | On-device int8 AE | Server LSTM-AE | Server Mahalanobis
PR-AUC | ? | ? | ?
Event detection rate | ? | ? | ?
False alarms/วัน | ? | ? | ?
⏱️ Mean time to detect | ? | ? | ?
Model size | 32.4 KB | ? | ?
⏱️ Inference latency | ? ms | ? ms + RTT | ?
⚡ พลังงาน/inference | ? mJ | ? (รวมส่งข้อมูล) | ?
Bandwidth/วัน | ? KB (event เท่านั้น) | ? MB (streaming) | ?
ทำงานตอน Wi-Fi ล่ม | ✅ ได้ | ❌ | ❌

แถวสุดท้ายคือข้อได้เปรียบเชิงโครงสร้างของ edge ที่ยังไม่มีงานไหนวัดเทียบไว้

## 15แผน 15 สัปดาห์ — 2 track

🔴 Critical path (track หลัก) เลื่อนไม่ได้ W02 ของถึง → W04 เริ่มเก็บ baseline → W07 Phase B · ■ = งาน PCB (track รอง เลื่อนได้)

W0026 ก.ค. – 1 ส.ค.

#### สั่งของ + ตั้ง toolchain

✅ สั่งชุด A (2 ร้าน) ✅ ลงทะเบียน DustBoy API (รออนุมัติ) ✅ ESP-IDF v5.5.x ทั้ง 3 คน ✅ repo + GitHub Actions CI ✅ โหลด UCI dataset

W012 – 8 ส.ค.

#### โมเดลบนข้อมูลสาธารณะ

✅ train AE บน UCI ได้ PR-AUC baseline ✅ TFLite int8 ✅ ขนาดตรงที่คำนวณ (32.4 KB) ✅ ทั้งทีมอ่าน Kim et al. จบ

W029 – 15 ส.ค.

#### 🔴 ของถึง + bring-up (ช่วงสอบกลางภาค — งานต้องเบา)

✅ blink + UART echo + I²C scan ✅ FSM skeleton

W0316 – 22 ส.ค.

#### Sensor bring-up + ■ เริ่มเรียน EasyEDA

✅ อ่าน PMS7003 + ENS160/BME280 ครบ ✅ SD logging ✅ รัน 24 ชม.ไม่ reset
■ เงื่อนไขบังคับก่อนเริ่มวาด schematic

W0423 – 29 ส.ค.

#### 🔴 ระบบครบ + เริ่มเก็บ baseline + ■ วาด schematic

✅ MQTT → dashboard ครบ loop ✅ เริ่มเก็บ baseline 14 วัน
นาฬิกาเริ่มเดิน — ทุกอย่างหลังจากนี้ขึ้นกับข้อมูล

W05–0630 ส.ค. – 12 ก.ย.

#### วิเคราะห์ baseline + ■ PCB layout + review + สั่ง

✅ baseline ครบ 14 วัน uptime > 95% ✅ EDA ✅ Mahalanobis + IsoForest บนข้อมูลตัวเอง
■ ทั้งทีม review schematic ก่อนกดสั่ง

W0713 – 19 ก.ย.

#### 🔴 Phase B — Induced Anomaly (E1–E6, F1–F3 × 3)

✅ 27 labeled events ✅ events.csv สมบูรณ์
🏆 ได้ labeled dataset ที่ปล่อยสาธารณะได้

W0820 – 26 ก.ย.

#### Train server models + ■ PCB มาถึง

✅ 4 โมเดล ✅ ตาราง PR-AUC เทียบกัน

W0927 ก.ย. – 3 ต.ค.

#### Deploy int8 ลงบอร์ด + ■ bring-up PCB rev1

✅ output บนบอร์ดตรงกับ Python (< 1%) — ต่างเยอะ = ปัญหา normalization constant

W104 – 10 ต.ค.

#### วัดผลเชิงระบบ

✅ latency (esp_timer_get_time) ✅ SRAM (heap_caps_get_free_size) ✅ stack watermark ✅ ⚡ กระแส

W1111 – 17 ต.ค.

#### 🏆 ทดลอง Edge vs Cloud

✅ ตัด Wi-Fi ดูว่า edge ยังทำงาน ✅ bytes/วัน 2 โหมด ✅ MTTD

W1218 – 24 ต.ค.

#### 🏆 Ablation

✅ false-alarm rate มี/ไม่มี RH feature ✅ Conv1D vs Dense ✅ ablation PM ratio และ I/O ratio

W1325 – 31 ต.ค.

#### 🎯 ส่งวิชา

✅ ใส่กล่อง ✅ เดินต่อเนื่อง 7 วันไม่ล้ม ✅ รายงาน + สไลด์ + demo

W14–151 – 8 พ.ย.

#### 🎯 Portfolio

✅ README ✅ วิดีโอ 2 นาที ✅ write-up ✅ ปล่อย dataset + ไฟล์ EasyEDA

## 16แบ่งงาน 3 คน

#### คน A Hardware & PCB

- ต่อวงจร prototype
- EasyEDA: schematic + layout
- สั่ง JLCPCB PCBA + bring-up
- ทำการทดลอง Phase B
- ประกอบกล่อง · ดูแลอุปกรณ์

หนัก: W03–W06, W07, W09
ต้องรู้: EasyEDA, อิเล็กทรอนิกส์, datasheet, มัลติมิเตอร์

#### คน B Firmware & Backend

- ESP-IDF driver (PMS7003, I²C, SD)
- FreeRTOS tasks + FSM + watchdog
- ดึงค่านอกอาคารสำหรับ I/O ratio
- Deploy TFLite int8
- MQTT + storage + Grafana + CI
- วัด latency / SRAM / กระแส

หนัก: W02–W04, W09–W11
ต้องรู้: C, ESP-IDF, Linux, Docker, Git

#### คน C ML, Data & Report

- เริ่มได้ตั้งแต่ W00 บน UCI dataset
- Pipeline + feature engineering
- Train AE + quantize int8
- โมเดล server 4 ตัว
- เมตริกที่ถูกต้อง + ablation
- อ่าน paper + รายงาน + สไลด์

หนัก: W00–W01, W08, W12–W15
ต้องรู้: Python, TensorFlow, sklearn, pandas

### งานที่ทั้ง 3 คนต้องทำร่วมกัน

- อ่าน Kim et al. ให้จบก่อน W04 — กำหนดว่าจะวัดผลยังไง
- ตกลงนิยาม anomaly 3 คลาส (§03) — ถ้าเข้าใจต่างกัน firmware กับโมเดลจะไปคนละทาง
- 🔑 review schematic ก่อนกดสั่ง PCB — ค่าผิดพลาดคือเงินและ 3 สัปดาห์
- เช็คว่าระบบยังเดินอยู่ทุกวัน ตลอด W04–W12 — uptime เป็น deliverable
- Code review ก่อน merge — ตรงกับวิชา 03603342

⚠️ ความเสี่ยงอันดับ 1 ของทีม 3 คน: คนหนึ่งเป็นคอขวด ทีม 5 คนมีคนสำรอง ทีม 3 คนไม่มี — ถ้าคน A ป่วยช่วง W07 ไม่มีใครทำการทดลองแทนได้

✅ ป้องกัน:
1. ทุกงานต้องเขียนขั้นตอนไว้ใน repo ไม่ใช่ในหัว
2. commit ทุกวัน ห้ามเก็บโค้ดไว้ในเครื่องตัวเอง
3. คน C เริ่มบน UCI dataset ตั้งแต่ W00 ไม่ต้องรอใคร
4. W07 ให้คน B ช่วยทำ Phase B (27 events คนเดียวทำไม่ไหว)

## 17ความเสี่ยง + ลำดับตัด scope

🔴 ประเมินตรงๆ: 3 คน + PCB + ML ในเทอมที่ลง 7 วิชา = ตึง ต้องรู้ล่วงหน้าว่าจะตัดอะไรก่อน ไม่ใช่มาตัดสินใจตอนเหลือ 2 สัปดาห์

ลำดับ | สิ่งที่ทำ | ตัดได้ไหม
MUST | โหนด DevKit + baseline 14 วัน + Phase B + AE + เมตริกถูกต้อง + เทียบ edge/cloud | ❌ ตัดไม่ได้ — นี่คือโปรเจกต์
SHOULD | PCB rev1 ที่ bring-up ผ่าน · ablation ความชื้น · Grafana dashboard | 🟠 ตัดแล้วเสียคะแนนแต่ยังส่งได้
NICE | PCB rev2 · SCD40 · I/O ratio real-time · Conv1D ablation · relay คุมเครื่องฟอก | ✅ ตัดพวกนี้ก่อนเสมอ

ความเสี่ยง | ผล | แผนสำรอง
ของส่งช้า | 🔴 เลื่อนทั้งโปรเจกต์ | สั่ง 2 ร้าน · ยืมบอร์ดแล็บ · คน C ทำงานบน UCI ไปก่อน
PCB rev1 พัง / บัดกรีพลาด | 🟠 เสียเวลาคน A | ✅ DevKit ยังเก็บข้อมูลอยู่ ไม่กระทบ track หลัก · แก้ด้วย bodge wire แทน rev2
Sensor drift 2–3 เดือน | 🟠 โมเดลเตือนถี่ขึ้น | rolling normalization + แยกกลไก + รายงานเป็น limitation อย่างซื่อสัตย์
ความชื้นทำ false alarm | 🟠 โมเดลดูเหมือนใช้ไม่ได้ | ใส่ RH เป็น feature + ablation → เปลี่ยนเป็นคำถามวิจัย
Wi-Fi หอ/มหาลัยมี captive portal | 🟠 MQTT ต่อไม่ได้ | mobile hotspot · หรือ SD-first แล้ว sync ทีหลัง — ยิ่งตอกย้ำคุณค่าของ edge
PMS7003 พัดลมตัน | 🟠 ข้อมูลเพี้ยนเงียบๆ | duty cycling ยืดอายุ + self-test เทียบ rolling std
eCO2 ของ ENS160 ไม่ใช่ CO₂ จริง | 🔴 เคลมผิด = เสียเครดิต | MOX อนุมาน eCO2 จาก VOC → เขียนให้ชัด หรือซื้อ SCD40
ไม่มี anomaly พอประเมิน | 🔴 ไม่มีเมตริก = ไม่มีผลงาน | Phase B (§05) — ทำตั้งแต่ W07 ห้ามผลัด
🔴 ใช้เครื่องเราแทน CO alarm | 🔴 อันตรายถึงชีวิต | ติดป้ายบนเครื่อง · ห้ามเขียนว่า "เตือนภัยได้" · มี CO alarm มาตรฐานในห้องตอนทำการทดลองที่มีการเผาไหม้ → §09
CO sensor พังเงียบๆ | 🔴 สร้างความมั่นใจผิดๆ | ต้องเข้า FAULT และแสดงให้เห็นชัด ห้ามทำงานต่อเงียบๆ
สมาชิกหายช่วงสอบ | 🔴 ทีม 3 คนไม่มีตัวสำรอง | เขียนขั้นตอนลง repo · commit ทุกวัน

## 18อ้างอิง

#### เอกสารของทีมเอง

- 99-archive/AirGuard-S3_schematic_design.md — 📄 คู่มือออกแบบ schematic ฉบับเต็ม (คน A)
- 01-hardware/AirGuard-S3_carrier_board.md — 🎯 คู่มือ carrier board ฉบับเต็ม (คน A ใช้เล่มนี้)
- 01-hardware/AirGuard-S3_CO_safety.md — 🔴 CO และแก๊สอันตราย ฉบับเต็ม (อ่านก่อนซื้อเซนเซอร์ CO)
- 02-ml-data/AirGuard-S3_multivariate.md — Mahalanobis, χ², collinearity, PCA vs AE
- 02-ml-data/AirGuard-S3_thai_datasets.md — แหล่งข้อมูลไทยและวิธีเข้าถึง
- 02-ml-data/fetch_dustboy.py — สคริปต์ดึงข้อมูล DustBoy

#### งานวิจัย (เรียงตามลำดับที่ควรอ่าน)

1. Kim et al. (2022). Towards a Rigorous Evaluation of Time-Series Anomaly Detection. AAAI 2022 · arXiv:2109.05257 (https://arxiv.org/abs/2109.05257) · โค้ด (https://github.com/tuslkkk/tadpak) ⭐ ทั้ง 3 คนต้องอ่านก่อน W04
2. Wei et al. (2022). LSTM-Autoencoder based Anomaly Detection for Indoor Air Quality Time Series Data. arXiv:2204.06701 (https://arxiv.org/abs/2204.06701) งานที่ใกล้เคียงที่สุด — motivation และโมเดลที่ต้องเอาชนะเชิงเมตริกที่ถูกต้อง
3. Banbury et al. MLPerf Tiny Benchmark. arXiv:2106.07597 (https://arxiv.org/pdf/2106.07597)
4. Hygroscopic growth calibration for low-cost PM2.5 sensors. Atmospheric Measurement Techniques 17, 1051 (2024) · amt.copernicus.org (https://amt.copernicus.org/articles/17/1051/2024/)
5. Saha, Sandha, Srivastava. ML for Microcontroller-Class Hardware: A Review. arXiv:2205.14550 (https://arxiv.org/pdf/2205.14550)
6. Chandola et al. (2009). Anomaly Detection: A Survey. ACM Computing Surveys ⚠️ ยังไม่ได้ verify รายละเอียด เช็คก่อนใส่ bibliography

#### เอกสารเทคนิคที่ต้องเปิดจริง

- ⭐ ESP Hardware Design Guidelines — Schematic Checklist (ESP32-S3) — อ้างอิงหลักตอนออกแบบ PCB
- ESP32-S3-WROOM-1 Datasheet — Pin Definitions ของโมดูล + keep-out เสาอากาศ
- ESP32-S3 Series Datasheet — Boot Configurations, Strapping Pins
- 🔑 ESP32-S3-DevKitC-1 Schematic — ลอกวงจรอ้างอิงจากตัวนี้
- ESP-IDF Programming Guide v5.5 · esp-tflite-micro v1.3.5
- PMS7003 data manual · ENS160 / BME280 datasheet
- 🔴 ZE07-CO datasheet — อายุใช้งาน เวลาอุ่นตัว ตาราง cross-sensitivity
- UL 2034 / EN 50291 — มาตรฐาน CO alarm (อ่านเพื่อเข้าใจว่าทำไมเราไม่ใช่)

#### แหล่งข้อมูล

- UCI Air Quality Data Set (De Vito et al.)
- DustBoy — open-api.cmuccdc.org
- Air4Thai — air4thai.pcd.go.th (https://air4thai.pcd.go.th/webV3/) · OpenAQ — docs.openaq.org
- Sensor.Community — archive.sensor.community

🔑 16 ข้อที่ทั้ง 3 คนต้องจำ

1. สั่งของและลงทะเบียน DustBoy API วันนี้ — ทั้งคู่มีเวลารอที่เงินแก้ไม่ได้
2. ห้ามรอฮาร์ดแวร์แล้วค่อยทำโมเดล — 20 วันแรกใช้ UCI dataset ทำ pipeline ให้จบ
3. PCB ห้ามอยู่บน critical path — DevKit เก็บข้อมูล PCB เดินขนาน
4. 🔴 GPIO33–37 ใช้ไม่ได้บน N16R8 (Octal PSRAM กินหมด) · strapping = GPIO0/3/45/46
5. 🔴 CC1/CC2 ต้องมี pull-down 5.1 kΩ ไม่งั้น USB-C ไม่จ่ายไฟ บอร์ดดูเหมือนตาย
6. 🔴 เสาอากาศต้องมี keep-out — พลาดแล้วแก้ด้วยซอฟต์แวร์ไม่ได้
7. Phase B ต้องทำ W07 ห้ามผลัด — ไม่มี labeled event = ไม่มีเมตริก = ไม่มีผลงาน
8. PM2.5/PM10 ratio คือ feature ที่ทรงพลังที่สุด — แยกควันไหม้จากไรฝุ่น
9. int8 ลดขนาด 4 เท่า — 33k params = 32.4 KB fit ใน SRAM 512 KB สบาย
10. ห้ามใช้ accuracy — PR-AUC + event-level + false alarms/วัน
11. eCO2 จาก MOX ≠ CO₂ จริง · ห้ามเดา pin/register
12. 🔴 เครื่องเราไม่ใช่ CO alarm — UL 2034/EN 50291 ตัดสินที่อัลกอริทึม ไม่ใช่แค่ว่าเซนเซอร์อ่านค่าได้ · ห้ามสร้าง CO เพื่อทดสอบ ใช้ข้อมูลจำลองแทน
13. 🟢 ทำ carrier board เสียบ DevKitC — ไม่ต้องบัดกรี castellation และ USB-C ขาถี่ และวัดระยะสองแถวขาของ DevKit จากบอร์ดจริงก่อนวาด
14. 🔴 สั่ง PCB เปล่า = โรงงานไม่ตรวจ footprint ให้ → พิมพ์ layout 1:1 ลงกระดาษแล้ววางของจริงทาบก่อนสั่ง
15. 🏗️ แยก safety path ออกจาก ML path — if (co > TH) ที่ priority สูงสุด ไม่ผ่าน autoencoder
16. ตัด NICE ก่อนเสมอ (rev2 · SCD40 · Conv1D) อย่าให้กระทบ MUST

AirGuard-S3 · คู่มือทีม v5 (Indoor · 3 คน · Carrier Board · CO) · ปรับปรุง 12 ส.ค. 2569
ราคาและสเปกทั้งหมดต้องยืนยันจากหน้าร้านและ datasheet ก่อนสั่งซื้อจริง
