Sh080205/AirGuard/docs/archive/BUILD_SPEC.md

> ⚠️ **ARCHIVED 2026-10-09 — ล้าสมัย ใช้ได้เฉพาะที่มาของสูตร · ค่าที่ขัดกับ CLAUDE.md ให้ยึด CLAUDE.md**
> ตัวอย่างค่าที่ขัด: BUILD_SPEC:644 แนะนำเก็บ C13 — ผิด ดู CLAUDE.md §5 · BME280 → AHT21 · กระแสสูงสุดต่อขา **~20 mA** *(ค่าเริ่มต้น `2'd2`)* · 40 mA ที่ `2'd3`

# AirGuard-S3 Carrier Board — Build Specification

> **เอกสารนี้เป็นสเปกสมบูรณ์สำหรับสร้าง schematic และ PCB layout ตั้งแต่ต้น**
> ออกแบบให้ป้อนให้ AI หรือคนทำตามได้โดยไม่ต้องถามเพิ่ม
> ทุกตัวเลขที่ระบุมาจาก datasheet ทางการหรือการตรวจสอบแล้ว
> ส่วนที่ยังต้องวัดเองระบุไว้ชัดเจนในหัวข้อ 9

**เวอร์ชัน:** 1.2 · 1 ก.ย. 2569 *(netlist + BOM ของวันที่ 1 ก.ย.)*
**เป้าหมาย:** สั่ง PCB เปล่า 2 ชั้น → ซื้ออุปกรณ์แยก → บัดกรีเอง

> 🔄 **v1.1 = ปรับสเปกให้ตรงกับ Schematic3 ที่วาดเสร็จแล้ว** (netlist 14 ส.ค.)
> ไม่ใช่สเปกที่คิดไว้ล่วงหน้าอีกต่อไป แต่เป็น**เอกสารที่สะท้อนวงจรจริง**
> รายการที่เปลี่ยนดูหัวข้อ 14

---

## 1. ภาพรวมบอร์ด

**หน้าที่:** carrier board สำหรับเสียบโมดูล ESP32-S3-DevKitC-1 แล้วต่อเซนเซอร์คุณภาพอากาศ
เพื่อเก็บข้อมูลและรัน anomaly detection บนอุปกรณ์

**สิ่งที่บอร์ดนี้ *ไม่* มี** — เพราะ DevKitC มีอยู่แล้วบนตัวมันเอง:
USB · ตัวควบคุมแรงดัน 3.3 V · วงจร EN/RC · pull-up ของ GPIO0 · ปุ่ม BOOT/RESET · ฟิวส์ · TVS

```
                    ┌─────────────────────────────┐
   5 V adapter ────▶│  +5V rail ──┬──▶ J1 PMS7003 │
                    │             ├──▶ J2 ZE07-CO │
                    │             └──▶ U1 pin 21  │
                    │                             │
                    │  U1 = ESP32-S3-DevKitC-1    │
                    │   (เสียบบน socket 2×22)      │
                    │      │                      │
                    │      ├─ 3V3 ──▶ I²C, SD     │
                    │      ├─ UART1 ──▶ J1        │
                    │      ├─ UART2 ──▶ J2        │
                    │      ├─ I²C ────▶ J3 J4 J5  │
                    │      ├─ SPI ────▶ J6        │
                    │      └─ GPIO ───▶ LED ปุ่ม   │
                    └─────────────────────────────┘
```

---

## 2. ข้อจำกัดการออกแบบ (บังคับ)

| # | ข้อกำหนด | เหตุผล |
|---|---|---|
| D1 | **PCB 2 ชั้น** | ต้นทุนต่ำ วงจรไม่ซับซ้อน |
| D2 | **สั่ง PCB เปล่า ไม่ใช้บริการประกอบ** | ทีมบัดกรีเอง ประหยัด |
| D3 | **SMD ทั้งหมดใช้ขนาด 0805 เท่านั้น** ห้าม 0603 หรือเล็กกว่า | บัดกรีมือด้วยคีมปากคีบได้ |
| D4 | **คอนเนคเตอร์ ปุ่ม LED buzzer ใช้ THT** | บัดกรีง่าย ทนแรงดึง |
| D5 | **SMD วางด้านบน (top) เท่านั้น** ห้ามมีชิ้นส่วนด้านล่าง | บัดกรีด้านเดียว |
| D6 | **ทุกแพด THT ที่ต่อ GND ต้องมี thermal relief** | ถ้าต่อ ground plane เต็มจะบัดกรีไม่ติด |
| D7 | **ห้ามใช้ขาในรายการหัวข้อ 5.2 เด็ดขาด** | strapping / PSRAM / USB / RGB LED |
| D8 | **เว้นระยะระหว่างชิ้นส่วน ≥ 1.5 mm** | ปลายหัวแร้งต้องเข้าถึง |

---

## 3. รายการอุปกรณ์ (BOM)

### 3.1 โมดูลและคอนเนคเตอร์ (THT)

| Des | อุปกรณ์ | Footprint | ขา | หมายเหตุ |
|---|---|---|---|---|
| **U1** | **ซ็อกเก็ตสำหรับ DevKitC** — ดูหมายเหตุใต้ตาราง | 2×22 THT 2.54 mm | 44 | ⚠️ วัดระยะสองแถวจากบอร์ดจริง |
| **J1** | PMS7003 | JST-XH 8P vertical | 8 | ⚠️ ยืนยันจำนวนขา adapter ที่ซื้อ |
| **J2** | ZE07-CO | 🆕 **JST-XH 5P vertical** *(เปลี่ยนจาก pin header)* | 5 | ✅ ดูเหตุผลข้อ 6.3 |
| **J3** | ENS160+BME280 (I²C) | JST-XH 4P vertical | 4 | |
| **J4** | OLED SSD1306 (I²C) | JST-XH 4P vertical | 4 | |
| **J5** | SCD40 (I²C, ตัวเลือก) | JST-XH 4P vertical | 4 | |
| **J6** | microSD breakout | pin header 1×6 male 2.54 | 6 | ใช้โมดูล ไม่ใช่ socket |
| **J7** | Console UART | pin header 1×3 male 2.54 | 3 | |
| **J8** | ไฟเข้า 5 V *(ตัวเลือก)* | terminal block 2P 5.08 mm | 2 | ⚠️ ดูข้อ 6.6 |

### 3.2 ชิ้นส่วนแอ็กทีฟ

| Des | อุปกรณ์ | Footprint | หมายเหตุ |
|---|---|---|---|
| **Q1** | 2N7002 N-MOSFET | SOT-23-3 | ขับ buzzer |
| **D1** | 1N4148W | SOD-123 | 🔴 flyback — ทิศทางสำคัญ |
| **BZ1** | Magnetic buzzer 3.3 V active | THT ระยะขาตามที่ซื้อ | |
| **LED1** | LED **เขียว** | LED0805 | สถานะ NORMAL |
| **LED2** | LED **เหลือง** | LED0805 | สถานะ WATCH |
| **LED3** | LED **แดง** | LED0805 | สถานะ ALARM |
| **LED4** | LED **น้ำเงิน** | LED0805 | ไฟเข้า |
| **SW1** | ปุ่มกด MARK | tact 4P SMD 5.1×5.1 | |
| **SW2** | ปุ่มกด MODE | tact 4P SMD 5.1×5.1 | |
| **SW3** | ปุ่มกด ACK | tact 4P SMD 5.1×5.1 | |

### 3.3 ตัวต้านทาน — **0805 ทั้งหมด · 15 ตัว**

| Des | ค่า | หน้าที่ | กระแส/ค่าที่ได้จริง |
|---|---|---|---|
| R1 | 4.7 kΩ | pull-up SDA | I_sink ≈ 0.70 mA |
| R2 | 4.7 kΩ | pull-up SCL | I_sink ≈ 0.70 mA |
| R3 | **470 Ω** | อนุกรมสาย ESP TX → PMS RX | จำกัดกระแสตอนขัดแย้งกัน |
| R4 | 100 Ω | อนุกรมสาย ESP TX → ZE07 RX | ดูคำเตือนข้อ 6.3 |
| R5 | **220 Ω** | จำกัดกระแส LED1 | ≈ 5.9 mA @ Vf 2.0 V |
| R6 | **220 Ω** | จำกัดกระแส LED2 | ≈ 5.9 mA @ Vf 2.0 V |
| R7 | **220 Ω** | จำกัดกระแส LED3 | ≈ 5.9 mA @ Vf 2.0 V |
| R8 | **470 Ω** | จำกัดกระแส LED4 (ไฟเข้า, ราง **5 V**) | ≈ 4.3 mA @ Vf 3.0 V |
| R9 | 1 kΩ | อนุกรม gate ของ Q1 | |
| R10 | **100 kΩ** | pull-down gate ของ Q1 | Vgs(on) ≈ 3.27 V |
| **R11** | **220 Ω** | 🆕 อนุกรมป้องกัน GPIO ปุ่ม MARK | I_max 15 mA |
| **R12** | **220 Ω** | 🆕 อนุกรมป้องกัน GPIO ปุ่ม MODE | I_max 15 mA |
| **R13** | **220 Ω** | 🆕 อนุกรมป้องกัน GPIO ปุ่ม ACK | I_max 15 mA |
| **R14** | **1 kΩ** | 🆕 อนุกรม U0TXD → J7 | กัน backfeed จาก USB-TTL |
| **R15** | **1 kΩ** | 🆕 อนุกรม J7 → U0RXD | กัน backfeed จาก USB-TTL |

> **ทำไม R10 เป็น 100 kΩ ไม่ใช่ 10 kΩ แล้วยังใช้ได้**
> ตอน GPIO สั่งสูง gate เห็นแรงดันจากตัวแบ่ง R9/R10:
> `Vgs = 3.3 × 100k/(100k+1k) = 3.27 V` — **สูงกว่าเดิม (10 kΩ ให้ 3.0 V)** เปิด MOSFET ได้เต็มกว่า
> ตอน GPIO ลอย (ช่วงบูต) กระแสรั่วของ gate 2N7002 ≤ 100 nA → `100k × 100n = 10 mV` ต่ำกว่า Vgs(th) มาก → ปิดสนิท
> ตอนปิด: ถ้า GPIO ขับต่ำ R9 (1 kΩ) คายประจุใน ~50 ns · ถ้า GPIO ลอย R10 คายใน ~5 µs
> **buzzer แบบ active ขับด้วย DC on/off ไม่ใช่ PWM ความถี่สูง → 5 µs ไม่มีผล** ✅ ผ่าน

> **🆕 ทำไม R11–R13 เป็นของดีที่เพิ่มเข้ามา**
> ถ้าเฟิร์มแวร์ตั้ง GPIO ปุ่มเป็น output-high โดยพลาด แล้วมีคนกดปุ่ม → GPIO ต่อตรงลง GND
> ไม่มี R = กระแสถูกจำกัดด้วยความต้านทานภายในของไดรเวอร์เท่านั้น **ขาพังได้**
> มี R = `3.3 V / 220 Ω = 15 mA` ต่ำกว่าพิกัด 40 mA ของ ESP32 ✅

### 3.4 Test point (TH) — 🆕 6 จุด

| Des | เน็ต | ใช้ทำอะไรในแล็บ |
|---|---|---|
| TP1 | `GND` | จุดต่อกราวด์ของ probe |
| TP2 | `SDA` | ดู waveform I²C ด้วย logic analyzer |
| TP3 | `SCL` | วัดความถี่คล็อก I²C จริง |
| TP4 | `GND` | กราวด์ตัวที่ 2 — วางคนละมุมกับ TP1 |
| TP5 | `+3V3` | วัด ripple ราง 3.3 V |
| TP6 | `+5V` | วัด **แรงดันตกตอนพัดลม PMS สตาร์ท** ← ตัวเลขที่ต้องใส่ใน lab report |

> footprint `TESTPOINT-TH_BD3.2` = แพดทองเปิดเจาะรู 🔑 **หนีบปากคีบ probe ได้ ไม่ต้องบัดกรีสายเพิ่ม**

### 3.5 ตัวเก็บประจุ — **0805 ทั้งหมด ยกเว้น C1**

| Des | ค่า | Footprint | หน้าที่ |
|---|---|---|---|
| **C1** | **470 µF / 16 V** | electrolytic THT ⚠️ วัดขนาดจริง | 🔴 bulk ราง 5 V |
| C2 | 10 µF | C0805 | ราง 5 V |
| C3 | 100 nF | C0805 | ราง 5 V |
| C4 | 10 µF | C0805 | ราง 3.3 V |
| C5 | 100 nF | C0805 | ราง 3.3 V |
| C6 | 100 nF | C0805 | decoupling J3 |
| C7 | 100 nF | C0805 | decoupling J4 |
| C8 | 100 nF | C0805 | decoupling J5 |
| C9 | 100 nF | C0805 | decoupling J6 |
| C10 | 100 nF | C0805 | debounce SW1 |
| C11 | 100 nF | C0805 | debounce SW2 |
| C12 | 100 nF | C0805 | debounce SW3 |
| 🆕 **C13** | **470 µF / 16 V** | electrolytic THT *(ตัวเดียวกับ C1)* | 🟠 bulk ราง **3.3 V** — ดูข้อ 6.10 |

> ### 🟠 C13 — ตัวที่เพิ่มมาใหม่และต้องคิดก่อนสั่ง
>
> **ทำไมมันช่วย** — ราง 3.3 V มีโหลดที่กระชากเป็นช่วง คือ **การเขียน microSD** (พีคได้ ~100 mA)
> LDO ไม่ได้ตอบสนองทันที มันใช้เวลาประมาณ 50 µs กว่าจะปรับกระแสตาม
> ช่วงนั้นตัวเก็บประจุต้องจ่ายแทน:
>
> ```
> ΔV = I × Δt / C        ← สูตรพื้นฐานของตัวเก็บประจุ
>
> มีแค่ C4 (10 µF):    ΔV = 0.1 A × 50 µs / 10 µF  = 500 mV  ❌ มากเกินไป
> มี C13 ด้วย (480 µF): ΔV = 0.1 A × 50 µs / 480 µF = 10 mV   ✅ ดีมาก
> ```
>
> ✅ **เหตุผลนี้ฟังขึ้น เก็บ C13 ไว้ได้** — แต่ต้องเช็ค 2 ข้อในข้อ 6.10 ก่อนสั่ง

> ### 🔑 U1 คืออะไรกันแน่
>
> footprint `U1` ให้แค่ **รู THT 44 รู** ไม่ได้แถมชิ้นส่วนมาด้วย → ต้องซื้อ 2 อย่างแยกกัน
>
> | ต้องซื้อ | จำนวน | บัดกรีไหม |
> |---|---|---|
> | **Female header 1×40 2.54 mm** ตัดเหลือ 1×22 | **2 เส้น** *(ซื้อ 4–5 เผื่อตัดพลาด)* | ✅ บัดกรีลงบอร์ด |
> | **ESP32-S3-DevKitC-1** | 1 | ❌ **เสียบ ไม่บัดกรี** |
>
> ⚠️ **1×22 ไม่ใช่ขนาดมาตรฐาน** — ต้องซื้อ 1×40 มาตัด และจะเสียตำแหน่งที่ตัดไป 1 ช่อง
> → หนึ่งเส้นได้ 1×22 มาแค่อันเดียว
>
> ⚠️ **เช็คว่า DevKit มีขาตัวผู้บัดกรีมาแล้วหรือยัง** — ถ้ามาแต่บอร์ดเปล่า
> ต้องซื้อ male header 1×40 อีก 2 เส้นมาบัดกรีติด DevKit ก่อน
>
> 📌 ความสูงรวมหลังเสียบ ≈ **15 mm** (header 8.5 + DevKit 1.6 + โมดูล 3.1)
>
> **ทางเลือก:** บัดกรี DevKit ติดบอร์ดตรงๆ ก็ได้ (บางกว่า ถูกกว่า)
> แต่ถอดเปลี่ยนไม่ได้ และถ้าบอร์ดพังจะเสีย DevKit ไปด้วย — **ไม่แนะนำ**

**รวม:** THT 9 คอนเนคเตอร์ + 1 buzzer + 1 อิเล็กโทรไลต์ · SMD 0805 จำนวน 22 ตัว + SOT-23 1 + SOD-123 1 + ปุ่ม 3

---

## 4. รายชื่อเน็ตทั้งหมด (**37 เน็ต** — ยืนยันจาก netlist 14 ส.ค.)

| ชนิด | เน็ต | จำนวน |
|---|---|---|
| ไฟเลี้ยง | `+5V` `+3V3` `GND` | 3 |
| บัส I²C | `SDA` `SCL` | 2 |
| UART1 (PMS) | `PMS_TX` `PMS_RX` **`PMS_RX_S`** `PMS_RST` `PMS_SET` | 5 |
| UART2 (CO) | `CO_TX` `CO_RX` **`CO_RX_S`** | 3 |
| SPI | `SD_CS` `SD_MOSI` `SD_CLK` `SD_MISO` | 4 |
| LED | `LED_G` **`LED_G_A`** `LED_Y` **`LED_Y_A`** `LED_R` **`LED_R_A`** **`PWR_LED_A`** | 7 |
| เสียง | `BUZZ` `BUZZ_DRV` **`BUZZ_G`** | 3 |
| ปุ่ม | `BTN_MARK` **`BTN_MARK_S`** `BTN_MODE` **`BTN_MODE_S`** `BTN_ACK` **`BTN_ACK_S`** | 6 |
| console | `U0TXD` **`U0TXD_S`** `U0RXD` **`U0RXD_S`** | 4 |

> ### 🔑 ทำไมเน็ตเยอะขึ้นจาก 20 เป็น 37
>
> **ทุกครั้งที่แทรกตัวต้านทานอนุกรม เน็ตหนึ่งเส้นจะถูกผ่าเป็นสองเส้น**
>
> ```
> ก่อน:   U1.39 ────────────── SW1        = 1 เน็ต (BTN_MARK)
>
> หลัง:   U1.39 ── R11 ── SW1
>          └BTN_MARK┘  └BTN_MARK_S┘        = 2 เน็ต
> ```
>
> ต่อท้าย `_S` = **ฝั่ง Sensor/Switch** คือด้านนอกของตัวต้านทาน (ด้านที่ต่อโลกภายนอก)
> ไม่ต่อท้าย = ด้านที่ต่อขา ESP32 โดยตรง
> `_A` = **Anode** ของ LED
>
> 📌 **ประโยชน์ตอนไล่บั๊ก:** เห็นชื่อเน็ตแล้วรู้ทันทีว่ากำลังวัดด้านไหนของตัวต้านทาน
> เช่นวัด `BTN_MARK` ได้ 3.3 V แต่ `BTN_MARK_S` ได้ 0 V → R11 ขาดหรือบัดกรีไม่ติด

---

## 5. ตารางต่อขา — U1 (ESP32-S3-DevKitC-1)

### 5.1 ขาที่ต้องต่อ (**28 จุด** — ตรงกับ netlist ทุกบรรทัด ✅)

| ขา U1 | GPIO | เน็ต |
|---|---|---|
| 1 | 3V3 | `+3V3` |
| 2 | 3V3 | `+3V3` |
| 5 | GPIO5 | `CO_TX` |
| 6 | GPIO6 | `CO_RX` |
| 9 | GPIO16 | `PMS_RST` |
| 10 | GPIO17 | `PMS_RX` |
| 11 | GPIO18 | `PMS_TX` |
| 12 | GPIO8 | `SDA` |
| 15 | GPIO9 | `SCL` |
| 16 | GPIO10 | `SD_CS` |
| 17 | GPIO11 | `SD_MOSI` |
| 18 | GPIO12 | `SD_CLK` |
| 19 | GPIO13 | `SD_MISO` |
| 21 | 5V | `+5V` |
| 22 | GND | `GND` |
| 23 | GND | `GND` |
| 24 | GND | `GND` |
| 27 | GPIO21 | `PMS_SET` |
| 28 | GPIO47 | `BTN_MODE` |
| 36 | GPIO39 | `LED_Y` |
| 37 | GPIO40 | `LED_R` |
| 38 | GPIO41 | `BUZZ` |
| 39 | GPIO42 | `BTN_MARK` |
| 40 | GPIO2 | `LED_G` |
| 41 | GPIO1 | `BTN_ACK` |
| 42 | GPIO44 | `U0RXD` |
| 43 | GPIO43 | `U0TXD` |
| 44 | GND | `GND` |

### 5.2 🔴 ขาที่ห้ามต่อเด็ดขาด — วาง No Connect Flag

| ขา U1 | GPIO | เหตุผล |
|---|---|---|
| **32, 33, 34** | GPIO35, 36, 37 | 🔴 **Octal PSRAM ใช้ภายใน** |
| **13, 14, 30, 31** | GPIO3, 46, 45, 0 | 🔴 **Strapping pin** — ต่อผิด boot ไม่ขึ้น |
| **29, 35** | GPIO48, 38 | 🔴 **ชนกับ RGB LED บน DevKit** |
| 25, 26 | GPIO19, 20 | USB D−/D+ |
| 3 | RST | DevKit มีปุ่มแล้ว |

### 5.3 ขาว่าง — ไม่ต่อ แต่ใช้ในอนาคตได้

ขา 4 (GPIO4) · 7 (GPIO7) · 8 (GPIO15) · 20 (GPIO14)

---

## 6. วงจรทีละบล็อก

### 6.1 ⚡ ไฟเลี้ยง

```
U1.21 (5V) ──┬── NET:+5V ──┬── J1.1, J1.2   (PMS7003 VCC)
             │             ├── J2.1          (ZE07-CO Vin)
             │             ├── R8.1          (LED4 ไฟเข้า)  ← 🔧 แก้แล้ว
             │             ├── TP6           (test point)
             │             └── C1(+), C2.1, C3.1
             │
             └── [ถ้าใช้ J8] ── ดูข้อ 6.6

U1.1, U1.2 (3V3) ── NET:+3V3 ──┬── J3.1, J4.1, J5.1, J6.1
                                ├── R1.1, R2.1 (pull-up I²C)
                                ├── BZ1.2      ← 🔧 ขา 2 ไม่ใช่ขา 1
                                ├── D1.1 (แคโทด)
                                ├── TP5        (test point)
                                └── C4.1, C5.1, C6.1, C7.1, C8.1, C9.1

U1.22, U1.23, U1.24, U1.44 ── NET:GND ──┬── TP1, TP4
                                         └── R10.2, Q1.2, SW1.3, SW2.3, SW3.3
```

> ### 🔧 v1.1 แก้ 2 จุดที่ v1.0 เขียนผิด
> **R8 อยู่บนราง +5 V ไม่ใช่ +3.3 V** — v1.0 ใส่ไว้ใต้ +3V3 ผิด
> ผลคือค่าตัวต้านทานต้องคำนวณจาก 5 V: `(5.0 − 3.0) / 470 = 4.3 mA` สำหรับ LED น้ำเงิน
>
> **BZ1 ขาที่ต่อ +3V3 คือขา 2 ไม่ใช่ขา 1** — ดูคำเตือนขั้ว buzzer ในข้อ 6.7

**ตัวเก็บประจุลง GND:** C1(−), C2.2, C3.2, C4.2, C5.2, C6.2, C7.2, C8.2, C9.2, C10.2, C11.2, C12.2

> 🔴 **C1 มีขั้ว** — ขา + ไป `+5V` · ขา − ไป `GND`
> ⚠️ ต่อกลับขั้วจะบวมและระเบิด · ต้องมีเครื่องหมาย + บน silkscreen

### 6.2 PMS7003 (J1 — UART1)

| ขา J1 | สัญญาณ | ต่อกับ |
|---|---|---|
| 1 | VCC | `+5V` |
| 2 | VCC | `+5V` |
| 3 | GND | `GND` |
| 4 | GND | `GND` |
| 5 | RESET | `PMS_RST` → U1.9 |
| 6 | RXD | `PMS_RX_S` ← **R3 (470 Ω)** ← `PMS_RX` ← U1.10 |
| 7 | TXD | `PMS_TX` → U1.11 |
| 8 | SET | `PMS_SET` → U1.27 |

✅ ไฟเลี้ยง 5 V แต่**ลอจิกเป็น 3.3 V TTL** → ต่อตรงกับ ESP32 ได้ ไม่ต้อง level shift

**R3 ต่อแบบอนุกรม:** `U1.10 ── R3.1 ; R3.2 ── J1.6`

### 6.3 🔴 ZE07-CO (J2 — UART2)

| ขา J2 | สัญญาณ | ต่อกับ |
|---|---|---|
| 1 | Vin | 🔴 **`+5V`** — ไม่ใช่ 3.3 V |
| 2 | GND | `GND` |
| 3 | TXD | `CO_TX` → U1.5 |
| 4 | RXD | `CO_RX_S` ← **R4 (100 Ω)** ← `CO_RX` ← U1.6 |
| 5 | DAC | ไม่ต่อ *(หรือทำเป็น test point)* |

> 🔴 **ZE07-CO ไม่มีวงจรป้องกันการต่อขั้วกลับ** — ต่อผิดพังทันที
> ต้องพิมพ์ `5V` และ `GND` ลง silkscreen ให้ชัดข้างคอนเนคเตอร์

> ### ✅ 🆕 J2 เปลี่ยนเป็น JST-XH 5P แล้ว — เป็นการแก้ที่ตรงจุดมาก
>
> เดิมเป็น pin header ตัวผู้ 1×5 ซึ่ง **เสียบกลับด้านได้** ไม่มีอะไรกัน
> JST-XH มี **ตัวล็อกกันเสียบผิดด้าน (keyed)** — เสียบผิดทางเข้าไม่ได้เลยทางกายภาพ
>
> ```
>  pin header เดิม          JST-XH ใหม่
>  ▯▯▯▯▯  ← เสียบกลับได้    ┌──────┐
>                            │▯▯▯▯▯│ ← มีขอบล็อกด้านเดียว
>                            └─┐  ┌─┘
> ```
>
> 🔑 **นี่คือการย้ายความปลอดภัยจาก "silkscreen เตือน" ไปเป็น "ผิดไม่ได้เชิงกายภาพ"**
> ซึ่งเป็นระดับที่แข็งแรงกว่ามาก — คนอ่าน silkscreen ผิดได้ แต่เสียบขั้วผิดด้านไม่ได้
> สำคัญเป็นพิเศษกับ J2 เพราะเป็นตัวเดียวบนบอร์ดที่ **ต่อผิดแล้วพังทันที**
>
> ✅ ตอนนี้คอนเนคเตอร์เซนเซอร์ทุกตัว (J1 J2 J3 J4 J5) เป็น JST-XH เหมือนกันหมด
> ⚠️ **แลกมาด้วย:** ต้องซื้อสาย JST-XH 5P มาบัดกรีเข้ากับ ZE07-CO เอง (ZE07 มาแบบขาเปล่า)
>
> ✅ TX ของ ZE07 เป็นลอจิก 3.0 V → ต่อเข้า ESP32 ได้ตรง

**R4 ต่อแบบอนุกรม:** `U1.6 ── R4.1 ; R4.2 ── J2.4`

> ### ⚠️ ต้องเข้าใจให้ตรงว่า R4 ทำอะไร — และ *ไม่* ทำอะไร
>
> **v1.0 เขียนว่า R4 แปลง 3.3 V → 3.0 V ซึ่งไม่จริง**
> ตัวต้านทานอนุกรมตัวเดียวไม่ลดแรงดันถ้าปลายทางเป็นอินพุตอิมพีแดนซ์สูง
> (ไม่มีกระแสไหล → ไม่มีแรงดันตกคร่อม R4 → ขา RX ของ ZE07 ยังเห็น 3.3 V เต็ม)
>
> **สิ่งที่ R4 ทำจริง:** จำกัดกระแสผ่านไดโอดป้องกันภายในของ ZE07
> ถ้าแรงดันเกินพิกัด → `(3.3 − 3.0) / 100 = 3 mA` ซึ่งปลอดภัย ✅
>
> **ถ้าอยากลดแรงดันจริงต้องใช้ตัวแบ่งแรงดัน 2 ตัว** — แต่ที่นี่ไม่จำเป็น
> `[ต้องไปเช็คเอง]` เปิด **ZE07-CO User's Manual** หัวข้อ Electrical Characteristics
> ดูว่า RXD รับ 3.3 V ได้ไหม ถ้าได้ก็จบ ถ้าไม่ได้ต้องเพิ่มตัวแบ่งแรงดัน

### 6.4 บัส I²C (J3, J4, J5)

**ทั้งสามคอนเนคเตอร์เรียงขาเหมือนกันเป๊ะ** เพื่อให้เสียบสลับกันได้โดยไม่พัง

| ขา | สัญญาณ |
|---|---|
| 1 | `+3V3` |
| 2 | `GND` |
| 3 | `SDA` |
| 4 | `SCL` |

**Pull-up:** `R1 (4.7 kΩ)` ระหว่าง `SDA` กับ `+3V3` · `R2 (4.7 kΩ)` ระหว่าง `SCL` กับ `+3V3`

**ที่อยู่ I²C ไม่ชนกัน:** ENS160 = 0x52/0x53 · BME280 = 0x76/0x77 · SCD40 = 0x62 · SSD1306 = 0x3C

### 6.5 microSD (J6 — SPI)

| ขา J6 | สัญญาณ | ต่อกับ |
|---|---|---|
| 1 | VCC | `+3V3` |
| 2 | GND | `GND` |
| 3 | CS | `SD_CS` → U1.16 |
| 4 | MOSI | `SD_MOSI` → U1.17 |
| 5 | CLK | `SD_CLK` → U1.18 |
| 6 | MISO | `SD_MISO` → U1.19 |

> 📌 ถ้าใช้ **socket แทนโมดูล** ต้องต่อขา shield ทุกขาลง `GND` ด้วย

### 6.6 Console UART (J7) และไฟเข้า (J8)

**J7:**
| ขา | เน็ต | ผ่านตัวต้านทาน |
|---|---|---|
| 1 | `U0TXD_S` ← **R14 (1 kΩ)** ← `U0TXD` ← U1.43 | 🆕 |
| 2 | `U0RXD_S` → **R15 (1 kΩ)** → `U0RXD` → U1.42 | 🆕 |
| 3 | `GND` | |

พิมพ์ `TX` `RX` `G` ลง silkscreen
📌 ชื่อมองจากฝั่ง ESP32 — ตอนต่อ USB-serial ต้องไขว้สาย

> **🆕 R14/R15 กันอะไร**
> USB-TTL adapter ราคาถูกหลายรุ่นเป็นลอจิก **5 V** ถ้าเสียบผิดรุ่น 5 V จะเข้าขา ESP32 ตรงๆ
> R14/R15 จำกัดกระแสผ่านไดโอดป้องกันภายใน: `(5 − 3.6) / 1k = 1.4 mA` ✅ ปลอดภัย
> อีกกรณี: ถ้า adapter จ่ายไฟมาตอน DevKit ยังไม่มีไฟ จะ backfeed เข้าราง 3.3 V — R14/R15 กันไว้ด้วย
>
> **ผลข้างเคียงที่ต้องรู้:** R 1 kΩ + ความจุอินพุต ~15 pF → เวลาขึ้น ≈ 15 ns
> ที่ 115200 baud หนึ่งบิตกิน 8.7 µs → **ช้ากว่ากันเกือบ 600 เท่า ไม่มีผล** ✅
> ถ้าอนาคตจะดัน console เป็น 2 Mbaud ค่อยกลับมาคิดใหม่

**J8 (ตัวเลือก):** ขา 1 → `+5V` · ขา 2 → `GND`

> 🔴 **ถ้าติดตั้ง J8: ห้ามเสียบ USB ของ DevKit พร้อมกับจ่ายไฟทาง J8**
> ทางแก้: ใส่ **jumper 2 ขา** เลือกแหล่งจ่าย หรือ **ไดโอด Schottky กันย้อน** อนุกรมที่ J8
> ถ้าไม่ทำ ให้เขียนเตือนบน silkscreen: `USB OR J8 — NOT BOTH`

### 6.7 🔴 Buzzer + MOSFET

```
        +3V3
         │
    ┌────┴────┐
    │         │
  BZ1.2    D1.1 = แคโทด (ด้านมีแถบคาด)
    │         │
  BZ1.1 ─────┴──── D1.2 = แอโนด     ← เน็ต BUZZ_DRV
    │
  Q1.3 (drain)
    │
  Q1.2 (source) ──── GND

  U1.38 ── R9 (1 kΩ) ── Q1.1 (gate)   ← เน็ต BUZZ_G
       └BUZZ┘             │
                       R10 (100 kΩ)
                          │
                         GND
```

| เน็ต | สมาชิก (จาก netlist) |
|---|---|
| `+3V3` | **BZ1.2**, **D1.1 (แคโทด)** |
| `BUZZ_DRV` | **BZ1.1**, **D1.2 (แอโนด)**, Q1.3 |
| `BUZZ` | U1.38, R9.1 |
| **`BUZZ_G`** 🆕 | R9.2, R10.1, Q1.1 |
| `GND` | R10.2, Q1.2 |

> 🔴 **ทิศทาง D1 ผิดไม่ได้** — แคโทด (ขามีแถบ) ต้องอยู่ด้าน `+3V3`
> ถ้ากลับด้าน จะลัด 3.3 V ลง drain ตลอดเวลา → Q1 ไหม้
> `[ต้องไปเช็คเอง]` เปิด symbol 1N4148W ใน EasyEDA ยืนยันว่า **pin 1 = cathode**
> ถ้าไลบรารีกำหนด pin 1 = anode ต้องกลับด้านทั้งหมด

> ### 🔴 ขั้ว buzzer — จุดที่ต้องเช็คก่อนบัดกรี
>
> netlist ปัจจุบันคือ **BZ1.2 → +3V3** และ **BZ1.1 → drain ของ Q1**
>
> ```
> กระแสไหล:  +3V3 ──▶ BZ1.2 ──▶ BZ1.1 ──▶ drain ──▶ GND
> ```
>
> ⚠️ **buzzer แบบ active magnetic ส่วนใหญ่มีขั้ว** — ขา + ต้องรับไฟบวก
> ถ้า footprint `BUZ-TH_BD12.0-P6.00-D0.9-RD` กำหนดให้ **pin 1 = +** แสดงว่าตอนนี้**ต่อกลับขั้ว**
>
> **อาการถ้ากลับขั้ว:** ไม่ดัง หรือดังเบามาก — ไม่ระเบิด ไม่ไหม้ แต่ตามหาสาเหตุยาก
>
> `[ต้องวัดจริง]` **วิธีตรวจใน 30 วินาที:** เอา buzzer ที่ซื้อมาต่อกับถ่าน 3 V ตรงๆ
> ลองทั้งสองทาง จำว่าทางไหนดัง → เทียบกับ pin 1 ในไลบรารี → แก้ schematic ถ้าไม่ตรง

> 🔑 **R10 จำเป็น** — ถ้าไม่มี ตอนบูต gate จะลอยและ buzzer อาจดังเอง
> ค่า 100 kΩ ที่ใช้จริงยังทำหน้าที่ได้ครบ — เหตุผลอยู่ในตารางข้อ 3.3

### 6.8 LED สถานะ

| LED | สี | เบอร์ใน BOM | ต่อผ่าน | จาก | เน็ตแอโนด | กระแส |
|---|---|---|---|---|---|---|
| LED1 | เขียว | 🟠 `KT-0805YG` | R5 (**220 Ω**) | `LED_G` U1.40 | `LED_G_A` | ≈ 5.9 mA |
| LED2 | เหลือง | `KT-0805Y` | R6 (**220 Ω**) | `LED_Y` U1.36 | `LED_Y_A` | ≈ 5.9 mA |
| LED3 | แดง | `KT-0805R` | R7 (**220 Ω**) | `LED_R` U1.37 | `LED_R_A` | ≈ 5.9 mA |
| LED4 | น้ำเงิน | `KT-0805B` | R8 (**470 Ω**) | **`+5V`** | `PWR_LED_A` | ≈ 4.3 mA |

**ขั้วทุกดวงเหมือนกัน:** pin 1 = แอโนด (ไปตัวต้านทาน) · pin 2 = แคโทด (ลง `GND`)

**การคำนวณ** — `I = (V_supply − V_f) / R` ; V_f จาก datasheet ของ LED

| LED | V_supply | V_f *(ค่าทั่วไป)* | R | I ที่ได้ |
|---|---|---|---|---|
| LED1–3 | 3.3 V | ≈ 2.0 V | 220 Ω | **5.9 mA** |
| LED4 | 5.0 V | ≈ 3.0 V *(น้ำเงินสูงกว่า)* | 470 Ω | **4.3 mA** |

✅ ทั้งหมดต่ำกว่าพิกัด 40 mA ต่อขาของ ESP32-S3 มาก
✅ รวมกระแส LED สถานะสูงสุด (ติดพร้อมกัน 3 ดวง) = 17.7 mA — ยังต่ำกว่าพิกัดรวมของ VDD3P3 bank
`[ต้องไปเช็คเอง]` V_f จริงอยู่ใน datasheet ของ KENTO KT-0805 series — ถ้า V_f สูงกว่าที่ประมาณ กระแสจะน้อยลง ไฟหรี่ลง

> 🟠 **LED1 = `KT-0805YG` คือ yellow-green ไม่ใช่เขียวแท้**
> สีจะใกล้กับ LED2 (`KT-0805Y` เหลือง) มาก **ผู้ใช้แยกสถานะ NORMAL กับ WATCH ไม่ออก**
> ซึ่งขัดกับจุดประสงค์ทั้งหมดของไฟสถานะ
> **ทางแก้:** เปลี่ยนเป็น `KT-0805G` (pure green ~525 nm)
> ⚠️ V_f ของเขียวแท้สูงกว่า (≈ 3.0–3.2 V) → ที่ 220 Ω จะได้ `(3.3−3.1)/220 = 0.9 mA` **หรี่มาก**
> → ถ้าเปลี่ยนเป็นเขียวแท้ **ต้องลด R5 เหลือ ~47 Ω** ด้วย ไม่ใช่เปลี่ยนแค่ LED

> 🔑 **LED ทั้ง 4 ตัวต้องวางขั้วเหมือนกันทุกตัว** — แอโนดอยู่ฝั่งตัวต้านทานเสมอ
> พิมพ์ `G` `Y` `R` `PWR` ลง silkscreen ข้างแต่ละดวง

### 6.9 ปุ่มกด

**🆕 v1.1 เพิ่มตัวต้านทานอนุกรม R11–R13 ทุกปุ่ม**

```
              BTN_MARK        BTN_MARK_S
U1.39 ─────────┬──── R11 ────────┬──── SW1.1 ──── SW1.3 ── GND
    (GPIO42)   │    220 Ω        │
          pull-up ภายใน          └──── C10.1 ──── C10.2 ── GND
           ~45 kΩ (ตั้งใน fw)          100 nF

U1.28 (GPIO47) ── R12 ── ┬── SW2 ── GND   (MODE)   นับ BTN_MODE / BTN_MODE_S
                          └── C11 ── GND

U1.41 (GPIO1)  ── R13 ── ┬── SW3 ── GND   (ACK)    นับ BTN_ACK / BTN_ACK_S
                          └── C12 ── GND
```

> ### 🔴 บังคับสำหรับเฟิร์มแวร์ — **ไม่มี pull-up ภายนอกบนบอร์ด**
>
> ```c
> // ถ้าลืมบรรทัด pull_up_en ปุ่มจะอ่านค่ามั่วทั้งหมด
> gpio_config_t btn = {
>     .pin_bit_mask = (1ULL<<42) | (1ULL<<47) | (1ULL<<1),
>     .mode         = GPIO_MODE_INPUT,
>     .pull_up_en   = GPIO_PULLUP_ENABLE,    // 🔴 ขาดไม่ได้
>     .pull_down_en = GPIO_PULLDOWN_DISABLE,
>     .intr_type    = GPIO_INTR_NEGEDGE,
> };
> ESP_ERROR_CHECK(gpio_config(&btn));
> ```
>
> **อาการถ้าลืม:** ปุ่มอ่านได้บ้างไม่ได้บ้าง เปลี่ยนตามการเอามือเข้าใกล้บอร์ด
> เพราะขาลอย รับสัญญาณรบกวนจากอากาศ — **ไล่บั๊กนี้เสียเวลาหลายชั่วโมง**

**การดีบาวซ์ด้วยฮาร์ดแวร์ — คำนวณจริง**

```
ตอนปล่อยปุ่ม: pull-up ภายใน (~45 kΩ) + R11 (220 Ω) ชาร์จ C10 (100 nF)

τ = (45 000 + 220) × 100 × 10⁻⁹ = 4.52 ms
เวลาถึงระดับลอจิกสูง ≈ 2τ ≈ 9 ms
```

| ค่า | ผลลัพธ์ |
|---|---|
| การเด้งของปุ่ม tact ทั่วไป | 1–5 ms |
| ค่าคงตัวเวลาของวงจรนี้ | 4.5 ms |
| ✅ สรุป | **กรองการเด้งได้ แต่ไม่ช้าจนคนรู้สึก** |

> ⚠️ `[ต้องวัดจริง]` ค่า pull-up ภายในของ ESP32-S3 อยู่ในช่วงกว้าง (~10–80 kΩ)
> ต้องเอาสโคปจับ waveform ที่ TP ตอนกดปุ่ม แล้ววัด τ จริง **ตัวเลขนี้ใส่ lab report ได้**
> ถ้าเด้งยังทะลุมา → เพิ่มดีบาวซ์ในซอฟต์แวร์ 20–50 ms ทับอีกชั้น

> 🔴 **ปุ่ม tact 4 ขา: ต้องเลือกขาที่อยู่คนละฝั่งกัน**
> ปุ่มมีขาลัดกันภายในเป็นคู่ ถ้าเลือกคู่ที่ลัดกันอยู่แล้ว = ปุ่มกดค้างตลอด
> ⚠️ **วัดด้วยมัลติมิเตอร์โหมด continuity ยืนยันก่อนวาง footprint**
> ขาที่ไม่ใช้ 2 ขา → วาง No Connect Flag

### 6.10 🟠 C13 บนราง 3.3 V — 2 ข้อที่ต้องเช็คก่อนสั่ง

**ปัญหาไม่ได้อยู่ที่ตัว C13 แต่อยู่ที่ว่ามันไปแขวนอยู่บนขาออกของ LDO ที่เราไม่ได้ออกแบบเอง**

```
   USB / J8         DevKitC-1 (ของ Espressif)          บอร์ดเรา
      5 V ───────▶ [ LDO ] ──────▶ 3.3 V ──▶ U1.1, U1.2 ──▶ C13 470 µF
                      ▲                                        C4 10 µF
                      │                                        C5 100 nF
                  เราไม่รู้ว่าเป็นเบอร์อะไร
```

#### ข้อ 1 — LDO รับความจุขาออกได้ถึง 470 µF ไหม

LDO ทุกตัวมี**ช่วงค่าความจุขาออกที่ทำให้วงจรป้อนกลับเสถียร** ระบุไว้ใน datasheet
ถ้าเกินช่วง อาการคือ **แรงดันขาออกแกว่งเอง (oscillation)** ซึ่งดูเหมือนสัญญาณรบกวนทั่วไป
ทำให้ ADC อ่านเพี้ยนและ WiFi หลุดเป็นระยะ — **ไล่บั๊กนี้ยากมากเพราะไม่มีอะไรพัง**

`[ขึ้นกับบอร์ด — ต้องเปิดเอกสาร]`
1. เปิด **ESP32-S3-DevKitC-1 User Guide** → หน้า schematic → หาเบอร์ LDO
2. เปิด datasheet ของ LDO ตัวนั้น → หัวข้อ **Output Capacitor** หรือ **Stability**
3. ดูว่า C_out สูงสุดที่ยอมรับได้เท่าไร

#### ข้อ 2 — กระแสไหลย้อนตอนปิดเครื่อง

```
ตอนปิดไฟ ราง 5 V มีโหลดหนัก (พัดลม PMS) → แรงดันตกเร็ว
        ราง 3.3 V มีโหลดเบา + C13 470 µF → แรงดันตกช้ากว่า

         V
         │╲                    ← 5 V ลงเร็ว
      5V ┤ ╲___
         │     ╲___
    3.3V ┤────────╲___         ← 3.3 V ลงช้า
         │    ▲    ╲
         └────┼─────────── t
              │
        ตรงนี้ V_out > V_in
        → กระแสไหลย้อนผ่านตัว LDO
```

LDO ส่วนใหญ่ไม่ได้ออกแบบให้รับกระแสย้อนทาง — datasheet มักมีหัวข้อ **Reverse Current** เตือนไว้

**ทางแก้ราคา ~3 บาท: ใส่ไดโอด Schottky คร่อม LDO**

| | ต่อที่ไหน |
|---|---|
| **แอโนด** | `+3V3` |
| **แคโทด** | `+5V` |

```
        ┌────── D2 (Schottky) ──────┐
        │  แอโนด            แคโทด   │
     +3V3                          +5V
```

- ตอนทำงานปกติ: `V_5V > V_3V3` → ไดโอด**ไบอัสกลับ ไม่นำกระแส** ไม่กวนอะไรเลย
- ตอนปิดเครื่อง: `V_3V3 > V_5V` → ไดโอด**นำกระแส** พากระแสอ้อม LDO ไป ✅

เบอร์ที่ใช้ได้: `SS14` หรือ `B5819W` (SOD-123) · `1N5819` (THT)

#### สรุปทางเลือก

| ทางเลือก | ข้อดี | ข้อเสีย |
|---|---|---|
| **A. เก็บ C13 + เพิ่ม D2 Schottky** ⭐ | ปิดความเสี่ยงทั้งสองข้อ | เพิ่ม 1 ชิ้น ~3 บาท |
| B. ลด C13 เหลือ 100 µF | ประจุสะสมลด 4.7 เท่า · ตัวเล็กลง | `ΔV = 50 mV` แทน 10 mV *(ยังโอเค)* |
| C. เก็บ 470 µF เฉยๆ | ไม่ต้องแก้อะไร | ⚠️ เสี่ยงถ้าไม่ได้เปิด datasheet ยืนยัน |
| D. ตัด C13 ทิ้ง | ง่ายที่สุด | ❌ SD card จะทำแรงดันตก 500 mV |

> 🔑 **ความเห็นเชิงสอน:** เลือก **A** — ราคาถูกกว่าเวลาที่จะเสียไปกับการไล่หา
> สาเหตุว่าทำไม ADC อ่านเพี้ยนเป็นบางครั้ง
> ถ้าเปิด datasheet ของ LDO แล้วพบว่ารับ 470 µF ได้และมีวงจรกันย้อนอยู่แล้ว → เลือก C ได้

---

## 7. ลำดับการสร้าง Schematic

```
ขั้น 1  วาง U1 ก่อน — เป็นศูนย์กลางของทุกอย่าง
ขั้น 2  วางสัญลักษณ์ GND / +3V3 / +5V ให้ครบ
ขั้น 3  วางคอนเนคเตอร์ J1–J8 รอบๆ ตามตำแหน่งที่จะใช้จริงบนบอร์ด
ขั้น 4  วาง R, C, LED, ปุ่ม, Q1, D1, BZ1
ขั้น 5  🔑 ต่อทุกอย่างด้วย net label ไม่ลากสายยาวข้ามหน้าจอ
ขั้น 6  วาง No Connect Flag ที่ขาในหัวข้อ 5.2
ขั้น 7  กรอก Value และ Footprint ให้ครบทุกตัว
ขั้น 8  รัน DRC → เป้าหมาย Error 0
ขั้น 9  Export netlist ตรวจว่าทุกเน็ตมีสมาชิก ≥ 2
```

> 🔑 **กฎเหล็ก: อย่าลากสายยาวข้ามหน้าจอ ใช้ net label ทั้งหมด**
> เส้นยาวจะพันกันโดยไม่ตั้งใจตอนแก้ไข และหาสาเหตุยากมาก

---

## 8. PCB Layout

### 8.1 ข้อกำหนดบอร์ด

| รายการ | ค่า |
|---|---|
| จำนวนชั้น | 2 |
| ความหนา | 1.6 mm |
| ผิวเคลือบ | HASL หรือ ENIG *(ENIG บัดกรีง่ายกว่าเล็กน้อย)* |
| ขนาดโดยประมาณ | 90 × 70 mm ⚠️ ปรับตามขนาด DevKit ที่วัดจริง |
| สีทั่วไป | เขียว *(ถูกที่สุด)* |
| จำนวนสั่ง | **5 แผ่น** — เผื่อบัดกรีพลาด |

### 8.2 กฎการเดินลาย

| รายการ | ค่าที่ใช้ | ขั้นต่ำของโรงงาน |
|---|---|---|
| ลายสัญญาณ | **0.3 mm** | ~0.15 mm |
| ลายไฟ (+5V, +3V3) | **0.8 mm** | |
| ลาย GND | ใช้ copper pour | |
| ระยะห่างลาย | **0.25 mm** | ~0.15 mm |
| via | รู 0.4 mm / แพด 0.8 mm | |
| annular ring แพด THT | **≥ 0.3 mm** | |
| รูของแพด THT | ขนาดขา + 0.25 mm | |

> ใช้ค่ากว้างกว่าขั้นต่ำมากเพราะ **ราคาไม่ต่างกันแต่ลดความเสี่ยงเยอะ**
> ⚠️ ยืนยันกับหน้า capability ของโรงงานที่จะสั่งจริงอีกครั้ง

### 8.3 การวางชิ้นส่วน

```
        ╔═══════════════════════════════════════════╗
        ║  ◎                                     ◎  ║  ◎ = รูยึด M3
        ║   TP6●  TP1●                              ║
        ║   J1 PMS      [ U1 socket 2×22 ]    J3   ║  ขอบบน = เซนเซอร์
        ║   J2 CO        เว้นที่ให้ DevKit      J4   ║  ขอบขวา = I²C
        ║   C1 bulk         ทั้งตัว            J5   ║
        ║                            TP5●  TP2●TP3● ║
        ║   J6 SD    SW1 SW2 SW3  Q1D1   LED×4 BZ1 ║  ขอบล่าง = ผู้ใช้
        ║  ◎  TP4●   R11 R12 R13                 ◎  ║
        ╚═══════════════════════════════════════════╝
```

**กฎการวาง เรียงตามความสำคัญ:**

1. 🔴 **C1 (bulk) วางใกล้ J1 ที่สุด** — กระแสกระชากจากพัดลม PMS มาจากตรงนี้
2. 🔴 **C4, C5 วางชิดขา 1–2 ของ U1** — decoupling ต้องใกล้จุดใช้ไฟ
3. **C6–C9 วางชิดคอนเนคเตอร์ที่มันดูแล** (J3, J4, J5, J6 ตามลำดับ)
4. **C10–C12 วางชิดปุ่มที่มันดูแล**
5. **D1 วางชิด BZ1 และ Q1** — ลูปกระแส flyback ต้องสั้น
6. **LED และปุ่มอยู่ขอบบอร์ด** — ผู้ใช้ต้องเห็นและกดได้
7. **J7 (UART) อยู่ขอบ** — ต้องเสียบสายตอน debug
8. **เว้นพื้นที่เหนือ U1 socket ให้ DevKit ทั้งตัว** รวมส่วนที่ยื่นเกิน
9. รูยึด M3 ที่มุมทั้ง 4 · ห่างขอบ ≥ 5 mm
10. 🆕 **R11–R13 วางชิดปุ่มของมัน** — คู่กับ C10–C12 ที่ดูแลปุ่มเดียวกัน
11. 🆕 **R14, R15 วางชิด J7** — สั้นที่สุดระหว่างคอนเนคเตอร์กับตัวต้านทาน
12. 🆕 **TP ต้องอยู่นอกเงาของ DevKit** 🔴 ถ้าอยู่ใต้ DevKit จะหนีบ probe ไม่ได้เลย

### 8.4 Copper pour

- **ชั้นล่าง: เท GND เต็มแผ่น**
- ชั้นบน: เท GND ในพื้นที่ว่าง
- ใส่ **via เย็บ GND** ระหว่างสองชั้น กระจายทั่วบอร์ด ทุกๆ ~10 mm
- 🔴 **แพด THT ทุกตัวที่ต่อ GND ต้องใช้ thermal relief** ไม่ใช่ solid connection

### 8.5 Silkscreen — บังคับ

| ต้องมี | ตัวอย่าง |
|---|---|
| Designator ทุกตัว | `R5` `C1` `J2` |
| **ค่าของ R และ C ทุกตัว** | `220R` `4K7` `100K` `100nF` `470uF` |
| 🆕 **ชื่อเน็ตข้างทุก test point** | `+5V` `+3V3` `GND` `SDA` `SCL` |
| 🔴 เครื่องหมาย **+** ของ C1 | |
| 🔴 เครื่องหมายแคโทดของ D1 | แถบคาด |
| 🔴 ขั้วของ LED ทุกดวง | สามเหลี่ยม หรือ `+` |
| **สีของ LED** | `G` `Y` `R` `PWR` |
| ชื่อขาของทุกคอนเนคเตอร์ | `5V GND TX RX SET` ที่ J1 |
| 🔴 คำเตือนที่ J2 | `ZE07-CO  5V ONLY` |
| ขา 1 ของทุกคอนเนคเตอร์ | จุดหรือสามเหลี่ยม |
| ชื่อบอร์ด + เวอร์ชัน + วันที่ | `AirGuard-S3 rev1  2026-08` |
| คำเตือนความปลอดภัย | `RESEARCH DEVICE — NOT A CO ALARM` |

### 8.6 Test point — ✅ มีจริงใน schematic แล้ว

| TP | เน็ต | 🔑 วางตรงไหน |
|---|---|---|
| TP1 | `GND` | ใกล้ TP5/TP6 — กราวด์อ้างอิงของราง |
| TP4 | `GND` | **คนละมุมกับ TP1** — เผื่อ probe ตัวที่สอง |
| TP5 | `+3V3` | ใกล้ขา 1–2 ของ U1 |
| TP6 | `+5V` | 🔴 **ใกล้ J1 (PMS) ที่สุด** — จุดที่แรงดันตกมากที่สุด |
| TP2 | `SDA` | ใกล้กลุ่ม J3/J4/J5 |
| TP3 | `SCL` | ใกล้ TP2 — เพื่อหนีบ logic analyzer สองช่องพร้อมกัน |
| 🆕 TP7 | `PMS_TX` | ใกล้ J1 — **จับ frame 32 ไบต์ของ PMS7003 ได้ตรงๆ** |
| 🆕 TP8 | `CO_TX` | ใกล้ J2 — จับ frame 9 ไบต์ของ ZE07-CO |

> ### ✅ 🆕 TP7/TP8 คือของที่ทำให้แล็บง่ายขึ้นจริง
>
> ตอนเซนเซอร์อ่านค่าไม่ได้ คำถามแรกคือ **"เซนเซอร์ไม่ส่ง หรือ ESP32 อ่านผิด"**
> ถ้าไม่มี TP ต้องเดา แต่มี TP แล้วหนีบ logic analyzer ดูได้เลยว่ามีข้อมูลออกมาไหม
>
> ```
> เห็นข้อมูลที่ TP7  →  เซนเซอร์ปกติ   →  ปัญหาอยู่ที่โค้ด / baud rate
> ไม่เห็นอะไรเลย     →  เซนเซอร์ไม่ส่ง  →  ไปดูไฟเลี้ยง / สาย / PMS_SET
> ```
>
> 🔑 **นี่คือการแบ่งครึ่งปัญหาด้วยการวัดครั้งเดียว** — ตรงกับที่วิชา 03603324 ต้องการ
> คือ **หาสาเหตุด้วยการวัด ไม่ใช่เดาแล้วแก้โค้ดไปเรื่อยๆ**

> 🔑 **ตำแหน่งของ TP6 มีผลต่อค่าที่วัดได้** — วัดใกล้แหล่งจ่ายจะเห็นแรงดันตกน้อยกว่าความจริง
> วางไว้ใกล้จุดที่โหลดหนักที่สุด (พัดลม PMS) จึงจะได้ตัวเลขที่ตรงกับที่ ESP32 เจอ
>
> 📌 วาง TP กราวด์ **ห่างจาก TP สัญญาณ ≤ 10 mm** — ถ้าไกลกว่านี้ ลูปกราวด์ของ probe
> จะรับสัญญาณรบกวนเข้ามา ทำให้เห็น ringing ที่ไม่มีอยู่จริงบนสโคป

**สิ่งที่ยังไม่มี TP:** `BUZZ_DRV` → ไม่ต้องเพิ่ม หนีบที่ขาของ BZ1 ได้โดยตรง

---

## 9. 🔴 สิ่งที่สเปกนี้ระบุแทนไม่ได้ — ต้องวัดเอง

| ต้องวัด | เครื่องมือ | ผลถ้าพลาด |
|---|---|---|
| **ระยะห่างสองแถวขาของ DevKitC-1** | เวอร์เนีย | **บอร์ดใช้ไม่ได้ทั้งแผ่น** |
| **จำนวนขาต่อแถว และตำแหน่งขา 1** | นับจากบอร์ดจริง | GPIO สลับกันทั้งแถว |
| **ปุ่ม tact ขาคู่ไหนลัดกันภายใน** | มัลติมิเตอร์ continuity | ปุ่มกดค้างตลอด |
| **จำนวนขาและ pinout ของ adapter PMS7003** | อ่าน silkscreen บน adapter | 5 V เข้าขา TX |
| **ขนาดตัวถังจริงของ C1 470 µF/16 V** | เวอร์เนีย | ลงรูไม่ได้ |
| **ระยะขาของ buzzer ที่ซื้อ** | เวอร์เนีย | ลงรูไม่ได้ *(footprint สั่งไว้ 6.00 mm)* |
| **RGB LED บน DevKit อยู่ GPIO38 หรือ 48** | ดู silkscreen / รัน blink | ชนกับ LED หรือปุ่มของเรา |
| 🆕 **ขั้ว + ของ buzzer อยู่ pin 1 หรือ 2** | ต่อถ่าน 3 V ลองทั้งสองทาง | **buzzer ไม่ดัง** — ดูข้อ 6.7 |
| 🆕 **pin 1 ของ symbol 1N4148W คือแคโทดใช่ไหม** | เปิด symbol ใน EasyEDA | D1 กลับด้าน → **Q1 ไหม้** |
| 🆕 **V_f จริงของ LED ทั้ง 4 สี** | datasheet KENTO KT-0805 | กระแสผิดจากที่คำนวณ ไฟหรี่หรือสว่างเกิน |
| 🆕 **RXD ของ ZE07-CO รับ 3.3 V ได้ไหม** | ZE07-CO manual §Electrical | ถ้าไม่ได้ ต้องเพิ่มตัวแบ่งแรงดัน |

> 🔑 **วิธีตรวจที่ครอบคลุมที่สุด ใช้เวลา 10 นาที:**
> **พิมพ์ PCB layout ขนาด 1:1 ลงกระดาษ แล้ววางชิ้นส่วนจริงทาบทุกตัว**
> จับ footprint ผิดได้เกือบทั้งหมดในครั้งเดียว

---

## 10. Checklist ก่อนสั่งผลิต

**Schematic** — สถานะ ณ netlist 14 ส.ค.
- [x] DRC ผ่าน Error 0
- [x] ทุกเน็ตมีสมาชิก ≥ 2 — **ครบทั้ง 37 เน็ต**
- [x] ขาในหัวข้อ 5.2 ไม่ถูกต่ออะไรเลย
- [x] `D1` มีขาหนึ่งบน `+3V3` อีกขาบน `BUZZ_DRV`
- [x] `J2.1` ต่อ `+5V` ไม่ใช่ `+3V3`
- [x] I²C ทั้ง 3 คอนเนคเตอร์เรียงขาเหมือนกัน
- [x] Value และ Footprint กรอกครบทุกตัว
- [x] R และ C ทั้งหมดเป็น 0805 *(ยกเว้น C1)*
- [ ] 🔴 **ยืนยัน footprint ของ U1 ด้วยเวอร์เนีย** ← ค้างอยู่
- [ ] 🟠 วาง **No Connect Flag** ที่ขาในหัวข้อ 5.2 ทั้ง 9 ขา ← ค้างอยู่
- [ ] 🟠 เปลี่ยน LED1 เป็นเขียวแท้ **+ ลด R5 เหลือ ~47 Ω** ← ค้างอยู่
- [ ] 🟡 ยืนยันขั้ว buzzer และทิศทาง symbol D1 ← ค้างอยู่

**PCB**
- [ ] DRC ผ่านสะอาด
- [ ] ground plane มี thermal relief ที่แพด THT
- [ ] เว้นพื้นที่ให้ DevKit ทั้งตัวรวมส่วนที่ยื่น
- [ ] รูยึด M3 ครบ 4 มุม
- [ ] silkscreen ครบตามหัวข้อ 8.5
- [ ] ตรวจ 3D preview ว่าชิ้นส่วนไม่ชนกัน
- [ ] 🔴 **พิมพ์ 1:1 วางของจริงทาบแล้ว**

**การสั่ง**
- [ ] เลือก **PCB เปล่า ไม่เลือก assembly**
- [ ] จำนวน 5 แผ่น
- [ ] 🔑 **เพื่อนอีก 2 คนช่วย review ก่อนกดสั่ง**

---

## 11. ลำดับบัดกรีหลังบอร์ดมาถึง

```
1. SMD 0805 ทั้งหมด + Q1 + D1     ← ตอนบอร์ดยังเรียบที่สุด ใช้ฟลักซ์เยอะ
2. 🔴 วัด +5V↔GND และ +3V3↔GND    ← ใกล้ 0 Ω = ช็อต หยุดหาสาเหตุก่อน
3. ปุ่ม SW1–SW3
4. คอนเนคเตอร์ J1–J8              ← ใช้เทปกาวยึดก่อนบัดกรีขาแรก
5. LED1–LED4                       ← ⚠️ ตรวจขั้ว ขายาว = บวก
6. 🔑 U1 socket (female header 2 เส้น)
       → เสียบ header ลงรู → **เสียบ DevKit ทับก่อน** → บัดกรีจากด้านล่าง
       → ถอด DevKit ออก แล้วบัดกรีที่เหลือ
       ⚠️ ถ้าบัดกรี header ลอยๆ แล้วเอียง DevKit จะเสียบไม่ลง
7. C1 + BZ1                        ← ⚠️ ตรวจขั้ว C1 และขั้ว BZ1 (ข้อ 6.7)
8. TP1–TP6                         ← 🆕 บัดกรีท้ายสุด ไม่บังทางหัวแร้ง
9. ล้างฟลักซ์ + ส่องแว่นขยายหาสะพานตะกั่ว
10. วัดความต่อเนื่องทุกเน็ตตามหัวข้อ 6
```

**🆕 หลังบัดกรีเสร็จ วัด 5 ค่านี้ก่อนจ่ายไฟ — ใช้มัลติมิเตอร์โหมดวัดความต้านทาน**

| วัดระหว่าง | ค่าที่ควรได้ | ถ้าไม่ตรง |
|---|---|---|
| TP6 (`+5V`) ↔ TP1 (`GND`) | ≫ 1 kΩ | 🔴 **ช็อต — หยุดทันที** |
| TP5 (`+3V3`) ↔ TP1 (`GND`) | ≫ 1 kΩ | 🔴 **ช็อต — หยุดทันที** |
| TP2 (`SDA`) ↔ TP5 (`+3V3`) | ≈ **4.7 kΩ** | R1 ไม่ติด หรือหยิบค่าผิด |
| TP3 (`SCL`) ↔ TP5 (`+3V3`) | ≈ **4.7 kΩ** | R2 ไม่ติด หรือหยิบค่าผิด |
| Q1 gate ↔ TP1 (`GND`) | ≈ **100 kΩ** | R10 ไม่ติด → **buzzer จะดังเองตอนบูต** |

> 🔑 **สองแถวล่างคือการใช้ TP พิสูจน์ว่าตัวต้านทานถูกค่าและบัดกรีติดจริง**
> ตรวจแบบนี้ได้โดยยังไม่ต้องจ่ายไฟเลย — **ตัวเลขชุดนี้ใส่ lab report ได้ตรงๆ**

**ก่อนเสียบไฟครั้งแรก:** วัดว่าไม่ช็อต → จ่ายไฟโดยยังไม่เสียบ DevKit และเซนเซอร์ →
จับดูว่ามีอะไรร้อนผิดปกติ → เสียบ DevKit → **เสียบเซนเซอร์ทีละตัว** ไม่ใช่ทีเดียวหมด

---

## 12. เอกสารอ้างอิง

| เอกสาร | ใช้ดู |
|---|---|
| ESP32-S3-DevKitC-1 User Guide (Espressif) | pinout, ขนาดบอร์ด, RGB LED อยู่ขาไหน |
| ESP32-S3 Series Datasheet | Strapping Pins, Boot Configurations |
| ESP Hardware Design Guidelines (ESP32-S3) | ข้อกำหนดไฟเลี้ยงและ ADC |
| PMS7003 Series Data Manual | pinout, ระดับลอจิก |
| ZE07-CO User's Manual (Winsen) | pinout, แรงดันไฟเลี้ยง, cross-sensitivity |
| ENS160 / BME280 / SCD40 / SSD1306 datasheet | ที่อยู่ I²C |
| หน้า capability ของโรงงาน PCB | ค่าขั้นต่ำของลายและรู |

---

## 13. ⚠️ ข้อความบังคับสำหรับรายงานและตัวเครื่อง

> **อุปกรณ์นี้เป็นเครื่องเฝ้าระวังสภาพแวดล้อมเพื่อการวิจัย ไม่ใช่เครื่องมือแพทย์
> และไม่ใช่เครื่องเตือนภัยคาร์บอนมอนอกไซด์
> ห้ามใช้แทน CO alarm ที่ได้มาตรฐาน UL 2034 หรือ EN 50291**

ผู้ผลิต ZE07-CO ระบุไว้ใน datasheet เองว่า:
*"Please do not use the modules in systems which related to human being's safety."*

---

## 15. 🏭 สถานะหลังสั่ง PCBA — สั่งไปแล้ว 1 ก.ย. 2569

> ⚠️ **เปลี่ยนจากแผนเดิม** — แผนคือสั่ง PCB เปล่าแล้วบัดกรีเองทั้งหมด
> ของจริงคือ **สั่งพร้อมประกอบ SMD** เหลือ THT ให้บัดกรีเอง
> หัวข้อ 11 (ลำดับบัดกรี) ใช้ไม่ได้ทั้งหมดแล้ว ให้ใช้ 15.4 แทน

### 15.1 อะไรโรงงานประกอบให้ · อะไรเราทำเอง

| โรงงานประกอบให้ (SMD) | เราบัดกรีเอง (THT) |
|---|---|
| R1–R15 *(15 ตัว)* | U1 socket · BZ1 · C1 · C13 |
| C2–C12 *(11 ตัว)* | J1 J2 J3 J4 J5 J6 J7 J8 |
| LED1–LED4 | *(TP1–TP8 ไม่ต้องซื้อ เป็นแพดเปล่า)* |
| Q1 · D1 | |
| **SW1–SW3** *(tact SMD)* | |

### 15.2 ✅ ความเสี่ยง 3 ข้อที่หายไปเอง

| เดิมกังวลว่า | ทำไมหายไป |
|---|---|
| **ปุ่ม tact ขาคู่ไหนลัดกันภายใน** | SW1–3 เป็น SMD → เครื่องวางตาม footprint **ไม่ต้องวัดแล้ว** ✅ |
| **ขั้ว LED / ทิศ D1 / ทิศ Q1 ตอนบัดกรี** | เครื่องวางตามไลบรารี **มือเราไม่มีโอกาสวางผิด** ✅ |
| **C13 จะทำ LDO แกว่งไหม** | C13 เป็น THT → **เลือกไม่ใส่ก็ได้** ดู 15.5 ✅ |

> 🔑 **ความเสี่ยงย้ายที่ ไม่ได้หายไป**
> เดิม = "เราบัดกรีถูกไหม" → ตอนนี้ = **"ไลบรารีนิยามขาไว้ถูกไหม"**
> ข้อดีคือถ้าไลบรารีถูก ทุกแผ่นจะถูกเหมือนกันหมด ไม่มีแผ่นไหนพลาด
> ข้อเสียคือถ้าไลบรารีผิด **ผิดเหมือนกันทุกแผ่น**

### 15.3 🔴 ความเสี่ยงที่ตอนนี้ล็อกไปแล้ว — U1 footprint

**เราไม่เคยวัดระยะสองแถวขา DevKit เลย และตอนนี้บอร์ดผลิตไปแล้ว**

แต่ยัง**รู้คำตอบได้วันนี้** ไม่ต้องรอบอร์ดมาถึง:

```
ขั้น 1  เปิดไฟล์ PCB ใน EasyEDA → ใช้เครื่องมือ Measure (หรือคลิกแพดอ่านพิกัด)
        วัดจากกึ่งกลางแพดแถวซ้าย ถึงกึ่งกลางแพดแถวขวาที่อยู่ตรงข้ามกัน
        จดไว้ =  ______ mm

ขั้น 2  เอาเวอร์เนียวัด DevKit ตัวจริง จุดเดียวกัน
        จดไว้ =  ______ mm

ขั้น 3  เทียบสองค่า
        ต่างกัน < 0.3 mm  →  ✅ ผ่าน ขาเสียบลงได้
        ต่างกัน ≥ 0.5 mm  →  🔴 บอร์ดใช้ไม่ได้ ต้องแก้ footprint แล้วสั่งใหม่
```

> 🔑 **ทำวันนี้ ไม่ต้องรอของ** — ถ้าผิด รู้เร็วกว่า 2 สัปดาห์ = สั่งใหม่ทันก่อนเดดไลน์
> ถ้ารอจนของมาถึงแล้วค่อยรู้ จะไม่เหลือเวลาสั่งรอบสอง
>
> `[ต้องไปเช็คเอง]` ค่าอ้างอิงอยู่ใน **ESP32-S3-DevKitC-1 User Guide** หัวข้อ
> Board Dimensions / Physical Dimensions — **ห้ามใช้ตัวเลขจากความจำ**

### 15.4 ลำดับงานหลังบอร์ดมาถึง *(แทนหัวข้อ 11)*

```
ขั้น 0  🔴 ตรวจก่อนแตะหัวแร้ง
        - วัด +5V ↔ GND และ +3V3 ↔ GND ที่ TP6/TP5 เทียบ TP1
          ควรได้ ≫ 1 kΩ · ถ้าใกล้ 0 = โรงงานประกอบพลาด เคลมได้
        - ส่องแว่นขยายดู D1: แถบคาดต้องอยู่ด้าน +3V3
        - วัด TP2↔TP5 และ TP3↔TP5 ควรได้ ~4.7 kΩ (พิสูจน์ว่า R1 R2 ติดจริง)
        - วัด gate ของ Q1 ↔ GND ควรได้ ~100 kΩ (พิสูจน์ R10)

ขั้น 1  บัดกรี U1 socket (female header 2 เส้น)
        🔑 เสียบ DevKit ทับก่อน แล้วค่อยบัดกรีจากด้านล่าง — กันเอียง

ขั้น 2  บัดกรีคอนเนคเตอร์ J1–J8   ← ใช้เทปกาวยึดก่อนลงขาแรก

ขั้น 3  บัดกรี C1  ⚠️ ตรวจขั้ว + ก่อน
        ยังไม่ต้องใส่ C13 — ดู 15.5

ขั้น 4  บัดกรี BZ1  ⚠️ ตรวจขั้วตามวิธีในข้อ 6.7 ก่อน

ขั้น 5  จ่ายไฟโดยยังไม่เสียบ DevKit → จับดูว่ามีอะไรร้อนไหม
ขั้น 6  เสียบ DevKit → เสียบเซนเซอร์ทีละตัว ไม่ใช่ทีเดียวหมด
```

### 15.5 🟠 C13 — ตอนนี้ตัดสินใจทีหลังได้ ไม่ต้องเดา

เพราะเป็น THT บัดกรีเอง เลยกลายเป็น **"ทดลองแล้วค่อยตัดสิน"** ซึ่งดีกว่าเดาล่วงหน้ามาก

```
รอบที่ 1  ไม่ใส่ C13  →  จ่ายไฟ  →  เอาสโคปจับที่ TP5 (+3V3)
          ┌─ สัญญาณนิ่ง ไม่แกว่ง            → LDO เสถียร ไปต่อ
          └─ แกว่งเป็นคลื่นเอง               → LDO มีปัญหาอยู่แล้ว ไม่ใช่เพราะ C13

รอบที่ 2  สั่งเขียน microSD ต่อเนื่อง  →  ดู TP5 ว่าแรงดันตกกี่ mV
          ┌─ ตก < 100 mV                    → ✅ ไม่ต้องใส่ C13 เลย
          └─ ตก > 200 mV                    → ใส่ C13 แล้ววัดซ้ำ

รอบที่ 3  ใส่ C13 แล้ว  →  ดู TP5 อีกครั้ง
          ┌─ นิ่งขึ้น แรงดันตกน้อยลง        → ✅ เก็บไว้
          └─ เริ่มแกว่ง / มี ringing         → 🔴 ถอดออก LDO รับไม่ไหว
```

> 🔑 **นี่คือรูปแบบที่วิชา 03603324 ต้องการเป๊ะ** — ตั้งสมมติฐาน → วัด → เทียบ → สรุป
> ตัวเลข ΔV ทั้งสามรอบใส่ lab report ได้ตรงๆ **มีค่ามากกว่าการใส่ C13 ไปเฉยๆ**
>
> ⚠️ ใส่ไดโอด Schottky กันกระแสย้อนไม่ได้แล้ว เพราะบอร์ดไม่มีรูไว้
> **ทางแก้ถ้าจำเป็นจริง:** บัดกรีคร่อมระหว่างขา C13 กับขา C1 ด้วยสายจัมเปอร์สั้น
> *(ไม่สวยแต่ใช้ได้ ถ้าเลือกไม่ใส่ C13 ก็ไม่ต้องทำเลย)*

### 15.6 🟠 LED1 เขียวอมเหลือง — แก้ด้วยเฟิร์มแวร์ ไม่ต้องแตะฮาร์ดแวร์

LED1 ถูกประกอบเป็น `KT-0805YG` ไปแล้ว สีใกล้ LED2 (เหลือง) เกินไป

| ทางเลือก | ต้นทุน | ผล |
|---|---|---|
| **A. แยกด้วยจังหวะกะพริบ แทนสี** ⭐ | **0 บาท 0 นาที** | แก้ได้ 100% |
| B. ถอด LED1 ออกด้วยลมร้อน ใส่เขียวแท้ + เปลี่ยน R5 เป็น 47 Ω | เสี่ยงทำแพดหลุด | สวยขึ้น |

**ทางเลือก A ทำยังไง**

```
NORMAL  →  ติดค้าง                      (ไม่กะพริบเลย)
WATCH   →  กะพริบช้า  1 ครั้ง/วินาที
ALARM   →  กะพริบเร็ว 5 ครั้ง/วินาที + buzzer
```

> 🔑 **จังหวะแยกออกจากกันชัดกว่าสีเสมอ** โดยเฉพาะกับคนตาบอดสี
> ซึ่งเป็นเรื่องที่ควรคิดอยู่แล้วในอุปกรณ์ที่ทำเพื่อผู้ป่วย
> **เขียนในรายงานได้ว่าเป็นการออกแบบเพื่อการเข้าถึง ไม่ใช่การแก้ขัด**

### 15.7 🛒 ของที่ต้องซื้อแยก

**ชิ้นส่วนบนบอร์ด**

| ต้องซื้อ | จำนวน | หมายเหตุ |
|---|---|---|
| Female header 1×40 2.54 mm | **4–5 เส้น** | ตัดเหลือ 1×22 · เผื่อตัดพลาด |
| Buzzer active 3.3 V ⌀12 mm ระยะขา 6.0 mm | 1 | ⚠️ ระยะขาต้องตรง |
| Electrolytic 470 µF/16 V ⌀5.5 ระยะขา 2.5 mm | 2 | C1 + C13 *(C13 ยังไม่ใส่ก็ได้)* |
| JST **B8B-XH-A** (8P ตัวเมียลงบอร์ด) | 1 | J1 |
| JST **B5B-XH-A** (5P) | 1 | J2 |
| JST **B4B-XH-A** (4P) | 3 | J3 J4 J5 |
| Pin header ตัวผู้ 1×40 2.54 mm | 1 | ตัดใช้กับ J6 (6P) และ J7 (3P) |
| Terminal block KF128 5.08 mm 2P | 1 | J8 |

**สายและโมดูล**

| ต้องซื้อ | จำนวน | หมายเหตุ |
|---|---|---|
| สาย JST-XH 8P / 5P / 4P *(พร้อมหัวคริมป์)* | 1 / 1 / 3 | 🔑 ซื้อแบบสำเร็จ อย่าคริมป์เอง |
| ESP32-S3-DevKitC-1 | 1 | ⚠️ เช็คว่ามีขาตัวผู้บัดกรีมาไหม |
| PMS7003 + adapter | 1 | |
| ZE07-CO | 1 | ⚠️ มาแบบขาเปล่า ต้องบัดกรีสาย JST-XH 5P เอง |
| ENS160+BME280 · SSD1306 · SCD40 | อย่างละ 1 | ⚠️ เช็คลำดับขาว่าตรงกับ VCC-GND-SDA-SCL ไหม |
| microSD module 3.3 V | 1 | |

> ⚠️ **ต้องเช็คลำดับขาของเซนเซอร์ทุกตัวก่อนเสียบ**
> บอร์ดเราวาง J3 J4 J5 เป็น `VCC-GND-SDA-SCL`
> โมดูลที่ขายในตลาดหลายรุ่นเรียง `VCC-GND-SCL-SDA` (สลับสองตัวท้าย)
> ถ้าไม่ตรง **ต้องทำสายไขว้ ไม่ใช่เสียบตรง** — สลับ SDA/SCL ไม่พังแต่จะไม่เจออุปกรณ์

---

## 14. 🔄 บันทึกการเปลี่ยนแปลง

### v1.2 — 1 ก.ย. 2569 · netlist รอบที่สอง

**การเชื่อมต่อ:** ยังตรงกับตารางขาข้อ 5.1 ครบ 28 จุด · ไม่มีขาต้องห้ามถูกใช้ · **ยังเป็น 37 เน็ตเท่าเดิม** ✅

#### 🆕 เพิ่มมา 3 ตัว

| Des | คือ | ตัดสิน |
|---|---|---|
| **TP7** | test point บน `PMS_TX` | ✅ **ดี** — แบ่งครึ่งปัญหาตอนไล่บั๊ก UART |
| **TP8** | test point บน `CO_TX` | ✅ **ดี** — เหตุผลเดียวกัน |
| **C13** | 470 µF บนราง **3.3 V** | 🟠 **มีเหตุผลรองรับ แต่ต้องเช็ค 2 ข้อ** → ข้อ 6.10 |

#### 🔄 เปลี่ยน 1 ตัว

**J2: pin header 1×5 → JST-XH 5P** ✅ **เป็นการแก้ที่ดีมาก**
ย้ายการกันเสียบผิดขั้วจาก "silkscreen เตือน" ไปเป็น "ผิดไม่ได้เชิงกายภาพ"
สำคัญเพราะ J2 คือคอนเนคเตอร์เดียวบนบอร์ดที่ต่อผิดแล้วพังทันที
⚠️ ตามมาด้วย: ต้องซื้อสาย JST-XH 5P มาบัดกรีเข้า ZE07-CO เอง

#### ⚠️ ความไม่ตรงกันใน BOM ที่ต้องแก้ก่อนสั่งของ

| # | อาการ | ผลกระทบ |
|---|---|---|
| 1 | **J2 footprint = JST-XH 5P แต่ Manufacturer Part ยังเป็น `SIP5-2.54mm单排针` (pin header)** | 🟠 **สั่งของผิดตัว** — บอร์ดมีรู JST แต่ของที่มาเป็น pin header · *(ไม่กระทบการสั่ง PCB เปล่า)* |
| 2 | **TP1 กับ TP4 หายจาก BOM** — netlist มี 8 TP แต่ BOM มี 6 | 🟢 ไม่กระทบ — test point คือแพดทองเปิด ไม่ต้องซื้อชิ้นส่วน · แต่ควรเช็คว่ายังอยู่บน canvas |

---

### v1.1 — 14 ส.ค. 2569 · ปรับให้ตรงกับ Schematic3

**สถานะการตรวจ:** เทียบ netlist ทีละบรรทัดกับตารางขาข้อ 5.1 → **ตรงกันครบ 28 จุด ไม่มีขาต้องห้ามถูกใช้** ✅

#### 🆕 อุปกรณ์ที่เพิ่มเข้ามา (11 ตัว) — ทั้งหมดเป็นการเพิ่มที่ดี

| Des | ค่า | เหตุผล |
|---|---|---|
| R11, R12, R13 | 220 Ω | ป้องกันขา GPIO ของปุ่มถ้าเฟิร์มแวร์ตั้งเป็น output โดยพลาด |
| R14, R15 | 1 kΩ | ป้องกันขา console UART จาก adapter 5 V และการ backfeed |
| TP1–TP6 | — | จุดวัดสำหรับแล็บ **ตรงกับที่วิชา 03603324 ต้องใช้** |

#### 🔧 ค่าที่เปลี่ยนจาก v1.0

| Des | v1.0 | v1.1 (จริง) | ตรวจแล้ว |
|---|---|---|---|
| R3 | 499 Ω | **470 Ω** | ✅ ค่ามาตรฐาน E24 หาซื้อง่ายกว่า |
| R5, R6, R7 | 330 Ω | **220 Ω** | ✅ 5.9 mA ปลอดภัย สว่างขึ้น |
| R8 | 1 kΩ *(บน 3.3 V)* | **470 Ω** *(บน **5 V**)* | ✅ 4.3 mA |
| R10 | 10 kΩ | **100 kΩ** | ✅ Vgs สูงขึ้นเป็น 3.27 V |

#### ✏️ ที่ v1.0 เขียนผิดและแก้แล้ว

1. **R8 อยู่บนราง +5 V ไม่ใช่ +3.3 V** — ข้อ 6.1 เคยจัดกลุ่มผิด
2. **BZ1 ต่อ +3V3 ที่ขา 2 ไม่ใช่ขา 1** — ไดอะแกรมข้อ 6.7 เคยสลับเลขขา
3. **R4 ไม่ได้แปลง 3.3 V → 3.0 V** — ตัวต้านทานอนุกรมตัวเดียวไม่ลดแรงดัน
   หน้าที่จริงคือจำกัดกระแสผ่านไดโอดป้องกันภายใน (ดูข้อ 6.3)
4. **จำนวนขาที่ต่อคือ 28 ไม่ใช่ 25** — หัวข้อ 5.1 นับผิดตั้งแต่ v1.0
5. **จำนวนเน็ตคือ 37 ไม่ใช่ 20** — เพราะตัวต้านทานอนุกรมผ่าเน็ตเป็นสองท่อน

#### 🔴 ที่ยังค้าง — ต้องปิดให้ครบก่อนสั่งบอร์ด

| ลำดับ | งาน | เวลา |
|---|---|---|
| 1 | 🔴 **วัดระยะสองแถวขา DevKit ด้วยเวอร์เนีย** ยืนยัน footprint `1U` | 5 นาที |
| 2 | 🟠 วาง **No Connect Flag** 9 ขา (32,33,34,13,14,30,31,29,35) | 10 นาที |
| 3 | 🟠 เปลี่ยน LED1 → เขียวแท้ **พร้อมลด R5 เหลือ ~47 Ω** | 10 นาที |
| 4 | 🟡 ต่อ buzzer กับถ่าน 3 V หาขั้ว + แล้วเทียบกับ pin 1 | 5 นาที |
| 5 | 🟡 เปิด symbol 1N4148W ยืนยันว่า pin 1 = แคโทด | 2 นาที |

> ⚠️ **ข้อ 1 ต้องทำก่อนอย่างอื่นเสมอ** — ถ้าระยะไม่ตรง footprint ต้องเปลี่ยนใหม่
> แล้วงานวาง PCB layout ทั้งหมดต้องเริ่มใหม่
