Sh080205/AirGuard/docs/09-ENCLOSURE-MEASURE.md

# ใบวัดกล่อง AirGuard-S3 — กรอกด้วยมือ

ผู้วัด ____________ วันที่ ________ เวอร์เนียร์ (รุ่น/ความละเอียด/ค่าศูนย์) ____________________

แบบ `hardware/frame/airguard_enclosure.scad` (เลขบรรทัดตาม commit `cb2e19b` · แบบรุ่น 1 และ `fit_*.stl` ลบออกจาก repo แล้ว 4 พ.ย. ดูได้ที่ `a6f6065` · แบบปัจจุบันคือ `hardware/enclosure_v2/` ใบวัด `docs/10-ENCLOSURE-V2-MEASURE.md`) · เฉพาะ `[TODO]`/`ok_*` ของ DevKit · carrier · PMS7003 · ENS160+AHT21 · ZE07-CO · โมดูล microSD — **ไม่มี OLED/SCD40**

- หน่วย mm · วัด 2 ครั้ง ต่างกันเกิน 0.2 mm วัดครั้งที่ 3 ลงหมายเหตุ *(วิธีจดของโครงการ)* · ว่าง = ยังไม่วัด · ไม่มีชิ้นนั้น เขียน "ไม่มี" · **ห้ามคัดค่าจาก SCAD/รูปร่าง**
- ปิดไฟก่อนเอาโลหะแตะบอร์ด · ถ่ายรูปทุกข้อพร้อมลูกศรทิศมอง ตั้งชื่อตามรหัส · ผู้วัดไม่ตั้งธง `ok_*` เอง
- **datum:** มองด้านบน J8/BZ1 อยู่หน้า (ใกล้ตัว) J7/C13 อยู่หลัง → มุมซ้ายหน้า carrier = (0,0) · x ขวา · y หลัง · z ขึ้น · **↑carrier** / **↑DevKit** = จากผิวบน PCB นั้น
- **ลำดับ 1** = บล็อกการพิมพ์กล่อง (ผิดแล้วใส่/เสียบ/ปิดฝาไม่ได้) **วัดให้ครบก่อน** · **2** = ปรับละเอียด · **1†** = รอ `fit_coupon` ที่พิมพ์แล้ว **ทำได้หลังวันอังคาร 13 ต.ค.**
- เครื่องมือ: **V** เวอร์เนียร์ · **D** ก้านวัดลึกของเวอร์เนียร์ · **R** ไม้บรรทัด · **E** ดูด้วยตา + ถ่ายรูป · ①–⑨ = เชิงอรรถท้ายใบ (สำหรับคนแปลงค่าลง CAD)

## ก. ต้องมีของก่อนวัด

- [ ] **สาย micro-USB แบบส่งข้อมูล เส้นที่จะใช้จริง** → A8 *(ยังไม่มี — CLAUDE.md §10)*
- [ ] **โมดูลอ่าน microSD ตัวจริง** ไม่ใช่แค่หัว J6 → E1–E2 *(ยังไม่ทราบว่ามี)* · การ์ด microSD ไว้ลองเสียบผ่านช่อง *(ยังไม่มี)*
- [ ] `fit_coupon` ที่พิมพ์จากเครื่อง/วัสดุเดียวกับกล่องจริง + สกรู M3 เกลียวปล่อย + เคเบิลไทร์ ที่จะใช้จริง → I1–I2 *(coupon ได้หลังวันอังคาร 13 ต.ค.)*
- [ ] ฟองน้ำที่จะใช้ → I3 · สายไฟเข้า J8 ที่จะใช้ → A10b *(แหล่งจ่ายยังไม่สรุป — P2)*
- [ ] DevKit เสียบบน carrier (ไม่จ่ายไฟ) · PMS7003 · ZE07-CO · ENS160+AHT21 ตัวจริง · manual PMS7003 V2.5

## 1. Carrier + DevKit — `ok_devkit_orient:33` `ok_pcb_t:34` `ok_under_leads:35` `ok_heights:472` `ok_openings:473` `ok_lightpipe:476`

| รหัส | ลำดับ | ตัวแปร:บรรทัด | วัดอะไร | อ้างอิง/ทิศมอง | มือ | ค่า 1&nbsp;&nbsp;&nbsp;&nbsp;&nbsp;&nbsp;&nbsp;&nbsp; | ค่า 2&nbsp;&nbsp;&nbsp;&nbsp;&nbsp;&nbsp;&nbsp;&nbsp; | หมายเหตุ&nbsp;&nbsp;&nbsp;&nbsp;&nbsp;&nbsp;&nbsp;&nbsp; |
|---|---|---|---|---|---|---|---|---|
| A13 | 1 | `ok_devkit_orient:33` | เสาอากาศฝั่ง J7 · USB ฝั่ง J8 (ใช่/ไม่) | บน | E |  |  |  |
| A1 | 1 | `pcb_t:68` | ความหนา PCB carrier · เทียบใบสั่ง | ขอบ | V |  |  |  |
| A2 | 1 | `under_lead_max:91` | ขาใต้บอร์ดยาวสุด (หลังตัด) · จดชิ้น | ใต้ carrier | D |  |  |  |
| A3 | 1 | `socket_h:501` | ผิวบนซ็อกเก็ตตัวเมีย ① | ↑carrier | D |  |  |  |
| A4a | 1 | `socket_h:501` | ผิวล่าง PCB DevKit เมื่อเสียบสุด ① | ↑carrier | D |  |  |  |
| A4b | 1 | 1.6 ใน `:518` | ความหนา PCB DevKit ② | ขอบ PCB | V |  |  |  |
| A4c | 1 | `in_h:492` | จุดสูงสุดของ DevKit | ↑carrier | D |  |  |  |
| A5a | 1 | `usb_dz:504` | ขอบล่างปาก USB ② | ↑DevKit | D |  |  |  |
| A5b | 1 | `usb_dz:504` | ขอบบนปาก USB ② | ↑DevKit | D |  |  |  |
| A6a | 1 | `usb_x[0]:503` | กึ่งกลางปาก USB ตัวซ้าย ③ | ขอบซ้าย DevKit | V |  |  |  |
| A6b | 1 | `usb_x[1]:503` | กึ่งกลางปาก USB ตัวขวา ③ | เหมือน A6a | V |  |  |  |
| A7 | 2 | `ok_openings:473` | ปาก USB ยื่น + / หด − จากขอบ DevKit | บน | V |  |  |  |
| A8a | 1 | `usb_cut[0]:505` | หัวสาย USB: กว้าง (ส่วนหุ้ม) | มองเข้าหัว | V |  |  |  |
| A8b | 1 | `usb_cut[1]:505` | หัวสาย USB: สูง (ส่วนหุ้ม) | มองเข้าหัว | V |  |  |  |
| A8c | 2 | `ok_openings:473` | หัวสาย USB: ยาวส่วนแข็ง | ข้างหัว | V |  |  |  |
| A9 | 1 | `in_h:492` | ชิ้นสูงสุด C1/BZ1/J8 · จดชื่อ | ↑carrier | D |  |  |  |
| A12 | 1 | `in_h:492` | หัว JST J1–J6 + สายงอขึ้น | ↑carrier | R |  |  |  |
| A10a | 1 | `j8_dz:507` | กึ่งกลางรูสอดสาย J8 | ↑carrier | D |  |  |  |
| A10b | 1 | `j8_d:508` | Ø นอกสายไฟเข้า J8 ตรงที่ลอดผนัง | — | V |  |  |  |
| A11a | 1 | `sw_h:502` | ปลายปุ่ม SW1 (ไม่กด) | ↑carrier | D |  |  |  |
| A11b | 1 | `sw_h:502` | ปลายปุ่ม SW2 (ไม่กด) | ↑carrier | D |  |  |  |
| A11c | 1 | `sw_h:502` | ปลายปุ่ม SW3 (ไม่กด) | ↑carrier | D |  |  |  |
| K1 | 2 | `ok_lightpipe:476` | ยอด LED สูงสุดใน LED1–4 ④ | ↑carrier | D |  |  |  |

## 2. PMS7003 — `ok_pms_ports:38` `ok_gasket:474` · มองตั้งฉากเข้าหน้าช่องลม ผิวที่วางพื้นอยู่ล่าง ⑤

| รหัส | ลำดับ | ตัวแปร:บรรทัด | วัดอะไร | อ้างอิง/ทิศมอง | มือ | ค่า 1&nbsp;&nbsp;&nbsp;&nbsp;&nbsp;&nbsp;&nbsp;&nbsp; | ค่า 2&nbsp;&nbsp;&nbsp;&nbsp;&nbsp;&nbsp;&nbsp;&nbsp; | หมายเหตุ&nbsp;&nbsp;&nbsp;&nbsp;&nbsp;&nbsp;&nbsp;&nbsp; |
|---|---|---|---|---|---|---|---|---|
| B2 | 1 | `pms_ports_on_long_side:107` | หน้ายาว/สั้น · ช่องไหน inlet | + manual | E |  |  |  |
| B3a | 1 | `pms_inlet_c:111` | inlet: กึ่งกลางตามแนวหน้า | ปลายขวาหน้า | V |  |  |  |
| B3b | 1 | `pms_H/2` `:609` | inlet: กึ่งกลางตามความสูง | ผิวล่างตัวถัง | V |  |  |  |
| B3c | 1 | `pms_open[0]:514` | inlet: กว้าง | มองเข้าช่อง | V |  |  |  |
| B3d | 1 | `pms_open[1]:514` | inlet: สูง | มองเข้าช่อง | V |  |  |  |
| B4a | 1 | `pms_outlet_c:112` | outlet: กึ่งกลางตามแนวหน้า | ปลายขวาหน้า | V |  |  |  |
| B4b | 1 | `pms_H/2` `:609` | outlet: กึ่งกลางตามความสูง | ผิวล่างตัวถัง | V |  |  |  |
| B4c | 1 | `pms_open[0]:514` | outlet: กว้าง | มองเข้าช่อง | V |  |  |  |
| B4d | 1 | `pms_open[1]:514` | outlet: สูง | มองเข้าช่อง | V |  |  |  |
| I3a | 2 | `gasket_t:486` | ฟองน้ำหนา ไม่บีบ | แตะปากเบาๆ | V |  |  |  |
| I3b | 1 | `gasket_t:486` | ฟองน้ำหนา บีบจนไม่รั่ว · จดวิธี | — | V |  |  |  |

## 3. ZE07-CO `ok_ze07_dims:39` · ENS160+AHT21 `ok_bme_dims:40` · microSD `ok_sd_dims:41`

| รหัส | ลำดับ | ตัวแปร:บรรทัด | วัดอะไร | อ้างอิง/ทิศมอง | มือ | ค่า 1&nbsp;&nbsp;&nbsp;&nbsp;&nbsp;&nbsp;&nbsp;&nbsp; | ค่า 2&nbsp;&nbsp;&nbsp;&nbsp;&nbsp;&nbsp;&nbsp;&nbsp; | หมายเหตุ&nbsp;&nbsp;&nbsp;&nbsp;&nbsp;&nbsp;&nbsp;&nbsp; |
|---|---|---|---|---|---|---|---|---|
| C1a | 1 | `ze07_dx:118` | ZE07 ด้านสั้นรวมหัวสาย/ขาที่ยื่น | บน | V |  |  |  |
| C1b | 1 | `ze07_dy:118` | ZE07 ด้านยาวรวมหัวสาย/ขาที่ยื่น | บน | V |  |  |  |
| C1c | 1 | `ze07_H:118` | ZE07 จุดต่ำสุด → ยอดกระบอกเซนเซอร์ | วางโต๊ะ | D |  |  |  |
| C2 | 2 | `ze07_tie_at:120` | ช่วงที่สายรัดพาดได้ (จาก–ถึง) ⑥ | ฝั่งผนังหน้า | V |  |  |  |
| D1a | 1 | `bme_W:123` | ENS160+AHT21 กว้าง (ด้านขนานพื้น) ⑦ | มองหน้าชิป | V |  |  |  |
| D1b | 1 | `bme_L:123` | สูง (ด้านตั้ง) · header อยู่ขอบไหน ⑦ | มองหน้าชิป | V |  |  |  |
| D1c | 1 | `bme_T:123` | ความหนา PCB เปล่า ⑦ | ขอบ PCB | V |  |  |  |
| D2 | 1 | `ok_bme_dims:40` | ชิ้นส่วน/ขา header ยื่นด้านหลังสูงสุด | ผิวหลัง PCB | D |  |  |  |
| E1a | 1 | `sd_dx:130` | microSD: ความยาวขอบที่มีปากช่องการ์ด ⑧ | บน | V |  |  |  |
| E1b | 1 | `sd_dy:130` | microSD: ด้านตั้งฉาก รวม header | บน | V |  |  |  |
| E1c | 1 | `sd_H:130` | microSD: จุดต่ำสุด → ยอดซ็อกเก็ต | วางโต๊ะ | D |  |  |  |
| E2a | 1 | `sd_slot[0]:509` | ขอบซ้ายโมดูล → ขอบซ้ายปากช่อง | มองเข้าปากช่อง | V |  |  |  |
| E2b | 1 | `sd_slot[1]:509` | ความกว้างปากช่อง | มองเข้าปากช่อง | V |  |  |  |
| E2c | 1 | `sd_slot[2]:509` | ผิวที่โมดูลวาง → ขอบบนปากช่อง | มองเข้าปากช่อง | D |  |  |  |

## 4. ทดสอบ `fit_coupon` `ok_print_fit:36` · ค่าจากเอกสาร `ok_ant_keepout:45` `ok_bme_sep:46`

| รหัส | ลำดับ | ตัวแปร:บรรทัด | วัดอะไร | อ้างอิง/ทิศมอง | มือ | ค่า 1&nbsp;&nbsp;&nbsp;&nbsp;&nbsp;&nbsp;&nbsp;&nbsp; | ค่า 2&nbsp;&nbsp;&nbsp;&nbsp;&nbsp;&nbsp;&nbsp;&nbsp; | หมายเหตุ&nbsp;&nbsp;&nbsp;&nbsp;&nbsp;&nbsp;&nbsp;&nbsp; |
|---|---|---|---|---|---|---|---|---|
| I1 | 1† | `m3_tap_d:75` | เลขรูแถวบนที่สกรูกินแน่น ไม่แตก (÷ 10) | coupon บน | สกรู |  |  |  |
| I2a | 1 | `zt_w:76` | ความกว้างเคเบิลไทร์จริง | ตัวสาย | V |  |  |  |
| I2b | 1† | `zt_w:76` | เลขช่องแถวล่างที่ไทร์ลอดพอดี (÷ 10) | coupon ล่าง | ลอง |  |  |  |
| I2c | 1 | `zt_t:77` | ความหนาเคเบิลไทร์จริง ⑨ | ตัวสาย | V |  |  |  |
| K6 | 2 | `ant_keepout_r:145` | รุ่นบนฝาโมดูล → datasheet antenna | บน | E |  |  |  |
| K7 | 2 | `bme_min_sep:127` | ขั้นต่ำ AHT21↔LDO **ไม่มีแหล่ง** | เอกสาร | — |  |  |  |

## ข. คำถามถึงอาจารย์ / ผู้พิมพ์ — `ok_printer:37` `ok_service:477`

| รหัส | ลำดับ | คำถาม | ตัวแปร:บรรทัด | คำตอบ&nbsp;&nbsp;&nbsp;&nbsp;&nbsp;&nbsp;&nbsp;&nbsp;&nbsp;&nbsp;&nbsp;&nbsp;&nbsp;&nbsp;&nbsp;&nbsp;&nbsp;&nbsp;&nbsp;&nbsp;&nbsp;&nbsp;&nbsp;&nbsp; |
|---|---|---|---|---|
| H1 | 1 | เครื่องพิมพ์รุ่นอะไร / ร้านไหน | `ok_printer:37` |  |
| H5 | 1 | พื้นที่พิมพ์สูงสุด X × Y × Z | `bed_x:78` `bed_y:79` |  |
| H3 | 1 | วัสดุ (PLA / PETG / อื่น) · สี | `ok_service:477` |  |
| H2 | 2 | nozzle · ความหนาชั้น | `ok_service:477` |  |
| H4 | 1 | ค่าเผื่อ XY / Z · รู/ร่องเล็กสุดที่พิมพ์ได้ | `fit_clear:74` `ok_service:477` |  |
| H6 | 1 | พิมพ์ fit_coupon / fit_board / fit_pms ก่อนได้ไหม · กี่วัน | `ok_print_fit:36` |  |

**เชิงอรรถ (คนแปลงค่าลง CAD)** — ① `zDK = zTop + socket_h` (:517) ใช้ socket_h เป็นผิวล่าง PCB DevKit แต่คอมเมนต์ :501 ว่าเป็นผิวบนซ็อกเก็ต → สูตรต้องการ A4a; ถ้า A3 ≠ A4a ต้องเลือก datum ใน CAD · ② `usb_dz = (A5a + A5b)/2`; `:518` บวก 1.6 คงที่ → ถ้า A4b ≠ 1.6 ต้องแก้สูตร · ③ `usb_x = 33.911 + A6` (ขอบซ้าย `devkit_rect:62` [DXF]) ใช้ได้เมื่อ A13 = ใช่ และ DevKit ตรงกรอบ silkscreen; มองจากนอกผนังหน้า ซ้ายมือ = −x · ④ `ok_lightpipe` ต้องมีผลพิมพ์ทดสอบท่อแสงจริง K1 เป็นแค่ข้อมูลออกแบบ · ⑤ ปลายขวาของหน้าช่องลม = ฝั่ง −y ตาม `:608–610`; SCAD ใช้ `pms_H/2` และ `pms_open` ขนาดเดียวกับทั้งสองช่อง → B3 ≠ B4 ต้องแยก geometry; `pms_fin_at:108` คำนวณจาก B3a/B4a (กล่องไม่ใช้ เพราะ `pms_fin_len = 0`:109) · ⑥ `ze07_tie_at` = สัดส่วนตามแกน y จากฝั่ง −y → เลือกในช่วง C2 ÷ C1b; ค่าเดิม dx < dy จึงให้ด้านสั้น = dx · ⑦ `bme_L` = แกน z บนเสา; `bme_T` ใช้คำนวณร่องชั้นวาง `shelf_d:176`; header ขอบล่าง/D2 อาจชนชั้นวาง/เสา (`:299–325`) · ⑧ ปากช่องการ์ดหัน −y ตาม `:129`; ผนังตัดจาก `floor_t + 0.5` ถึง `floor_t + sd_slot[2]` (`:597`) · ⑨ ช่อง coupon หนา `zt_t + 0.3` จากค่าเดิม (`:444`) → ถ้า I2c ลอดไม่ได้ต้อง export coupon ใหม่ · `fit_clear` coupon ไม่ได้ทดสอบ → เลือกจาก H4 แล้วยืนยันด้วย fit_pms · **นอกใบนี้:** ไม่ใช้ OLED/SCD40 — `use_oled = use_scd40 = false` · `ok_modules_used = true` (:42, เจ้าของยืนยัน 9 ต.ค.) → assert (:663–665) ไม่ตรวจธง OLED/SCD40 แล้ว
