Sh080205/AirGuard/docs/bringup/2026-10-11.md

# บันทึกค่าวัดกล่อง 3D — 11 ต.ค. 2569

> ใบวัดต้นฉบับ: `docs/09-ENCLOSURE-MEASURE.md` · แบบ: `hardware/frame/airguard_enclosure.scad`
> ⚠️ `hardware/frame/` (แบบรุ่น 1 · `fit_*.stl`) และ `docs/archive/3d.html` ที่อ้างในไฟล์นี้ลบออกจาก repo แล้ว 4 พ.ย. · ดูได้ที่ `a6f6065` · แบบปัจจุบันคือ `hardware/enclosure_v2/`
> คอลัมน์ **CAD ตอนนี้** = ค่าที่อยู่ในไฟล์ SCAD วันนี้ ซึ่งเป็น **ค่าคาดหมาย/ค่าเดา ต้องยืนยันด้วยการวัด** — ไว้เทียบว่าต่างมากไหม 🔴 **ห้ามคัดค่านี้ลงช่องค่าวัด**
> ช่องว่าง = ยังไม่วัด · ไม่มีชิ้นนั้นเขียน "ไม่มี" · หน่วย mm ทั้งหมด
> วัด 2 ครั้ง ต่างกันเกิน 0.2 mm → วัดครั้งที่ 3 ลงหมายเหตุ · **ผู้วัดไม่ตั้งธง `ok_*` เอง**

**ผู้วัด:** ____________ · **สถานที่:** ____________
**เวอร์เนียร์:** รุ่น ____________ ความละเอียด ______ **ค่าศูนย์ที่อ่านได้ตอนปิดปาก** ______
**ของที่ใช้วัดวันนี้:** carrier PCBA · DevKit · PMS7003 · ZE07-CO · ENS160+AHT21 · เคเบิลไทร์
**datum:** มองด้านบน J8/BZ1 อยู่หน้า (ใกล้ตัว) · J7/C13 อยู่หลัง · มุมซ้ายหน้า carrier = (0,0) · `↑carrier` = จากผิวบน PCB carrier · `↑DevKit` = จากผิวบน PCB DevKit

---

## 1. carrier เปล่า (ยังไม่เสียบ DevKit) — 3 ช่อง

| รหัส | วัดอะไร | มือ | CAD ตอนนี้ | ค่า 1 | ค่า 2 | หมายเหตุ |
|---|---|---|---|---|---|---|
| A13 | เสาอากาศ DevKit อยู่ฝั่ง J7 · USB อยู่ฝั่ง J8 (ใช่/ไม่) | ตา | สมมติว่า "ใช่" | **ใช่** | | USB หันไปทาง BZ1 = ขอบหน้าเดียวกับ J8 (ผู้วัดแจ้ง 11 ต.ค.) · ⬜ ยังไม่ระบุว่าตรวจกับแพด pin1/3V3 ด้วยหรือไม่ · ธง `ok_devkit_orient` รอเจ้าของตั้ง |
| A1 | ความหนา PCB carrier (เทียบใบสั่ง JLCPCB) | V | `pcb_t = 1.6` | **1.65** | | +0.05 จาก CAD · อยู่ในพิกัด JLCPCB 1.6 ±10% · ⬜ รอค่าที่ 2 |
| A2 | ขา THT ใต้บอร์ดที่ยื่นยาวสุด (หลังตัด) · จดชื่อชิ้น | D | `under_lead_max = 3.0` | **~4.14** | — | 🔴 **เกินค่า CAD** → `standoff_h` ต้องเป็น 4.14+2.0 = 6.14 (ตอนนี้ 5.0 → เหลือเผื่อ 0.86) · ⚠️ **ค่าประมาณที่ผู้วัดเผื่อสูงไว้ ไม่ใช่ค่าวัดที่ยืนยันแล้ว** (วัดยาก ตำแหน่งเข้าถึงลำบาก) — ยอมรับได้เพราะเผื่อสูง = เสาสูงขึ้น = ผิดทางปลอดภัย · ไม่วัดซ้ำ · ⬜ ยังไม่ทราบชื่อชิ้น · ⬜ ยังไม่ทราบว่าตัดขาแล้วหรือยัง |
| ~~A9?~~ | *(ปิดแล้ว 11 ต.ค.)* ตัวเลขค้าง 17.31 / 20.77 | — | — | — | — | — | **17.31 ≈ 17.16 = ค่าดิบของ A4c** (ยอดโมดูล DevKit → ใต้แผ่น carrier) ต่าง 0.15 = การวัดเดียวกัน · **20.77 − 17.31 = 3.46** ≈ ความยาวขาใต้บอร์ดเมื่อบอร์ดวางบนโต๊ะ → สอดคล้องกับ A2 = 4.14 ที่ผู้วัดเผื่อสูงไว้ ⇒ ยืนยันว่าเผื่อสูงจริง ไม่ได้เผื่อต่ำ |
| X1 | *(นอกใบวัด)* ขอบด้านหน้า BZ1–J8 | V | `pcb_w = 82.126` [DXF] | **82.13** | | ✅ ต่าง 0.004 mm = ต่ำกว่าความละเอียดเวอร์เนียร์ · วัดครั้งเดียว |
| X2 | *(นอกใบวัด)* ขอบหน้า→หลัง BZ1–J7 | V | `pcb_h = 72.921` [DXF] | **72.91** | **72.92** | ✅ ต่างจาก DXF ≤ 0.011 mm · ค่า 2 วัดขอบฝั่งตรงข้าม → ขอบสองด้านขนานกัน บอร์ดไม่เบี้ยว |

> **ผล X1/X2 (11 ต.ค.):** ขอบบอร์ดจริงตรงกับ DXF → `pcb_w` `pcb_h` และตำแหน่งรู M3 จาก DXF ชุดเดียวกันใช้ได้ · ยืนยัน datum ว่า BZ1/J8 = ด้านหน้า (ขอบยาว) · J7 = ด้านหลัง

## 2. carrier + DevKit เสียบสุด (ไม่จ่ายไฟ) — 16 ช่อง

| รหัส | วัดอะไร | อ้างอิง | มือ | CAD ตอนนี้ | ค่า 1 | ค่า 2 | หมายเหตุ |
|---|---|---|---|---|---|---|---|
| A3 | ผิวบนซ็อกเก็ตตัวเมีย | ↑carrier | D | `socket_h = 8.5` | **~8.35** | — | ต่างจาก CAD −0.15 · ผู้วัดแจ้งว่า "ประมาณ" → **ค่าประมาณ ยังไม่ใช่ค่ายืนยัน** · ต้องเทียบกับ A4a เมื่อเสียบ DevKit แล้ว |
| A4a | ผิวล่าง PCB DevKit เมื่อเสียบสุด | ↑carrier | ปากวัดใน | (ใช้ `socket_h` ตัวเดียวกัน) | **11.08** | — | 🔴 **A3 ≠ A4a จริง** ต่าง 2.73 = พลาสติกของ header ตัวผู้ใต้ DevKit (มาตรฐาน 2.54; 8.35+2.54 = 10.89 เทียบ 11.08 ต่าง 0.19 → อธิบายกันได้) · DevKit เสียบสุดแล้ว · ⇒ **CAD ต้องใช้ A4a เป็นฐานของ `zDK` ไม่ใช่ A3** (ตรงกับเชิงอรรถ ① ในใบวัด) · ⬜ ยังไม่ได้ยืนยันด้วยตาว่าเห็นพลาสติกดำคั่นจริง |
| A4b | ความหนา PCB DevKit | ขอบ PCB | V | สูตรบวก 1.6 คงที่ | **1.56** | — | ✅ ต่างจาก 1.6 ที่ฝังในสูตร `usb_zc` แค่ 0.04 ⇒ **ไม่ต้องแก้สูตร** (เชิงอรรถ ② ปลดล็อก) · ผิวบน DevKit = 21.87 + 1.56 = 23.43 เหนือพื้นกล่อง |
| A4c | จุดสูงสุดของ DevKit | ↑carrier | D | `in_h = 38` (พื้น→ใต้ฝา) | **15.51** | — | ชิ้นสูงสุด = **ฝาโลหะโมดูล ESP32-S3-WROOM-1** · วัดดิบ 17.16 จากยอดฝาโลหะถึง**ใต้แผ่น** carrier → หัก A1 1.65 = 15.51 · ตรงกับค่าคาด 15.78 (A4a 11.08 + แผ่น 1.6 + โมดูล 3.1) ต่าง 0.27 ✅ |
| A5a | ขอบล่างปาก USB | ↑DevKit | V | `usb_dz = 1.5` (กึ่งกลาง) | **0.26** | — | ดิบ 1.82 คีบจากใต้แผ่น DevKit ถึงผิวในด้านล่างของปาก − A4b 1.56 · สอดคล้องกับผนังเปลือกโลหะหัว micro-USB (~0.2–0.3) |
| A5b | ขอบบนปาก USB | ↑DevKit | V | — | **2.20** | — | ได้จาก A5a 0.26 + ความสูงช่องที่วัดด้วยปากวัดใน **1.94** ⇒ **`usb_dz` = (0.26+2.20)/2 = 1.23** (CAD 1.5 ต่าง −0.27) · ปากจริงสูง 1.94 เทียบ `usb_cut` ที่เจาะ 8 → ไม่ต้องแก้ขนาดช่อง |
| A6a | กึ่งกลางปาก USB ตัวซ้าย | ขอบซ้าย DevKit | V | `usb_x[0] = 40.1` → A6a = 6.2 | **5.78** | — | ผู้วัดวัดจาก**ขอบขวา**ได้ 19.62 → 25.4 − 19.62 (กว้าง 25.4 ตาม CLAUDE.md §6) · ต่างจาก CAD −0.42 · ⇒ `usb_x[0] = 33.911 + 5.78 = 39.69` |
| A6b | กึ่งกลางปาก USB ตัวขวา | เหมือน A6a | V | `usb_x[1] = 53.1` → A6b = 19.2 | **19.52** | — | ผู้วัดวัดจากขอบขวาได้ 5.88 → 25.4 − 5.88 · ต่างจาก CAD +0.32 · ระยะห่างสองช่อง 13.74 (CAD 13.00) · ⇒ `usb_x[1] = 33.911 + 19.52 = 53.43` · ℹ️ ช่องวางเกือบสมมาตรรอบกึ่งกลางบอร์ด (−6.92/+6.82) ⇒ ต่อให้สลับนิยามซ้าย-ขวา ค่าเพี้ยนแค่ 0.1 mm |
| A7 | ปาก USB ยื่น + / หด − จากขอบ DevKit | บน | V | — | **+0.65** | — | ยื่นออก · ✅ ไม่กระทบแบบ: ผนังหน้าด้านในอยู่ y = −4.3 ขอบปลาย DevKit y = 3.171 → ห่าง 7.47 − 0.65 = **เหลือช่องว่าง 6.8 mm** ให้หัวปลั๊กสอดผ่านผนัง |
| A9 | ชิ้นสูงสุด C1/BZ1/J8 · จดชื่อ | ↑carrier | D | `in_h = 38` | **14.00** | — | **ชิ้นสูงสุด = J8** (ดิบ 15.65) · C1 = 12.64 (ดิบ 14.29) · BZ1 = 9.30 (ดิบ 10.95) — ทุกตัววัดจากยอดชิ้นถึงใต้แผ่น carrier แล้วหัก A1 1.65 · ยังเตี้ยกว่าโมดูล DevKit (A4c 15.51) ⇒ **ตัวกำหนดความสูงกล่องคือ DevKit ไม่ใช่ชิ้นบน carrier** |
| A12 | หัว JST J1–J6 **+ สายที่งอขึ้น** | ↑carrier | R | `in_h = 38` | **9.60** | — | วัดดิบ 11.25 จากยอดพลาสติกหัว **ตัวผู้** ถึงใต้แผ่น carrier − A1 1.65 · สูงกว่า JST XH มาตรฐาน (~6) ⇒ เป็นหัวรุ่นอื่น · 🔴 **วัดตอนยังไม่เสียบสาย — ต้องวัดซ้ำเมื่อต่อสายครบ (ขั้น H3)** เพราะส่วนที่จะชนฝาคือสายที่งอขึ้น ไม่ใช่ตัวหัว |
| A10a | กึ่งกลางรูสอดสาย J8 | ↑carrier | D | `j8_dz = 4` | **3.94** | — | คำนวณจาก: ขอบล่างรูวัดดิบ 3.89 ถึงใต้แผ่น − A1 1.65 = 2.24 เหนือผิวบน carrier; + ครึ่งหนึ่งของขนาดปากรู 3.39/2 = **3.94** · ✅ **ตรงกับ CAD (4) ต่าง 0.06 ไม่ต้องแก้แบบ** |
| X3 | *(นอกใบวัด)* ขนาดปากรูสอดสายของ J8 | มองเข้าปากรู | V | — | **3.39** | — | จำกัดขนาดสายไฟเลี้ยงที่ใช้ได้ (ตัวนำต้องเล็กกว่านี้พอควรเพื่อให้ขันหนีบอยู่) · เกี่ยวกับ A10b ที่ยังค้างเพราะยังไม่สรุปแหล่งจ่าย (P2) |
| A11a | ปลายปุ่ม SW1 (ไม่กด) | ↑carrier | D | `sw_h = 2.8` | **1.35** | — | **1.35** เหนือผิวบอร์ด (ดิบ 3.0 ถึงใต้แผ่น carrier − A1 1.65) · ขณะกดได้ 1.24 ⇒ ระยะกด 0.11 mm = ค่าปกติของ tact switch → สองค่าสอดคล้องกัน · เตี้ยกว่า CAD (2.8) 1.45 แต่ `plunger` คำนวณอัตโนมัติ (`:633`) → 28.10 → 28.36 เปลี่ยน 0.26 mm **ไม่กระทบการพิมพ์** ช่องว่าง 0.5 mm ใต้ลิ้นกดยังเท่าเดิม |
| A11b | ปลายปุ่ม SW2 (ไม่กด) | ↑carrier | D | `sw_h = 2.8` | **1.35** | — | เท่ากับ SW1 |
| A11c | ปลายปุ่ม SW3 (ไม่กด) | ↑carrier | D | `sw_h = 2.8` | **1.35** | — | เท่ากับ SW1 · **ทั้งสามปุ่มสูงเท่ากันเป๊ะทั้งตอนกดและไม่กด ⇒ บัดกรีนั่งเรียบเสมอกัน** |
| K1 | ยอด LED สูงสุดใน LED1–4 | ↑carrier | V | — | **0.76** | — | ดิบ 2.41 คีบจากยอด LED ถึงใต้แผ่น carrier − A1 1.65 · ตรงกับ LED SMD 0805 มาตรฐาน (~0.8) · ⚠️ `ok_lightpipe` ยังต้องรอผลพิมพ์ทดสอบท่อแสงจริง (เชิงอรรถ ④) |

> **ความสูงสะสม ณ 11 ต.ค.** *(ค่าวัดบางตัวยังเป็นค่าประมาณ)* — `plate_t 3.00 + standoff 6.14 (A2) + pcb_t 1.65 (A1) + 11.08 (A4a)` = ผิวล่าง DevKit ที่ **21.87** เทียบ CAD เดิม 18.10 → **สูงขึ้น 3.77 mm** ⇒ ผิวล่าง DevKit เลื่อนขึ้น 3.77 · **กึ่งกลางรู USB เลื่อนขึ้น 3.46** (21.20 → 24.66 เมื่อรวม A4b 1.56 และ usb_dz 1.23) · A3 (8.35) ไม่ใช้เป็นฐาน เพราะมีพลาสติก header คั่น · **ชิ้นสูงสุด = โมดูล DevKit (A4c 15.51)** > J8 14.00 (A9) > C1 12.64 > หัว JST 9.60 (A12) > BZ1 9.30 ⇒ ยอดสูงสุดเหนือพื้นกล่อง = 7.79 + 15.51 = **23.30** เทียบ `in_h = 38` → เหลือ **14.70 mm** ✅ ฝาไม่ชน · ⬜ ค้าง: วัด A12 ซ้ำเมื่อเสียบสายครบ (สายต้องอยู่ใต้ 14.70)

## 3. PMS7003 — 9 ช่อง · มองตั้งฉากเข้าหน้าช่องลม ผิวที่วางพื้นอยู่ล่าง

| รหัส | วัดอะไร | อ้างอิง | มือ | CAD ตอนนี้ | ค่า 1 | ค่า 2 | หมายเหตุ |
|---|---|---|---|---|---|---|---|
| B2 | หน้ายาว/สั้น · ช่องไหน inlet | ตา | E | `pms_ports_on_long_side = true` | **หน้ายาว ✅** | — | ยืนยันด้วยตาว่าช่องลมทั้งสองอยู่บนหน้ายาว → ค่า CAD ถูก · **ช่องซ้าย = ช่องใหญ่ · ช่องขวา = ช่องเล็ก** · 🔴 **ยังไม่ทราบว่าช่องไหน inlet/outlet** `TODO [ต้องเปิด datasheet]` PMS7003 manual V2.5 — สลับแล้วกล่องดูดอากาศผิดทาง ค่าฝุ่นเพี้ยนโดยไม่มีอะไรฟ้อง |
| X4 | *(นอกใบวัด)* ตัวถัง PMS7003: ยาว × กว้าง × หนา | บน/ขอบ | V | `pms_L/W/H = 48 / 37 / 12` [MANUAL] | **47.90 / 36.92 / 12** | **47.94** (ด้านยาว ค่าที่ 2) | ✅ ตรงกับ manual ทั้งสามมิติ (ต่างสูงสุด 0.08) ⇒ **ช่องวาง PMS ในกล่องไม่ต้องแก้** · ที่ต้องแก้คือตำแหน่ง/ขนาดช่องลมบนผนังเท่านั้น |
| B3a | **ช่องซ้าย (ใหญ่)**: กึ่งกลางตามแนวหน้า | ปลายขวา | V | `pms_inlet_c = 12` | **36.06** จากปลายขวา | — | = 30.75 (ปลายขวา→ขอบขวาช่อง) + 10.61/2 · = 11.84 จากปลายซ้าย ≈ ค่า CAD 12 ✅ |
| B3b | **ช่องซ้าย (ใหญ่)**: กึ่งกลางตามความสูง | ผิวล่างตัวถัง | V | `pms_H/2` = 6 | **3.51** | — | 🔴 = 1.50 (ผิวล่าง→ขอบล่างช่อง) + 4.02/2 · **ช่องไม่ได้อยู่กึ่งกลางความสูง** ต่างจากที่ CAD สมมติ 2.49 ⇒ ถ้าเจาะตามแบบเดิม (ช่วง 2–10) ขอบล่างช่องลม (1.50) จะถูกผนังบัง 0.5 mm |
| B3c | **ช่องซ้าย (ใหญ่)**: กว้าง | มองเข้าช่อง | V | `pms_open[0] = 10` | **10.61** | — | กว้างกว่าที่เจาะไว้ 0.61 → ต้องขยาย |
| B3d | **ช่องซ้าย (ใหญ่)**: สูง | มองเข้าช่อง | V | `pms_open[1] = 8` | **4.02** | — | เตี้ยกว่าที่เจาะไว้ (8) → ช่องที่เจาะใหญ่พอ แต่ตำแหน่งต้องเลื่อนลงตาม B3b |
| B4a | **ช่องขวา (เล็ก)**: กึ่งกลางตามแนวหน้า | ปลายขวา | V | `pms_outlet_c = 36` | **9.68** จากปลายขวา | — | = 4.81 + 9.74/2 · เทียบ CAD (ช่องที่สองควรอยู่ 12 จากปลาย) → **คลาด ~2.3 mm ต้องแก้** · ระยะระหว่างสองช่อง 26.38 (CAD 24) |
| B4b | **ช่องขวา (เล็ก)**: กึ่งกลางตามความสูง | ผิวล่างตัวถัง | V | `pms_H/2` = 6 | **2.15** | — | 🔴 = 1.18 + 1.94/2 · **ต่างจากช่องใหญ่ (3.51) ด้วย** ⇒ สองช่องอยู่คนละความสูง ต้องแยก geometry |
| B4c | **ช่องขวา (เล็ก)**: กว้าง | มองเข้าช่อง | V | ใช้ `pms_open` ร่วมกับ inlet | **9.74** | — | 🔴 ≠ ช่องใหญ่ (10.61) |
| B4d | **ช่องขวา (เล็ก)**: สูง | มองเข้าช่อง | V | ใช้ `pms_open` ร่วมกับ inlet | **1.94** | — | 🔴 ≠ ช่องใหญ่ (4.02) · ยืนยันด้วยรูปถ่าย 11 ต.ค. ว่าร่องขวาแบนกว่าช่องซ้ายจริง (ไม่ใช่ตัวเลขสลับกับปาก USB) |

> **สรุป PMS7003 (11 ต.ค.) — แบบต้องแก้ 3 เรื่อง**
> | | ช่องใหญ่ (ซ้าย) | ช่องเล็ก (ขวา) | CAD ตอนนี้ |
> |---|---|---|---|
> | กึ่งกลางจากปลายขวา | 36.06 | 9.68 | 36 / 12 |
> | กึ่งกลางความสูง | 3.51 | 2.15 | 6 ทั้งคู่ |
> | ขนาดช่อง | 10.61 × 4.02 | 9.74 × 1.94 | 10 × 8 ทั้งคู่ |
>
> ⇒ (1) ช่องเล็กคลาดตำแหน่ง ~2.3 mm (2) ทั้งสองช่องอยู่ต่ำกว่าที่สมมติ และ**อยู่คนละความสูง** (3) ขนาดสองช่องไม่เท่ากัน ⇒ **ต้องแยก geometry เป็นสองช่องอิสระ** (เชิงอรรถ ⑤) · ผิดแล้วผนังบังปากทางลม กระทบค่าฝุ่นที่อ่านได้โดยตรง
> 📷 รูปถ่ายหน้าช่องลม 11 ต.ค.: เห็นช่องสี่เหลี่ยมเล็กๆ ที่ปลายทั้งสองข้างของหน้านี้ (ไม่อยู่ในใบวัด) — ต้องดูตอนประกอบว่าฟองน้ำกดทับแล้วรั่วข้างๆ ไหม

## 4. ZE07-CO — 4 ช่อง

| รหัส | วัดอะไร | อ้างอิง | มือ | CAD ตอนนี้ | ค่า 1 | ค่า 2 | หมายเหตุ |
|---|---|---|---|---|---|---|---|
| C1a | ด้านสั้นรวมหัวสาย/ขาที่ยื่น | บน | V | `ze07_dx = 22` | **22.32** | — | ✅ ตรงกับค่า CAD (ซึ่งเดามาจาก `3d.html` ไม่มีแหล่งอ้างอิง) |
| C1b | ด้านยาวรวมหัวสาย/ขาที่ยื่น | บน | V | `ze07_dy = 32` | **25.44** | — | 🔴 สั้นกว่าค่า CAD 6.56 → ช่องวางในกล่องจองที่ยาวเกิน ต้องแก้ |
| C1c | จุดต่ำสุด → ยอดกระบอกเซนเซอร์ | วางโต๊ะ | D | `ze07_H = 15` | **24.37** | — | 🔴 สูงกว่าค่า CAD 9.37 (รวมขาที่ยื่นใต้บอร์ด) · **กลายเป็นชิ้นที่สูงที่สุดในกล่อง** แซง DevKit (23.30) · ยังไม่ชนฝา: `in_h = 38` เหลือ 13.6 · ⬜ ยังไม่ได้วัดความยาวขาที่ยื่นใต้ PCB (ไว้ตัดสินว่าต้องเจาะหลบขา/ทำแท่นรอง) |
| C2 | ช่วงที่สายรัดพาดได้ | ฝั่งผนังหน้า | V | `ze07_tie_at = 0.25` | **ว่างซ้าย 2.86 · ว่างขวา 2.53** | — | จาก: ขอบซ้ายบอร์ด→ขอบขวากระบอก 22.91 · ขอบขวาบอร์ด→ขอบซ้ายกระบอก 22.58 · บอร์ดยาว 25.44 ⇒ **กระบอก Ø 20.05** กินช่วง 2.86–22.91 · 🔴 **CAD ตั้งไทร์กว้าง 3.0 ซึ่งกว้างกว่าช่องว่างทั้งสองข้าง** ⇒ รอวัด I2a (ความกว้างไทร์จริง): ≤2.5 รัดได้สองข้าง · 2.5–2.85 ได้เฉพาะซ้าย · ≥2.9 ต้องเปลี่ยนวิธียึด (รัดรอบกระบอก/แท่นหนีบ) |
| X6 | *(นอกใบวัด)* ขาพินที่ยื่นใต้บอร์ด ZE07 + ความหนา PCB | ผิวบนบอร์ด → ปลายขา | V | — | **ขายื่น 5.96** | PCB **1.70** | ดิบ 7.66 − 1.70 · **ขาชี้ลงด้านตรงข้ามกับกระบอก** = โจทย์เดียวกับ microSD · ✅ ความสูงรวมแตกครบ: ขา 5.96 + บอร์ด 1.70 + กระบอก 16.71 = **24.37** ตรงกับ C1c พอดี · 🔧 **ทางเลือก:** ยกบนเสา 15–20 ❌ ชนฝา (กระบอกจะสูง ~40 เกิน `in_h` 38) · ✅ **ตัดสินแล้ว 11 ต.ค.: ตัดขาแล้วบัดกรีสายตรง** ⇒ ความสูงรวม = 1.70 (PCB) + 16.71 (กระบอก) = **18.41** (เดิม 24.37) → ZE07 เลิกเป็นชิ้นสูงสุด กลับไปเป็น DevKit 23.30 · ⚠️ ผลพ่วง: (1) สายบัดกรีตรงไม่มีหัวพลาสติกรับแรง → **ต้องรัดไทร์/กาวร้อนใกล้จุดบัดกรี** ⇒ C2 ยังจำเป็น (2) **ถอดเปลี่ยนโมดูลทีหลังไม่ได้** — เป็นข้อแลกเปลี่ยนที่เลือกโดยตั้งใจ ให้เขียนในรายงาน · ⬜ ยังไม่ทราบว่าจะตัดขาเรียบติดบอร์ดหรือเหลือตอ 1–2 mm (กระทบความสูงตามนั้น) |

## 5. ENS160 + AHT21 — 4 ช่อง

| รหัส | วัดอะไร | อ้างอิง | มือ | CAD ตอนนี้ | ค่า 1 | ค่า 2 | หมายเหตุ |
|---|---|---|---|---|---|---|---|
| D1a | กว้าง (ด้านขนานพื้น) | มองหน้าชิป | V | `bme_W = 20` | **24.14** | — | ✅ **ตัดสินแล้ว 11 ต.ค. — ติดแบบ ก: แถวพินอยู่ขอบล่าง** ⇒ ด้านที่มีแถวพิน (24.14) = แกน x · ต่างจาก CAD +4.14 |
| D1b | สูง (ด้านตั้ง) · header อยู่ขอบไหน | มองหน้าชิป | V | `bme_L = 26` | **19.38** | — | แถวพิน 8 ขา (`VIN 3V3 GND SCL SDA ADD CS INT`) อยู่**ขอบล่าง** · ต่างจาก CAD −6.62 · 🔑 **เหตุผลที่เลือกแบบ ก:** ในแบบ ก เซนเซอร์สองตัวเรียงกันแนวนอน (AHT21 กลางบน · ENS160 ขวาบน) ไอร้อนจากฮีตเตอร์ของ ENS160 ลอยขึ้นแยกกัน · ถ้าหมุนเป็นแบบ ข ตัวหนึ่งจะอยู่เหนืออีกตัว → AHT21 นั่งในไอร้อน → `temp_c`/`humidity_pct` เพี้ยนแบบเงียบๆ ซึ่งเป็น 2 ใน 3 ฟีเจอร์ของชุด pm_th · รองลงมา: สายออกด้านล่าง ห้อยลงหาบอร์ดหลักตรงๆ ไม่ต้องดัดอ้อม |
| D1c | ความหนา PCB เปล่า | ขอบ PCB | V | `bme_T = 1.6` | **1.57** | — | ✅ ตรงกับ CAD |
| D2 | ชิ้นส่วน/ขา header ยื่นด้านหลังสูงสุด | ผิวหลัง PCB | D | — | **8.54** | — | 🔴 **ขาพินอยู่ด้านตรงข้ามกับชิป** (ผู้วัดยืนยัน) ยื่นหลังบอร์ด 8.54 (ดิบ 10.11 จากปลายขาถึงผิวหน้า − D1c 1.57) · เสาตั้งหนา `mast_t = 2.4` ⇒ **ขาทะลุเสาแล้วเหลืออีก ~6 mm** · **แก้ด้วยการเจาะช่องบนเสาให้แถวพินลอด** (ยาว ~25 กว้าง ~3) ได้ผลพลอยได้คือสายซ่อนหลังเสา · ✅ ตัดสินแล้ว: ติดแบบ ก ⇒ **เจาะช่องแนวนอนที่ขอบล่างของเสา** ยาว ~26 × กว้าง ~3.2 ทะลุเสา · ⬜ ยังไม่มีข้อมูลรูยึดบนโมดูล (จำนวน/ขนาด/ตำแหน่ง) — ถ้ามี 2 รูจะขันสกรูยึดกับเสาได้ มั่นคงกว่าพึ่งช่องอย่างเดียว |

## 5ก. โมดูล microSD — ⛔ ใบวัดเดิมจัดไว้ในกองที่ทำไม่ได้ แต่ 11 ต.ค. ยืนยันว่ามีของจริง (เห็นในรูปถ่าย)

| รหัส | วัดอะไร | อ้างอิง | มือ | CAD ตอนนี้ | ค่า 1 | ค่า 2 | หมายเหตุ |
|---|---|---|---|---|---|---|---|
| E1a | ความยาวขอบที่มีปากช่องการ์ด | บน | V | `sd_dx = 20` | **17.83** | — | เล็กกว่า CAD 2.17 |
| E1b | ด้านตั้งฉาก รวม header | บน | V | `sd_dy = 24` | **17.71 (ขอบ PCB)** | **20.21 รวมส่วนยื่น** | ซ็อกเก็ตยื่นพ้นขอบ PCB **2.5 mm** (ผู้วัดแจ้ง 11 ต.ค.) · ⬜ ยังรอยืนยันว่า 17.71 เป็นขอบ PCB ถึงขอบ PCB · **ช่องวางในกล่องใช้ค่ารวม 20.21 · ตำแหน่งเสารอง/รูยึดใช้ขอบ PCB 17.71** · 💡 ส่วนยื่น 2.5 ช่วยให้หน้าปากซ็อกเก็ตชิดผนังด้านใน → การ์ดที่สอดผ่านรูผนังไม่ลอยอิสระจนมุดใต้/เหนือซ็อกเก็ต (เป้า: ห่างผนังด้านใน ≤ ~1 mm) |
| E1c | จุดต่ำสุด → ยอดซ็อกเก็ต | วางโต๊ะ | D | `sd_H = 4` | **3.61** | — | วัดจากยอดซ็อกเก็ตถึงผิวล่างบอร์ด · ⚠️ ไม่รวมขาพิน (ดูแถว X5) |
| E2a | ขอบซ้ายโมดูล → ขอบซ้ายปากช่อง | มองเข้าปากช่อง | V | `sd_slot[0] = 3` | **2.10** | — | = 17.83 − 15.73 |
| E2b | ความกว้างปากช่อง | มองเข้าปากช่อง | V | `sd_slot[1] = 14` | **13.67** | — | จาก 15.77 (ขอบซ้าย→ขอบขวาปาก) − 2.10 · ✅ ตรวจแล้ว 2.10 + 13.67 + 2.06 = 17.83 พอดี |
| E2c | ผิวที่โมดูลวาง → ขอบบนปากช่อง | มองเข้าปากช่อง | D | `sd_slot[2] = 6` | **~2.73** | — | ผู้วัดแจ้งว่า "ประมาณ" · ช่องที่เจาะตามแบบเดิมสูงเกินจำเป็น 3.3 · 💡 **ถ้าเจาะพอดีปากซ็อกเก็ตจะดึงการ์ดออกยาก** — ควรทำรอยบากครึ่งวงกลมหรือเผื่อความกว้างอีก 4–5 mm เฉพาะส่วนบน ให้นิ้วจับได้ |
| X5 | *(นอกใบวัด)* ขาพิน header + ความหนา PCB ของโมดูล microSD | — | V | — | **ขายื่นใต้บอร์ด 8.24** | PCB **1.54** | 🔴 ดิบ 9.78 จากปลายขาถึงผิวบนบอร์ด − PCB 1.54 · **ขาชี้ลงด้านตรงข้ามกับซ็อกเก็ต** ⇒ วางราบกับพื้นกล่องไม่ได้ และหัวต่อ dupont กินที่ใต้บอร์ดอีก ~14 → เป็นที่มาของข้อตัดสินใจสลับหัว header ด้านล่าง |

> 🔧 **ข้อตัดสินใจของเจ้าของโปรเจกต์ 11 ต.ค. — งานค้าง:** เลือก **ทาง 2 = ถอด header ออกแล้วบัดกรีกลับด้านให้ขาชี้ขึ้น** (เจ้าของแจ้งว่าจะทำทีหลัง)
> เหตุผล: โมดูลนอนราบกับพื้นได้ · ปากช่องการ์ดอยู่ระดับต่ำตามที่แบบออกแบบไว้ (`sd_slot` อ้างจาก `floor_t + 0.5`) · สายออกด้านบนเก็บง่ายกว่า
> ผลหลังแก้: ขา ~8.5 เหนือบอร์ด + หัวต่อ ~14 = ราว 24 เหนือพื้นกล่อง ยังต่ำกว่า `in_h = 38` ✅
> วิธีถอดที่เสี่ยงแพดหลุดน้อยที่สุด: งัดแถบพลาสติกออกก่อน → ดึงขาทีละเส้นขณะจี้หัวแร้ง → ดูดตะกั่วให้รูโล่ง → ใส่ header ใหม่กลับด้าน · ต้องมี header 8 ขาสำรอง 1 ตัว
> ⚠️ **ค่า E1a–E2c ข้างบนวัดจากโมดูลสภาพก่อนแก้** — หลังสลับหัวแล้ว E1a/E1b/E2a–c ไม่เปลี่ยน แต่ **E1c เปลี่ยนเป็น ~10 (ขาชี้ขึ้น)** ต้องวัดซ้ำ

## 6. เคเบิลไทร์ — 2 ช่อง

| รหัส | วัดอะไร | มือ | CAD ตอนนี้ | ค่า 1 | ค่า 2 | หมายเหตุ |
|---|---|---|---|---|---|---|
| I2a | ความกว้างเคเบิลไทร์จริง | V | `zt_w = 3.0` | — | — | ⛔ **ยังไม่มีเคเบิลไทร์** (11 ต.ค.) → ย้ายไปกองของที่ต้องมีก่อน · **ตัวตัดสิน C2** |
| I2c | ความหนาเคเบิลไทร์จริง | V | `zt_t = 1.6` | — | — | ⛔ ยังไม่มีเคเบิลไทร์ (11 ต.ค.) |

---

## 7. ยังวัดไม่ได้วันนี้ (ติดของ)

| รหัส | ติดอะไร |
|---|---|
| A8a · A8b · A8c | ไม่มีสาย micro-USB แบบส่งข้อมูลเส้นที่จะใช้จริง |
| E1a–c · E2a–c | ยังไม่ทราบว่ามีโมดูลอ่าน microSD ตัวจริง (หรือมีแค่หัว J6) |
| I1 · I2b | รอ `fit_coupon` ที่พิมพ์จากเครื่อง/วัสดุเดียวกับกล่องจริง — ได้หลัง 13 ต.ค. |
| I3a · I3b | ยังไม่มีฟองน้ำตัวที่จะใช้จริง |
| A10b | ยังไม่สรุปแหล่งจ่าย (ปัญหาค้าง P2) → ไม่รู้ว่าสายเข้า J8 เส้นไหน |
| K6 · K7 | ค่าจากเอกสาร ไม่ใช่การวัด (`ok_ant_keepout` รอ WROOM-1 datasheet · `bme_min_sep` ยังไม่มีแหล่ง) |

## 8. คำถามถึงอาจารย์/ผู้พิมพ์ (ถามวันนี้ได้ ไม่ต้องรอวัดเสร็จ)

| รหัส | คำถาม | คำตอบ |
|---|---|---|
| H1 | เครื่องพิมพ์รุ่นอะไร / ร้านไหน | |
| H5 | พื้นที่พิมพ์สูงสุด X × Y × Z (CAD สมมติ `bed = 220 × 220`) | |
| H3 | วัสดุ (PLA / PETG / อื่น) · สี | |
| H2 | nozzle · ความหนาชั้น | |
| H4 | ค่าเผื่อ XY / Z · รู-ร่องเล็กสุดที่พิมพ์ได้ (CAD สมมติ `fit_clear = 0.3`) | |
| H6 | ขอพิมพ์ `fit_coupon.stl` / `fit_board.stl` / `fit_pms.stl` ก่อนได้ไหม · กี่วัน | |

## 8ก. ผลตรวจใน OpenSCAD — 11 ต.ค. 2569

แก้ `hardware/frame/airguard_enclosure.scad` ตามค่าวัดแล้ว (ยังไม่ commit) · เปิดด้วย **OpenSCAD 2021.01** กด F5

| ตรวจอะไร | ผล |
|---|---|
| ไฟล์ parse + สร้างรูปทรง | ✅ ไม่มี error · Error-Log ว่าง · `Compile and preview finished` ~3.9 s |
| ทิศช่องลม PMS (เล็ก/ใหญ่) | ✅ **ช่องเล็กอยู่ใกล้ผนังหน้า** ตรงกับที่ตีความว่า "ปลายขวา" ที่ผู้วัดใช้ = ฝั่ง −y ของแบบ ⇒ ตาราง `pms_ports` ไม่ต้องสลับ |
| ช่องลมชิดพื้นกล่อง | ✅ อยู่ติดขอบล่างตามค่าวัด (กึ่งกลาง 2.15 / 3.51 จากผิวล่างตัวถัง) |
| `ENCLOSURE TODO` ใน console | ✅ ขึ้นตามคาด = ธง `ok_*` ยังเป็น false ทั้งหมด → assert ยังบล็อกการสั่งพิมพ์ (ถูกต้อง) |

⬜ ยังไม่ได้ตรวจด้วยสายตา: ตำแหน่งรู USB เทียบ DevKit · ช่องแถวพินบนเสา ENS160 · รอยบากนิ้วจับการ์ด
⬜ ยังไม่ได้ render (F6) และยังไม่ได้ export STL

## 9. รูปถ่าย

ตั้งชื่อตามรหัส พร้อมลูกศรทิศมอง — ข้อที่ต้องมีรูปแน่ๆ: **A13** (ทิศ DevKit) · **A9** (ชิ้นสูงสุด) · **B2** (ช่องลมทั้งสองช่อง) · **D1b** (ด้านที่มี header)

| รหัส | ชื่อไฟล์รูป | หมายเหตุ |
|---|---|---|
| | | |
