Sh080205/AirGuard/docs/bringup/2026-11-03.md

# ขึ้นบอร์ด 3–4 พ.ย. 2569 — microSD · OLED · dashboard · เฟิร์มแวร์ demo

> บันทึกโดย Claude Code จาก log ที่อ่านผ่าน USB-Serial/JTAG (COM7) · ทุกตัวเลขในไฟล์นี้วัดบนบอร์ดจริง เว้นที่เขียนว่า build/host test
> ESP-IDF **v5.5.5** (เครื่องนี้ไม่มี 5.5.6 ตาม `docs/HANDOFF-2026-11-04.md`)
> ⚠️ log 0.2–2 s แรกหลังรีเซ็ตหายทุกครั้ง (USB ต่อใหม่) ⇒ บรรทัด `mahal self-test` ไม่ได้เห็น · ML รายงาน `fault=0` ตลอด

---

## 1. microSD — ❌ เลิกใช้ (ทีมตัดสิน 3 พ.ย.)

| รอบ | โมดูล | ผล |
|---|---|---|
| 1–2 | ตัวเก่า (P5 · ช่องการ์ดมีสิ่งกีดขวาง) | `sdmmc_card_init failed (0x107)` = `ESP_ERR_TIMEOUT` ทุก 5 s · 13/13 และ 5/5 ครั้ง |
| 3–4 | ตัวใหม่ "Micro SD Storage" 6 ขา (`3V3 CS MOSI CLK MISO GND` · ไม่มี regulator · R 10K) บัดกรี header ขาชี้ขึ้น · ต่อ J6 ตามชื่อขา (ยืนยันสีสายกับเจ้าของ) | `0x107` ทุกครั้ง |

- การ์ด SanDisk Ultra 32 GB **เสียบเข้าได้ประมาณครึ่งใบในทุกโมดูลที่ลอง (5 ตัว)** → หน้าสัมผัสไม่ถึงสปริง · สาเหตุ (ซ็อกเก็ต/การ์ด/วิธีเสียบ) ยังไม่ทราบ · ยังไม่ได้ลองการ์ดใบอื่น
- 🔴 ลำดับขาโมดูลไม่ตรงกับ J6 (`+3V3 GND CS MOSI CLK MISO`) — ห้ามต่อ 1:1
- เฟิร์มแวร์: `fw/no-sd` @ `fe80122` · `STORAGE_SD_ENABLE 0` (ไม่เปิด SPI · ไม่ mount) · บนบอร์ด: `sd=off` · `mounts ok/fail=0/0` · ไม่มี `SD mount failed`
- ทางเก็บข้อมูลหลัก = serial mirror + `serial_logger.py` ⇒ **บันทึกได้เฉพาะตอนต่อโน้ตบุ๊ก**

## 2. OLED — ✅ ทำงาน (T2–T4)

- ต่อ **J5** สายไขว้ (J5.1→VCC จอขา 2 · J5.2→GND ขา 1 · J5.3→SDA ขา 4 · J5.4→SCL ขา 3)
- `present=1` · `err=0` `late=0` `no_row=0` `inits=1 drops=0` ทุกช่วง 60 s
- เจ้าของดูด้วยตา: แสดงผลถูก ⇒ ทำงานด้วยชุดคำสั่ง SSD1306 · ไม่ต้อง `OLED_ROTATE_180` (ยังไม่ใช่การยืนยันชื่อชิป)

## 3. Dashboard (FW-8 ขั้น 3 ของ Sh) — ✅ build ครั้งแรกผ่าน · รันได้

- `test/oled-web` @ `2b1a4d6`: รวม `f2784c9` โดยไม่แก้โค้ด FW-8 · ต้องสร้าง `sdkconfig` ใหม่ให้ `CONFIG_HTTPD_WS_SUPPORT=y` · warning 0
- `http://172.20.10.3/` เปิดจากโน้ตบุ๊กบน hotspot เดียวกัน · ค่า PM/T/RH/D² ตรงกับ `AGCSV`/`AGML` · WebSocket 1 client `err=0` · stack HWM web 1,824 / httpd 3,736–4,820 B
- ⬜ B3 (มือถือ 2 เครื่อง) ยังไม่ได้ทำ

## 4. เฟิร์มแวร์ demo — `demo/2026-11-04` @ `5283c0c`

= `main` @ `e4cf96f` (fw7 โมเดลจริง + fw8 + FIX-01) + `test/oled-web` (OLED + SD-off) · merge ไม่ชน · ลบ `sdkconfig` ก่อน build · warning 0 · 0xeb0b0 B · `CONFIG_LWIP_TCPIP_TASK_AFFINITY_CPU0 1` · host test 13 ชุดผ่าน · push แล้ว

## 5. เทียบ B0 (ไม่มีจอ) กับมีจอ — 10 นาทีต่อชุด · 4 พ.ย. 00:58–01:18

ทั้งสองชุด: เฟิร์มแวร์ `5283c0c` · ห้องเจ้าของ · ไม่มี client dashboard · ZE07 ต่ออยู่ · ไม่แตะบอร์ด
B0 = `idf.py -B build/oled_off -DOLED_ENABLE=0` (0xe91b0 B)

| ค่า | B0 | มีจอ |
|---|---|---|
| แถว `AGCSV` ใน 610 s | 608 | 608 |
| `overrun` · `realign` | 0 · 1 | 0 · 0 |
| jitter สูงสุด (since boot) | 67 µs | 107 µs |
| `sampler work per cycle` max (นาทีที่ 2–10) | 111–133 ms | 113–149 ms |
| `ens160 i2c per cycle` max (หลังนาทีแรก) | 2.2–2.7 ms | 2.2–2.3 ms |
| AHT21 `trig/read/crc_err` · ENS160 `err i2c/misr` · PMS `err` | 0 | 0 |
| OLED `chunk us` avg / max | — | 6.8–7.3 ms / **36–70 ms** (ส่วนใหญ่ ~52 ms) |
| stack HWM oled | — | 1,616 B (≥ 1,024 ✅) |

**สรุป**
- `sampler work max` ~113 ms **เกิดใน B0 ด้วย** ⇒ ไม่ได้มาจากจอ · สาเหตุยังไม่ทราบ (`ens160 i2c` ≤ 2.7 ms) · ไม่มี overrun
- chunk ของจอ max ~52 ms **ไม่ผ่านเกณฑ์ T5 (< 10 ms)** แต่ไม่พบผลกระทบที่วัดได้: error เซนเซอร์ 0 ทั้งสองชุด · jitter ต่างกัน 40 µs · แถวครบเท่ากัน ⇒ สาเหตุยังไม่ได้หา
- ⬜ T7 (รีเซ็ต 5 ครั้ง) · T6 HWM io/sampler ไม่ได้ดึงมาเทียบ

## 6. 🔴 ML ขึ้น ALARM ค้างในห้องเจ้าของ (ทั้งสองชุด)

| ที่ | เวลา | RH | T | PM2.5 | D² (เกณฑ์ 17.92) |
|---|---|---|---|---|---|
| ที่เดิม (ก่อนย้ายห้อง) | 00:21 | 52.9 % | 31.8 °C | 31 | ~5 · `below` |
| ห้องเจ้าของ B0 | 00:59–01:08 | 39.7–40.6 % | 32.1–32.3 | 21–22 | 40–46 · `persistent` |
| ห้องเจ้าของ มีจอ | 01:09–01:18 | 38.1 → 34.4 % | 32.2–32.3 | 17–20 | 50 → 72 · `persistent` |

- โมเดล `pm_th` เทรนด้วย RH เฉลี่ย **56.96 ± 2.96 %** (`ag_mahal_pm_th.h`) ⇒ RH 35–40 % ห่างค่าเฉลี่ย ~6–7 SD ⇒ D² สูงจากสภาพห้องต่างจากตอนเทรน ไม่ใช่เหตุการณ์มลพิษ
- ผลต่อ demo: ห้องแอร์/ห้องแห้งจะขึ้น ML ALARM ค้างทั้งที่อากาศปกติ — สอดคล้องกับข้อจำกัด "โมเดลใช้ได้เฉพาะสภาพแวดล้อมแบบที่เทรน" · ห้าม normalize ใหม่บนบอร์ด (CLAUDE.md §2)
- **เจ้าของตัดสิน 4 พ.ย.: อธิบายเป็นข้อจำกัดในการนำเสนอ** · demo สดเน้นการวัด/จอ/dashboard/เส้นทาง CO · ผล ML แสดงจาก R4 บนสไลด์ · ไม่แก้เฟิร์มแวร์/โมเดล

## 7. ยังไม่ได้ทำ (BOARD-01)

B1 เห็นบรรทัด self-test (ต้อง `idf.py monitor` ตั้งแต่บูต) · B2 วัดราง 5 V · B3 มือถือ 2 เครื่อง · B4 · B5 สติกเกอร์ §8 · B6 ในกล่อง · B7 ธูป
