Sh080205/AirGuard/docs/bringup/2026-10-23.md

# บันทึกค่าวัดจอ OLED — 23 ต.ค. 2569

> ใบวัด: `docs/10-ENCLOSURE-V2-MEASURE.md` หมวด 8 · แบบ: `hardware/enclosure_v2/airguard_box.scad`
> ผู้วัด (เจ้าของโปรเจกต์) ส่งค่าผ่านแชท Claude Code · หน่วย mm · เวอร์เนียร์ (รุ่น/ค่าศูนย์ไม่ได้บันทึก)
> **วัดครั้งเดียวทุกค่า** — ช่อง "ค่า 2" ว่าง · คอลัมน์ **ค่ากะเดิม** = ค่าใน SCAD ก่อนวัด ไว้เทียบเท่านั้น
> วางจอหงาย ขอบแถวขาอยู่ด้านบน (ไกลตัว) · "กว้าง" = แนวตัวหนังสือ · "สูง" = ขอบแถวขา ↔ ขอบล่าง

## ค่าที่วัด

| รหัส | วัดอะไร | ค่ากะเดิม | ค่า 1 | ค่า 2 | หมายเหตุ |
|---|---|---|---|---|---|
| O0 | ขนาดจอ | 0.96" 128×64 SSD1306 | **0.96"** | | ตัดสินจาก PCB ~27 × 28 · บน PCB/สายแพพิมพ์ `QW26061001` (น่าจะเป็นรหัสล็อต ไม่ใช่รุ่น) · ความละเอียดและชิปยังไม่ยืนยัน |
| O1a | PCB กว้าง | 27.3 | **27.79** | | วัดแรกด้วยการปัด = 27 |
| O1b | PCB สูง | 27.8 | **27.95** | | วัดแรกด้วยการปัด = 28 |
| O2 | ความหนา PCB | 1.6 | **1.11** | | |
| O3a | กระจกกว้าง | 26.7 | **25.85** | | |
| O3b | กระจกสูง | 19.26 | **19.28** | | |
| O3t | PCB + กระจก หนารวม (หนีบ) | — | **3.18** | | ⬜ ยังไม่ยืนยันว่าจุดที่หนีบหลัง PCB เรียบ (ถ้าทับชิ้นส่วนค่าจะเกินจริง) |
| O4' | ขอบ PCB ฝั่งขา → ขอบล่างกระจก | — | **23.65** | | |
| O4b | ขอบซ้าย PCB → ขอบซ้ายกระจก | ~0.3 | กลาง | | ผู้วัดเห็นแถบ PCB โผล่ "ไม่ถึง 1 mm" ทั้งสองข้าง |
| O5a × O5b | พื้นที่พิกเซล (เอียงจอใต้ไฟ) | 23.74 × 12.86 (viewing area) | **21.53 × 11.25** | | ใกล้ active area ใน datasheet panel (21.74 × 10.86) |
| O5c | ขอบบนกระจก → ขอบบนพิกเซล | (กลาง) | **2.3** | | แนวนอนถือว่าอยู่กลาง |
| O6' | คว่ำจอ (กระจกลง) โต๊ะ → ปลายขา | — | **11.44** | | ขา header ตรง บัดกรีแล้ว |
| O7 | ลำดับขา ซ้าย → ขวา | — | **GND VCC SCL SDA** | | |
| O8 | ชิ้นบนผิวหน้า PCB นอกกระจก | — | **ไม่มีอะไรสูงเกินกระจก** | | |

## ค่าที่คำนวณ (ใส่ลง SCAD)

| ตัวแปร | สูตร | ค่า |
|---|---|---|
| `oled_glass[2]` กระจกสูงจากผิว PCB | O3t − O2 = 3.18 − 1.11 | 2.07 |
| `oled_glass_dy` ขอบ PCB ฝั่งขา → ขอบบนกระจก | O4' − O3b = 23.65 − 19.28 | 4.37 |
| แถบ PCB ใต้กระจก | O1b − O4' = 27.95 − 23.65 | 4.30 |
| แถบ PCB ข้างกระจก | (O1a − O3a) / 2 = (27.79 − 25.85) / 2 | 0.97 |
| `oled_va_dy` กึ่งกลางพิกเซลเยื้องจากกึ่งกลางกระจก (+ = เข้าหาขา) | O3b/2 − (O5c + O5b/2) = 9.64 − 7.925 | 1.715 |
| ของหลัง PCB (พลาสติก header + ขา) | O6' − O3t = 11.44 − 3.18 | 8.26 |
| `oled_back_h` ค่าออกแบบ | 8.26 + สายบัดกรีที่ปลายขา/โค้งสาย ~3 (ประมาณ) | 11.3 |

## ผลต่อแบบ (render OpenSCAD 2021.01 · 23 ต.ค.)

- กรอบจอใหญ่ขึ้นตาม PCB จริง: ถ้าใช้ค่ากะ 27.3 ช่องในกรอบจะเหลือที่แค่ 0.05 mm สำหรับ PCB 27.79
- หน้าต่างฝา 23.53 × 13.25 (พิกเซล + เผื่อข้างละ 1.0) เยื้องตามพิกเซล 1.7 mm เข้าหาขา · เหลือขอบกระจกบังรอบหน้าต่าง ≥ 1.16
- หลัง PCB จอ → ยอด PMS = 16.62 mm · หัก `oled_back_h` เหลือ 5.32
- console ไม่มี `!!` · `intersection()` ฝา↔กล่อง, ฝา↔จอ, กล่อง↔ถาด = ปริมาตร 0 · กล่อง↔จอ, จอ↔PMS, ฝา↔PMS, แท่งกด↔ฝา/กล่อง, ฝา↔ถาด = ว่าง
- ผลจาก CAD เท่านั้น ยังไม่ได้พิมพ์ `fit_oled` ลองกับจอจริง

## 🔴 สายจอ

J3–J5 เรียง `+3V3 GND SDA SCL` · จอเรียง `GND VCC SCL SDA` → ต้องไขว้: J.1 (+3V3) → จอขา 2 (VCC) · J.2 (GND) → ขา 1 · J.3 (SDA) → ขา 4 · J.4 (SCL) → ขา 3 · ต่อ 1:1 = ไฟกลับขั้ว
ห้ามเสียบหัว dupont ตรงที่ขาจอ (ต้องใช้ ~21.5 mm มี 16.6) → บัดกรีสายที่ปลายขา (แนะนำ) หรือดัดขา 90° — ผู้วัดยังไม่ตัดสินวิธี

## PMS7003 หัวสาย — รูปและค่าวัดจากผู้วัด 23 ต.ค.

| รหัส | วัดอะไร | ค่า 1 | ค่า 2 | หมายเหตุ |
|---|---|---|---|---|
| B5 | หัวสายอยู่ตรงไหน | มุมบน ปลายฝั่งช่องเล็ก | | จาก 3 รูป: ช่องเสียบสีดำที่มุมบนของปลายฝั่งช่องเล็ก · แผ่นแปลงสีเขียววางนอนเหนือผิวบน PMS เล็กน้อย · รอยบัดกรีและสายอยู่ขอบแผ่นด้านหน้าช่องลม |
| P1a | แผ่นแปลงยื่นเลยหน้าช่องลม (ไม่รวมสาย) | **5.64** | | |
| P1b | แผ่นแปลงยื่นเลยปลาย PMS | **10.84** | | |
| — | ค่าแรกที่ส่งมา "18.33" | 18.33 | | รวมสายที่ชี้ไปทางช่องลม · ⚠️ Claude Code ตีความผิดครั้งแรกว่ายื่นเลยปลาย → แก้แบบผิดแล้วถอยกลับ ไม่ได้ commit |
| P4 | ผิวบน PMS → ใต้แผ่น · → จุดสูงสุดรวมสาย | **6.06 · 13.5** | | วัด 24 ต.ค. (สายงอแบบตอนประกอบ) · รับได้ ใต้ ≥ −1.0 · สูงสุด ≤ 13.92 → ✅ แต่ห่างใต้กรอบ OLED แค่ 1.42 mm · render: กล่อง/ฝา↔แผ่น+สาย = ว่าง |
| — | แผ่นกินเข้ามาจากหน้าช่องลม · ทับบนผิวบน PMS จากปลาย | ~15 · ~4 | | **ประมาณจากรูป ไม่ใช่ค่าวัด** ใช้ตรวจชนเท่านั้น |

**ผลต่อแบบ (เจ้าของเลือกแบบ ก. 24 ต.ค.):** หน้าช่องลมต้องแนบผนังซ้าย แต่แผ่นแปลงยื่นเลยไป 5.64 → ขยับผนังซ้ายออก `pms_side_gap = 6.2` แล้วเติมเนื้อช่วงตัว PMS (สูง 11 mm ต่ำกว่ายอด PMS 1.0) เป็นอุโมงค์ช่องลมยาว 6.2 · เว้นช่องหน้า PMS `pms_front_gap = 12.0` · กล่อง 169.4 × 84.9 → **175.3 × 96.9 × 36.8** · แผ่นแปลงห่างผนังซ้าย 0.56 ผนังหน้า 1.46 · render OpenSCAD 2021.01: ชิ้นจริงทั้งหมดปิดสนิท ไม่มี `!!` · `intersection()` 12 คู่ (เพิ่ม กล่อง/ฝา↔แผ่นแปลง, กล่อง↔PMS) = ปริมาตร 0 หรือว่าง — ความสูงแผ่นยังเป็นค่ากะ

**แก้ 24 ต.ค. (เจ้าของ):** 5.64 คือแผ่นอย่างเดียว ยังไม่รวมรอยบัดกรีและสายที่หัก → ให้ใช้ระยะยื่นเลยหน้าช่องลม **19 mm** · `pms_side_gap` 6.2 → **19.6** (อุโมงค์ช่องลมยาว 19.6) · กล่อง → **188.7 × 96.9 × 36.8** · ปลาย PMS ใช้ 10.84 — เจ้าของยืนยัน 24 ต.ค. ว่าทางปลายไม่มีรอยบัดกรี/สายยื่นเพิ่ม (สายออกทางหน้าช่องลมทั้งหมด) → `pms_front_gap` 12.0 เท่าเดิม · render ผ่าน · `intersection()` 12 คู่ = ปริมาตร 0 หรือว่าง · ⚠️ อุโมงค์ยาวอาจลดลมที่ PMS ดูดได้ `[ต้องวัดจริง]`

## ZE07-CO ขาใต้ PCB (C3) — วัด 24 ต.ค.

| รหัส | วัดอะไร | ค่า 1 | ค่า 2 | หมายเหตุ |
|---|---|---|---|---|
| C3 | ใต้ PCB → ปลายขา/รอยบัดกรี/สายที่ต่ำสุด | **7.69** | | วัดตาม diagram · ค่าแรกที่ส่งมา 8.7 วัดจากผิวบน PCB ZE07 (ผู้วัดแจ้งว่าอาจผิด) → 8.7 − 1.70 = 7.0 ใกล้กัน |

**ผลต่อแบบ:** เกิน 3.0 → เจ้าของเลือก **ยกแท่นรอง** (`ze07_under` 3.0 → 8.2 = 7.69 + เผื่อ 0.5) แทนการตัดขา · ใต้ฝาเหนือ ZE07 10.6 → 5.4 mm · render: ไม่มี `!!` · `intersection()` ฝา↔ZE07, กล่อง↔ZE07 = ว่าง · ฝา↔กล่อง = ปริมาตร 0 · ผู้วัดยืนยัน 24 ต.ค.: มุม PCB ทั้ง 4 ว่าง ไม่มีขา/รอยบัดกรีภายใน 3 mm → เจ้าของตั้ง `ok_ze07_mount = true`

## ENS160 + AHT21 แถวพิน (D7) — วัด 24 ต.ค.

| รหัส | วัดอะไร | ค่า 1 | ค่า 2 | หมายเหตุ |
|---|---|---|---|---|
| D7 | ขอบล่าง PCB → กึ่งกลางแถวพิน | **1.18** | | อยู่ในช่วง 1.0–2.7 · เดิมแบบกะ 1.5 |
| D5 | กึ่งกลางชิป | 12.93 | | ได้ค่าเดียว ไม่ทราบแกน/ชิป · เจ้าของตัดสิน 24 ต.ค. ไม่ใช้ → ตั้ง `ok_bme_pins = true` ตาม D7 |

**ผลต่อแบบ:** `bme_pin_z` 1.5 → 1.18 · ช่องลอดขาพิน: ธรณีบนพื้น 4.58 ↔ แผ่นห้อยจากฝา 9.08 (กึ่งกลางพิน 6.58) · หัว dupont 2.54 (ค่ามาตรฐานทั่วไป ไม่ได้วัด) เหลือที่ล่าง 0.73 บน 1.23 · render: ชิ้นจริงปิดสนิท ไม่มี `!!` · ฝา↔กล่อง = ปริมาตร 0

## สาย JST (A12) — วัด 24 ต.ค. (เสียบสายครบ จัดสายแบบตอนประกอบ)

| รหัส | วัดอะไร | ค่า 1 | ค่า 2 | หมายเหตุ |
|---|---|---|---|---|
| A12a | ผิวบน carrier → จุดสูงสุดของสาย | **18** | | ต้อง < 24.2 (ใต้ฝา) |
| A12b | ผิวบน carrier → สายตรงขอบซ้าย carrier (ช่องผนังกั้น) | **9.0** | | ต้องอยู่ 2–11.8 (ใต้แผ่นห้อยจากฝา) |

**ผลต่อแบบ:** ผ่านทั้งคู่ ไม่ต้องแก้รูปทรง · เพิ่ม `cable_h` + ตรวจใน console (ไม่มี `!!`)

## PMS7003 manual V2.5 — อ่านครบ 24 ต.ค. (ข้อ `ok_pms_ports`)

แหล่ง: สำเนา PDF จาก kamami.pl (`p564008-PMS7003 series data manua_English_V2.5.pdf` · 15 หน้า · หน้าแรกระบุ "PMS7003 series data manual · Version V2.5 · Date 2016-06-01 · Writer Zhou Yong") — **สำเนาจากผู้ขาย ไม่ใช่เว็บ Plantower โดยตรง**

| หน้า | พบอะไร |
|---|---|
| 1 | "Optional direction of air inlet and outlet in order to adapt the different design" — ไม่บอกว่าช่องไหน |
| 2 | Figure 1 Functional block diagram — ลูกศร Air เข้า/ออกแบบแผนผัง ไม่ผูกกับช่องจริง |
| 3 | Physical size 48 × 37 × 12 · Active current ≤ 100 mA |
| 10 | Installation Attentions: (1) เปลือกโลหะต่อ GND (2) ระนาบ inlet/outlet ชิดผนังเครื่อง หรือมีแผ่นกั้นระหว่างกัน (3) รูบนเครื่องต้องไม่เล็กกว่า inlet (5) ติดสูงจากพื้น ≥ 20 cm |
| 12 | Physical Size (mm) — แบบขนาด **ไม่มีป้าย inlet/outlet** · ช่องใหญ่ 11.00 × 4.40 · ช่องแบน 9.80 × 2.00 (ค่าวัด 11 ต.ค.: 10.61 × 4.02 · 9.74 × 1.94 ✅ ใกล้กัน) · หัวสาย "1.27mm 2X5P" อยู่ผิวด้านตรงข้ามโลโก้ ห่างขอบ 2.85 ทั้งสองแกน |

**สรุป:** manual ไม่ได้ยืนยันว่า inlet = ช่องกว้าง · ข้อ (3) หน้า 10 ใช้ได้กับแบบเรา: รูบนผนังเจาะใหญ่กว่าช่อง PMS ข้างละ 1.0 ทั้งสองช่อง · ยืนยันทิศได้ด้วยการทดลอง: จ่ายไฟ PMS แล้วถือกระดาษทิชชูเส้นบางๆ หน้าแต่ละช่อง ช่องที่ดูด = inlet · ช่องที่เป่า = outlet
