Sh080205/AirGuard/docs/bringup/2026-10-05.md

# บันทึกขึ้นบอร์ด — 5 ต.ค. 2569

> ทำตาม `docs/08-BRINGUP.md` · ใช้ทำ lab report 03603324
> ค่าในคอลัมน์ "ค่าคาด" มาจากเอกสาร (`docs/08` · `docs/01` · `docs/02`) — เป็น **ค่าคาดหมาย ต้องยืนยันด้วยการวัด** จนกว่าคอลัมน์ "ค่าที่ได้" จะมีตัวเลขจริง

**ผู้วัด:** คน A (ฮาร์ดแวร์) · **สถานที่:** มหาวิทยาลัย
**บอร์ด:** ESP32-S3-DevKitC-1 (`ESP32-S3-N16R8` · `RGB@IO48`) บน PCBA AirGuard-S3
**เครื่องมือ:** มัลติมิเตอร์ UNI-T UT33B+ (เลือกย่านเอง) · แหล่งจ่าย adapter 5V ⎓ 2A ผ่านแจ็ค DC → ขั้วสกรู · _(logic analyzer · สโคป: ยังไม่ได้ใช้)_

**สถานะเมื่อหยุดงาน:** ✅ ขั้น 1–3 ผ่าน · ⏸️ **หยุดก่อนขั้น 4** (ยังไม่ได้เสียบ DevKit / ยังไม่ได้ beep 5V↔TP6 · 3V3↔TP5 · G↔TP1) · ⬜ `main/secrets.h` ยังไม่สร้าง · ปัญหาค้าง P1 (C1 220 µF) · P2 (adapter 5.42 V)

## การเตรียม (docs/08 หัวข้อ A–B)

| รายการ | สถานะ | หมายเหตุ |
|---|---|---|
| ESP-IDF | ✅ `idf.py --version` → **ESP-IDF v5.5.5** | ติดตั้งที่ `C:\Espressif\frameworks\esp-idf-v5.5.5` · `where idf.py` เจอ 2 path แต่เป็นชุดเดียวกัน (`idf.py.exe` เป็นตัวเรียก ส่วน `tools\idf.py` เป็นสคริปต์) · ติดตั้งไดรเวอร์ USB (libwdi/WinUSB) ของ Espressif ด้วย |
| `idf.py build` | ✅ ผ่าน (ตามที่คน A แจ้ง) | ตอน build ยังไม่มี `main/secrets.h` จึงได้เฟิร์มแวร์ที่ไม่มี Wi-Fi/SNTP ตั้งเวลาได้ด้วย `settime` อย่างเดียว (`main/CMakeLists.txt` บรรทัด 12–21) |
| `main/secrets.h` | ⬜ ยังไม่สร้าง | ต้องใช้ hotspot 2.4 GHz · สร้างแล้วต้อง build ใหม่ |
| แหล่งจ่าย 5 V สำหรับ J8 | ✅ ได้มาแล้ว | ใช้ในขั้น 3 · _(กรอก: ชนิด/รุ่น · จำกัดกระแสได้ไหม)_ |
| ตำแหน่งโปรเจกต์ | `D:\Project_embed\AirGuard` | ESP-IDF อยู่ไดรฟ์ C ส่วนโปรเจกต์อยู่ D ใช้ได้ · path ไม่มีช่องว่าง · build ผ่านที่ path นี้แล้ว |

## ตารางผลวัด

| ขั้น | สิ่งที่วัด | ค่าที่ได้ | ค่าคาด | ผ่าน/ไม่ผ่าน | หมายเหตุ |
|---|---|---|---|---|---|
**ขั้น 1 — วัดความต้านทาน ไม่เสียบ DevKit · ไม่ต่อไฟ** · มัลติมิเตอร์ UNI-T UT33B+ (เลือกย่านเอง) · ค่าจากรูปที่คน A ถ่ายจอมิเตอร์ (5 ต.ค.)

| ขั้น | สิ่งที่วัด | ค่าที่ได้ | ค่าคาด | ผ่าน/ไม่ผ่าน | หมายเหตุ |
|---|---|---|---|---|---|
| 1-0 | สายวัดแตะกันเอง (ย่าน 200 Ω) | **0.1 Ω** | ใกล้ 0 | — | ค่าชดเชยสายวัด · น้อยจนไม่มีผลกับข้อ 1c–1e |
| 1g-1 | TP4 ↔ TP1 (GND ↔ GND) | ≈ 0 Ω (หลักท้ายถูกบังในรูป) | ≈ 0 Ω | ✅ | ยืนยันว่า TP4 กับ TP1 เป็น GND เดียวกัน |
| 1a | TP6 (+5V) ↔ TP1 (ย่าน 20M) | **0.1 MΩ** (≈ 100 kΩ) | ≫ 1 kΩ | ✅ | สูงกว่าเกณฑ์ 100 เท่า · ต่ำกว่า TP5 มาก — **สมมติฐาน** (ยังไม่ได้พิสูจน์): ราง 5V มี C1 (กำลังชาร์จ/กระแสรั่วของตัวเก็บประจุอิเล็กโทรไลต์) และ LED4 + R8 ต่อคร่อมอยู่ · ไม่ใช่อาการลัดวงจร (ลัดวงจรจะอ่านได้ใกล้ 0 Ω) |
| 1b | TP5 (+3V3) ↔ TP1 (ย่าน 20M) | **7.18 MΩ** | ≫ 1 kΩ | ✅ | |
| 1c | TP2 (SDA) ↔ TP5 (ย่าน 20k) | **4.66 kΩ** | ≈ 4.7 kΩ (R1) | ✅ | −0.9 % จากค่าระบุ · ไม่มี DevKit/เซนเซอร์ → วัดได้ R1 ตัวเดียว · ค่าความคลาดเคลื่อนของ R1 `[ต้องดู BOM]` · ความแม่นของมิเตอร์ `[ต้องเปิดคู่มือ UT33B+ หัวข้อ accuracy]` |
| 1d | TP3 (SCL) ↔ TP5 (ย่าน 20k) | **4.65 kΩ** | ≈ 4.7 kΩ (R2) | ✅ | −1.1 % · หมายเหตุเดียวกับ 1c |
| 1e | gate Q1 ↔ TP1 (ย่าน 200k) | **99.0 kΩ** (อ่านจากรูปที่หมุนจอ) | ≈ 100 kΩ (R10) | ✅ | −1.0 % · ค่านี้ยืนยันด้วยว่าขาที่จิ้มคือ gate (source จะได้ ≈ 0 Ω) |
| 1f | แพดด้านแถบ D1 ↔ TP5 (โหมด beep) | **beep · 1.5 Ω** | beep | ✅ | แถบ (แคโทด) อยู่ด้าน +3V3 ถูกต้อง |

**ขั้น 1 สรุป: ผ่านครบทุกข้อ** → ไม่มีราง 5V/3V3 ลัดลงกราวด์ · R1 R2 R10 ติดถูกค่า · D1 ถูกทิศ

รอบแรกก่อนหน้านี้ (ย่านยังไม่ถูก) วัด TP2/TP3 ↔ TP1 ได้ OL — ตรงกับที่ควรเป็นเพราะ SDA/SCL ไม่มีทางลงกราวด์ตอนไม่มี DevKit แต่ไม่ใช่ข้อทดสอบ

**สังเกตจากรูป (5 ต.ค.):** ช่อง C13 ว่าง ✅ · รอบแรก: บัดกรีแล้ว J2–J5 · J6 · J8 · รอบนี้เห็น **C1 กับ BZ1 บัดกรีแล้ว** (ข้อ 1a–1f วัดหลังใส่ C1/BZ1) · J7 ยังว่าง · **C1 ที่ใส่ = 220 µF/16 V** (คน A ยืนยัน) · **J1 บัดกรีแล้ว** (คน A แจ้ง)

## ขั้น 2 — บัดกรี J1 · C1 · BZ1 · J7

| ขั้น | สิ่งที่ทำ/วัด | ค่าที่ได้ | ค่าคาด | ผ่าน/ไม่ผ่าน | หมายเหตุ |
|---|---|---|---|---|---|
| 2-C1 | ค่าตัวเก็บประจุ C1 | **220 µF/16 V** | 470 µF/16 V (BOM · `docs/02` §4) | ⚠️ ไม่ตรง BOM | ไม่อันตราย (16 V > 5 V) · เอกสารไม่ได้ระบุค่าต่ำสุดของ C1 → ทีมตัดสิน ดูหัวข้อ "ปัญหาที่พบ" |
| 2-J1 | บัดกรี J1 (XH-8P) | เสร็จ | — | ✅ | ตามที่คน A แจ้ง |
| 2a | ส่องสะพานตะกั่ว (โดยเฉพาะ J1) | **ไม่มี** | ไม่มี | ✅ | |
| 2c | ขาไม่มีแถบ C1 ↔ TP6 · ขาฝั่งแถบ C1 ↔ TP1 (beep) | **ดังทั้งคู่** | beep ทั้งคู่ | ✅ | C1 ถูกขั้ว |
| 2d | ขาใต้ + BZ1 ↔ TP5 (beep) · ขาอีกข้าง ↔ TP5 | **ดัง / ไม่ดัง** | ดัง / ไม่ดัง | ✅ | BZ1 ถูกขั้ว (ขา 2 = + ต่อ +3V3) |

## ขั้น 3 — จ่าย 5 V เข้า J8 · ไม่เสียบ DevKit

แหล่งจ่าย: adapter ติดผนัง ฉลาก **OUTPUT 5V ⎓ 2A** → แจ็ค DC → ตัวแปลงขั้วสกรู → J8 (ไม่มีเพดานกระแส)

| ขั้น | สิ่งที่วัด | ค่าที่ได้ | ค่าคาด | ผ่าน/ไม่ผ่าน | หมายเหตุ |
|---|---|---|---|---|---|
| 3-0a | แรงดันปลายสาย adapter ตอนไม่มีโหลด (V⎓ ย่าน 20) | **≈ 5.42 V** | ≈ 5 V | ⚠️ ใช้ในขั้น 3 ได้ | สูงกว่า 5.25 V (เพดาน USB 5 V ±5 %) · ขั้น 3 ไม่มี DevKit โหลดมีแค่ C1 (16 V) + LED4/R8 → ปลอดภัย · **ก่อนใช้ adapter นี้จ่ายไฟให้ DevKit/PMS7003 ต้องเช็ค datasheet ก่อน** ดู P2 |
| 3-0b | ช่อง J8 ↔ TP6 / TP1 · ขั้วสาย | ต่อแล้ว TP6 อ่านได้ **+**5.4 V | + เข้าช่อง +5V | ✅ | ยืนยันทางอ้อมจาก 3c (ค่าเป็นบวก = ขั้วถูก) |
| 3a | LED4 (ไฟเข้า ราง 5V) | **ติด** | ติด | ✅ | |
| 3b | ความร้อน C1 · LED4/R8 · J8 | **ไม่มีอะไรร้อน** | ไม่ร้อน | ✅ | ค่าคาด: LED4 ≈ 5 mA · R8 ≈ 12 mW (คำนวณจาก V_f ≈ 3.0 V ใน docs/02 §5 · ค่าคาดหมาย) |
| 3c | TP6 ↔ TP1 (V⎓ ย่าน 20) | **5.4 V** | ≈ 5.4 V (เท่ากับตอนไม่มีโหลด) | ✅ | โหลดเบามาก แรงดันแทบไม่ตก |
| 3d | TP5 ↔ TP1 (V⎓ ย่าน 20) | **≈ 0 V** | ≈ 0 V | ✅ | ไม่มี DevKit = ไม่มี LDO → ราง 3V3 ต้องไม่มีไฟ · ยืนยันว่าราง 5V ไม่รั่วเข้าราง 3V3 |

**ขั้น 3 สรุป: ผ่าน** · ราง 5V ใช้ได้ · ไม่มีการลัดวงจรระหว่าง 5V กับ 3V3

## ปัญหาที่พบ / ส่งทีมซอฟต์แวร์

| # | เรื่อง | ประเภท | ส่งใคร | สถานะ |
|---|---|---|---|---|
| P1 | **C1 ใส่ 220 µF แทน 470 µF** ตาม BOM | ฮาร์ดแวร์ (ค่าอุปกรณ์) | ทีม — ตัดสินว่าใช้ต่อหรือเปลี่ยน | ⏳ · ขึ้นบอร์ดต่อได้ (แรงดันพิกัดเกินพอ) · ถ้าเจออาการไฟ 5V ตกตอน PMS7003 เริ่มทำงานในขั้น 7–9 ให้นึกถึงข้อนี้ก่อน `[ต้องวัดจริง]` |
| P2 | **adapter 5V 2A อ่านได้ 5.42 V ตอนไม่มีโหลด** | ฮาร์ดแวร์ (แหล่งจ่าย) | คน A | ⏳ · ขั้น 4–9 ใช้ไฟจาก USB ของ DevKit แทนได้ (docs/08 ขั้น 5 เสียบ USB อยู่แล้ว · จ่ายไฟทีละทาง) · ก่อนใช้ adapter จ่ายเครื่องจริงในขั้น 10 ต้องเทียบกับ: VIN สูงสุดของ LDO `[ต้องเปิด SGM2212 datasheet Rev A.2 หัวข้อ Recommended Operating Conditions: VIN]` และไฟเลี้ยงสูงสุดของ PMS7003 `[ต้องเปิด PMS7003 manual หัวข้อ Technical Index: supply voltage]` · วัดซ้ำตอนมีโหลดจริง |
