Sh080205/AirGuard/docs/bringup/2026-10-16.md

# บันทึกขึ้นบอร์ด — 16–17 ต.ค. 2569 (FW-5a: partition 4 MB + ENS160 + ผลฮีตเตอร์ต่อ AHT21)

> ทำตามขั้นทดสอบ FW-5a ขั้น 3 (`docs/tasks/reports/FW-5a.md` — ไฟล์ในเครื่อง) ต่อจาก `docs/bringup/2026-10-14.md` · ใช้ทำ lab report 03603324
> ตัวเลข timing/stack/ตัวนับเป็นค่าที่**เฟิร์มแวร์วัดตัวเอง** (ยังไม่ได้ยืนยันด้วย logic analyzer) · ตัวเลข T/RH มาจาก AHT21 บนบอร์ด · บันทึกนี้รวบรวมจาก `data/raw/usb_fw5a/*` และสิ่งที่ผู้วัดแจ้งในแชต · ช่องที่ยังไม่ได้แจ้งเขียน ⬜

**ผู้วัด:** ____________ · **สถานที่:** ห้องแอร์ (ช่วงแรก) → ห้องไม่มีแอร์ (ตั้งแต่ 22:34)
**บอร์ด:** ESP32-S3-DevKitC-1 (ชิป rev v0.2 · flash `boya` 16 MB · PSRAM AP 8 MB octal) บน PCBA AirGuard-S3 · โมดูล ENS160+AHT21 ที่ J3 · PMS7003 · ZE07-CO ยังไม่ต่อ · ไม่มีการ์ด SD
**เฟิร์มแวร์:** commit **`4b2738c`** (branch `fw/fw5a-ens160` · ยังไม่ merge · ยังไม่ผ่าน GPT รีวิว) · build ใน worktree `.claude/worktrees/fw5a-ens160-8f1621` · ESP-IDF **v5.5.5** · สองแบบจาก commit เดียวกัน: `ENS160_ENABLE=0` (ENS160 deep sleep) / `ENS160_ENABLE=1` (STANDARD)
**คอม / พอร์ต:** Acer Nitro V 16 · Windows 11 · COM7 (`USB Serial Device`, `VID_303A&PID_1001`) · บันทึกด้วย `firmware/tools/serial_logger.py --out data/raw/usb_fw5a`
**แหล่งจ่าย:** USB โน้ตบุ๊ก · J8 ไม่ได้ใช้ · **นอกกล่อง**
**เครื่องมือ:** ไม่มีเทอร์โมมิเตอร์อ้างอิง ⬜ (ไม่ได้แจ้งว่ามี) · logic analyzer/สโคป: ไม่ได้ใช้

**สถานะเมื่อหยุดงาน (17 ต.ค. 01:5x):** ✅ partition 4 MB · ✅ ENS160 ทำงานครบ (PART_ID · STANDARD · MISR · ชดเชย T/RH · tvoc/eco2 ในแถว) · ✅ คาบ 1 Hz ไม่เสีย · 📌 **ฮีตเตอร์ ENS160 ทำให้ AHT21 อ่าน T สูงขึ้น ~+3.2 °C และ RH ต่ำลง ~−11 %RH (นอกกล่อง)** · ⚠️ เฟิร์มแวร์ restart ENS160 โดยไม่จำเป็น 1 ครั้งตอนบูต (P7) · ❌ SD ยังใช้ไม่ได้ (เหมือนเดิม)

---

## ลำดับการทดสอบ

| ช่วง | build | ไฟล์ CSV | เวลา (แถวแรก → แถวสุดท้าย) | แถว | แถวหาย | ห้อง |
|---|---|---|---|---|---|---|
| OFF1-แอร์ | `ENS160_ENABLE=0` | `AG_20261016_210223_usb.csv` | 21:02:23 → 21:46:18 | 2,635 | 1 (`21:45:58`) | ห้องแอร์ · **ไม่ใช้คำนวณผลฮีตเตอร์** (ย้ายห้องก่อนช่วงถัดไป) |
| *(ย้ายบอร์ดไปห้องไม่มีแอร์ · ถอดสาย USB ระหว่างย้าย)* | | | | | | |
| **OFF1** | `ENS160_ENABLE=0` (ไม่ flash ใหม่ · บูตใหม่หลังเสียบสาย) | `AG_20261016_223456_usb.csv` | 22:34:56 → 23:48:54 | 4,438 | 1 (`23:24:28`) | ห้องไม่มีแอร์ |
| **ON** | `ENS160_ENABLE=1` · flash 23:51 | `AG_20261016_235731_usb.csv` + `AG_20261017_000000_usb.csv` (logger แยกไฟล์ตอนเที่ยงคืน) | 23:57:31 → 00:58:41 | 3,671 | 0 | ห้องไม่มีแอร์ |
| **OFF2** | `ENS160_ENABLE=0` · flash ~01:00 | `AG_20261017_010108_usb.csv` | 01:01:08 → 01:51:20 (ใช้วิเคราะห์ · logger ยังรันต่อหลังจากนั้น) | 3,013 | 0 | ห้องไม่มีแอร์ |

- สภาพห้องที่ผู้วัดตั้งไว้ (พัดลม/หน้าต่าง/ตำแหน่งที่นั่ง) ⬜ ไม่ได้จด · ผู้วัดนั่งตำแหน่งเดิมทุกช่วงตามที่สั่ง
- ระหว่าง OFF1 (ห้องไม่มีแอร์) RH ขึ้นเร็วช่วง 23:00–23:30 (สาเหตุไม่ทราบ) → ยืด OFF1 จนช้าลง (≤ ~1 %RH/15 นาที) ก่อนเริ่ม ON

---

## A. flash / บูต / partition (ข้อ 3-1 ถึง 3-5)

| ข้อ | สิ่งที่ตรวจ | ค่าที่ได้ | ค่าคาด | ผล |
|---|---|---|---|---|
| 3-1 | flash เต็มครั้งแรกหลังเปลี่ยน partition | esptool เขียน `0x0` · `0x10000` · **`0x8000` (partition table)** · `Hash of data verified` ทุกก้อน | — | ✅ |
| 3-1 | ตาราง partition จาก bootloader | `nvs 00009000 00006000` · `phy_init 0000f000 00001000` · **`factory 00010000 00400000`** | factory 4 MB | ✅ |
| 3-1 | ขนาด app | OFF `0xe43a0` B · ON `0xe4c40` B · เหลือ **78 %** ของ 4 MB | — | ✅ |
| 3-2 | ENS160 (OFF) | `ENS160 PART_ID 0x0160, DEEP SLEEP (ENS160_ENABLE=0)` | PART_ID 0x0160 (DS Table 17) | ✅ คุย I²C กับ ENS160 ตัวจริงได้ครั้งแรก |
| 3-3 | AHT21 / PMS / SNTP | AHT21 status `0x18` · CRC OK ทุกเฟรม · `crc_err=0` · PMS `err=0` · SNTP sync ได้ | เหมือน 14 ต.ค. | ✅ |
| 3-4 | แถว CSV ช่วง OFF | PM/T/RH ไม่มีช่องว่างหลัง logger เริ่ม · `tvoc_ppb/eco2_ppm` ว่างทุกแถว | ว่าง | ✅ |

## B. ENS160 ทำงานจริง — ช่วง ON (ข้อ 3-6 ถึง 3-17)

| ข้อ | สิ่งที่ตรวจ | ค่าที่ได้ | ค่าคาด | ผล |
|---|---|---|---|---|
| 3-6 | เข้า STANDARD | `ENS160 PART_ID 0x0160, OPMODE STANDARD at uptime 0 s` (อ่าน OPMODE กลับได้ 0x02) | — | ✅ |
| 3-7 | สถานะหลังเข้า STANDARD | uptime 1 s: `none -> not running` (`DEVICE_STATUS 0x03` = STATAS ยังเป็น 0) → เฟิร์มแวร์ restart ตอน 12 s (`restarts=1`) → 13 s: `not running -> initial start-up` (`0x8B`) | warm-up ≤ 3 นาที หรือ initial start-up ≤ 1 ชม. (DS Table 9) | ⚠️ ดู P7 |
| 3-7 | initial start-up → normal | `initial start-up -> normal at uptime 3798 s` (`0x83`) ≈ 00:55:12 · **63 นาที** นับจาก STANDARD ครั้งที่สอง (12 s) | ≤ 1 ชม. (DS Table 9) | 📌 ช้ากว่าค่าสูงสุดใน DS ~3 นาที (ค่าที่วัดได้ · สาเหตุยังสรุปไม่ได้) |
| 3-8 | แถวช่วง initial start-up | `tvoc_ppb,eco2_ppm` ว่าง (ไม่ใช่ 0) ตลอด 23:57:31–00:55:11 | ว่าง | ✅ |
| 3-9 | แถวหลัง normal | มีค่าทุกแถว (210 แถว ถึง 00:58:41) · TVOC **84–155 ppb** (ค่ากลาง ~100) · eCO2 **521–633 ppm** (≥ 400 ทุกแถว) | ในช่วง DS Table 4 | ✅ |
| 3-10 | ข้อผิดพลาด | `err start=0 i2c=0 misr=0` · **MISR ตรงทุกครั้ง** ⇒ การตีความโค้ดตัวอย่าง DS §16.2.14 (แก้บั๊ก precedence) ถูกต้อง | 0 | ✅ |
| 3-11 | เขียนชดเชย T/RH | `comp writes=1984 err=0 skipped=0` (≈ 30/นาที) | ~30/นาที | ✅ |
| 3-12 | ค่าที่ ENS160 ใช้ | `sensor uses T=28.49 C RH=63.02 %` เทียบแถว 23:52:53 `28.5, 63.0` · ภายหลัง `T=30.90 RH=57.11` ตรงกับแถว | ≲ 0.1 ต่าง | ✅ |
| 3-13 | อัตราข้อมูล ENS160 | NEWDAT 3,769 ครั้ง / อ่าน 3,967 ครั้ง (ไม่มี NEWDAT 198 = 5 %) · gap 998–3,001 ms ⇒ **~1 Hz** · แถว VOC: ใหม่ 172 · ใช้ซ้ำ (≤ 2.5 s) 9 | DS ไม่ระบุ | 📌 ค่าที่วัดได้ |
| 3-17 | MARK | `MARK #1` 23:58:03 → `#2` 23:58:25 · `AGEV,2026-10-16T23:58:03+07:00,2026-10-16T23:58:25+07:00,marked,` · แถว `marked` **23 แถว** ตรงช่วงพอดี · `EV_20261016_235731_usb.csv` | 1 เหตุการณ์ | ✅ |
| 3-18 | ถอด J3 ขณะทำงาน | ⬜ ไม่ได้ทำ (ทางเลือก) | — | ⬜ |

## C. เวลา / หน่วยความจำ (ข้อ 3-14 ถึง 3-16) — จากสรุป 60 s

| ช่วง | jitter ต่อนาที | สูงสุดตั้งแต่บูต | overrun | dropped | ENS160 I²C ต่อรอบ avg / max | sampler work avg / max | stack HWM sampler (ต่ำสุด) | heap ต่ำสุด |
|---|---|---|---|---|---|---|---|---|
| OFF1-แอร์ | 0–20 µs | 20 µs | 0 | 0 | 4 / 7 µs (ไม่อ่าน) | 2.43–2.56 ms / 90.7 ms | 2,624 B | 8,568,088 B |
| OFF1 | 0–15 µs | 16 µs | 0 | 0 | 4 / 7 µs | 2.45–2.75 ms / 101.8 ms | 2,608 B | 8,569,672 B |
| **ON** | 1–12 µs · **1 นาทีเป็น 76 µs** (~00:24) | 76 µs | 0 | 0 | **1,851 / 2,363 µs** | **4.32–4.50 ms** / 97.6 ms | 2,608 B | 8,567,944 B |
| OFF2 | 0–19 µs | 19 µs | 0 | 0 | 4 / 7 µs | 2.43–2.56 ms / 91.0 ms | 2,608 B | 8,568,144 B |
| *อ้างอิง 14 ต.ค.* | *10–13 µs* | *18 µs* | *0* | *0* | — | — | *2,808–2,844 B* | *8,573,696 B* |

- ✅ **คาบ 1 Hz ไม่เสีย:** overrun 0 ทุกช่วง · jitter ต่อนาทีไม่เกินเกณฑ์ที่เสนอ (100 µs) · ค่า 76 µs เกิดนาทีเดียว (สาเหตุยังไม่ทราบ — Wi-Fi อยู่ core 0 ส่วน sampler อยู่ core 1)
- ENS160 ใช้เวลา I²C **~1.85 ms/รอบ** (ค่าคาด 1–2 ms ✅) ⇒ sampler work เฉลี่ยเพิ่มจาก ~2.5 → ~4.4 ms · ยังเหลือเวลาในรอบ > 99 %
- work **สูงสุด 90–102 ms** ทุกช่วง (รวม OFF) = รอบที่พิมพ์สรุป 60 s เอง (~1,000 ตัวอักษรที่ UART 115200 baud ≈ 87 ms) · ไม่ใช่งาน ENS160 · ต่ำกว่าคาบ 1000 ms มาก
- stack sampler เหลือ ≥ 2,608 B จาก 5,120 (51 %) ✅ เป้า ≥ 25 % (`task_config.h`) · ลดจาก 14 ต.ค. ~200 B ตรงกับที่คาด
- ENS160 I²C max ตอนบูต 12.9 ms = รอบเปิดใช้ ENS160 ซึ่งรวมเวลาพิมพ์ log ภายในช่วงที่จับเวลา

---

## D. ผลฮีตเตอร์ ENS160 ต่อ AHT21 (นอกกล่อง · ห้องไม่มีแอร์)

**คำสั่ง** (ทำซ้ำได้):
```bat
cd /d <repo>\firmware
python tools\heater_compare.py --csv <usb_fw5a>\AG_20261016_223456_usb.csv <usb_fw5a>\AG_20261016_235731_usb.csv <usb_fw5a>\AG_20261017_000000_usb.csv <usb_fw5a>\AG_20261017_010108_usb.csv ^
  --phase off1 2026-10-16T22:34:56+07:00 2026-10-16T23:48:54+07:00 ^
  --phase on   2026-10-16T23:57:31+07:00 2026-10-17T00:58:41+07:00 ^
  --phase off2 2026-10-17T01:01:08+07:00 2026-10-17T01:51:20+07:00 ^
  --compare on=off1,off2 --compare on=off1 --compare on=off2 --settle-min 10
```

**ผล (ทิ้ง 10 นาทีแรกของแต่ละช่วง):**
```
phase   rows  T mean  T std  T min  T max  T slope/h | RH mean RH std  RH min RH max RH slope/h
off1    3838   27.12  0.397   26.5   27.8      1.25 |   61.51  1.679   59.0   64.0       5.23
on      3071   30.88  0.180   30.2   31.3      0.26 |   57.04  0.699   55.8   58.9       2.22
off2    2413   28.00  0.075   27.9   28.3      0.14 |   67.68  0.415   66.7   68.6       1.84
  on - mean(off1,off2): dT = 3.32 C  dRH = -7.56 %RH
  on - mean(off1):      dT = 3.76 C  dRH = -4.48 %RH
  on - mean(off2):      dT = 2.88 C  dRH = -10.64 %RH
```

| วิธี | dT | dRH |
|---|---|---|
| `heater_compare.py` ABA · settle 10 นาที | +3.32 °C | −7.56 %RH |
| ABA · settle 20 นาที | +3.30 °C | −7.69 %RH |
| 30 นาทีท้ายแต่ละช่วง + baseline ประมาณค่าเชิงเส้น ณ เวลากลางช่วง ON (น้ำหนัก 0.57) | +3.19 °C | −8.45 %RH |
| **คิดจาก vapour pressure** (RH ที่เซนเซอร์ไม่โดนความร้อนจะอ่านได้ในอากาศเดียวกับช่วง ON โดยใช้ T ห้อง 27.47–28.01 °C) | — | **−10.7 ถึง −12.8 %RH** |
| สูตร Magnus คาดจาก dT = +3.19 °C | — | −11.6 %RH |

**ค่าที่สรุป:** **dT ≈ +3.2 °C** (ทุกวิธี 2.9–3.8 °C) · **dRH ≈ −11 ถึง −12 %RH** (ขั้นต่ำ −7.6 %RH) · ทั้งคู่เกินความแม่นของ AHT21 (±0.3 °C · ±2 %RH — CLAUDE.md §5) **ราว 10 เท่าและ 5 เท่า**

**ทำไม RH ต้องคิดจาก vapour pressure:** ความชื้นสัมบูรณ์ในห้องเพิ่มขึ้นแบบไม่เป็นเส้นตรงตลอดการทดลอง (vapour pressure จากค่า AHT21: OFF1 23.09 → ON 25.66 → OFF2 25.59 hPa · จุดน้ำค้าง 19.8 → 21.6 → 21.5 °C) · ABA ตัดได้เฉพาะการเปลี่ยนเชิงเส้น จึงประเมิน dRH ต่ำเกินจริง · ฮีตเตอร์เปลี่ยนแค่อุณหภูมิ ไม่เปลี่ยนไอน้ำ (vapour pressure ช่วง ON ≈ OFF2) ⇒ RH_ไม่โดนความร้อน = e_ON / e_s(T_ห้อง) · e_s ตาม Magnus (WMO, Sonntag 1990): e_s(T) = 6.112·exp(17.62·T / (243.12 + T)) hPa
⇒ ค่าที่คิดได้ (−10.7 ถึง −12.8) ตรงกับที่สูตรทำนายจาก dT (−11.6) — สองวิธีที่ไม่ขึ้นต่อกันได้คำตอบเดียวกัน

**ความเปลี่ยนแปลงตามเวลา:** หลังเข้า STANDARD T ขึ้น 27.7 → 28.7 °C ใน ~70 s และนิ่งที่ ~30.8–31.1 °C ภายใน ~5–10 นาที · หลังกลับ deep sleep T ลด 30.0 → 28.2 °C ใน 7 นาที ⇒ ค่าคงที่เวลาความร้อนของโมดูลอยู่ระดับไม่กี่นาที (settle 10 นาทีพอ)

**ข้อจำกัด:** นอกกล่อง (กล่องกักความร้อน → ผลในกล่องน่าจะมากกว่า) · ไม่มีเทอร์โมมิเตอร์อ้างอิง · ห้องเปลี่ยนความชื้นระหว่างทดลอง · ทำครั้งเดียว · ผลขึ้นกับการไหลของอากาศรอบโมดูล (พัดลม PMS อยู่ใกล้) — `[ต้องวัดจริง: ทำซ้ำในกล่อง]`

---

## ปัญหาที่พบ / ข้อสังเกต

| # | เรื่อง | รายละเอียด | สถานะ |
|---|---|---|---|
| P6 | Wi-Fi `reason 201` | `WIFI_REASON_NO_AP_FOUND` ซ้ำทุก ~12 s → ไม่มีเวลาจริง ไม่มีแถว CSV · สาเหตุ: เปลี่ยนไปใช้ hotspot จากมือถืออีกเครื่อง แต่ SSID ฝังตอน build · แก้ `main/secrets.h` แล้ว build + flash ใหม่ | ✅ แก้แล้ว (ซ้ำเรื่องเดิมใน §10: เปลี่ยน hotspot ต้อง build ใหม่) |
| P7 | restart ENS160 ไม่จำเป็นตอนบูต | 1 s หลังเขียน STANDARD (อ่าน OPMODE กลับได้ 0x02 แล้ว) `DEVICE_STATUS` ยังมี STATAS = 0 → `ens160_note_status()` ตีเป็น NOT_RUNNING → restart หลัง 10 s · DS ไม่ระบุเวลาที่ STATAS จะขึ้น · ผล: เสียเวลา 12 s ในช่วงที่ค่ายังใช้ไม่ได้อยู่แล้ว ไม่เสียข้อมูล | ⬜ เสนอแก้: เมื่อ STATAS = 0 ให้อ่าน OPMODE ก่อน — ยังเป็น 0x02 = รอ · เป็น 0x01 = restart (ไม่ต้องเดาเวลารอ) |
| P8 | initial start-up 63 นาที | DS Table 9 สูงสุด 1 ชม. · วัดได้ 63 นาทีนับจาก STANDARD ครั้งที่สอง · 📌 DS เชิงอรรถ 24: ENS160 บันทึกว่าผ่านช่วงนี้ลง NVM หลังทำงาน**ต่อเนื่อง 24 ชม.** — ถ้าดับไฟ/flash เป็น OFF ก่อนครบ จะกลับมา initial start-up อีก ⇒ วันแรกของการเก็บข้อมูลจริง `tvoc/eco2` จะว่าง ~1 ชม. | 📌 ค่าที่วัดได้ |
| P9 | แถวหายทาง USB | 2 แถวจาก ~13,950 (21:45:58 · 23:24:28) · เฟิร์มแวร์นับว่าสร้าง/พิมพ์แล้ว (`skipped_sec=0` · `dropped=0` · mirror `errors=0`) แต่ไม่มีใน `serial_*.log` ⇒ หายในเส้นทาง USB-Serial/JTAG → PC | ⬜ อาการเดียวกับ 14 ต.ค. (1/1,141) · สาเหตุยังไม่ทราบ · ไม่เกี่ยวกับ FW-5a |
| — | OFF1 ห้องแอร์ใช้ไม่ได้กับผลฮีตเตอร์ | ย้ายห้องหลังจบช่วง → T/RH กระโดด (24 → 26 °C · 73 → 59 %) ซึ่ง ABA แก้ไม่ได้ · ยังใช้เป็นผลทดสอบข้อ 3-1…3-5 ได้ | บันทึกไว้ · ไม่ลบไฟล์ |
| — | `i2c.master: Please check pull-up resistances` | เตือนเพราะปิด pull-up ภายในโดยตั้งใจ (บนบอร์ดมี 4.7 kΩ — CLAUDE.md §4) · ไม่เปลี่ยนใน FW-5a | ปกติ |
| — | `SD mount failed: ESP_ERR_TIMEOUT` ทุก 5 s | ไม่มีการ์ด (P5 เดิม) | ปกติ |

## ยังไม่ได้ทำ

⬜ 3-18 ถอด J3 ขณะทำงาน · ⬜ วัดผลฮีตเตอร์ในกล่อง · ⬜ เทอร์โมมิเตอร์อ้างอิง · ⬜ logic analyzer (jitter ที่ GPIO4) · ⬜ ENS160 ทำงานต่อเนื่อง 24 ชม. (ให้ initial start-up ถูกบันทึกถาวร) · ⬜ กลับเป็น build ปกติ (`ENS160_ENABLE=1`) — บอร์ดยังเป็นแบบ OFF เมื่อหยุดงาน
