Sh080205/AirGuard/data/processed/qa/2026-10-27-1400/qa.md

# QA ข้อมูล raw — WARN

ช่วง 2026-10-25T20:24:17+07:00 → 2026-10-27T13:55:15+07:00 · 149,449 แถว (ควรมี 149,459 ที่ 1 Hz · หาย 10 = 0.0067 %)

## เหตุผล

- WARN: ค่าค้าง ≥ 10 นาที: temp_c

## ช่องว่าง

| หลังแถว | กลับมา | ยาว (s) | แถวหาย | ชนิด |
|---|---|---|---|---|
| 2026-10-25T22:06:52+07:00 | 2026-10-25T22:06:54+07:00 | 2.0 | 1 | transit |
| 2026-10-25T23:20:48+07:00 | 2026-10-25T23:20:50+07:00 | 2.0 | 1 | transit |
| 2026-10-26T04:55:44+07:00 | 2026-10-26T04:55:46+07:00 | 2.0 | 1 | transit |
| 2026-10-26T12:19:10+07:00 | 2026-10-26T12:19:12+07:00 | 2.0 | 1 | transit |
| 2026-10-26T15:49:42+07:00 | 2026-10-26T15:49:44+07:00 | 2.0 | 1 | transit |
| 2026-10-26T20:12:40+07:00 | 2026-10-26T20:12:42+07:00 | 2.0 | 1 | transit |
| 2026-10-27T03:29:09+07:00 | 2026-10-27T03:29:11+07:00 | 2.0 | 1 | transit |
| 2026-10-27T08:27:54+07:00 | 2026-10-27T08:27:56+07:00 | 2.0 | 1 | transit |
| 2026-10-27T08:32:14+07:00 | 2026-10-27T08:32:16+07:00 | 2.0 | 1 | transit |
| 2026-10-27T09:14:17+07:00 | 2026-10-27T09:14:19+07:00 | 2.0 | 1 | transit |

## ค่าว่างต่อคอลัมน์

| คอลัมน์ | ว่างทั้งหมด | ในช่วงอุ่นเครื่อง | นอกช่วงอุ่นเครื่อง | % นอกช่วง | ว่างติดกันนานสุด (แถว) |
|---|---|---|---|---|---|
| pm1_0 | 0 | 0 | 0 | 0.0 | 0 |
| pm2_5 | 0 | 0 | 0 | 0.0 | 0 |
| pm10 | 0 | 0 | 0 | 0.0 | 0 |
| temp_c | 0 | 0 | 0 | 0.0 | 0 |
| humidity_pct | 0 | 0 | 0 | 0.0 | 0 |
| tvoc_ppb | 0 | 0 | 0 | 0.0 | 0 |
| eco2_ppm | 0 | 0 | 0 | 0.0 | 0 |
| co_ppm | 0 | 0 | 0 | 0.0 | 0 |

## ค่าค้าง

| คอลัมน์ | เริ่ม | จบ | นาน (s) | ค่า |
|---|---|---|---|---|
| temp_c | 2026-10-26T00:03:08+07:00 | 2026-10-26T00:19:25+07:00 | 977.0 | 32.7 |
| temp_c | 2026-10-26T12:51:26+07:00 | 2026-10-26T13:01:59+07:00 | 633.0 | 35.9 |
| temp_c | 2026-10-26T19:46:24+07:00 | 2026-10-26T19:56:39+07:00 | 615.0 | 34.1 |
| temp_c | 2026-10-26T19:58:50+07:00 | 2026-10-26T20:09:31+07:00 | 641.0 | 34.0 |
| temp_c | 2026-10-27T00:47:48+07:00 | 2026-10-27T00:59:49+07:00 | 721.0 | 32.1 |

คอลัมน์นอก pm_th (ไม่นับเป็น WARN · รายละเอียดใน qa.json): co_ppm 47 ช่วง

## ช่วง marked

ไม่มี

## รายวัน (แถว normal)

| วัน | แถว | ครอบคลุม % | pm2_5 med [p5–p95] | temp_c med [p5–p95] | humidity_pct med [p5–p95] |
|---|---|---|---|---|---|
| 2026-10-25 | 12941 | 99.9845 | 16.0 [10.0–19.0] | 33.4 [32.8–34.1] | 55.9 [54.9–58.2] |
| 2026-10-26 | 86396 | 99.9954 | 18.0 [9.0–37.0] | 33.5 [31.4–36.8] | 57.0 [53.6–65.2] |
| 2026-10-27 | 50112 | 99.992 | 22.0 [19.0–27.0] | 31.7 [30.7–36.2] | 57.4 [54.6–66.0] |

## correlation (Pearson · แถว normal · ค่าดิบ)

| | pm2_5 | temp_c | humidity_pct |
|---|---|---|---|
| pm2_5 | 1.0 | 0.4058 | 0.2621 |
| temp_c | 0.4058 | 1.0 | 0.075 |
| humidity_pct | 0.2621 | 0.075 | 1.0 |

## ไฟล์ input

- `AG_20261025_202417_usb.csv` sha256 `2a18504c78170249…`
- `AG_20261026_000000_usb.csv` sha256 `22f7942bfb655a81…`
- `AG_20261027_000000_usb.csv` sha256 `b2ec8c82841d25a8…`

รูป: qa_timeseries.png

temp_c / humidity_pct คือค่ารอบโมดูลที่โดนฮีตเตอร์ ENS160 ไม่ใช่ค่าห้อง
