Sh080205/AirGuard/data/processed/qa/2026-10-30/qa.md

# QA ข้อมูล raw — WARN

ช่วง 2026-10-25T20:24:17+07:00 → 2026-10-30T14:12:11+07:00 · 409,635 แถว (ควรมี 409,675 ที่ 1 Hz · หาย 40 = 0.0098 %)

## เหตุผล

- WARN: ค่าค้าง ≥ 10 นาที: temp_c
- WARN: ช่วง marked ที่ยังไม่มีชื่อใน events 3 ช่วง (จะเป็น unknown)

## ช่องว่าง

| หลังแถว | กลับมา | ยาว (s) | แถวหาย | ชนิด |
|---|---|---|---|---|
| 2026-10-25T22:06:52+07:00 | 2026-10-25T22:06:54+07:00 | 2.0 | 1 | transit |
| 2026-10-25T23:20:48+07:00 | 2026-10-25T23:20:50+07:00 | 2.0 | 1 | transit |
| 2026-10-26T04:55:44+07:00 | 2026-10-26T04:55:46+07:00 | 2.0 | 1 | transit |
| 2026-10-26T12:19:10+07:00 | 2026-10-26T12:19:12+07:00 | 2.0 | 1 | transit |
| 2026-10-26T15:49:42+07:00 | 2026-10-26T15:49:44+07:00 | 2.0 | 1 | transit |
| 2026-10-26T20:12:40+07:00 | 2026-10-26T20:12:42+07:00 | 2.0 | 1 | transit |
| 2026-10-27T03:29:09+07:00 | 2026-10-27T03:29:11+07:00 | 2.0 | 1 | transit |
| 2026-10-27T08:27:54+07:00 | 2026-10-27T08:27:56+07:00 | 2.0 | 1 | transit |
| 2026-10-27T08:32:14+07:00 | 2026-10-27T08:32:16+07:00 | 2.0 | 1 | transit |
| 2026-10-27T09:14:17+07:00 | 2026-10-27T09:14:19+07:00 | 2.0 | 1 | transit |
| 2026-10-27T17:18:24+07:00 | 2026-10-27T17:18:26+07:00 | 2.0 | 1 | transit |
| 2026-10-27T18:00:29+07:00 | 2026-10-27T18:00:31+07:00 | 2.0 | 1 | transit |
| 2026-10-27T20:31:12+07:00 | 2026-10-27T20:31:14+07:00 | 2.0 | 1 | transit |
| 2026-10-28T02:43:57+07:00 | 2026-10-28T02:43:59+07:00 | 2.0 | 1 | transit |
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
|---|---|---|---|
| 2026-10-28T12:25:28+07:00 | 2026-10-28T13:16:43+07:00 | 3073 | — (unknown) |
| 2026-10-29T12:27:48+07:00 | 2026-10-29T12:32:40+07:00 | 292 | — (unknown) |
| 2026-10-29T15:07:28+07:00 | 2026-10-29T16:42:01+07:00 | 5673 | — (unknown) |

## รายวัน (แถว normal)

| วัน | แถว | ครอบคลุม % | pm2_5 med [p5–p95] | temp_c med [p5–p95] | humidity_pct med [p5–p95] |
|---|---|---|---|---|---|
| 2026-10-25 | 12941 | 99.9845 | 16.0 [10.0–19.0] | 33.4 [32.8–34.1] | 55.9 [54.9–58.2] |
| 2026-10-26 | 86396 | 99.9954 | 18.0 [9.0–37.0] | 33.5 [31.4–36.8] | 57.0 [53.6–65.2] |
| 2026-10-27 | 86393 | 99.9919 | 25.0 [20.0–111.0] | 34.3 [30.7–37.4] | 55.9 [53.3–65.1] |
| 2026-10-28 | 86388 | 99.9861 | 32.0 [22.0–44.0] | 34.2 [32.8–36.5] | 56.8 [51.4–60.1] |
| 2026-10-29 | 86389 | 99.9873 | 25.0 [8.0–42.0] | 34.0 [32.7–37.6] | 57.2 [53.5–60.7] |
| 2026-10-30 | 51128 | 99.9922 | 29.0 [20.0–335.0] | 32.8 [31.9–35.7] | 58.85 [56.4–63.0] |

## correlation (Pearson · แถว normal · ค่าดิบ)

| | pm2_5 | temp_c | humidity_pct |
|---|---|---|---|
| pm2_5 | 1.0 | 0.057 | 0.2244 |
| temp_c | 0.057 | 1.0 | -0.2982 |
| humidity_pct | 0.2244 | -0.2982 | 1.0 |

## ไฟล์ input

- `AG_20261025_202417_usb.csv` sha256 `2a18504c78170249…`
- `AG_20261026_000000_usb.csv` sha256 `22f7942bfb655a81…`
- `AG_20261027_000000_usb.csv` sha256 `d0ebb442d331d68e…`
- `AG_20261028_000000_usb.csv` sha256 `8356bfe3df9b3fad…`
- `AG_20261029_000000_usb.csv` sha256 `e56a3a22bbb10437…`
- `AG_20261030_000000_usb.csv` sha256 `26975b39f4b29c38…`

รูป: qa_timeseries.png

temp_c / humidity_pct คือค่ารอบโมดูลที่โดนฮีตเตอร์ ENS160 ไม่ใช่ค่าห้อง
