Sh080205/AirGuard/docs/slides/img/SCH_Schematic3_2026-11-04.pdf

# LED_Y_AGND

# LED_R_A GND GND

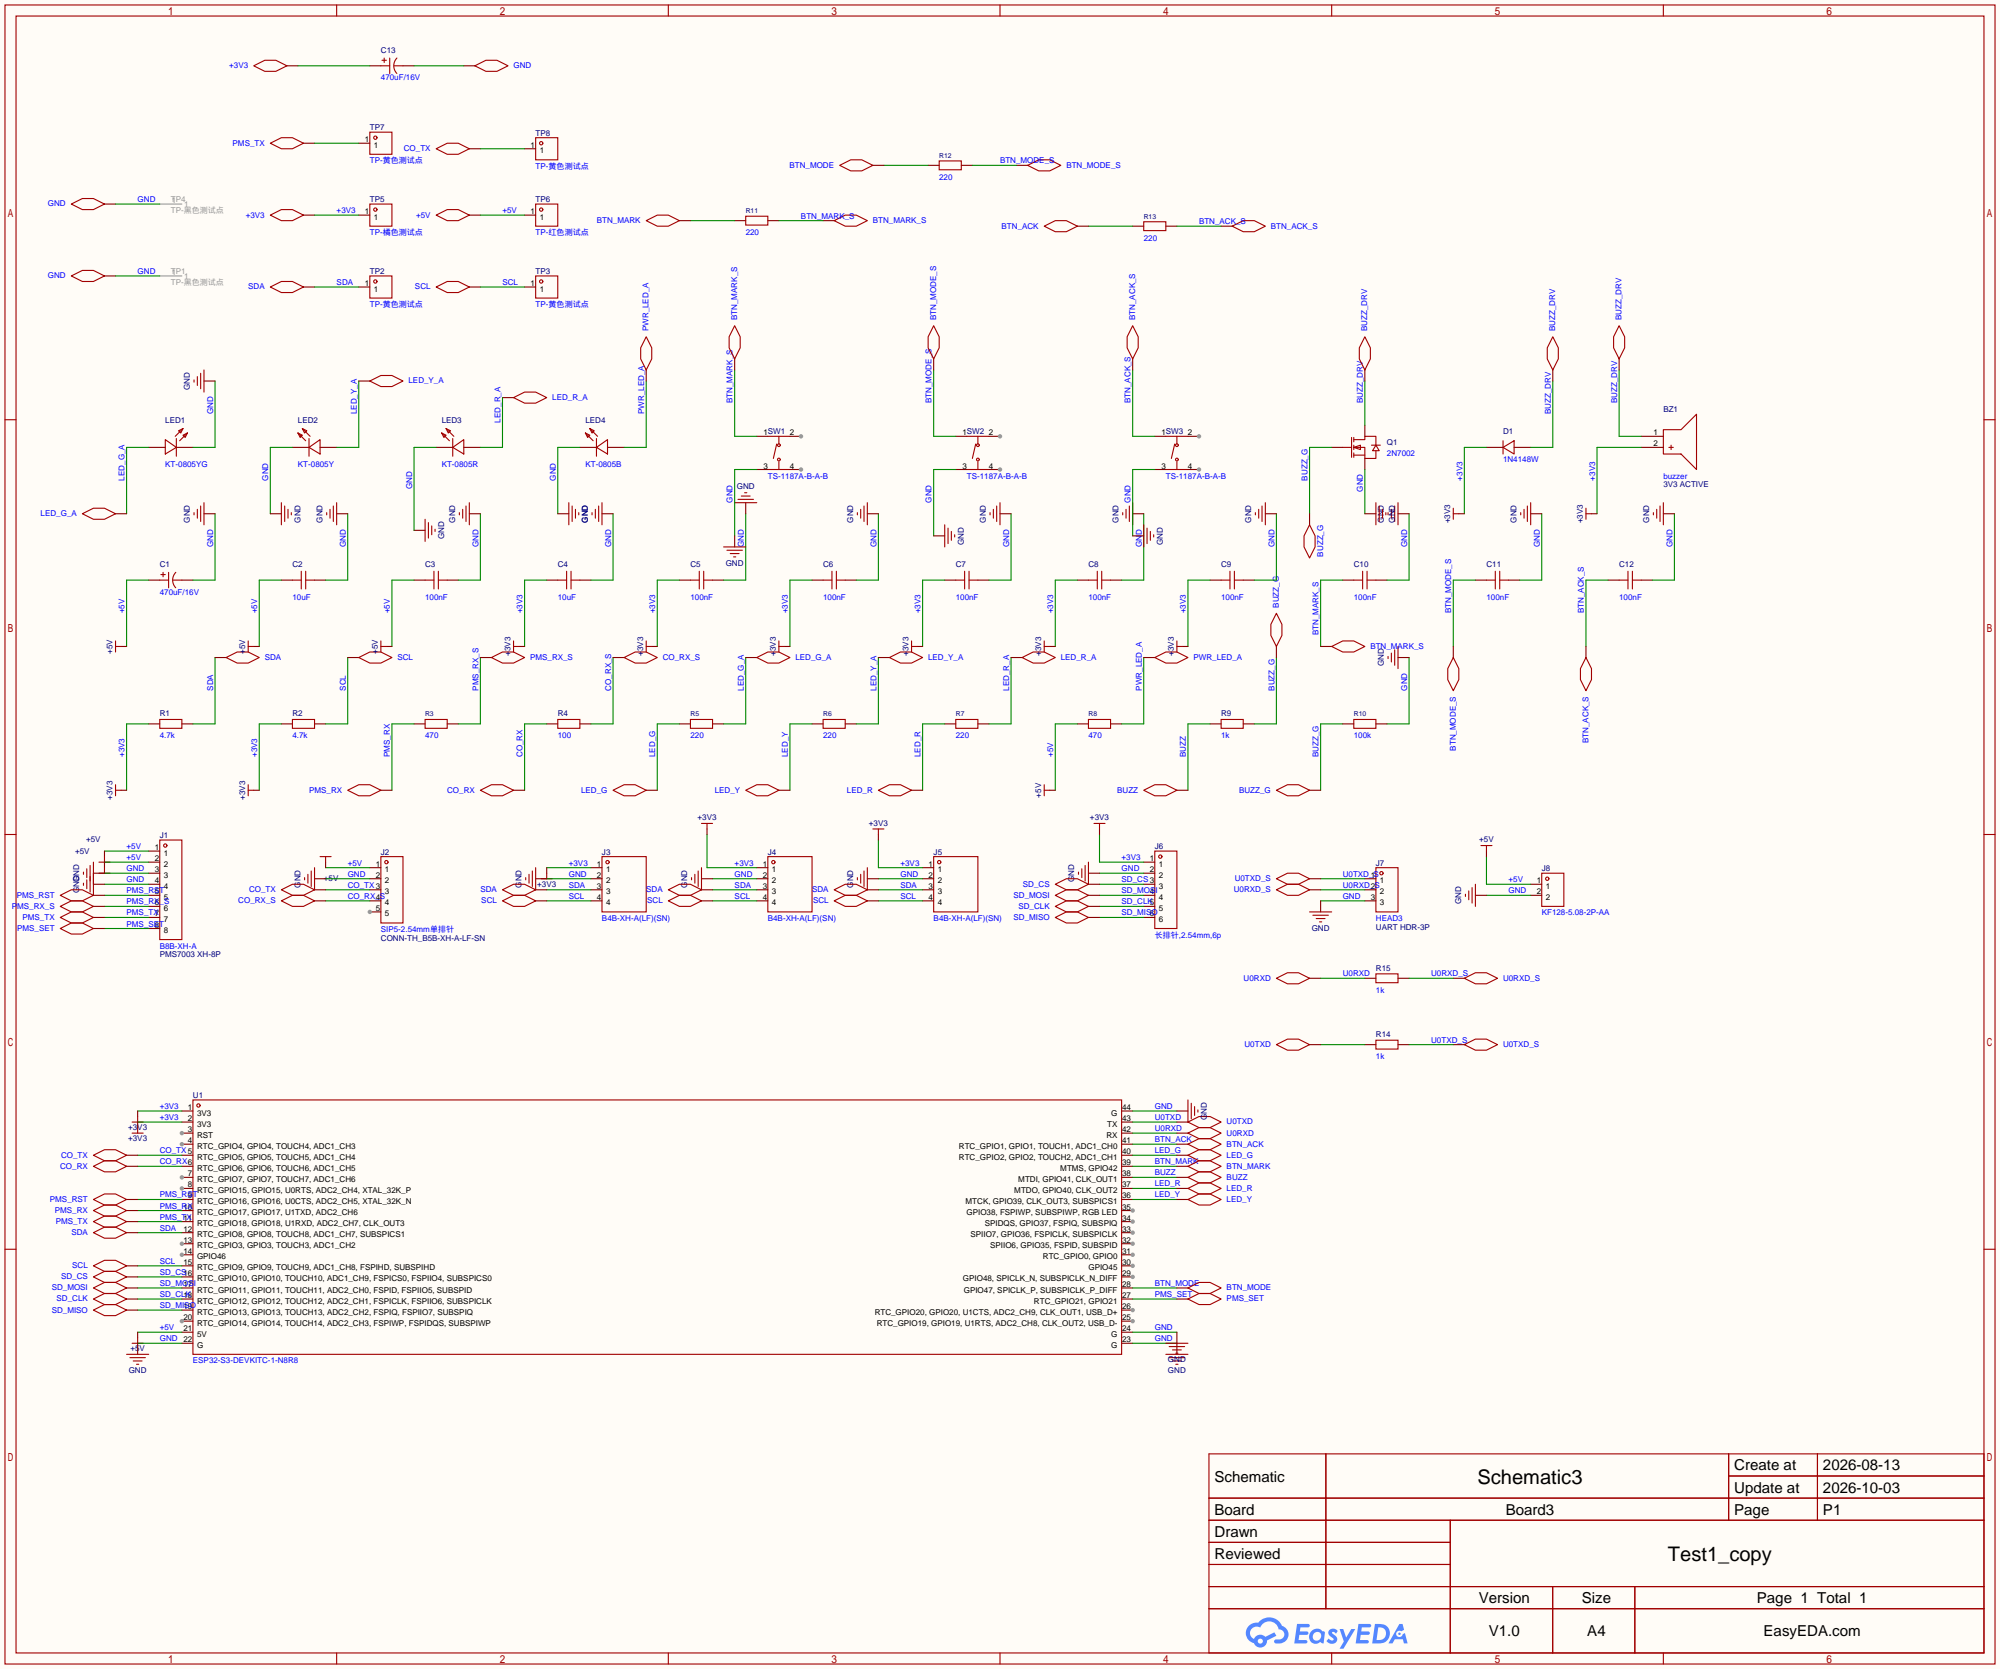
[picture p8: page 1]

SIP5-2.54mm单排针
CONN-TH_B5B-XH-A-LF-SN

MTCK, GPIO39, CLK_OUT3, SUBSPICS1 36
GPIO38, FSPIWP, SUBSPIWP, RGB LED 35
SPIDQS, GPIO37, FSPIQ, SUBSPIQ 34
SPIIO7, GPIO36, FSPICLK, SUBSPICLK 33
SPIIO6, GPIO35, FSPID, SUBSPID 32

Schematic | Schematic3 | Create at | 2026-08-13

Update at | 2026-10-03

Board | Board3 | Page | P1
Drawn | | Test1_copy
Reviewed

Version | Size | Page 1 Total 1
V1.0 | A4 | EasyEDA.com
