Sh080205/AirGuard/(commit log)

2026-10-03 Add ESP-IDF project skeleton with LED, buzzer and button handling
    Pin map in board_pins.h with compile-time checks against forbidden GPIOs. Buttons use internal pull-ups; the ISR only forwards edges to a queue and presses are confirmed after a debounce delay. LED pattern per mode, buzzer off at boot, stack high-water mark logged every 10 s. Built with ESP-IDF v5.5.5 (esp32s3), no warnings. Not tested on board yet.
2026-10-03 Add OpenSCAD open-frame design and fit-test parts
2026-10-03 Switch T/RH sensor to ENS160+AHT21 and drop pressure from CSV schema
    AHT21 has no barometer, so pressure_hpa is removed from the CSV contract before any data is collected; docs now count 7 sensor channels. AHT21 is sampled every 2 s because its datasheet requires a cycle longer than 1 s, so T/RH repeat on alternate rows. Add .gitattributes to keep LF line endings.
2026-10-03 Add enclosure design and use AHT21 naming in frame files
2026-10-03 Add AHT21/ENS160 chip-position and pull-up checks to enclosure measurement form
2026-10-04 Add PMS7003 driver with frame parser and host tests
2026-10-04 Add CSV row formatter and AHT21 frame parser with host tests
    Pure C modules for the logger (no I2C, SD or tasks yet):
    - storage/csv_row: header, data row, file name and events row per
    CLAUDE.md section 7; empty fields for missing values, one decimal
    rounded half away from zero, never writes past the buffer.
    - aht21/aht21_parse: CRC8 (1+x^4+x^5+x^8, init 0xFF), 7-byte frame
    layout and conversion formulas from AHT21 datasheet V1.0.
    - run_tests.ps1 now runs the FW-2 and FW-3 suites in one command.
2026-10-04 Define PMS7003 frame age limit, record FW-4 status, keep secrets example tracked
2026-10-04 Add 1 Hz logger: SNTP time, microSD CSV, AHT21 and PMS7003 sampling, MARK events
2026-10-04 Record first full build with Wi-Fi; app partition at 89% capacity
2026-10-04 Add board bring-up guide with ESP-IDF build/flash steps and test table
2026-10-05 Add first bring-up log: steps 1-3 pass, stopped before step 4
    Resistance checks (rails not shorted, R1/R2/R10 values, D1 orientation),
    C1/BZ1 polarity and first 5 V power-up on J8 without the DevKit all pass.
    Open items: C1 fitted as 220 uF instead of 470 uF (P1) and the 5 V
    adapter reading 5.42 V with no load (P2).
2026-10-09 Archive superseded docs and open-frame files, sync status with current repo state
    Move 00-TEAM_PLAN, 01-HARDWARE_ACTION, team-guide.html and 3d.html to docs/archive and the open-frame SCAD, viewer and previews to hardware/frame/archive, each with an ARCHIVED banner. Update README, CLAUDE.md section 10/11, AGENTS.md, hardware reference, diagrams and frame README to match merged FW-1..4 and ML-1/ML-2, the micro-USB and microSD blockers, and the enclosure design.
2026-10-09 Add enclosure measurement sheet and drop OLED/SCD40 from enclosure
    - Add docs/09-ENCLOSURE-MEASURE.md: hand-fill sheet for the TODO/ok_* values of the modules actually used, with priority column
    - Set use_oled = false and ok_modules_used = true; check OLED flags only when use_oled
    - Fix README part names (enc_body/enc_lid instead of frame)
    - Record 9 Oct enclosure and OLED/SCD40 decisions in CLAUDE.md section 10
2026-10-09 Fix enclosure SCAD header export commands
    Replace airguard_frame.scad / part=frame with the enc_body, enc_lid and fit_* parts that exist in airguard_enclosure.scad.
2026-10-09 Add ML-3 Mahalanobis baseline with float32 C header export
    - ml/baseline.py: configurable feature sets (full, pm_th), log1p/identity
    transforms, train-normal-only fit via split.py normalizer, Ledoit-Wolf
    shrinkage with condition-number gate, validation-only threshold and
    persistence selection, evaluation through ml/metrics.py, C header with
    golden vectors for FW-7
    - ml/split.py: fit_normalizer accepts a section-7-ordered column subset
    - tests for feature sets, leakage, conditioning, missing policy,
    persistence, header round-trip and gcc compile against golden vectors
2026-10-09 Fix ML-3 review findings: sparse export, all-missing persistence, event boundaries, k fallback
    - Golden template only requires the selected features, so pm_th exports
    while ENS160/CO columns are empty
    - persist() no longer indexes an empty run-start array when no score is
    finite; an all-missing split is evaluated as missing
    - Reject events that straddle t1/t2 or touch a gap before fitting instead
    of dropping them silently
    - Without validation anomaly events, select the smallest persistence k
    - Regression tests for each case; BASELINE.md wording on the float32
    estimate, pinv cutoff, k fallback and event/gap rule
2026-10-11 Add enclosure measurements and fit SCAD to measured hardware
    Measured 50 real values for the printed enclosure (record in
    docs/bringup/2026-10-11.md) and corrected airguard_enclosure.scad,
    which until now used guessed dimensions for several modules.
    Design changes driven by the measurements:
    - standoff 5.00 -> 6.14 (THT leads under the carrier are longer)
    - socket_h 8.50 -> 11.08 and redefined as "carrier top -> DevKit
    underside"; the pin header plastic under the DevKit adds 2.73
    - USB opening moves up 3.46 mm, otherwise the cable will not fit
    - PMS7003 air ports are two different sizes at two different heights;
    split into a pms_ports table instead of one shared opening, and let
    the c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
2026-10-14 Add serial CSV mirror so the logger can record to a PC without an SD card
    The microSD socket on our module is blocked (docs/bringup/2026-10-14.md P5)
    and the firmware had no way to get data off the board without a card.
    Firmware (storage task only, the 1 Hz sampler is untouched):
    - Every row leaving the storage queue is printed once as "AGCSV,<row>" and
    every MARK event as "AGEV,<row>", using the same csv_format_row /
    csv_event_row as the SD path, so the text matches CLAUDE.md section 7.
    - SD never mounted since boot: rows are drained to serial at once.
    SD mounted earlier but gone: the queue keeps buffering for the card and
    only the overflow (>= 60 of 64) is drained, so FW-4 SD beha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
2026-10-14 Add bring-up log for 13-14 Oct: board, sensors and Wi-Fi pass; SD blocked
    Steps 4-8 of docs/08-BRINGUP.md on the carrier: flash/PSRAM, buttons and
    MARK, AHT21 (status 0x18, CRC confirmed on 15 real frames), PMS7003
    (about 1 frame/s, not 2.3 s as documented), SNTP, 1 Hz jitter, rail
    voltages (TP6 4.59 V under PMS load). Records why step 4 was done by eye
    before the beep test, the unusable DevKit UART port (no settime), the
    blocked microSD socket and the serial CSV mirror test results.
2026-10-14 Update status to 14 Oct and correct the PMS7003 frame-rate note
    CLAUDE.md section 10 (draft approved by the project owner): board bring-up
    results of 13-14 Oct, serial CSV mirror merged and pushed (not yet
    GPT-reviewed), new blockers (microSD socket, no card reader, unusable
    DevKit UART port so no settime), AHT21 init/CRC questions closed, the
    pending decision to start training data only in the enclosure with ENS160
    running, and the enclosure commit already in PR #2.
    Section 7 note of 4 Oct said PMS7003 sends a frame every ~2.3 s; on the
    board it sends about one per second, so only ~5% of rows reuse a frame.
    The CSV format and PMS_MAX_AGE_MS are unchanged. docs/08 step 8 expectation
    updated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
2026-10-14 Add ENS160 driver and fill tvoc/eco2 columns
    Read the ENS160 (datasheet v1.3) on the shared I2C bus from the 1 Hz
    sampler: one 6-byte burst plus a DATA_MISR check per cycle, and the
    AHT21 T/RH written as compensation every 2 s. Nothing waits; start-up
    checks PART_ID and verifies each OPMODE write by reading it back,
    retrying every 10 s on failure.
    tvoc_ppb/eco2_ppm stay empty during warm-up, initial start-up, invalid
    output, STATER, out-of-range values, when the last NEWDAT reading is
    older than 2.5 s, or when the sensor does not answer; the rest of the
    row is still written. Status changes, NEWDAT gaps, I2C time per cycle
    and sampler work time are logged for the board test.
    Parsing, conver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
2026-10-14 Add heater comparison tool for ENS160 vs AHT21 test
    tools/heater_compare.py averages temp_c/humidity_pct per phase from the
    serial logger CSV, after dropping a settle window, and reports
    TEST minus the mean of its baselines. An off/on/off sequence cancels
    linear room drift. Optional reference thermometer readings give
    AHT21-minus-reference offsets. Output is ASCII-only so a cp874 Windows
    console can print it. Stdlib only, with unittest coverage.
2026-10-16 Add bring-up log for 16-17 Oct: ENS160 on board and heater effect
    Board test of FW-5a at commit 4b2738c: 4 MB partition, ENS160 PART_ID,
    STANDARD mode, MISR and compensation all pass; initial start-up took
    63 min. OFF/ON/OFF runs in one room show the ENS160 heater raises the
    AHT21 reading by about +3.2 C and lowers RH by about 11-12 %RH (out of
    the enclosure). Also records the unneeded ENS160 restart at boot (P7).
2026-10-16 Wait for STATAS instead of restarting ENS160 while OPMODE is STANDARD
    On the board (bring-up 16 Oct, P7) DEVICE_STATUS still had STATAS = 0
    one second after STANDARD was written and read back, so the sampler
    restarted the sensor 10 s later for nothing. The datasheet gives no time
    for STATAS to rise, so instead of a delay the sampler now reads OPMODE
    when STATAS = 0: still 0x02 means the mode is starting and it waits;
    any other value or a failed read restarts as before. STATER still
    restarts. The decision is pure C with host tests; a notrun_wait counter
    is added to the 60 s summary.
2026-10-16 Resync DATA_MISR after the P7 OPMODE read
    On the board the one boot that took the P7 wait path (17 Oct 02:38)
    counted one DATA_MISR mismatch; runs without that path had none. The
    datasheet says only reads of 0x20..0x37 update DATA_MISR, so the cause
    is unproven, but ens160_read_opmode() now drops the mirror and the next
    data read re-reads DATA_MISR before checking the burst. The check stays
    complete; the cost is one extra 1-byte read on that start-up path.
    Reproduced the same start (OFF build, then ON build) after the change:
    STATAS=0 with OPMODE 0x02 at 1 s, wait, start-up at 2 s, and
    misr=0 restarts=0 notrun_wait=1 in the first 60 s summary.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
2026-10-16 Update CLAUDE.md status to 17 Oct with FW-5a results
    Section 10 now records the FW-5a branch (4 MB partition, ENS160 driver,
    on-board results of 16-17 Oct, P7 fix and the MISR resync), the measured
    heater effect (+3.2 C, about -11 %RH outside the box) and the owner's
    17 Oct decision: training data only with the ENS160 running, pilot data
    recorded with it off is excluded. The 24-48 h ENS160 burn-in is listed
    as pending. FW-5b/FW-7 wait for FW-5a to merge.
2026-10-17 Cap the P7 wait and keep OFF builds out of build/
    ens160_status_action() now counts consecutive WAITs: the 60th in a row
    (about 60 s at 1 Hz, a firmware policy since the datasheet gives no time
    for STATAS to rise) restarts the sensor instead, so a sensor stuck with
    STATAS = 0 and OPMODE 0x02 cannot leave tvoc/eco2 empty for days. Any
    other result resets the count. The sampler logs the forced restart once
    and reports wait_cap in the 60 s summary. Host tests cover 59 waits,
    the 60th, and the reset paths.
    -DENS160_ENABLE=0 is now refused in firmware/build and must use
    build/heater_off, so a plain `idf.py build flash` is always the normal
    ENS160-on build. Unsetting the cache variable was not en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
2026-10-17 Update CLAUDE.md status for FW-5a review fixes
    Section 10 now names 612338c as the branch head, records that the
    independent review passed after two rounds, the new 0xe4f00 B build,
    the build/heater_off rule for ENS160-off builds, the 60-cycle P7 wait
    cap with the 17 Oct board check, and that a teammate will run the
    24-48 h ENS160 burn-in. Approved by the project owner.
2026-10-17 Add ZE07-CO frame parser with host tests (FW-5b step 2)
    Pure C parser for the 9-byte initiative-upload frame of the Winsen
    ZE07-CO manual V1.7 (Table 4): start byte 0xFF, checksum
    Not(Byte1..Byte7)+1 (p.6), and gas/unit/decimal/full range must match
    Table 4. Concentration is kept as an integer in 0.1 ppm. Values at or
    above full scale are accepted, not clipped. After a bad frame only the
    start byte is dropped, so a real frame starting inside it is still found.
    Host test test_ze07_parse: checksums of all five example frames printed
    in the manual, independent checksum reference, bit flips, wrong fields
    with a valid checksum, partial frames, false start bytes, resync, every
    chunk size, 200 fra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
2026-10-17 Add CO path task with thresholds, FAULT and ACK mute (FW-5b step 3)
    The CO path records and tracks the CO level reported by the ZE07-CO for
    research. It is not a CO alarm and must not replace one. It is separate
    from the ML path, the clock, SD and Wi-Fi.
    - co_safety (pure C): instant >= 90 ppm or 1-h mean >= 30 ppm -> ALARM,
    8-h mean >= 9 ppm -> flag only (WHO values from docs/03 section 2, owner
    approved). Leaves ALARM after 60 s below threshold - 10 %. Integer
    0.1 ppm math, one-minute buckets. Warm-up 5 min (manual p.6). FAULT
    after 6 s without a valid frame or when UART2 setup fails; 3 good
    frames in a row clear it.
    - co_alert (pure C): ALARM = LED_R 5 Hz + buzzer, FAULT = LED_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
2026-10-18 Add print-friendly enclosure v2 with fit-test parts and 3D viewer
    Redesign from 11 Oct measurements: no cable ties, separate T/RH chamber with double wall from PMS7003, peg buttons, LED light shroud, generous USB/J8 openings, microSD sled or integrated option. Body/lid stay locked by ok_* flags until remaining measurements and print-fit results are in.
    Claude-Session: https://claude.ai/code/session_01C9FebYPhrz8LzDkgX6gK47
2026-10-21 Update CLAUDE.md status: FW-5a merged, FW-7 steps 1-2, ENS160 burn-in done
    - FW-5a header and related lines: merged into main as 48d1a2e (was
    "not pushed/merged").
    - Next-work line: FW-7 steps 1-2 done; FW-7 step 3 waits for FW-5b merge.
    - Add FW-7 status (branch fw/fw7-mahalanobis, commit b95f687, not merged).
    - ENS160 24 h burn-in confirmed on the board 21 Oct (warm-up, not initial
    start-up; normal at 190 s); flashing is allowed again.
2026-10-21 Add ZE07-CO frame simulator for board tests (FW-5b step 4)
    tools/ze07_sim.py sends simulated initiative-upload frames (manual V1.7
    Table 4, 9600 8N1) from a 3.3 V USB-UART adapter into TP8 (GPIO5), so the
    CO path (ALARM, ACK mute, hysteresis, FAULT, latency) can be tested on
    the board without producing any CO (docs/03 section 4). Script segments:
    VALUE:SECONDS, off:SECONDS, bad:SECONDS. PC-side tool only.
    test_ze07_sim.py: Table 4 frame, checksums of the manual's Table 5-8
    examples, edge values, bad frames, exact ppm parsing, script parsing and
    send timing with a fake clock. The real serial port is not tested yet.
    README: how to use the simulator in the CO path section.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
2026-10-21 Hold the CO UART RX pin low with the internal pull-down
    GPIO5 (CO_TX net) has no pull resistor on the board and uart_set_pin()
    in ESP-IDF v5.5.5 adds none, so with J2 unplugged or J2.3 broken the RX
    input floats and picks up noise. Enable the internal pull-down after
    uart_set_pin(). A pull-down never raises the ZE07 TXD pin (rated 0-3.0 V,
    manual V1.7 p.4) above what the module drives itself, unlike a pull-up
    to 3.3 V. A line held low is a break, not valid frames, so FAULT still
    comes from "no valid frame for 6 s". Owner decision 21 Oct 2026.
    Host tests pass, build passes without warnings. Not tested on the board.
2026-10-21 Add device state machine with host tests (FW-6 step 2)
    Pure C FSM in components/fsm: CO > ML ALARM > SYS FAULT > ML WATCH >
    NORMAL. The CO path stays with FW-5b co_alert; the FSM stands aside
    while CO is active and keeps tracking ML/fault state underneath.
    - ML: PERSISTENT -> WATCH, streak >= 30 -> ALARM, leave one level per
    30 s of BELOW (ABOVE/MISSING restart it), no valid sample for 60 s
    -> NORMAL.
    - SYS FAULT (LED_Y double blink, silent): AHT21/ENS160/PMS7003 last
    success too old after a boot grace, ML self-test failure, ML result
    older than 3 s; leaves after 10 s clean.
    - ML ALARM: LED_R 5 Hz + 3 beeps every 10 s; ACK mutes until it ends.
    - MODE long press: 60 s demo of the fou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
2026-10-23 Add OLED mount under the lid of enclosure v2
    Mount a 0.96" SSD1306 module under the lid above the PMS7003 bay, the only
    spot with ~20 mm of headroom, outside the T/RH chamber. The lid gets a 45°
    flared window, a hanging frame with corner pads and snap tabs (prints
    upside down without support). PMS press ribs move clear of the frame.
    All OLED dimensions are estimates from common modules; ok_oled_dims stays
    false and fit_oled.stl is added to check them against the real module.
    Rendered with OpenSCAD 2021.01: lid/body/fit_oled are single closed solids
    and 3D intersection checks show contact faces only.
2026-10-23 Update enclosure v2 viewer, previews and status for the OLED
    Rebuild both lid meshes in the viewer (sled and integrated SD) and add the
    OLED module, its window pin, assembly step and the O0-O7 form group.
    Re-render preview_open/preview_exploded with OpenSCAD 2021.01.
    CLAUDE.md section 10 now points to enclosure v2, notes the 23 Oct OLED
    decision replacing the 9 Oct one, and lists the remaining TODO flags.
    docs/10-ENCLOSURE-V2-MEASURE.md is a paper sheet for only the
    measurements still missing, with SCAD variable and line references.
2026-10-23 Update CLAUDE.md status: FW-5b merged, train data out of the box
    Owner decided on 23 Oct to collect training data outside the enclosure with ENS160 on, since the box cannot be printed in time. Record the FW-5b merge and board results, FW-6/FW-7 step 3 now unblocked but no flashing during collection, the ENS160 TVOC rise since 21 Oct, and the 23 Oct merge/push exception without GPT review.
2026-10-23 Add SCAD source panel with copy button to enclosure v2 viewer
    The print tab now loads airguard_box.scad published next to the page and
    shows it with a copy button, steps to export STL in OpenSCAD, and which
    part values give test pieces versus the flag-locked real parts. Artifact
    viewers block file downloads, so copying the source is the way to get
    the SCAD out of the shared page.
2026-10-23 Use safe print tolerances and stop gating body/lid on the SD module
    The owner chose on 23 Oct to skip the fit-test prints for lack of time.
    Set m3_tap_d 2.5 (was 2.7, ream to 2.8 if tight), lid_clear 0.5 (was
    0.4) and peg_clear 0.35 (was 0.25), and set ok_print_fit by that
    decision. These values are untested on the print shop's machine.
    In sled mode the body and lid do not use the microSD module dimensions,
    so ok_sd_dims now gates only the sled (and the integrated variant). The
    console prints the largest module the box still accepts (length with
    socket <= 21, width <= 22.8, card slot height <= 7.5) since the sled
    must fit in front of the ZE07 pocket.
    Collision checks with OpenSCAD 2021.01: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
2026-10-23 Put measured OLED dimensions into enclosure v2
    The owner measured the real 0.96" module on 23 Oct (calipers, one
    reading each, logged in docs/bringup/2026-10-23.md): PCB 27.79 x 27.95
    x 1.11, glass 25.85 x 19.28 standing 2.07 off the PCB, pixel area
    21.53 x 11.25 starting 2.3 below the glass top edge, straight header
    pins reaching 8.26 behind the PCB, pin order GND VCC SCL SDA.
    The holder frame now fits the larger PCB (the estimate would have left
    0.05 mm), the snap lips follow the thinner PCB, and the lid window is
    23.53 x 13.25 shifted 1.7 mm toward the pins to follow the pixels.
    Owner set ok_oled_dims; 9 TODO flags remain.
    OpenSCAD 2021.01: no warnings, all parts closed single solids, 3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
2026-10-23 Make room for the PMS7003 cable adapter board
    The PMS plug and its green adapter board sit at the top corner of the
    small-port end. Measured 23 Oct: the board sticks out 5.64 mm past the
    port face and 10.84 mm past the end. The port face must stay against
    the left wall, so the owner chose on 24 Oct to move the left wall out
    by 6.2 mm and fill the PMS-length section as a solid block with the two
    ports running through it as 6.2 mm tunnels, and to leave a 12.0 mm gap
    in front of the PMS for the board.
    The box grows from 169.4 x 84.9 to 175.3 x 96.9 x 36.8 mm. The board
    clears the left wall by 0.56 and the front wall by 1.46. Its height
    above the PMS (P4) is still estimated; the console prints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
2026-10-23 Allow 19 mm for the PMS adapter board, solder and wires
    The 5.64 mm measured on 23 Oct covered the adapter board only. The
    owner set the full reach past the port face, including solder joints
    and bent wires, to 19 mm on 24 Oct, and confirmed nothing extra sticks
    out past the PMS end, so the 12.0 mm front gap stays.
    pms_side_gap goes from 6.2 to 19.6 mm, so the port tunnels through the
    solid block are now 19.6 mm long and the box grows from 175.3 x 96.9
    to 188.7 x 96.9 x 36.8 mm (print bed >= 189 x 97). Whether the longer
    tunnels reduce the PMS airflow still needs a real measurement.
    OpenSCAD 2021.01: all parts closed single solids, no warnings, the 12
    intersection checks show contact faces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
2026-10-23 Add R0 data quality check for raw §7 files (ml/qa.py)
    Read-only report on gaps (reboot vs lost in transit), blanks outside
    sensor warm-up, stuck values, definitional bounds, MARK runs vs events,
    daily pm_th stats and correlation. Expands globs itself because
    PowerShell does not. Thresholds live in QAConfig and are expected
    values until checked against the real training data.
2026-10-23 Add R2 end-to-end dry run, real-data runbook, and SNTP-safe reboot check
    ml/dryrun.py builds serial-logger-shaped files from synth (daily files,
    EV rows, two reboots, three rows lost in transit), fills the drafted
    events from truth, and compiles an exported header against the ML-3
    golden harness. ml/RUNBOOK-REAL.md lists the PowerShell commands for
    the real run, including passing files to ml.baseline via Get-ChildItem
    because it does not expand globs.
    The rehearsal showed ml/qa.py missed a reboot when SNTP takes longer
    than the 30 s PM warm-up: PM already has values on the first row. A gap
    is now a reboot when any of pm2_5, tvoc_ppb or co_ppm had a value before
    it and stays blank for >= 10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
2026-10-24 Record the PMS adapter board height and set ok_pms_conn
    Measured 24 Oct with the wires bent as they will be installed: the
    adapter board underside sits 6.06 mm above the PMS top face and the
    highest point, including the wire bend, reaches 13.5 mm. The limit
    under the OLED frame is 13.92, leaving 1.42 mm of real clearance, so
    the wires must be pressed down at least as low as when measured.
    The owner confirmed the end protrusion of 10.84 mm has nothing extra
    past it, so the 12.0 mm front gap stays, and set ok_pms_conn on 24 Oct.
    No geometry changes; 8 TODO flags remain.
    OpenSCAD 2021.01: no console warnings; box vs board and lid (with the
    OLED frame) vs board intersections are empty. Viewer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
2026-10-24 Raise the ZE07 corner pads to 8.2 mm and set ok_ze07_mount
    The ZE07 legs were never cut: pins, solder joints and wires reach
    7.69 mm below the PCB (measured 24 Oct). The owner chose to raise the
    corner pads instead of cutting, so ze07_under goes from 3.0 to 8.2
    (7.69 + 0.5). The gap above the sensor cylinder under the lid drops
    from 10.6 to 5.4 mm. The owner confirmed all four PCB corners are clear
    within 3 mm of the pads and set ok_ze07_mount; 7 TODO flags remain.
    OpenSCAD 2021.01: no console warnings, both body variants are closed
    single solids, lid vs ZE07 and body vs ZE07 intersections are empty,
    lid vs body is contact faces only. Viewer, previews, README, CLAUDE.md,
    measurement sheet a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
2026-10-24 Use the measured ENS160 pin row height and set ok_bme_pins
    D7, the pin row centre above the module's bottom PCB edge, measured
    1.18 mm on 24 Oct (the design had assumed 1.5; accepted range 1.0 to
    2.7). The pin pass-through between the floor sill and the lid curtain
    now spans 4.58 to 9.08 mm around the pin centre at 6.58 mm. D5 came back
    as a single unlabelled value, and the owner decided it is not needed
    because the T/RH chamber vents span the full module width. The owner
    set ok_bme_pins; 6 TODO flags remain.
    OpenSCAD 2021.01: no console warnings, all parts closed single solids,
    lid vs body is contact faces only. Viewer, preview, README, CLAUDE.md,
    measurement sheet and the 23 Oct log follo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
2026-10-24 Record JST cable heights, set ok_cable_h and trim the viewer form
    Measured 24 Oct with every cable plugged and routed as assembled: the
    highest cable point is 18 mm above the carrier (lid underside at 24.2)
    and the bundle crosses the divider notch at 9.0 mm (opening 2 to 11.8
    under the lid curtain). No geometry change; cable_h and a console check
    now guard both limits. The owner set ok_cable_h, so all physical
    measurements are in and 5 TODO flags remain (print shop x2, PMS port
    confirmation from the manual, antenna keepout, AHT21 separation).
    The viewer's missing-values form drops the items measured since
    (A12, B5, C3, D5, D7) and the K6 hint shows the current distances.
    OpenSCAD 2021.01: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
2026-10-24 Restore README and measurement sheet cut off by 3c130e8, accept K6/K7
    Commit 3c130e8 truncated hardware/enclosure_v2/README.md (125 -> 77
    lines) and docs/10-ENCLOSURE-V2-MEASURE.md (123 -> 86 lines): a
    line-anchored regex in the edit script also ran with DOTALL, so the
    match for one table row consumed the rest of each file. Both files are
    restored from ed5610d and the three intended row edits per file are
    re-applied by single-line replacement. Compared with ed5610d each file
    differs only in those rows; the other files in 3c130e8 were checked
    and are intact.
    The owner accepted the as-designed distances on 24 Oct: nearest lid
    screw to the antenna 44.6 mm (K6; this is an owner decision, the
    ES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
2026-10-24 Set the last enclosure flags and export body, lid and pegs STL
    The owner set ok_printer and ok_service on 24 Oct: the parts go to the
    print shop without asking for specs first, and the order message states
    a bed of at least 189 x 97 x 35, a 0.4 nozzle, 0.2 layers and PLA/PETG
    without metal or carbon fill.
    The PMS7003 manual V2.5 (kamami.pl copy, all 15 pages read) does not
    label which port is the inlet; its page 12 drawing gives the port sizes
    (11.00 x 4.40 and 9.80 x 2.00), which match the 11 Oct measurements.
    Both ports are cut the same way, so the owner set ok_pms_ports and will
    check the airflow direction with a tissue strip after assembly.
    With no TODO flags left, body.stl (188.7 x 96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
2026-10-24 Add 24 Oct status block to CLAUDE.md section 10
    Adds a block after the FW-5a part of section 10 with the state on 24 Oct
    (read from git on main/origin and the owner's machine): enclosure v2 STL
    exported on the unmerged 3d-oled-check branch with the OLED back in use,
    ML R0-R2 on origin branches, training data collection not yet seen on
    this machine, what is left of FW-5b, FW-6/FW-7 step 3, the open risks and
    the report items. Nothing is marked as confirmed; open points say how to
    check them. No existing line is changed, so the enclosure branch that
    edits the section 10 header and the box bullet should still merge.
2026-10-24 Update 24 Oct status with the owner's answers
    - Deadline moves from about 30 Oct to about 2 Nov 2026 (owner, 24 Oct).
    - The print shop has accepted the enclosure job; parts not received yet.
    - Training data collection is treated as not started: no AG_/EV_/serial
    log newer than 18 Oct anywhere on the owner's machine and no
    data/raw/usb_train/. idf.py monitor does not save files, so the note
    gives the serial_logger command. The approved protocol fixes t1 at
    27 Oct 12:00 for a 29 Oct FW-7 flash; with the later deadline the owner
    has to decide whether t1/t2 and the flash date move.
    - Submission format: the owner understands no written report was asked
    for; the format for both courses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
2026-10-24 Record the submission format: live demo in the box plus slides
    The owner said on 24 Oct there is no written report: the device is shown
    working in its enclosure and slides carry the R6 ML results and the
    measured values. The line keeps the open check (same format for both
    courses), the section 8 label on the device, and the 23 Oct rule that a
    model trained outside the box must not run in the box without
    retraining, so how ML is shown in the demo still has to be decided.
2026-10-25 Run the Mahalanobis scorer in the sampler (FW-7 step 3)
    Wires components/mahal into the firmware as approved on 18 Oct: the
    sampler scores every row after co_step(), publishes the result through a
    length-1 mailbox (ml_mailbox, xQueueOverwrite/xQueuePeek) for FW-6 to
    read, runs the golden-vector self-test once at boot before the 1 Hz
    loop, and prints a 60 s summary plus an AGML, line per row. The CO path
    does not read or wait for ML. The model header is still the synthetic
    one; the real one from ML R5 replaces a single file.
    Host tests pass (incl. test_mahal) and idf.py build passes; tools tests
    pass. Not flashed or tested on the board: training data is being
    collected with cea807f.
    Co-Auth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
2026-10-25 Wire the device state machine into the io task (FW-6 step 3)
    The io task now shows the FSM state instead of the MODE demo cycle:
    CO (FW-5b co_alert) still overrides everything, then ML ALARM, SYS FAULT,
    ML WATCH, NORMAL. Holding MODE for 3 s starts a 60 s demo of the
    patterns; ACK and MARK behave as before. io_compose.h holds the pure
    output composition and has its own host test.
    The ML input is a stub that reports no result until FW-7's mailbox is
    merged, and the sampler does not publish sensor health yet, so ML
    WATCH/ALARM and SYS FAULT cannot trigger on the device yet.
    Host tests pass (incl. test_fsm and test_io_compose) and idf.py build
    passes. Not flashed or tested on the board.
    Co-A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
2026-10-25 Restart training collection and reschedule event protocol (plan B)
    The 24 Oct run on the owner's machine gave only 42 minutes at another
    site, so collection restarted on the collector's laptop at
    2026-10-25T20:24:17+07:00. The 24 Oct calendar assumed a 24 Oct 12:00
    start and is struck through, not deleted.
    - §1: real start time, firmware (main 01dbcd2, firmware/ identical to
    cea807f, ESP-IDF v5.5.5, Wi-Fi on), logger host, first-minute check,
    and the PMS7003 data wire re-solder before the first row.
    - §4: t1 2026-10-29T12:00 / t2 2026-10-30T06:00 / end 2026-10-30T22:00
    (train 87.6 h, val 18 h, test 16 h): same val/test lengths as the
    approved 24 Oct plan shifted by two days, endin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
2026-10-26 Correct U1: the 26 Oct unmarked event was house cleaning with a vacuum
    The collector clarified that the ~07:00-08:38 event was house cleaning
    with a vacuum cleaner, not sweeping. Label stays `other`: it did not
    follow the §5 dusting method (no controlled distance or duration, a
    person near the device, warm exhaust from the vacuum motor that can move
    T/RH along with PM). Time window and the note that these rows still
    enter the fit are unchanged.
2026-10-30 Fix lid print orientation: flip with rotate instead of mirror
    The lid.stl exported on 24 Oct used mirror([0,0,1]) to turn the lid upside down for printing. That reflects the part instead of flipping it, so the printed lid was a mirror image: two of the four screw holes, the LEDs, buttons and OLED window did not line up with the body. Use rotate([180,0,0]) for lid and fit_oled and re-export both. Checked against the assembled lid: the new file matches 100% after a real flip; the old one matched at most 97% in either flip direction. body.stl and pegs.stl are unaffected.
    Claude-Session: https://claude.ai/code/session_01C9FebYPhrz8LzDkgX6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
2026-11-01 Add the October 2026 training CSVs so person C can train the ML model
    data/raw/ has been gitignored since the start of the project ("too big to
    commit"), so the 6 days of collected data existed only on the collection
    laptop. Person C needs it to fit the model, so track the per-second CSVs:
    AG_20261025..20261030_usb.csv 422,275 rows total, 25-30 Oct
    EV_20261028, EV_20261029 firmware-written MARK start/end rows
    27 MB of CSV, which git packs down to roughly 3 MB. The 55 MB
    serial_20261025_202416.log stays ignored: it is a boot/debug log, not
    training data, and it is twice the size of everything else combined.
    Labels in these files are the raw firmware labels (normal / marked) on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
2026-11-01 Add the rest of the October 2026 collection: serial log and QA reports
    Person C asked for everything that was collected, not just the training
    CSVs, so the two remaining ignored pieces go up as well.
    data/raw/usb_train/serial_20261025_202416.log (55 MB, 709,673 lines)
    The raw USB capture the AG_*.csv files were cut from. Its 422,269
    "AGCSV," lines are byte-for-byte the rows already in those CSVs, so it
    carries no training data the CSVs do not. The other 287,404 lines are
    ESP-IDF log output, dominated by the SD card failing to mount roughly
    every 5 s:
    83,982 vfs_fat_sdmmc: sdmmc_card_init failed (0x107)
    83,983 storage: SD mount failed: ESP_ERR_TIMEOUT
    41,342 i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
2026-11-01 Fill in the three marked events and log probable incense on 30 Oct as U5
    The event table had empty rows for everything that was actually run, which
    makes the CSV labels unreadable on their own. Reconstructed from the MARK
    timestamps in EV_*.csv plus the per-second data:
    P1 train incense 28 Oct 12:25:28 -> ~12:28, pm2_5 24 -> 354
    #2 val dusting 29 Oct 12:27:48 -> ~12:30, pm2_5 9 -> 23
    #1 val incense 29 Oct 15:07:28 -> ~15:09:50, pm2_5 16 -> 569
    Two of these did not follow §5. P1 burned for about 3 minutes instead of
    5, and val #1 had the incense sitting below the board almost touching it
    rather than 1 m away at the same height, which is why its peak is the
    highest of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
2026-11-01 Warn in data/README.md about what the label column does not tell you
    The CSVs are on GitHub now, so whoever fits the model reads them without
    having read the protocol first. Four things in this dataset are easy to
    get wrong, and all four are silent: nothing in the CSV hints at them.
    Counted off the committed files rather than estimated:
    train 315,313 rows 87.60 h 3,073 marked
    val 64,793 rows 18.00 h 5,965 marked
    test 42,163 rows 11.71 h 0 marked
    1. The label column is normal / marked only, per the §7 contract. It
    names no event, so it cannot stand in for ground truth. Only P1, val
    #1 and val #2 ever had MARK pressed, and test has not a single marked
    row,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
2026-11-01 Update §10: training collection is finished and the data is on git
    §10 still said collection "counts as not started" and pinned t1 to 27 Oct
    12:00, both of which stopped being true on 25 Oct. Anyone reading
    CLAUDE.md first — which §0 tells them to do — was being pointed at the
    wrong state of the project the day before submission.
    What §10 now records:
    - The run: 2026-10-25T20:24:17 -> 2026-10-30T17:42:48 +07:00, 422,269
    rows, outside the enclosure, ENS160 on, firmware cea807f, over the
    serial mirror rather than SD.
    - On git as of today, by the owner's instruction: PR #7 (c6660c6) and the
    warnings in 8ef3a54. The repo is public, so this data is now public
    permanently; the ow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
2026-11-02 Add the OLED status screen on the shared I2C bus
    A 128x64 screen at 0x3C shows what the LEDs show (CO ALARM/FAULT, ML
    ALARM, FAULT, WATCH, NORMAL, demo, mute), CO ppm and 1 h mean, PM2.5,
    T/RH, TVOC/eCO2, the ML status and D2, and the row time / MARK. At boot
    it shows a test pattern for 3 s, then the CLAUDE.md 8 notice for 8 s.
    - components/oled_ui: pure C font, frame buffer, layout, changed-chunk
    search and controller command bytes, with a host test that also writes
    ASCII art of the screens. Drawing uses only page-addressing commands
    shared by SSD1306 and SH1106. The controller is not confirmed, so the
    chip, rotation and address are set in one place at the top of
    tasks_oled.c.
    -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
2026-11-03 Add code map and bring README files in line with the code
    docs/11-CODE-MAP.md explains firmware and ml as they are on main
    (7e926b4) and on fw/fw67-integrate (87b8137, marked [fw67]): tasks with
    priority/core/stack, boot order, queues and mailboxes, one sampler cycle,
    the CO path, the on-board Mahalanobis score and FSM, every file in
    firmware/ and ml/, the R0-R6 pipeline, and which file to open for what.
    - firmware/README.md: the planned layout (fsm.c, tasks_sensor.c,
    tasks_logic.c, .tflite, ze07co/, test/) is replaced by the real one.
    - README.md: status table updated to 1 Nov from git and CLAUDE.md §10;
    code map added to the key documents.
    - ml/README.md: task order is ML-1..ML-3 and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
2026-11-03 Add R1 events file for the October 2026 training set
    data/events/2026-10_train.csv: ground truth for ml.baseline (R1 in
    docs/10-ML-REAL-DATA-PROMPTS.md), drafted with `ml.events draft` from
    the three MARK records and filled from data/PROTOCOL-TRAIN-2026-10.md §6.
    - MARK: P1 incense (train), val #2 dusting, val #1 incense; the note
    keeps the protocol deviations (val #1 incense next to the board, val #2
    starting 27 min after t1) for R3.
    - Unplanned, no MARK, label `other` (unknown): U1, U4, U5 (test) and one
    row for U2+U3, merged because they overlap and ml.events rejects
    overlapping events; both are unknown, so scoring is the same. Times are
    the minute estimates from §6.
    - No coo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
2026-11-03 Swap in the real-data Mahalanobis model (ML R5)
    firmware/components/mahal/model/ag_mahal_pm_th.h is now a byte-for-byte
    copy of the ML R4 export (data/processed/ml-real/pm_th/, 3 Nov 2026):
    model ml3-v1+pm_th+e6f29d2be5b3, frozen_sha256 e6f29d2b..., threshold
    D2 17.92, K 1, file sha256 3c2f12ae.... It replaces the synthetic
    ml3-v1+pm_th+b07dd6863436. ag_mahal_model.h records the new model and
    keeps the old one as history.
    The model was trained outside the box (25-29 Oct, ENS160 on, firmware
    cea807f). Per the 23 Oct decision it is not valid for the device in its
    enclosure without retraining.
    Checks: `python -m ml.dryrun check-header` PASS (bad 0); host tests
    (firmware/test_host/run_tests.ps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
2026-11-03 Add dashboard design and JSON/history builder (FW-8 steps 1-2)
    docs/12-DASHBOARD-DESIGN.md: the minimal on-device dashboard approved by
    the owner on 3 Nov 2026 (Q1-Q5 as proposed): esp_http_server + WebSocket
    at 1 Hz on the existing hotspot, web and httpd tasks at priority 2 (below
    storage), row/show mailboxes written with xQueueOverwrite so the sampler,
    CO and io tasks never wait, a 10-minute history behind a mutex, read-only
    page with the §8 text, and the board measurements needed before calling
    it done. The CO path does not change.
    components/webui (pure C, no FreeRTOS/sockets/malloc):
    - web_json_live(): the live message of design §3. Empty values are null,
    temp_c/humidity_pct/co_ppm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
2026-11-03 Add on-device dashboard server and page (FW-8 step 3, not built yet)
    Written against the ESP-IDF v5.5 HTTP Server docs on a machine without
    ESP-IDF: never compiled with idf.py and not tested on the board. Steps 4-5
    of docs/12-DASHBOARD-DESIGN.md (build, board measurements) are still open.
    - web_mailbox.c/.h: row (sampler) and show (FSM in the io task) mailboxes,
    length-1 queues with xQueueOverwrite/xQueuePeek like the CO and ML
    mailboxes, so the writers never wait. One publish added in each of
    tasks_sampler.c and tasks_io.c.
    - tasks_web.c/.h: web task (prio 2, below storage) builds the JSON from the
    four mailboxes every second, pushes the 10-minute history under a mutex
    and hands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
2026-11-03 Pin the lwIP tcpip task to core 0
    tcpip (prio 18) had no affinity, so it could preempt the co (11) and
    sampler (10) tasks on core 1, contrary to the comment in task_config.h.
    Set CONFIG_LWIP_TCPIP_TASK_AFFINITY_CPU0 in sdkconfig.defaults and update
    the comment (also ESP-IDF v5.5.5 -> v5.5.6). Review finding F-P1-03.
2026-11-03 Log CO ALARM latency after the GPIO write
    The "CO ALARM shown ... us after its frame" log used the time at the top
    of the io loop and was printed before ag_fsm_step() and write_outputs(),
    so it left out the work up to the pin write. Keep the frame time when the
    alarm is entered and log once write_outputs() has returned ESP_OK (or the
    outputs were already valid), reading esp_timer_get_time() at that point.
    Decisions and pin writes are unchanged. Review finding F-P1-04.
2026-11-03 Turn the microSD off: STORAGE_SD_ENABLE defaults to 0
    The team decided on 3 Nov 2569 not to use the microSD: on every module
    tried the card stopped half-way in the socket and sdmmc_card_init timed
    out (0x107) on every attempt. With the switch at 0 the storage task
    neither initialises the SPI bus nor tries to mount every 5 s, so the
    log no longer repeats "SD mount failed". Rows and MARK events still go
    out at once on the serial mirror, because no card was ever mounted.
    A static assert stops a build with both the SD and the mirror off.
    Build passes; host tests pass (they do not cover tasks_storage.c).
    Not yet tested on the board.
2026-11-03 Add hand-off notes for the 4 Nov board test
2026-11-04 Record the 3-4 Nov board results: SD, OLED, dashboard, demo firmware
    docs/bringup/2026-11-03.md: microSD dropped (0x107 on every module, card
    only half-way in), OLED working on J5, first board run of the FW-8
    dashboard, the demo/2026-11-04 build, the 10-minute B0 vs OLED
    comparison (no measurable effect on sensor reads; chunk max ~52 ms is
    over the T5 target) and ML staying in ALARM in a dry room (RH 34-40 %
    vs 57 % in the training data), which the owner decided to present as a
    limitation.
2026-11-04 Add a 4 Nov status block to CLAUDE.md section 10
    Summarise the demo firmware (tag demo-2026-11-05), R3-R5, the real model
    on the board, FSM, dashboard, OLED, microSD dropped for the serial
    mirror, and the limitations, pointing at docs/bringup/2026-11-03.md.
    Move the deadline to 5 Nov 2026 and mark the older blocks that conflict
    with it as outdated instead of deleting them.
2026-11-04 Remove hardware/frame/ and docs/archive/, move BUILD_SPEC.md
    Both folders held superseded material: the v1 enclosure (replaced by
    hardware/enclosure_v2/ on 17 Oct) and pre-October planning documents
    that contradict CLAUDE.md (BME280, C13 fitted, 40 mA per pin).
    BUILD_SPEC.md is kept as docs/reference/BUILD_SPEC.md because CLAUDE.md
    still cites it for the derivation of formulas; its own banner already
    says values that disagree with CLAUDE.md lose.
    References are updated: README and CLAUDE.md section 11 point at the new
    paths, AGENTS.md no longer lists the deleted folders, the .gitignore rule
    for frame drafts is gone, and historical records (CLAUDE.md section 10,
    docs/09, docs/bringup/2026-10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
2026-11-04 Add PCB/schematic exports for the slides
    Schematic (PDF/SVG), PCB render, BOM, netlist and pick-and-place
    exported 4 Nov 2026 from EasyEDA (Board3/PCB3/Schematic3).
2026-11-04 Add the 33-slide HTML deck for the 5 Nov presentation
    docs/slides/AirGuard-S3.html is one self-contained file: 16:9, arrow
    keys, N for speaker notes, T for elapsed time against the 30-minute
    plan, R to reset it. No network access; images are data URIs and fonts
    are system fonts.
    It is built from src/AirGuard-S3.src.html by build.py, which embeds
    every figure found under the repo and leaves a "[ใส่รูป: ...]" frame
    for the rest. Photos and the five presentation schematic sheets
    (sch-1..5) are not in the repo yet: drop them into docs/slides/img/
    with the names build.py prints as missing and run it again.
    Numbers were checked against main @ 1ed5ac2. Those whose source is not
    in the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
2026-11-04 Use labelled renders for the dashboard, OLED and closed-box slides
    Slides 22, 23 and 25 now show images made from the project's own code
    instead of empty frames, each with a caption saying it is a render:
    - dashboard (normal and ML ALARM): firmware/main/web/index.html fed with
    sample live/history JSON from the real web_json.c, scored by the real
    ag_mahal.c with the on-board model (D² 0.71 and 46.49)
    - OLED: the real oled_ui.c drawing the same sample values, frame buffer
    dumped at 128x64
    - closed box: OpenSCAD render of airguard_box.scad with the lid on
    The generators are in docs/slides/tools/. None of these are photos or
    measurements; photos of the real board, PCBA and box are still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
2026-11-04 Add a full spoken script to the speaker notes and a printable copy
    docs/slides/src/script.py holds what to say on each of the 33 slides,
    with a suggested speaker by topic (hardware, firmware, data/model, or
    whoever opens and closes). build.py puts it at the top of each slide's
    speaker notes (key N), above the existing reminders and Q&A, and writes
    docs/slides/AirGuard-S3-script.html for printing or reading on a phone
    during rehearsal, with each slide's start time and length from the
    30-minute plan.
    The script uses only numbers that are already on the slides and keeps
    the same wording rules (no claims the data does not support). Text in
    [ ] is a stage direction.
2026-11-04 Give the deck an air-quality theme, motion and 3D models
    Theme: hazy-sky background with drifting dust specks, soft motes and
    wind streaks (canvas, gust on every slide change); dark night-sky title
    and demo slides with an AQI colour strip; frosted cards and tables.
    Motion, all automatic so the 29:50 timing is unchanged: titles wipe in
    with an accent line, content and table rows rise or slide in, cards
    blur into focus, counters count up (with a fallback to the final value),
    a thin progress bar, data dots running along the slide 5 arrows (red
    for the CO path that skips ML). Off under prefers-reduced-motion and in
    the ?check overflow mode.
    3D in place of the photo frames, plain WebGL, no inte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
2026-11-04 Restyle the deck with boxed text, section colours and netlist diagrams
    Readability (after the team's reference deck): every block of text on a
    light slide now sits on a white card with an ink outline and a hard
    shadow in the section colour; tables get a tinted header; bullets are
    outlined dots; section pills tilt; body text 28 -> 30 px.
    Colour: the sky tint follows the section (registered colour properties
    so it fades), with drifting aurora blobs, air waves along the bottom and
    a faint slide-number watermark. Off in ?check and reduced motion.
    The five empty schematic frames are replaced by circuit diagrams drawn
    from Netlist_Schematic3_2026-11-04.tel with values from the BOM/CPL:
    power (sl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
2026-11-04 Add a dark cool version of the deck alongside the light one
    build.py now also writes docs/slides/AirGuard-S3-dark.html: the same deck
    with <body class="theme-dark">. All of its styling sits under
    body.theme-dark in the source, so the light AirGuard-S3.html is unchanged
    and both always carry the same content.
    Dark version: night sky on every slide, cool aurora per section (screen
    blend), glowing dust, dark-glass text boxes tinted with the section
    colour with a light edge and glow; circuit diagrams and charts stay on
    light panels so their ink stays readable; 3D views on a dark backdrop.
    The two highlighted rows on slide 12 get classes (hl-r, hl-b) so the
    dark theme can recolour them; the inl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
2026-11-04 Add a cartoon version of the deck
    build.py now also writes docs/slides/AirGuard-S3-cartoon.html: the same
    deck with <body class="theme-cartoon">, styled under body.theme-cartoon
    in the source, so all three files always carry the same content.
    Cartoon version: flat bright sky with a sun peeking from the corner,
    drifting outlined clouds, green hills along the bottom and floating
    "dust bunnies" (the PM2.5 the device measures); thick ink outlines and
    solid ink shadows on every text box with pastel section fills; yellow
    tilted section pills; bouncy entrances. Title and demo slides are bright
    too. Scenery is off in ?check and under reduced motion.
    All 34 slides pass ?check.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
2026-11-04 Cut the talk to 10 minutes plus a 10-minute live demo
    The main path is now 18 slides: 16 for the talk (10:00 by data-dur), the
    demo and the closing slide. It keeps every scoring category: progress,
    schematic and pull-ups, PCBA, firmware, sensors/actuators, CO path,
    backend/frontend, integration, the model and its results, and the
    limitations. Three slides are new and merge the detail slides they
    replace (firmware tasks + interrupt + 1 Hz timing; UART + I2C +
    datasheet rules + FSM; web + dashboard + OLED + PC pipeline). The demo
    slide has a 10-minute run sheet split between the three speakers.
    The other detail slides move, unchanged, to an appendix after the
    closing slide for questions; thei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
2026-11-05 Give the firmware part three more slides in the main talk
    The task architecture, interrupt/IPC and 1 Hz timing slides, and the
    SPI/memory slide, move from the appendix into the main path; the merged
    firmware slide they overlapped with is removed. The firmware block is
    now: tasks and priorities, interrupt -> queue and mailbox, the 1 Hz
    timer with measured jitter, sensors and actuators, SPI and memory, and
    the CO path. The SPI/memory slide gets a line listing the course topics
    the firmware uses (GPIO, interrupt, timer, UART, SPI, I2C, memory,
    Wi-Fi, watchdog, FSM) and why ADC/DAC/PWM are not used. The CO script
    now mentions that its task is registered with the watchdog.
    The talk is 10:30 (oth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
2026-11-05 Say only what the board showed about the model on the summary slide
    The closing slide claimed the on-chip model gives the same result as
    training, but the only evidence for that (0 differing rows on the
    42,103-row test set) comes from the P3 report, which is not in the repo
    and is still tagged [ตรวจ]. It now says what the 3 Nov bring-up
    recorded: the model runs on the board with fault = 0. The appendix
    slide that holds the parity figures is retitled from a claim to a
    check ("ตรวจผลบนชิปเทียบกับตอนเทรน").
